LGOSSET-21/squash-ball-launcher-catia/docs/GM_39.pdf

Lanceur de Balles de Squash | GM BA2 2025

# Projet De Construction Mecanique II

## Section Génie Mécanique

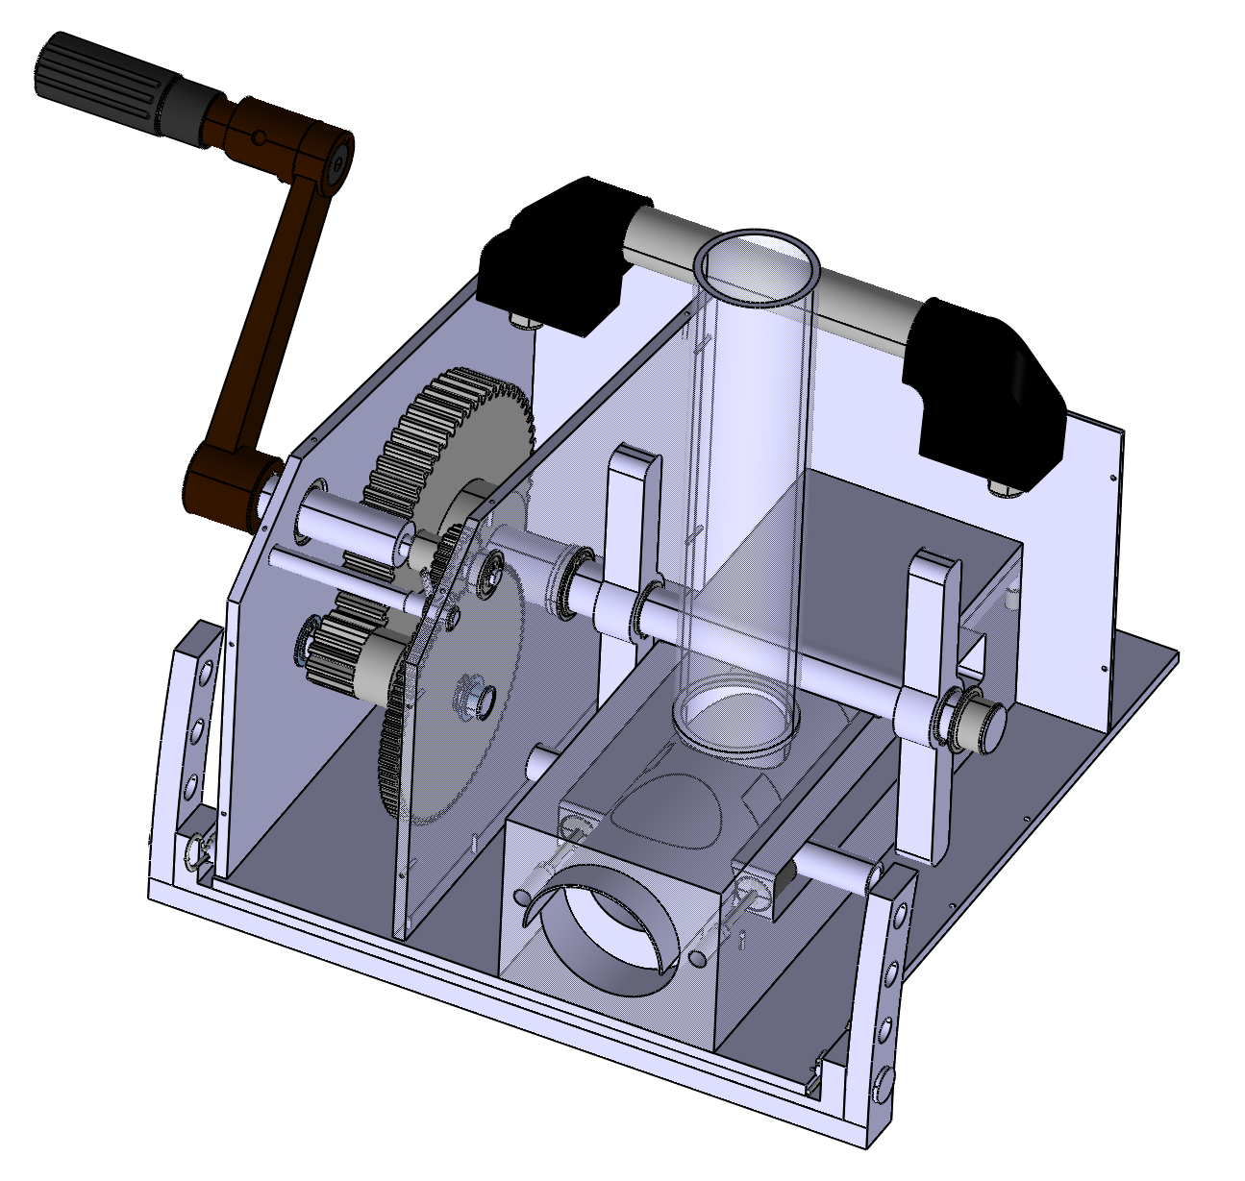
[picture p2: figure]

## Lanceur de Balles de Squash

Date de rendu : 01 Juin 2025

Groupe GM-89

Guillaume Saint-Pierre : 400422 ; | Joseph Belamich : 392444
Louis Gosset : 393503 ; | Ethan Poullain : 392134

### Table des matières

1 Introduction | 4
2 Physique du mécanisme et dimensionnement du mécanisme | 4
3 Puissances et Rendement | 28
4 Dimensionnement et résistance des éléments de liaisons | 30
5 Analyse des risques | 43
6 Usinage des pièces | 44

7 Procédures d’assemblage | 49
8 Mode d’emploi | 55
9 Conclusions | 59
10 Annexes | 61

### 1 Introduction

Lors du cours de construction mécanique du deuxième semestre de génie mécanique à l’EPFL, nous nous intéressons à la conception et à la réalisation d’un rapport d’ingénierie. Il s’agit ici de mettre en application les connaissances théoriques acquises lors de la première partie de ce cours ainsi que les compléments théoriques apportés tout au long du deuxième semestre.

Le projet consiste en la conception d’un lanceur de balles de squash. On y retrouve donc les aspects majeurs d’un rapport d’ingénierie tels que les idées de conceptions, les caractéristiques techniques et physiques, ainsi que les plans (2D et 3D).

### 2 Physique du mécanisme et dimensionnement du mécanisme

Dans cette section, nous détaillons les calculs relatifs à la puissance, au rendement énergétique, aux équations horaires du mouvement.

### 2.1 Système de lancement des balles

### 2.1.1 Calcul de l’énergie cinétique nécessaire pour lancer la balle de squash

Le but est de calculer l’énergie cinétique nécessaire pour propulser une balle de squash de 25 g (0,025 kg). En fonction des spécifications du cahier des charges, la balle doit être lancée à une vitesse comprise entre 80 et 130 km/h. Afin de prendre en compte les éventuelles pertes énergétiques dues aux frottements et au rendement des engrenages, nous choisissons un objectif de vitesse de lancement de 90 km/h, en conservant une marge de sécurité de 10 km/h.
Formule de l’énergie cinétique :

Ecin =

1
2

mv²

La masse totale est la somme de la masse de la balle (0,025 kg) et du support (0,104 kg). La vitesse de lancement de la balle est de 90 km/h, soit :

vlancement =

90 × 1000
3600

= 25 m · s

−1

Ecin =

1
2

× (mballe + msupport) × v

2
lancement =

1
2

× (0,025 + 0,104) × 25² = 40,3 J

### 2.1.2 Calcul du moment de force et du couple transmis par l’homme

Le dimensionnement du système de manivelle repose sur l’estimation réaliste de la force qu’un utilisateur peut exercer de manière répétée, sans fatigue excessive ni risque de blessure. Pour cela, nous nous appuyons sur des références normatives reconnues en ergonomie.
Ainsi, nous supposons que l’homme exerce une force de 20 N. Ce dernier tourne la manivelle de rayon r = 0,125 m. Le système de transmission doit permettre de lancer une balle toutes les 5 secondes. Cela correspond à une fréquence de rotation de 0,2 tour/s par balle pour garantir le lancement d’une balle à cette fréquence. Cependant, notre barre est usinée de manière à ce que le processus de lancement s’effectue 2 fois par tour. Ainsi, la fréquence de rotation est de 0,1 tour/s.
Le rapport de réduction Ri est défini par le rapport entre la vitesse de rotation de la manivelle et la vitesse de rotation de la came. Si la manivelle tourne à 2 tour/s et que la came doit tourner à 0,1 tour/s, le rapport de réduction est donc :

Ri =

Vcame

Vmanivelle

=

0,1 tours/sec
2 tours/sec =

1
20

Ce rapport de 1 :20 permet de garantir que la manivelle tourne suffisamment vite pour faire fonctionner la came à la vitesse souhaitée, tout en respectant les contraintes physiques du système.

Le moment de force initial Mi est donné par :

Mi = Fi × ri = 20 × 0,125 = 2,5 Nm

Ainsi, le rapport de réduction est :

Ri =

Mf
Mi

=

Vi
Vf

⇔ Mf =

Mi × Vi
Vf

=

2,5 × 2
0,1

= 50 Nm

Ainsi, le couple maximal transmis par le mécanisme de réduction est de 50 Nm.

### 2.1.3 Calcul de la constante du ressort nécessaire pour le lancement

Pour déterminer le ressort approprié pour le lancement de la balle de squash, il faut vérifier que le couple maximal (Mmax) que le ressort doit générer est compatible avec le couple maximal du système, soit :

Mmax ≤ Mf = 50 Nm

Pour déterminer le ressort approprié pour le lancement de la balle de squash, il faut vérifier que le couple maximal (Mmax) que le ressort doit générer est compatible avec le couple maximal du système, soit :

Mmax ≤ Mf = 50 Nm

L’énergie stockée dans un ressort est donnée par la formule :

Eressort =

1
2

k(∆x)

2

La longueur de compression du ressort est un paramètre clé dans la conception du mécanisme de lancement de la balle de squash. Après avoir pris en compte les exigences de performance et les contraintes de conception, nous avons estimé que la longueur de compression optimale pour notre ressort idéal serait ∆x = 11,5 cm. Cette valeur a été choisie en fonction de plusieurs critères techniques, notamment l’énergie nécessaire pour propulser la balle à la vitesse souhaitée (90 km/h), ainsi que les contraintes de compacité et de performance du mécanisme.

Critères de performance :

La compression du ressort doit donc être suffisante pour emmagasiner l’énergie nécessaire pour atteindre cette vitesse, tout en prenant en compte les pertes possibles dues aux frottements et à l’efficacité du système de transmission.
Une compression trop faible du ressort risquerait de produire une énergie insuffisante pour propulser la balle à la vitesse ciblé, tandis qu’une compression trop importante pourrait entraîner une surcharge du système, affectant la compacité du mécanisme.

Constante de raideur du ressort :

La longueur de compression est directement liée à la constante de raideur du ressort k. Une compression de 12 cm permet d’obtenir une force de réaction du ressort suffisante pour générer une énergie nécessaire au lancement de la balle tout en maintenant une constante de raideur qui n’est pas trop élevée. En effet, une constante de raideur trop élevée entraînerait une difficulté à comprimer le ressort, augmentant la force nécessaire à l’activation du système. Il est important de se rappeler que le rayon de notre barre permettant l’envoi des balles est de 0,07 m.

F = ∆x × k

M = F × rbarre = ∆x × k × rbarre | ⇔ | kmax =

Mmax

rbarre × ∆x

=

50
0,07 × 0,115

= 6211 Nm

On en déduit également la force max :

Fmax = kmax × ∆x = 714 N

### 2.1.4 Vérification de l’adéquation du ressort sélectionné

diamètre du fil | diamètre ressort externe | diamètre ressort interne | longueur libre | longueur sous charge max | ∆xmax | Force max du ressort | constante d’élasticité k
5,00 | 55,00 | 45,00 | 195,00 | 61,60 | 133,40 | 784,53 | 5980

Table 1 – Caractéristiques du ressort choisi

Constante d’élasticité k :

Le ressort sélectionné présente une constante d’élasticité de :

k = 5980 N · m⁻¹

Cette valeur est inférieure à la limite maximale admissible précédemment déterminée, soit :

k = 5980 N · m⁻¹ < kmax = 6211 Nm

Cette constante respecte donc les contraintes de couple maximal admissible.

Allongement du ressort ∆x :

La compression maximale considérée pour le ressort est :

∆x = 133,40 mm

Cette valeur est supérieure à la compression souhaitée de 115 mm :

∆xmax = 133,40 mm > ∆x = 115 mm

### 2.1.5 Force maximale exercée par le ressort :

La force maximale développée par le ressort est donnée par la loi de Hooke :

F = k × ∆x = 5980 × 0,115 = 687,7 N

Cette force reste inférieure à la force maximale admissible dans le système :

Fressort = 687,7 N < Fmax = 714 N

De plus, on vérifie que très logiquement cette force est inférieure à la force max du ressort :

Fressort = 687,7 N < Fressort max = 784,53 N

### 2.1.6 Énergie potentielle stockée dans le ressort :

L’énergie emmagasinée dans le ressort lorsqu’il est comprimé :

Eressort =

1
2

k∆x

2 =

1
2

× 5980 × 0,115² = 40,9 J

Or on rappelle que l’énergie cinétique nécessaire pour propulser une balle et son support est :

Ecin = 40,3 J

On a donc :

Ecin ≈ Eressort

Ainsi, l’énergie potentielle fournie par le ressort est suffisante pour assurer le lancement de la balle à 90 km/h.

### 2.1.7 Couple final transmis par le ressort :

Le couple nécessaire pour comprimer le ressort peut être estimé par :

Mf = F × r = 687,7 × 0,070 = 48,13 N · m⁻¹ < 50 Nm

L’ensemble des calculs et hypothèses respecte les contraintes de compacité, d’ergonomie et de cadence de tir (une balle toutes les 5 secondes), assurant ainsi un fonctionnement fiable, sécuritaire et performant du dispositif. De plus les 1,87 N.m-1 de marge ne sont pas perdus car cela permet de laisser le ressort suffisamment en compression afin qu’il tienne avec une gorge ( ce système sera expliqué par la suite). Le ressort choisi peut donc être retenu pour l’implémentation finale dans le système de lancement.

### 2.2 Système de stockage des balles et acheminement des balles

### 2.2.1 Explication du système

Les balles sont stockées dans un tube conçu pour accueillir exactement 5 balles. Ce tube donne sur le haut de la plaque du ressort. Sur cette plaque se trouve un trou qui se positionne en dessous du tube lorsque le ressort ce compresse, laissant donc passé une balle.
Nous allons donc prouver que la balle à bien le temps de tomber et que seulement une balle va tomber. Aussi, on verra que lors de la décompression du ressort, les balles contenue dans le tube ne gêne pas l’avancer du ressort.

### 2.2.2 Chute de la balle dans le conduit :

Nous allons prouver à l’aide d’une étude balistique que la balle a bien le temps de tomber. Pour montrer que cela marche bien dans tous les cas, on prendra le cas le plus désavantageux c’est à dire là où il n’y a qu’une seule balle dans le tuyau (car les autres ne la pousse pas vers le bas).
Pour cela nous allons comparer la vitesse de compression du ressort avec celle de la chute des balles dans le trou. Trouvons donc la vitesse de la compression du ressort au niveau de trou qui laisse passer les balles. La vitesse étant la dérivé de la position, trouvons d’abord la position. Plus tard nous détaillerons les calcul mais la fonction qui décrit la compression ∆x du ressort en fonction du temps est donné par :

∆x(t) = ∆xtotal
2

− h × tan

π
2

−

2π
10

t

Donc :

t(∆x) =

π
2

− arctan

∆xtotal
2

−∆x

h

π
5
Or :
v∆x(t) = d∆x(t)
dt :

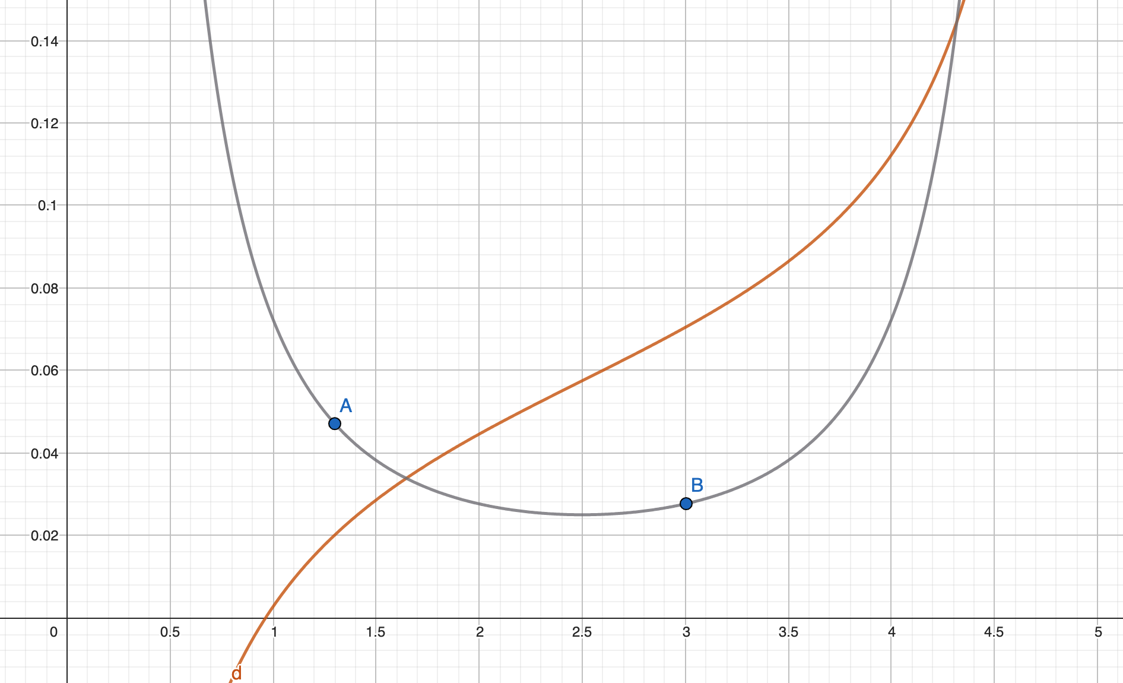
[picture p3: figure]

Figure 1 – Courbe de ∆x(t) en orange et la vitesse v∆x(t) en gris, les point A et B sont les point entre lesquels le trou passe en dessous du tube.

Comme la vitesse de compression du ressort varie peu entre 1 et 4 seconde (temps de compression) nous allons prendre la vitesse moyenne, ainsi :

vmoy ∆x =

1
t2 − t1

×

Z t2

t1

v∆x(t) dt =

1
t2 − t1

×

Z t2

t1

d∆x(t)
dt dt =

1
t2 − t1

× [∆x(t2) − ∆x(t1)]

l’instant t1 est le temps auquel le trou de la plaque rencontre le trou du tube et l’instant t2 est le temps où ils se quittent.
D’après la longueur des pièces ∆x(t1) = 3, 0cm et ∆x(t2) = 7, 0cm (intervalle de longueur de la compression du ressort sur lequel le trou passe en dessous du tube) donc grâce a la fonction inverse t(∆x) on trouve :

t1 = 1, 54s

t2 = 3, 0s

Ainsi, la vitesse moyenne est de :

vmoy ∆x =

1
t2 − t1

× [∆x(t2) − ∆x(t1)] = 1 3, 0 − 1, 54
×

h
7, 0 × 10⁻² − 3, 0 × 10⁻²

i
= 2, 7 × 10⁻²m/s

Donc à 1, 54s le trou commence à passé en dessous du tube. Comme le tube à un diamètre de 41, 5mm on considère que la balle ne bouge pas tant que le trou n’arrive pas à la moitié de son diamètre c’est à dire 20, 75mm de plus. À partir de ce moment la, la balle commence à descendre doucement sans tomber.

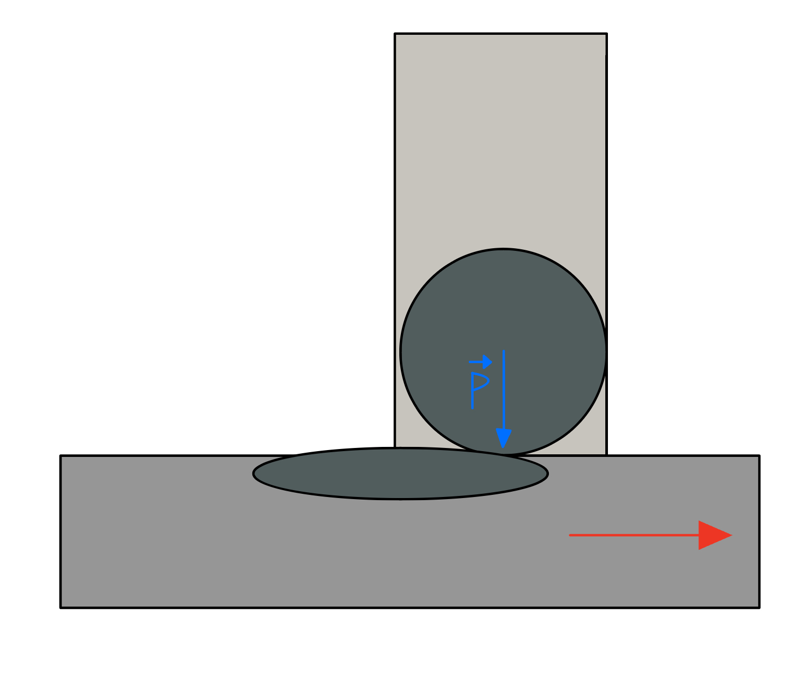
[picture p4: figure]
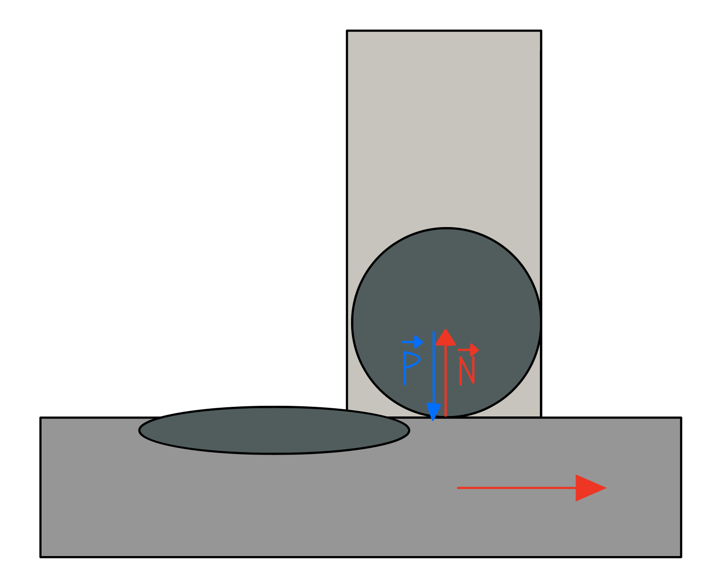
[picture p5: figure]

La balle ne bouge pas | La balle commence à descendre

Lorsque la balle commence à s’aligner avec le trou, elle descend progressivement au fur et à mesure que le trou avance sous elle. Toutefois, tant que moins de 40mm du trou ne sont positionnés sous le tube, la balle ne peut pas tomber complètement, car son diamètre est encore trop grand pour passer.
Juste avant que le seuil des 40mm ne soit atteint, la balle se retrouve dans une position basse maximale, bloquée par la paroi du trou : elle est descendue d’environ 20mm, mais reste coincée. Elle est donc à la limite de basculer, sans pouvoir chuter à cause de l’insuffisance d’ouverture. Ce n’est que lorsque au moins 40mm du trou sont alignés avec le tube qu’elle peut enfin passer librement et tomber. On va donc considéré par mesure de sécurité qu’avant de chuter, la balle est seulement descendu de 15mm. La balle doit donc chuter de 40 − 15 = 25mm.
Vérifions ainsi que la balle à bien le temps de chuter avant que le trou ne se referme. Faisons une étude balistique de la chute de la balle et de l’avancé du trou. 0n place un repère Oxy centré au bas du tube, y pointe vers le haut et x vers la droite. À l’origine des temps, la balle est descendu de 15mm et n’a pas de vitesse initiale, et 40mm du trou de la plaque est en dessous du tube. Commençons par la chute de la balle :
| XF = ma
| mg = ma
| Donc g = a

On intègre une première fois l’accélération pour obtenir l’équation vitesse en tenant compte des conditions initiales :

v(t) = v0 +

Z
| a(t) dt

Or :

| vy(t = 0) = v0y = 0m/s

On intègre une seconde fois l’équation de la vitesse pour obtenir l’équation horaire de position, en tenant compte des conditions initiales.
r(t) = r0 +

Z
| v(t) dt

Selon l’axe y :
y(t) = Z
vy(t) dt = −

1
2
- g · t

2 + y0

Or :
y(t = 0) = y0 = 0

Ainsi :
y(t) = −

1
2
- g · t

2

Or on cherche t tel que y(t) = −0, 025m (temps pour que la balle chute totalement), soit :

y(t) = −0, 025 | ⇔ | −

1
2
- g · t
2 = −0, 025 | ⇔ | t =

s
2 × 0, 025
g

=

s
2 × 0, 025
9, 81

= 71ms

La position du trou est (car vitesse constante) :

x(t) = vtrout + x0

x0 = −0, 002mm

Donc le temps pour que le trou parcours 2mm (distance sur laquelle plus de 40mm du trou de la plaque est en dessous de la plaque) est :

t =

−x0

vtrou

=

0, 002
2, 7 × 10⁻²

= 74ms

74 > 71

La balle à donc bien le temps de tomber entièrement dans le trou.

### 2.2.3 Passage de seulement une balle :

Puisque l’emplacement devant le ressort a une hauteur de 41 mm, cela permet à exactement une seule balle de s’y loger. Les autres balles, quant à elles, ne peuvent pas y entrer et seront donc déviées ou séparées par la plaque.

### 2.2.4 Retour du ressort :

Vérifions que les balles ne gêne pas la décompression du ressort. Le risque est qu’une balle tombe dans le trou lorsque le ressort ce décomprime. Montrons que le temps de chute d’une balle est beaucoup trop petit par rapport au temps de passage du ressort lorsqu’il se décomprime. Prenons encore une fois le pire des cas : lorsque le maximum de balle sont dans le tube est donc "pousse" la dernière à tomber. Dans cette configuration il y a au maximum 4 balles dans le tube car la dernière est dans le mécanisme. Étudions tout d’abord la vitesse du ressort :

XF = ma

Fressort = ma
−k(x − Lo) = ma

a = −

k
m

(x − Lo)

On pose e = x − Lo, donc d

2e
dt² = a, Ainsi :

d

2
e
dt²

= −

k
m
- e | ⇔ | e = C1cos(

s
k
m
t) + C2sin(

s
k
m

t)

Trouvons C1 et C2, on sait que de dt(0) = 0 car la vitesse initiale du ressort avant de ce décomprimer est nulle, donc :

de
dt = 0 ⇔ −C1sin(

s
k
m

× 0)s
k
m

+ C2cos(

s
k
m

× 0)s
k
m

= 0 ⇔ C2 = 0

Aussi, e(0) = −11, 5 × 10⁻²m (compression max du ressort), donc :

C1cos(

s
k
m

× 0) + C2sin(

s
k
m
× 0) = −11, 5 × 10⁻² | ⇔ | C1 = −11, 5 × 10⁻²

Ainsi :

e(t) = −11, 5 × 10⁻²
cos(

s
k
m
t) ⇔

de
dt(t) = 11, 5 × 10⁻²
sin(

s
k
m

t)

s
k
m
Nous venons d’exprimer la position et la vitesse du ressort en fonction de t. Trouvons donc la vitesse du ressort lorsque le trou de la plaque passe en dessous du tube. Pour cela calculons la vitesse en fonction de la position :

e(t) = −11, 5 × 10⁻²
cos(

s
k
m
t) | ⇔ | t =

rm
k

arcos(−

e
11, 5 × 10⁻²

)

Ainsi pour e = −5cm (le ∆xd du ressort lorsque le trou rencontre le milieu du tube) :

t =

rm
k

arcos(−

e
11, 5 × 10⁻²

) = s
129 × 10⁻³
5980

arcos(−

−5 × 10⁻²
11, 5 × 10⁻²

) = 5, 2ms

Enfin :

de
dt(t = 5, 7 × 10⁻³

) = 11, 5 × 10⁻²
sin(

s
5980
129 × 10⁻³

5, 2 × 10⁻³
)

s
5980
129 × 10⁻³

= 22m/s

En approximant la postion du ressort par :

x(t) = v × t

Le temps passé par le tube sous le tube est :

t =

x
v

=

42 × 10⁻³
23

= 1, 8ms

La balle a donc 1, 8ms pour tomber et gêner le mécanisme, or la position de la balle en fonction du temps est donné par :

y(t) = −

1
2
- g · t

2

Donc en 1, 8ms la balle descend de :

y(t) = −

1
2
- g · t

2 = −

1
2
- 9, 81 · 0, 0018² = −2 × 10⁻⁵m = −16µm

La balle descend seulement de 16µm lorsque le ressort reviens, cette distance est donc bien trop faible pour gêner le retour du ressort et le lancement de la balle.

Conclusion

In fine, le système a balle est totalement viable car la balle a bien le temps de tomber devant le ressort lors de sa compression. Aussi, les balles n’ont pas le temps de tomber et de gêner le mécanisme lors du retour du ressort.

### 2.3 Système d’engrenages

### 2.3.1 Dimensionnement des roues dentées

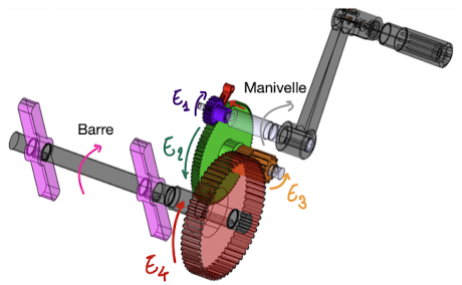
[picture p6: figure]

Figure 2 – Schéma du système d’engrenages

La détermination des dimensions des roues dentées repose sur une analyse rigoureuse des puissances transmises au sein du système, permettant ensuite le calcul des forces correspondantes.
On rappelle qu’on cherche ici à arriver à un rapport de réduction de itotal = 1 : 20. Or ce rapport est trop grand pour être obtenu par un unique couple d’engrenage (1 :8 max). Pour ne pas dépasser ce rapport, tout en minimisant le nombre d’engrenages, nous décidons d’utiliser 4 engrenages dont deux ont ensemble un rapport de transmission i1 = 1 : 4, et les deux autres i2 = 1 : 5, de tel sorte que :

i1 · i2 = itotal

Dans un premier temps, nous allons justifier avec grand précisions les calculs pour le 4ème engrenage, afin d’expliquer précisément notre démarche.
Sachant que les barres et la quatrième roue dentée sont directement liés par un arbre de transmission, nous savons que les vitesses de rotation sont égales. On en déduit donc :
PBarre = PE4 | ⇒ | MBarre × WB = ME4 × WT | ⇒ | MBarre = ME4 | ⇒ | MBarre = FT3/4 × RE4

Ainsi on en déduit notre force tangentielle :

FT =

MBarre

| | | RE4
Le choix de la taille de notre dernier engrenage est arbitraire. Cependant, en sachant que nous avons besoin d’augmenter notre moment de force à l’arrivée, nous devons choisir une roue relativement grande. Prenons ainsi RE4 = 60 mm.

FT3/4 =

MBarre

RE4

=

50
60 · 10⁻³

≈ 850 N

On connaît désormais notre force tangentielle, et on veut déterminer notre module nécessaire. Pour cela, nous devons en amont choisir en justifiant un matériau pour les engrenages. En effet, nous devons allier deux paramètres capitaux, le poids et la résistance. Pour cela nous cherchons un matériau dont le rapport entre la masse volumique et la résistance en traction est le plus faible possible. Analysons donc les différentes options dont nous disposons :

Ainsi l’aluminium et l’acier semblent tous deux être de bon choix Afin de faciliter les recherches d’engrenages nous avons choisis de prendre l’acier car plus commun.

Matériaux | Résistance pratique en traction σpe (N/mm² ) | Masse volumique ρ (kg/m³ ) | Rapport : ρ σpe
PA6-6 (Polyamide 6-6) Aluminium Acier (20NCD2) Bronze | 30 90 250 125 | 1150 2700 7750 8500 | 38,3 30 31 68

Table 2 – Comparatif des matériaux pour engrenages

Passons au calcul du module en notant que k est une valeur fixée par le fournisseur. Dans notre cas, pour ce genre d’engrenage k = 10 Nm.

mmin = 2,34 ·

s
FT
k · Rpe

⇒ mmin = 2,34 ·

r
850
10 · 250

= 1,6 mm

Ainsi, afin de prendre un engrenage normalisé, on choisit :

m2 = 2 mm

Il est ainsi possible d’évaluer la contrainte maximale exercée par cette force de traction :

σMax = 5,47 ·

FT
m² × k
= 5,47 · | 850
2
| 2 × 4 ≈ 130 MPa ≪ Rpe = 250 MPa

Finalement, on en conclut que les mesures de sécurité prises sont suffisantes.
Pour les autres engrenages, il suffit de répéter ce que nous avons fait pour l’engrenage 4. Nous serons donc plus concis :

— Roue dentée 1 : ME1 = Fhumaine × RManivelle = 20 × 0,125 = 2,5 N · m
— Roue dentée 2 : FT1/2 =

ME1
RE1

=

2,5
12,5·10⁻³ = 200 N

⇒ ME2 = FT1/2 × R2 = 200 × 50 · 10⁻³ = 10 N · m

Calculons le module :

m1min ≥ 2,34s
FT1/2

k1 · Rpe

≥ 2,34s
200
6,4 · 250 | ⇒ m1min = 0,98 mm ⇒ m1 = 1,25 mm (par sécurité)

— Roue dentée 3 : ME3 = FT3/4 × R3 = 850 × 12 · 10⁻³ = 10 N · m On retrouve bien :

i1 =

ME1

ME2

=

2,5
10

= 1 : 4 et également i2 =

ME3

ME4

=

10
50

= 1 : 5

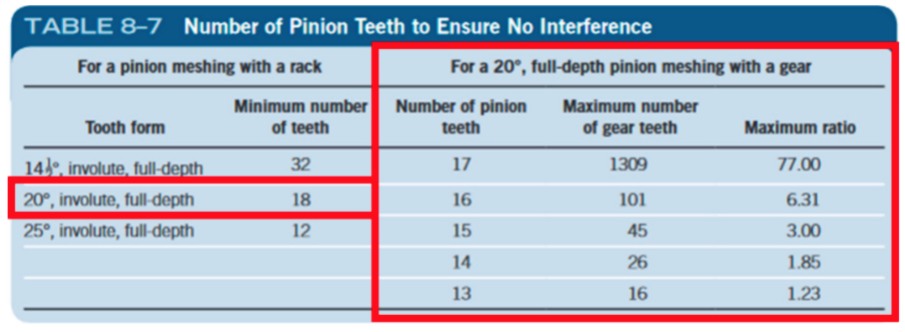
[picture p7: figure]

Figure 3 – Tableau représentant le nombre de dents à utiliser pour éviter toute interférence.

### 2.3.2 Caractéristiques générales des roues dentées

Les engrenages viennent tous d’Engrenages HPC, fournisseur de composants mécaniques et de matériels de transmission depuis 1981.

Roues dentées | Diamètre primitif | Module | Largeur (et k, fixé par le fournisseur) | Nombre de dents | Moments | Masse
1 | dE1 = 25 mm | m1 = 1,25 mm | k1 = 6,4 | ZE1 = 20 | ME1 = 2,5 N · m | 39 g
2 | dE2 = 100 mm | m1 = 1,25 mm | b1 = k1 · m1 = 8 mm | ZE2 = 80 | ME2 = 10 N · m | 534 g
3 | dE3 = 24 mm | m2 = 2 mm | k2 = 10 | ZE3 = 12 | ME3 = 10 N · m | 110 g
4 | dE4 = 120 mm | m2 = 2 mm | b2 = k2 · m2 = 20 mm | ZE4 = 60 | ME4 = 50 N · m | 1872 g

Table 3 – Caractéristiques géométriques et mécaniques des roues dentées du système

On observe que ces engrenages respectent les rapports de transmissions nécessaires Il est important de noter que ces engrenages sont en acier (20NCD2), cela afin d’assurer une bonne résistance. Notons également ces caractéristiques :
— Classe de précision 9
— Angle de pression 20°
— Vitesse linéaire 300 m/min

### 2.3.3 Dimensionnement du mécanisme

Deux dimensions sont capitales pour le dimensionnement et la modélisation de notre mécanisme : l’entraxe qui permet de savoir où placer les arbres, et la longueur totale (ou encombrement horizontal) qui nous donne une idée précise de la taille prise par notre système d’engrenages.
Commençons par calculer l’entraxe entre les roues dentées 1 et 2 (E1−2), et entre les roues 3 et 4 (E3−4).
On connaît la formule générale :

Ei−j =

di + dj
2
On en déduit :

Entraxe 1 : E1−2 =

dE1 + dE2
2

=

25 + 100
2

= 62,5 mm

Entraxe 2 : E3−4 =

dE3 + dE4
2

=

24 + 120
2

= 74 mm

On peut également calculer la longueur totale. Pour cela on aura besoin du diamètre extérieur. Pour une roue droite, on a :
dext = m(Z + 2)

On en déduit ce que l’on trouve sur la fiche du fournisseur :
— Diamètre extérieur 1 : dext1 = m(Z1 + 2) = 27,5 mm
— Diamètre extérieur 2 : dext2 = m(Z2 + 2) = 102,5 mm
— Diamètre extérieur 3 : dext2 = m(Z3 + 2) = 28 mm
— Diamètre extérieur 4 : dext2 = m(Z4 + 2) = 124 mm

### 2.4 Système d’amortissement du ressort

Le but est de limiter les oscillations du ressort une fois que la balle a été lancée. En effet, il faut immobiliser le ressort à sa longueur initiale rapidement pour que le système puisse bien enchaîner les différentes actions.
On modélise le système comme un oscillateur harmonique amorti :

mx¨ + cx˙ + kx = 0

Avec c, qui correspond au coefficient d’amortissement effectif (via les butées en caoutchouc).

Le comportement du système dépend du rapport d’amortissement ζ :

ζ =

c
2

√
km

Pour que le ressort n’oscille plus, il faut que x(t) ≈ 0.

Avec amortissement :

Le caoutchouc est reconnu pour sa capacité à dissiper l’énergie mécanique, ce qui en fait un excellent matériau pour l’amortissement des vibrations. Cette capacité est souvent quantifiée par le facteur de perte η, qui représente la proportion d’énergie dissipée par rapport à l’énergie stockée dans le matériau lors d’un cycle de déformation. La norme ISO 4651 :1988 décrit une méthode pour déterminer la capacité d’amortissement dynamique des caoutchoucs et plastiques alvéolaires, mais elle ne fournit pas de tableau reliant directement ζ à la surface de contact.
Pour un système amorti, la solution générale est :

x(t) = e

−ζω0t
- [A cos(ω1t) + B sin(ω1t)]

On considère que les oscillations deviennent négligeables lorsque x(t) est inférieur à un certain seuil, par exemple 1% de l’amplitude initiale x0. On résout alors :

x(t) = e

−ζω0t
- [A cos(ω1t) + B sin(ω1t)] = 0.01x0

avec :

ω0 =

s
k
m

et ω1 = ω0

q
1 − ζ

2

Conditions initiales :
— x(0) = x0 : compression initiale du ressort — v0 = ˙x(0) = 0 : vitesse initiale nulle

Calcul de A : À t = 0, on a :

x(0) = e

0
[A · cos(0) + B · sin(0)] = A ⇒ A = x0

Calcul de B :
x˙(t) = d
dt
e

−ζω0t

[A cos(ω1t) + B sin(ω1t)]

x˙(t) = e

−ζω0t
[−ζω0(A cos(ω1t) + B sin(ω1t)) + (−Aω1 sin(ω1t) + Bω1 cos(ω1t))]

Donc :
x˙(0) = −ζω0A + ω1B

Or x˙(0) = 0, donc :

0 = −ζω0x0 + ω1B ⇒ B =

ζω0x0
ω1
Ainsi : A = x0 | et | B =

ζω0x0
ω1

Calculons ζ :
c = 2η

√
km, | où η = 0.1 pour le caoutchouc naturel
| | c = 2 × 0.1 ×

√
5980 × 0.75 ≈ 4.89 kg · s

−1

| | ω0 =

s
k
m

= ω0 =

s
5980
0, 16

≈ 193rad/s

Période d’oscillation :
T0 =

2π
ω0

≈ 0.0257 s

Le système atteint 1% de l’amplitude initiale (≈ 1.334 mm) après environ 20.3 ms.

Sans amortissement (air seulement) :

mx¨ + cairx˙ + kx = 0

Lorsque l’on prend en compte les frottements de l’air dans le système, on modélise l’amortissement comme un amortissement visqueux simple, avec une force proportionnelle à la vitesse. Le modèle devient alors un oscillateur harmonique amorti léger.
Pour une petite plaque et une balle de squash, un ordre de grandeur réaliste du coefficient d’amortissement de l’air est :
cair ≈ 0.1 kg · s

−1

A(t) = x0e

−ζω0t ⇒

A(t)
x0

= 0.01 ⇒ e

−ζω0t = 0.01 ⇒ t =

ln(0.01)
−ζω0

=

4.6052
0.499

≈ 9.23 secondes

Conclusion : Avec les frottements de l’air, le système met environ 9,23 secondes pour que l’amplitude soit réduite à 1% de sa valeur initiale. Ce résultat montre l’impact relativement faible du seul amortissement visqueux de l’air. Il est donc essentiel d’ajouter un amortissement plus efficace, comme un caoutchouc, pour réduire ce temps d’extinction et stopper rapidement les oscillations.

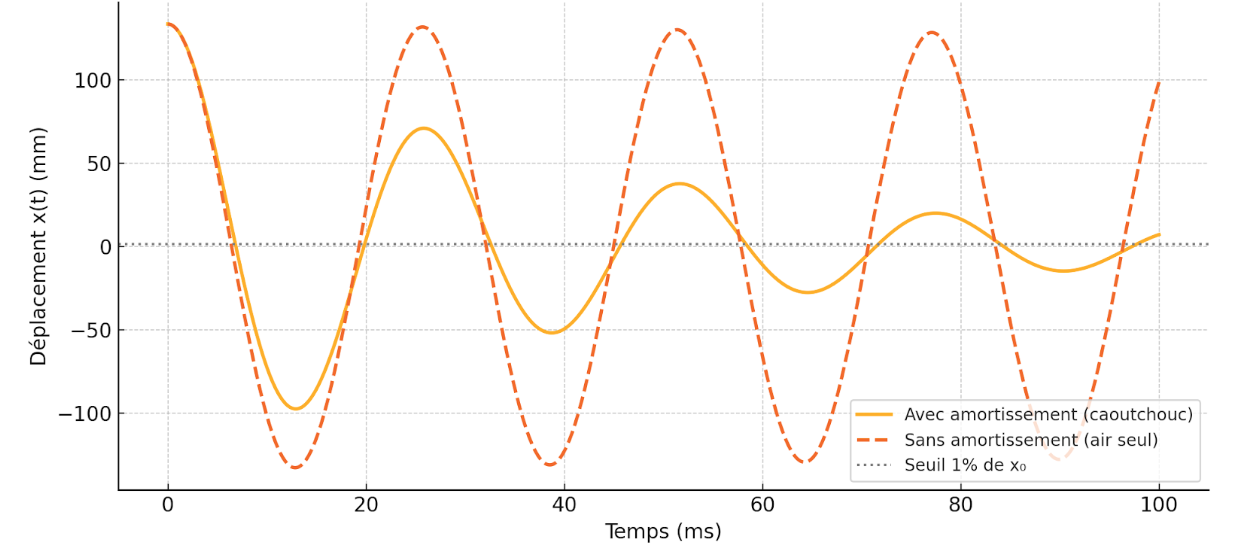
[picture p8: figure]

Figure 4 – Courbe de comparaison du comportement du ressort avec et sans amortissement

### 2.5 Système de compression du ressort

Le but de cette partie est de calculer le moment nécessaire pour faire avancer la barre qui compresse le ressort. On modélise le système de la barre comme ceci :
— FN : la force normale entre la barre et la sphère
— Fr : la force du ressort
— Ax et Ay : les forces de support
— Mo : le moment en O
— θ : l’angle entre la position initiale de la barre (horizontale) et la position à l’instant t — α : l’angle entre FN et le plan horizontal
— l : la longueur entre le point O et la force FN
— h : la longueur entre O et la glissière

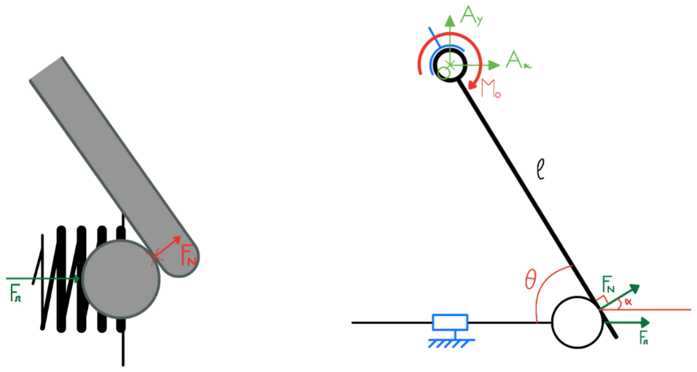
[picture p9: figure]
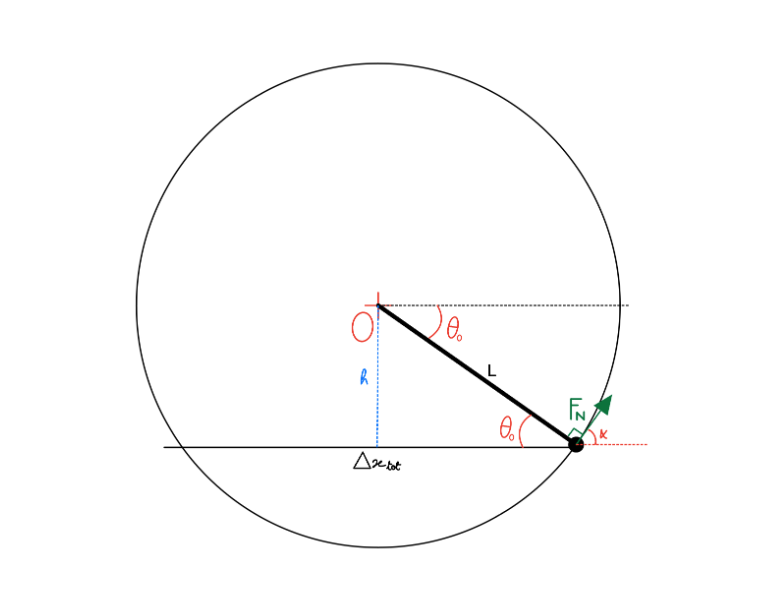
[picture p10: figure]

Figure 5 – Dessin explicatif du système

L = 7 cm et ∆xtotal = 11,5 cm donc l’angle initial est de θ0 = arccos

∆xtotal
2 × L

= arccos

11,5
2 × 7
≈

π
5

et
h = sin(θ0) × L = sin

π
5
× 7 = 4 cm

Étudions la barre comme un système rigide soumis à deux forces de support au point O, Ax et Ay orientées respectivement selon l’axe Ox et l’axe Oy.
Aussi, le ressort a une force Fr = k∆x dirigée selon Ox, ce qui se traduit sur la barre par une force normale FN , toujours perpendiculaire à la barre, liée au contact de la barre avec les sphères. Durant l’étude des forces, on négligera la force de frottement lié à la glissière car les deux matériaux en contact étant en du pomh et du PE-UHMW le coefficient de frottement est de :
µ ≈ 0,15

ce qui est très faible.

Effectuons un bilan des forces seulement sur la glissière pour calculer Fr :

ΣFx = ma = Fr + FN

On considère la vitesse de notre système comme constante, donc a = 0, d’où :

Fr + FN = 0

⇔ | FN cos(α) = −Fr | ⇔ | FN =

−Fr
cos(α)

La réaction normale de la boule sur la barre étant l’inverse de celle de la barre sur la boule, on a :

| FN = | Fr
cos(α)

Nous pouvons maintenant calculer le moment au point O nécessaire pour faire bouger la barre. D’après le théorème du centre de masse :

| XMOz = I dω
dt = −MO + l(θ) × FN

Or, la vitesse de la barre étant constante : dω
| dt = 0

−MO + l(θ) × FN = 0

⇔ MO = l(θ) × FN =

l(θ) × Fr
cos(α)

=

l(θ) × k∆x
cos(α)

Calculons ∆x en fonction de θ. Sur la figure on a :

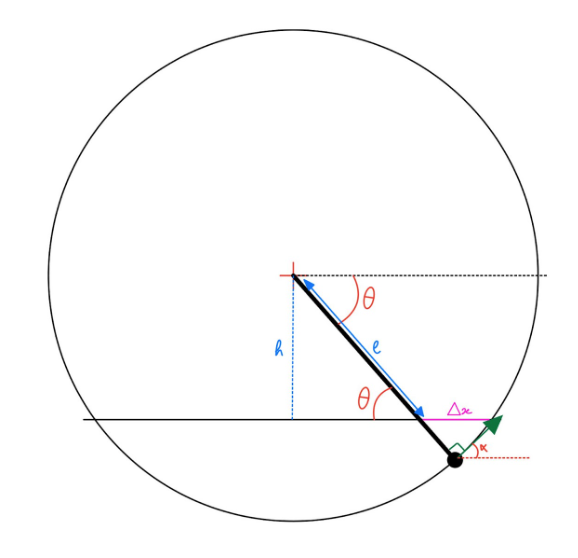
[picture p11: figure]

Figure 6 – Dessin de l’avancement du système

∆x1 =

∆xtotal
2

− h × tan

π
2

− θ

pour

π
5

≤ θ ≤

π
2

rad

∆x2 =

∆xtotal
2

+ h × tan
θ −

π
2
pour

π
2

< θ ≤

3π
5

rad

Nous devons maintenant déterminer α et θ qui sont fonction du temps. Pour θ, comme la barre effectue un tour complet en 10 secondes, alors avec une règle de trois :

θ =

2π
10

t [rad/s]

Et

α1 =

π
2

− θ =

π
2

−

2π
10

t pour

π
5

≤ θ ≤

π
2

[rad] ⇒ donc pour 1 ≤ t ≤ 2,5 [sec]

α2 = θ −

π
=

2π
t −

π
pour

π
< θ ≤

3π
[rad] ⇒ donc pour 2,5 < t ≤ 4 [sec]

Ainsi, en remplaçant α et θ par leur fonction du temps, on obtient :

M0,1 = k × h ×

∆xtotal

2 − h tan
π
2 −

2π
10 t

sin
2π
10 t

cos
π
2 −

2π
10 t

= k × h ×

∆xtotal

2 − h tan
π
2 −

2π
10 t

sin²

2π
10 t
| pour 1 ≤ t ≤ 2,5 [sec]

M0,2 = k × h ×

∆xtotal

2 + h tan
2π
10 t −

π
2

sin
2π
10 t

cos
2π
10 t −

π
2

= k × h ×

∆xtotal

2 − h tan
π
2 −

2π
10 t

sin²

2π
10 t
| pour 2,5 < t ≤ 4 [sec]

Au final on a juste :

M0 = k × h ×

∆xtotal

2 − h tan
π
2 −

2π
10 t

sin²

2π
10 t
| pour 1 ≤ t ≤ 4 [sec]

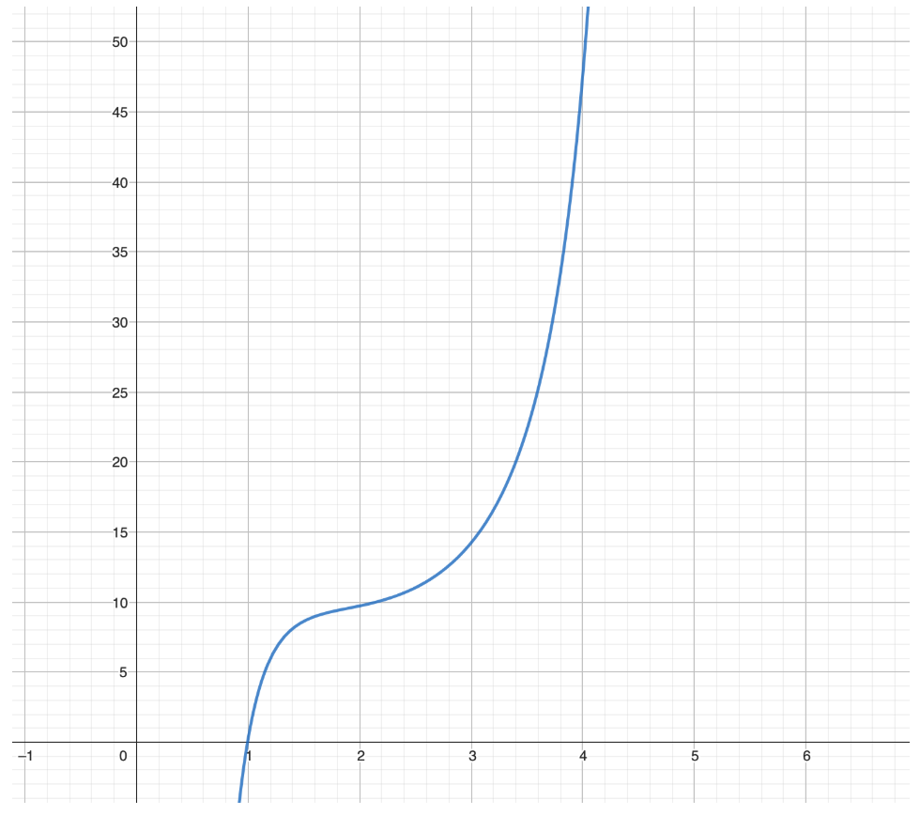
[picture p12: figure]

Figure 7 – Courbe du moment au point O en fonction du temps.

On a donc que par analyse graphique, M0(4) ≈ 48 Nm, cette valeur est en dessous du moment que l’on peut avoir grâce aux engrenages (50 Nm). On peut donc faire reculer le ressort sans problème.

Calculons maintenant les forces internes dans la barre afin de justifier son matériau. Pour cela nous allons utiliser les cours de Structure Mécanique. Rappelons que la barre est attachée au point O à un pin et est soumise à une force perpendiculaire à la barre comme ceci :

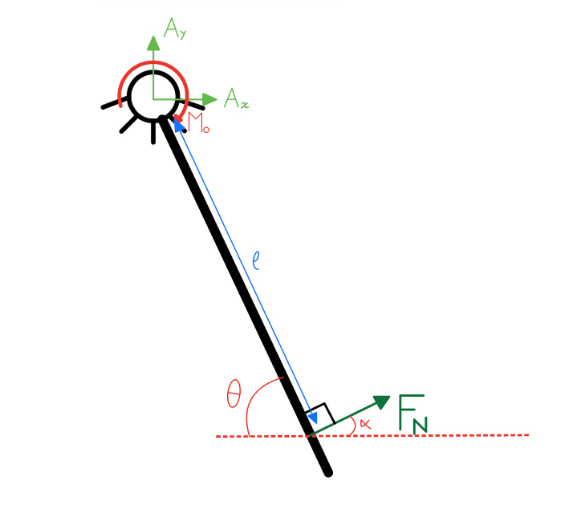
[picture p13: figure]

Figure 8 – Dessin du système

Commençons par calculer les forces de support au niveau du pin Ax et Ay par un bilan des forces :

XFx = FN cos(α) + Ax = 0 | ⇔ | Ax = −FN cos(α) = −

Fr
cos(α)

cos(α) = −Fr

XFy = FN sin(α) + Ay = 0 | ⇔ | Ay = −FN sin(α) = −

Fr
cos(α)

sin(α) = −Fr tan(α) = −Fr
tan(θ)

(α =

π
2

− θ)

Nous pouvons maintenant couper la barre avant FN donc pour 0 ≤ x ≤ l(θ) et 0 ≤ θ ≤

π
2

rad pour avoir
α =

π
2 − θ :

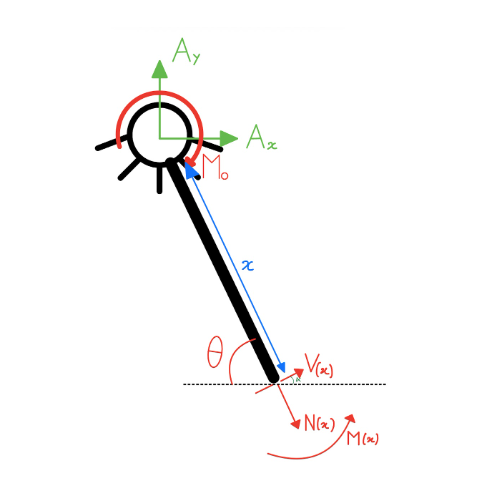
[picture p14: figure]

Figure 9 – Dessin du système

Toujours avec un bilan des forces :

XF⃗

V = V (x)+Ax sin(θ)+Ay cos(θ) = 0 | ⇔ | V (x) = Fr sin(θ)+ Fr
tan(θ)

cos(θ) = Fr

sin(θ) + cos²
(θ)
sin(θ)

!
=

Fr
sin(θ)
XF⃗N = N(x) + Ax cos(θ) − Ay sin(θ) = 0 | ⇔ | N(x) = Fr cos(θ) −

Fr
tan(θ)

sin(θ) = Fr (cos(θ) − cos(θ)) = 0

On a donc V (x) = Fr
sin(θ)

et N(x) = 0, ce qui est parfaitement cohérent.

Pour l(θ) ≤ x ≤ L et toujours pour π 5 ≤ θ ≤

π
2

rad, on a :

XF⃗
V = V (x) + Ax sin(θ) + Ay cos(θ) + FN = 0 | ⇔ | V (x) = −

Fr
sin(θ)

−

Fr
cos(α)

= 0

XF⃗N = N(x) + Ax cos(θ) − Ay sin(θ) = 0 | ⇔ | N(x) = 0

Donc il n’y a plus aucune contrainte dans la barre après la force normale FN : N(x) = V (x) = 0 De manière analogue, on montre que les résultats sont exactement les mêmes pour π
2 ≤ θ ≤

3π
5

rad. Ainsi,
pour un point situé avant la force normale FN , la force interne V (x) peut-être réécrite comme :

V (x) = k × ∆x
sin
2π
10 t

= k ·

∆xtotal

2 − h × tan
π
2 −

2π
10 t

sin
2π
10 t
| pour 1 ≤ t ≤ 4 [sec]

En remplaçant les valeurs par leurs valeur numérique :

h = 4 × 10⁻² m,

∆xtotal
2

= 5,75 × 10⁻² m, et k = 5980 N/m

on obtient :

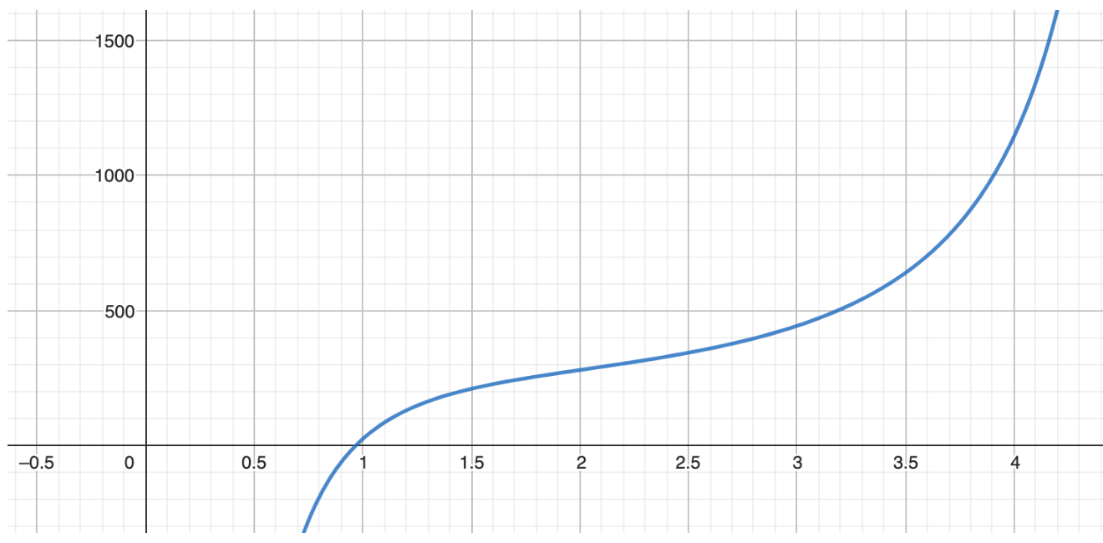
[picture p15: figure]

Figure 10 – Courbe de la force interne V(x) en fonction du temps.

La force maximum dans la barre est donc d’environ 1150 N. La pression dans la barre est :

Pmax =

Fmax dans la barre
Surface de contact =

V (x)max
h × largeur de la barre

On a :
V (x)max = 1150 N, h = 4 × 10⁻² m et la largeur de la barre vaut 1,4 cm

Donc
σmax = | V (x)max
h × largeur de la barre =
| 1150 4 × 10⁻² × 1,4 × 10⁻² = 2 MP a

En se basant sur la courbe de fatigue de l’acier à contrainte moyenne nulle (matériaux de la barre) :

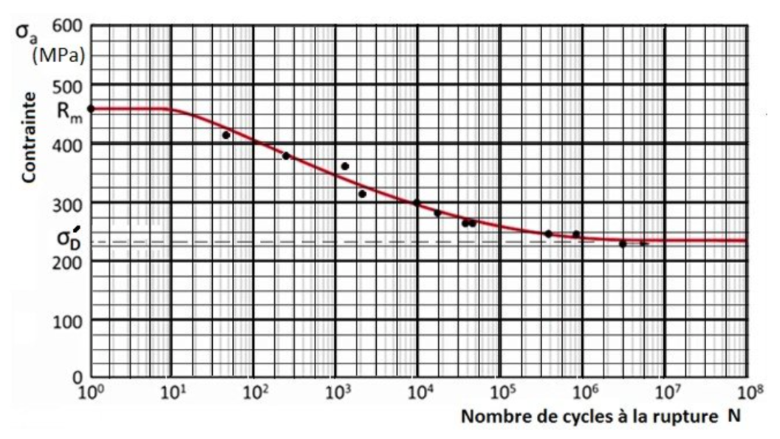
[picture p16: figure]

Figure 11 – Courbe de fatigue de l’acier

On observe que pour une contrainte de 2 MP a, le nombre de cycles en fatigue dépasse largement 1,0 × 10⁷ ,
soit l’endurance du matériau. Ainsi la barre pourra être utilisée pendant un nombre de cycles quasiment infini.

### 2.6 Calcul de la déflexion de la barre :

En utilisant les mêmes coupes dans la barre effectuées précédemment pour calculer les forces internes, on peut calculer le moment interne. On fait un bilan des moments en 0 :

XM0 = M(x) − w(x) × N(x) + x × V (x) = 0 | ⇔ | M(x) = −x × V (x) = −x ×

Fr
sin(θ)
Or d’après la relation du moment de déflexion, on a : M(x) = EI d | 2w(x)
| dx²

où E est le module d’Young du matériau et I l’inertie. On a donc :
d

2w(x)
dx²

= −

1
EI

× x ×

| | Fr sin(θ)

En intégrant deux fois la déflexion en fonction de x, on trouve :

w(x) = −

1
6EI

× x

3 ×

Fr
sin(θ)

+ Cx + D, avec C, D ∈ R

On trouve les deux constantes d’intégration avec les deux conditions suivantes : w(0) = 0 et dW
dx
x=0

= 0

w(0) = 0 ⇒ D = 0

dW
dx (x) = −

1
2EI

× x

2 ×

Fr
sin(θ)
+ C, | dW
| | dx x=0 = 0 ⇒ C = 0

Ainsi la déflexion vaut :

w(x) = −

Fr
6EI × sin(θ)

× x

3 = −

k

∆xtotal

2 − h × tan
π
2 −

2π
10 t

6EI × sin
2π
10 t
| × x
3 | pour 1 ≤ t ≤ 4 [sec]

et pour 0 ≤ x ≤ 7.

En remplaçant les valeurs par leurs valeurs numériques :

h = 4 × 10⁻² m,

∆xtotal
2
= 5,75 × 10⁻² m, | k = 5980 N/m, | E = 210 MPa

et I =

1
12

× m × L

2 =

0,4 × 0,07²
12

= 1,6 × 10⁻⁴
kg · m²

On obtient la courbe suivante :

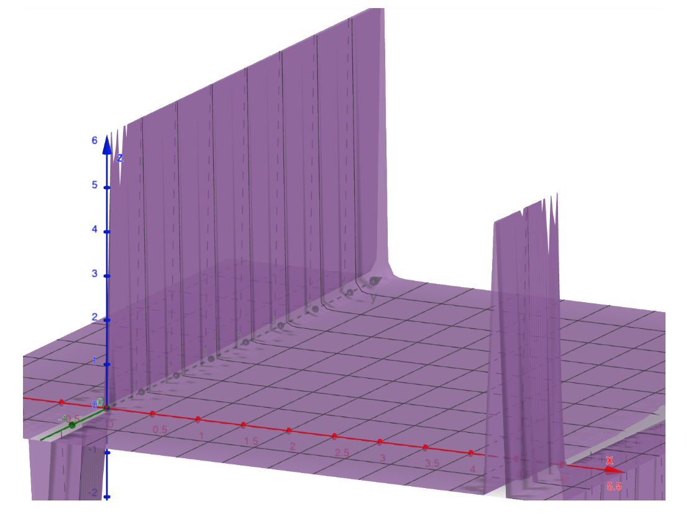
[picture p17: figure]

Figure 12 – Courbe de la déflexion de la barre en fonction de x (la distance depuis l’origine de la barre) et du temps t.

On constate qu’elle est quasiment nulle pour toute valeur de w(t, x) comprise entre [1 ; 4] × [0 ; 7]. L’acier est donc un matériau assez résistant pour ne pas subir de déflexion et durer en fatigue.

### 2.7 Système d’inclinaison de la machine

### 2.7.1 Analyse de la trajectoire de la balle selon l’angle d’inclinaison de la machine

L’objectif de cette section est de déterminer l’angle de lancement optimal de la balle de squash. Dans le cadre d’un entraînement efficace et réaliste, la machine doit être capable de projeter des balles à différentes hauteurs, afin de reproduire une variété de trajectoires représentatives des situations de jeu. Cette variabilité permet au joueur de s’exercer sur un large éventail de types de tirs, améliorant ainsi sa réactivité, sa technique et son an-ticipation. La machine lance-balles de squash est installée sur un support, de manière à placer le mécanisme de tir à une hauteur de 0,8 mètre par rapport au sol. Cette valeur est retenue comme hypothèse dans nos calculs. Elle est justifiée par des considérations ergonomiques : elle correspond à une hauteur optimale pour permettre à l’utilisateur d’actionner la manivelle confortablement et efficacement

Le tableau suivant présente les principaux types de tirs rencontrés au cours d’une partie de squash, ainsi que les hauteurs approximatives que la balle est susceptible d’atteindre à leur sommet. Ces données servent de référence pour dimensionner les paramètres de lancement de la machine.

Type de coup | Hauteur maximale approximative at-teinte (au sommet de la trajectoire)
Drive (coup tendu) | 1,2 à 1,5 m
Drop (amorti) | 0,5 à 1 m
Lob (balle haute, défensive ou offen-sive) | 3 à 3,5 m
Service lobé | Peut atteindre jusqu’à 4 m ou un peu plus

Table 4 – Hauteurs maximales approximatives atteintes selon le type de coup

Détermination des équations horaires de la balle de squash

Accélération constante : | a = (0; −g)
Gravité : | g = 9,81 m · s

−2
Vitesse initiale : v0 = 25 m · s

−1
Angle de tir : | θ = 15◦
Position initiale : | x0 = 0 m et y0 = 0,8 m

Le mouvement de la balle est étudié dans un plan, en supposant l’absence de frottement de l’air. L’analyse est effectuée dans un référentiel galiléen, ce qui garantit la validité des lois de la mécanique classique.

Conformément à la deuxième loi de Newton, la somme des forces appliquées sur le système est égale au produit de sa masse par son accélération :

F = ma
mg = ma
Donc g = a

On intègre une première fois l’accélération pour obtenir l’équation vitesse en tenant compte des conditions initiales :

v(t) = v0 +

Z
a(t) dt

Selon l’axe x :

vx(t) = v0 cos(θ) = 25 cos(15◦ ) = 24,15

Selon l’axe y :

vy(t) = −g · t + v0 sin(θ) = 25 sin(15◦ ) = −9,81t + 6,47

On intègre une seconde fois l’équation de la vitesse pour obtenir l’équation horaire de position, en tenant compte des conditions initiales.
r(t) = r0 +

Z
v(t) dt

Selon l’axe x :
x(t) = Z
vx(t) dt = 24,15 · t

Selon l’axe y :
y(t) = Z
vy(t) dt = −

1
2
- 9,81 · t

2 + 6,47t + 0,8

Équation horaire de position finale :

x(t) = 24,15 · t

y(t) = −
2
- 9,81 · t

2 + 6,47t + 0,8

Ainsi on a :

x(t) = 24,15 · t | ⇔ | t =

s
x(t)
24,15

En substituant dans l’autre équation on a :

y(x) = −

1
2
- 9,81 ·

x(t)
24,15

+ 6,47 ·

s
x(t)
24,15

+ 0,8

y(x) = −0,203x + 1,317√
x + 0,8

Calculons certaines caractéristiques de notre lancement :

Temps pour atteindre la hauteur maximale :

tmax =

vy
g

=

6,47
9,81

= 0,66 s

Hauteur maximale atteinte :
ymax = y(tmax) = 2,93 m

Temps avant que la balle touche le sol (y(t) = 0) :

tsol = 1,43 s

Distance horizontale (portée maximale) :

x(tsol) = 49,38 m

On en conclut qu’un angle de lancement maximal de 15° est suffisant pour couvrir l’ensemble des trajectoires souhaitées dans le cadre d’un entraînement au squash. Cette valeur permet d’atteindre une hauteur et une portée compatibles avec les dimensions du court tout en assurant une bonne reproductibilité des tirs par la machine.

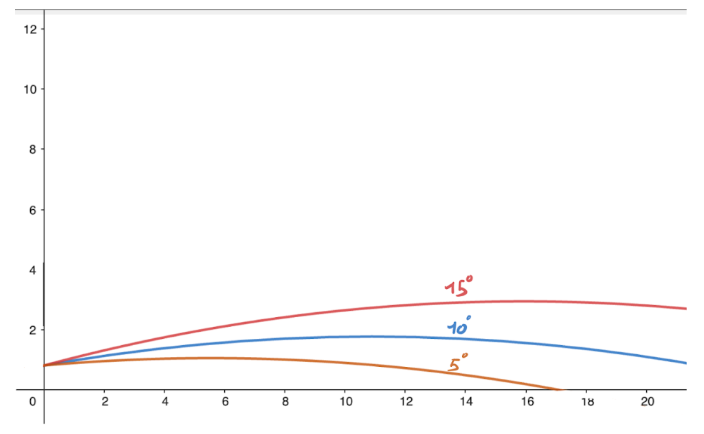
[picture p18: figure]

Figure 13 – Trajectoire de la balle en fonction des différents angles de lancement.

### 2.7.2 Mécanisme d’inclinaison

Nous savons les différents angles que nous cherchons à obtenir lors du lancement de la balle. Désormais, nous cherchons à dimensionner les pièces qui permettent d’incliner notre machine.

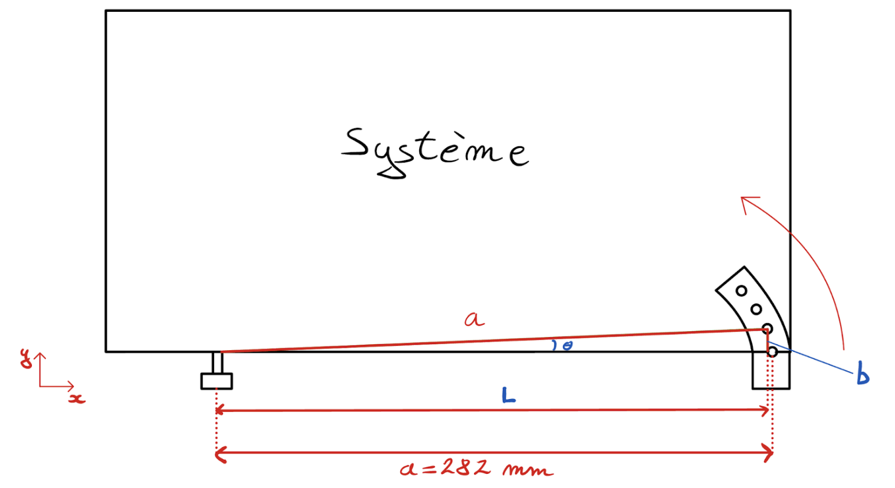
[picture p19: figure]

Figure 14 – Système avec différents angles de tirs

Nous avons choisi, comme on peut observer en bas à gauche du schéma, des pieds de réglage type rotatif court afin d’assurer la rotation de 0° à 15°. Pour le côté droit de la machine, d’où les balles partent, on opte pour une pièce qui dispose de plusieurs trous permettant de choisir l’angle de lancement : 0°, 5°, 10° ou 15°.
Afin de déterminer les coordonnées des trous à effectuer nous devons calculer la longueur L et hauteur b de chaque triangle comme légendé ci-dessus.
Les formules générales sont

Li = a × cos(θi) et bi = a × sin(θi)

Trou numéro 1 :

L1 = a × cos(θ1)L1 = 282 × cos(5◦

)L1 = 280,9 mm b1 = a × sin(θ1)b1 = 282 × sin(5◦ )b1 = 2,46 mm

Trou numéro 2 :

L2 = a × cos(θ2)L2 = 282 × cos(10◦

)L2 = 277,7 mm b2 = a × sin(θ2)b2 = 282 × sin(10◦
)b2 = 4,90 mm

Trou numéro 3 :

L3 = a × cos(θ3)L3 = 282 × cos(15◦

)L3 = 272,5 mm b3 = a × sin(θ3)b3 = 282 × sin(15◦ )b3 = 7,30 mm

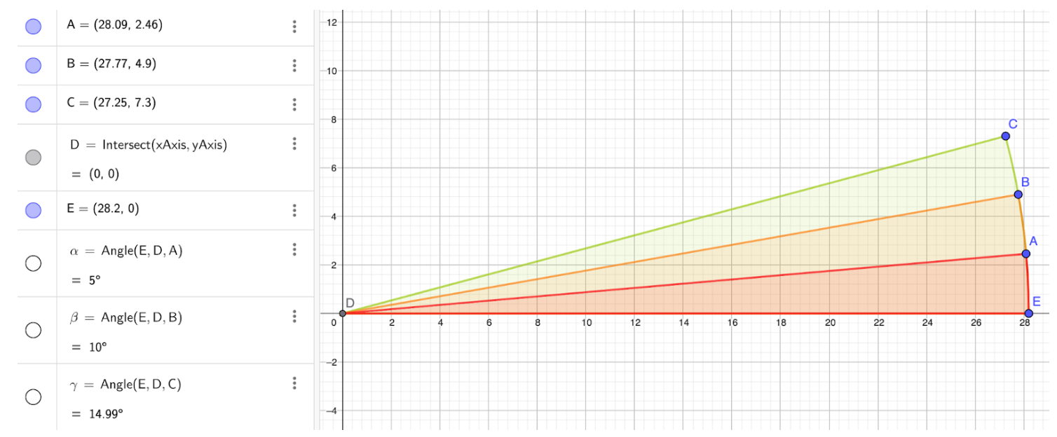
[picture p20: figure]

Figure 15 – Coordonné des trous du mécanisme d’inclinaison

On peut noter que l’angle EDC d = 14,99◦ dû aux arrondis. Cela reste très largement négligeable.

### 2.8 Système de blocage

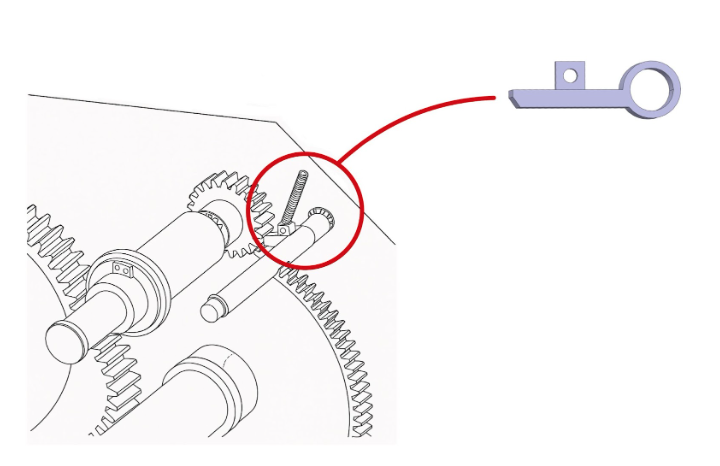
[picture p21: figure]

Figure 16 – Propriétés mécaniques du X20Cr13 (acier martensitique inoxydable)

Propriétés mécaniques du X20Cr13

Limite d’élasticité | 500 MPa
Résistance à la traction | 800 MPa
Module d’Young | 200 GPa

### 2.8.1 Calcul de la force tangentielle sur le cliquet

Calculons la force tangentielle que subit le cliquet :

FT1/2 =

ME1

RE1

=

2,5
12,5 × 10⁻³

= 200 N

Le cliquet agit comme un petit bras de levier encastré à sa base, donc le cas critique est en flexion et en cisaillement.

Moment appliqué par la roue sur le cliquet :

M = FT1/2

- l = 200 · 0,015 = 3 N

Contrainte maximale :

σ =

M · c
I

M = 3 N

c = distance entre la fibre neutre et la surface ( 1/2 hauteur) I = moment d’inertie

Moment d’inertie de la section rectangulaire :

I =

bh³
12

=

2 · 8
12

= 8,53 · 10⁻¹¹ m⁴

c =

h
2

=

8
2

= 4 · 10⁻³ m

σ =

M · c
I

=

3 · 4 · 10⁻³
8,53 · 10⁻¹¹ = 140,7 MPa

Ainsi on a :

Contrainte max : σ = 140,7 MPa

Limite élastique X20Cr13 : σlim = 500 MPa

On a bien : 140,7 MPa < 500 MPa

Calculons le coefficient de sécurité : s =

σlim σ = | 500
| 140,7 ≈ 3,55

C’est un très bon coefficient de sécurité (≥ 3 recommandé pour dispositifs à choc ou répétition).

Le cliquet subit donc une force tangentielle de 200 N due à la rotation de la roue dentée, ce qui correspond à un moment de 3 N·m sur son bras de levier. En considérant cette charge, la contrainte maximale dans le cliquet est de 140.7 MPa, bien inférieure à la limite élastique de l’acier X20Cr13 (500 MPa), avec un coefficient de sécurité de 3.55, ce qui est suffisant pour un usage avec effort répété ou à choc.

### 3 Puissances et Rendement

La chaîne de puissance de notre système débute par l’effort manuel exercé sur la manivelle et se termine par l’éjection de la balle. À chaque étape, une partie de l’énergie est dissipée sous forme de chaleur, de frottement ou de vibrations. Le rendement global ηtotal du système est donc le produit des rendements partiels de chaque sous-système. On s’intéresse aux différentes pertes le long de la chaîne de puissance de notre machine afin de déterminer le rendement total de celle-ci.

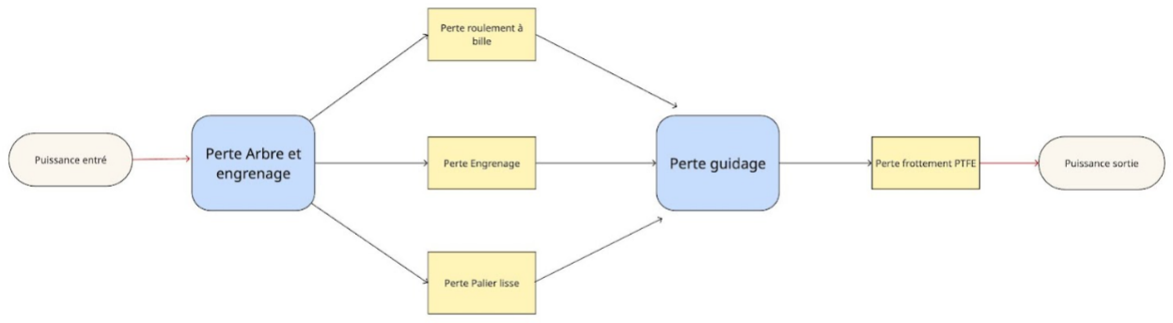
[picture p22: figure]

Figure 17 – Chaîne de Puissance du mécanisme

Calcul des puissances

Rappelons que notre moment d’entrée est de 2,5 N.m. Cela nous permet de calculer la puissance d’entrée du mécanisme :

PEntrée = Mentré × ωentrée = 2,5 × 4π = 31,41 W

Il nous suffit désormais de déterminer tous les endroits où notre mécanisme perd de la puissance. Voici une liste des vecteurs de pertes par frottements :

— Les liaisons impliquant des frottements sont des liaisons arbre-moyeu (roulements à billes, paliers lisses, engrenages)
— Liaisons du guidage du ressort
Nous nous intéresserons donc ici aux puissances dissipées par les différentes liaisons.

### 3.1 Pertes par roulements à billes (arbre manivelle)

Selon la norme ISO 2811, un roulement à billes présente un rendement élevé estimé à η = 0,99. Pour deux roulements sur l’arbre 1 :

ηRàB = (0,99)² = 0,98

On en déduit la perte par roulements à billes :

PRàB = Putile × (1 − ηRàB) = 31,41(1 − 0,98) = 0,60 W

### 3.2 Pertes par paliers lisses

En suivant la norme ISO 2811, un palier lisse en conditions modérées a un rendement unitaire de 0,98. Pour deux arbres équipés chacun de deux paliers :

ηP L = (0,98)⁴ = 0,93

On en déduit la perte des paliers lisses :

PP L = Putile × (1 − ηP L) = 31,41(1 − 0,93) = 2 W

### 3.3 Pertes dans les engrenages

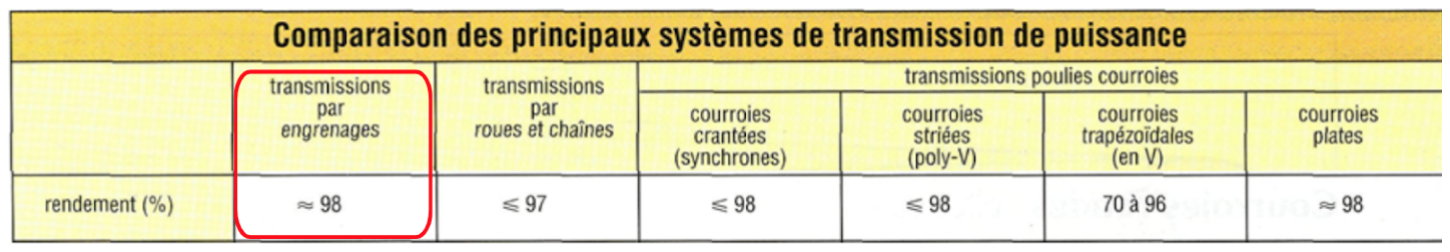
[picture p23: figure]

Figure 18 – Tableau de comparaison des différents systèmes de puissance.

Le système comporte deux liaisons par engrenages droits bien usinés, avec un rendement typique de 0,98 :

ηE = (0,98)² = 0,96

D’où la perte de puissance due aux engrenages :

PE = Putile × (1 − ηE) = 31,41(1 − 0,96) = 1,2 W

### 3.4 Pertes par glissement dans le guidage

Le guidage est assuré par un contact PE-UHMW/PTFE : une pièce mobile en PE-UHMW usinée à Ra = 0,8 (qualité N6) glisse dans un tube fixe en PTFE usiné à Ra = 1,6 (qualité N7).
Le contact PE-UHMW/PTFE présente selon ISO 2811 un coefficient de frottement typique : µ ∈ [0,02; 0,6] et une bonne glissance à sec. On supposera dans ce projet : µ = 0,03, ce qui est fiable à des qualités N6/N7. On en déduit le rendement du guidage :

ηguidage =

1
1 + µ

=

1
1,03

= 0,97

On en déduit la perte du guidage :

Pguidage = Putile × (1 − ηguidage) = 31,41(1 − 0,97) = 0,94 W

### 3.5 Perte du système de blocage

Le cliquet en lui même ne crée par de perte. On pourrait penser que le ressort attaché est lui à l’origine de pertes cependant, la force du ressort permet juste de maintenir le cliquet dans l’axe de l’engrenage en contrant la force gravifique. Ainsi, la perte due au système de blocages est largement négligeable voire nulle.

### 3.6 Rendement total

Calculons la perte totale :

Ptotal = Pguidage + PE + PP L + PRàB = 0,94 + 1,2 + 2 + 0,6 = 4,74

On en déduit donc le rendement total :

ηtotal =

Putile

Pentrée

=

Pentrée − Ptotal

Pentrée

=

31,41 − 4,74
31,41

= 84,9 %

Le rendement global de notre mécanisme de lancement est estimé à 84,9 % en conditions standards. Il intègre l’ensemble des pertes par frottement dans les roulements, paliers, engrenages et le guidage linéaire. Ce rendement reste conforme aux objectifs de compacité, performance et fiabilité du système.

### 3.7 Force réelle appliquée

Sachant que nous avons un rendement de 84,9 %, dû majoritairement aux pertes des paliers, la force théorique appliquée au système sera plus élevée en réalité :

Mréel =

1

ηtotal

× Mentré =

1
0,849

× 2,5 = 2,94 N · m

⇒ Fréel =

Mréel

rmanivelle

=

2,94
0,125

= 23,52 N

Au lieu des 20 N d’entrée théorique, l’utilisateur devra tirer 23,52 N de plus, soit environ 2,4 kg d’entrée.

### 4 Dimensionnement et résistance des éléments de liaisons

Le dimensionnement des clavettes parallèles est directement lié aux dimensions des arbres qu’elles connectent. Une attention particulière doit être portée à la résistance des arbres, notamment face aux efforts de torsion transmis par l’assemblage. Il est également essentiel d’évaluer la pression de matage entre la clavette et ses logements (arbre et moyeu), afin de garantir l’intégrité mécanique de l’ensemble sous les conditions.

### 4.1 Cisaillement et Torsion des arbres/clavettes

Nous calculons ici les efforts de cisaillement subis par les trois arbres du mécanisme, ainsi que par les clavettes assurant la transmission du couple via le système d’engrenage. L’objectif est de s’assurer que les composants résistent mécaniquement aux contraintes générées.

Clavette | 17 [mm] 18 [mm] 19 [mm] 20 [mm] 21 [mm] 22 [mm]
Dimension | L=14 b=6 L=34 b=6 L=34 b=4 L=26 b=5 L=18 b=2 L=18 b=3

Table 5 – Dimensions des clavettes selon leur diamètre

Le cisaillement est donné par la formule :

| τ = Ftangentielle A

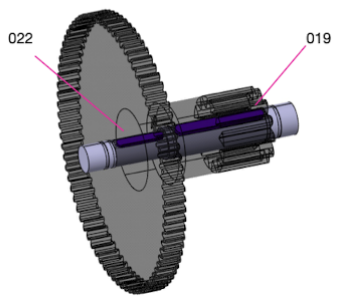
[picture p24: figure]
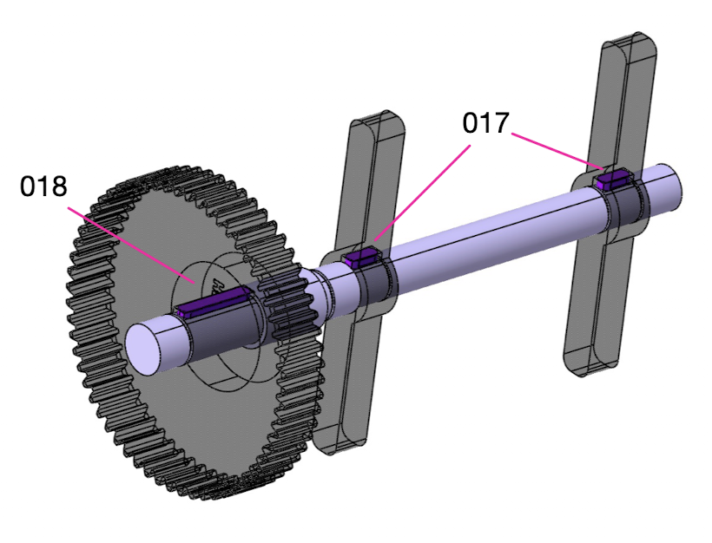
[picture p25: figure]
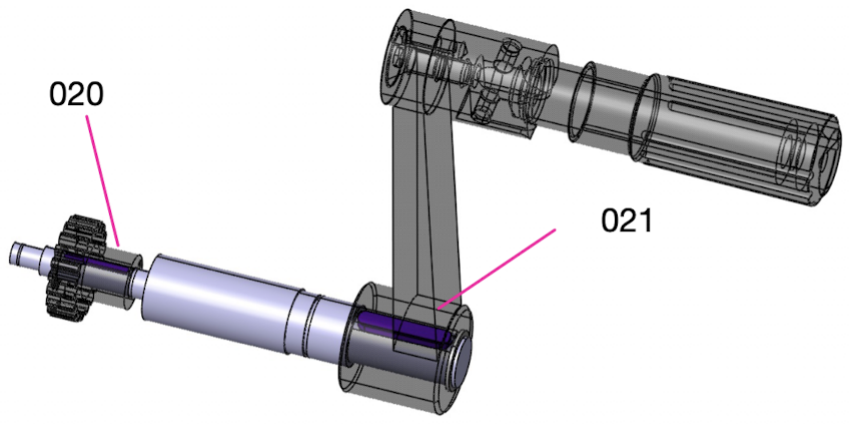
[picture p26: figure]

(a) Clavettes arbre 1 | (b) Clavettes arbre 2 | (c) Clavettes arbre 3

Figure 19 – Dimensionnement des clavettes

Cisaillement sur l’arbre 1 :

Ftangentielle =

Mmax

Rarbre

=

2,5
0,008

= 312,5 N

τclavette =

Ftangentielle
A

=

Ftangentielle
b · L

=

312,5
0,002 · 0,018

= 8,6 MPa <

Racier
2

= 100 MPa

Cisaillement sur l’arbre 1

τarbre =

Ftangentielle
A

=

Mmax
π · r

3

= 12.43 MPa <

Racier
2

= 100 MPa

Cisaillement sur l’arbre 2

Ftangentielle =

Mmax

Rarbre

=

10
0.012

= 833.3 N

τclavette =

Ftangentielle
A

=

Ftangentielle
b · L

=

833.3
0.003 · 0.018

= 15 MPa <

Racier
2

= 100 MPa

τclavette =

833.3
0.004 · 0.034

= 6.1 MPa <

Racier
2

= 100 MPa

τarbre =

Ftangentielle
A

=

Mmax
π · r

3

= 14.74 MPa <

Racier
2

= 100 MPa

Cisaillement sur l’arbre 3

Ftangentielle =

Mmax

Rarbre

=

50
0.020

= 2500 N

τclavette =

Ftangentielle
b · L

=

2500
0.006 · 0.034

= 12.2 MPa <

Racier
2

= 100 MPa

τarbre =

Ftangentielle
A

=

Mmax
π · r

3

= 15.92 MPa <

Racier
2

= 100 MPa

Engrenage | C (N·mm) | d (mm) | a = h/2 (mm) | b (mm) | L (mm) | τclavette (MPa) | τ < 100 | σ (MPa) | σ < 200 | τarbre (MPa)
E1 | 2500 | 8 | 1.0 | 2 | 18 | 8.6 | oui | 8.6 | oui | 12.43
E2 | 10000 | 10 | 1.5 | 3 | 18 | 15.0 | oui | 15.0 | oui | 14.74
E3 | 10000 | 12 | 2.0 | 4 | 34 | 6.1 | oui | 6.1 | oui | 14.74
E4 | 50000 | 20 | 3.0 | 6 | 34 | 12.2 | oui | 12.2 | oui | 15.92

Table 6 – Tableau de nos résultats de cisaillement et de torsion des arbres/clavettes

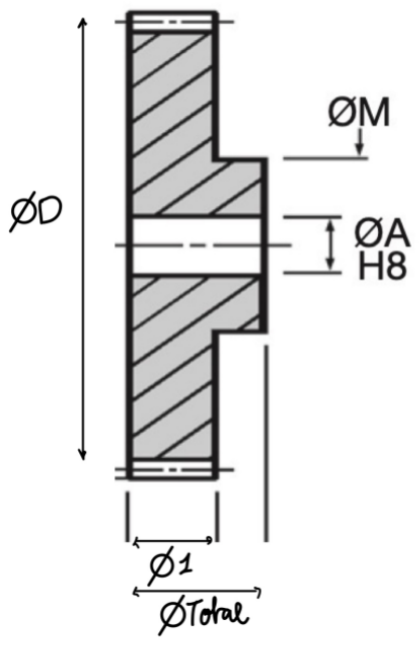
[picture p27: figure]

Figure 20 – Schéma de l’engrenage.

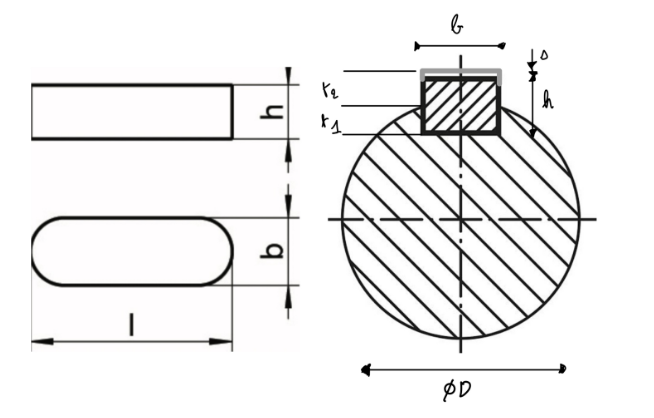
[picture p28: figure]

Figure 21 – Schéma de la clavette.

### 4.2 Résistance à la torsion des arbres de transmissions

On suppose que les arbres subissent une torsion maximale due à un blocage du système mécanique.

Dans le cadre de cette étude, les hypothèses suivantes ont été adoptées afin de simplifier l’analyse tout en conservant un bon niveau de représentativité mécanique :
— Les arbres sont supposés soumis exclusivement à un moment de torsion.
Efforts de flexion et tranchants négligés : Ces composantes sont écartées de l’analyse, dans la mesure où les charges appliquées sont essentiellement axiales, grâce à un bon alignement des roulements.

Résistance élastique : Re = 503 MP a (Résistance élastique de l’aluminium 7075 – T6 )

Résistance pratique au glissement : Rpg Coefficient de sécurité : s = 2 Diamètre : Darbre
Moment quadratique : Ig

Rpg = 0,8 ×

Re
s

Rpg = 0,8 ×

200
2

= 100 MP a

Le diamètre minimal des arbres soumis à un couple T est déterminé par la formule de torsion :

Darbre =

16 × Mroue

τMax × π

1
3

Dans le cadre d’un mécanisme soumis à des charges importantes, la sécurité de l’utilisateur constitue une priorité. Il est donc impératif que les arbres soient capables de résister aux couples maximaux susceptibles d’être appliqués en service, y compris en cas de blocage ou d’effort exceptionnel.
Le diamètre des arbres est dimensionné en fonction du couple transmis. Afin d’introduire une marge de sécurité suffisante, un coefficient de sécurité de 2 est appliqué dans le calcul. Cette approche garantit que les contraintes maximales restent inférieures à la limite admissible du matériau, même dans les conditions les plus défavorables.

Arbre 1 : Entrée manivelle
— Élément fixé : manivelle + engrenage (Ø8 mm) — Couple appliqué via manivelle : T = 2.5 Nm

Darbre,1 =

16 × Mroue

τMax × π

1
3
=

16 × 2.5
100 × 10⁶ × π

1
3
= 0,005 m = 5 mm

Arbre 2 : Transmission intermédiaire

Éléments fixés sur l’arbre :
— Engrenage 2.1 : reçoit un couple de 10 Nm en provenance de l’arbre 1, par l’intermédiaire d’un réducteur avec un rapport de réduction de 1 :4.
— Engrenage 2.2 : transmet ce même couple de 10 Nm à un engrenage de plus petit diamètre, via une réduction de 1 :5.

Remarque :

Le couple transmis au travers de l’arbre 2 reste constant à 10 Nm. Les rapports de réduction mentionnés n’affectent pas ce couple sur l’arbre lui-même, car les effets des réductions interviennent en amont ou en aval, respectivement sur l’arbre 1 et l’arbre 3.

Darbre,2 =

16 × Mroue

τMax × π

1
3
=

16 × 10
100 × 10⁶ × π

1
3
= 0,008 m = 8 mm

Arbre 3 : Organe entraîné

Éléments montés sur l’arbre :
— Engrenage récepteur : transmet un couple de 50 Nm, résultant de la réduction 1 :5 appliquée au couple de 10 Nm provenant de l’arbre 2.
— Deux cames : chacune impose un couple résistant de 23 Nm.

Total des couples résistants :

Mtotal = 50 Nm + 2 × 23 Nm = 96 Nm

Darbre,3 =

16 × Mroue

τMax × π

1
3
=

16 × 96
100 × 10⁶ × π

1
3
= 0,0017 m = 17 mm
Arbre | Élément(s) fixé(s) | Couple transmis (Nm) | Ø mini (mm) | Matériau
1 | Manivelle + engrenage (Ø8 mm) | 2.5 | 5 | Alu 7075-T6
2 | 2 engrenages (Ø10–12 mm) | 10 | 8 | Alu 7075-T6
3 | Engrenage (Ø20 mm) + 2 cames (Ø18 mm) | 96 | 12 | Alu 7075-T6

Table 7 – Tableau des couples en fonctions de chaque arbre

### 4.2 Pression de matage

Le dimensionnement des arbres de transmission permet de déterminer les dimensions normalisées des clavettes à l’aide des tableaux de normes.

Dans le cadre de ce projet, un clavetage léger a été retenu, ce qui implique une sollicitation modérée de l’assemblage arbre-moyeu et permet une mise en œuvre simplifiée, tout en assurant une transmission fiable du couple.

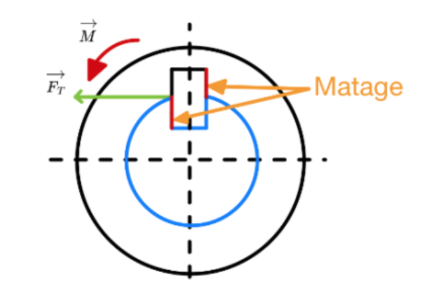
[picture p29: figure]

Figure 22 – Schéma illustrant la pression de matage sur une clavette parallèle.

Figure 23 – Schéma illustrants les dimensions d’une clavettes.

Hauteur de la clavette en mm : b Longueur de la clavette en mm : L Pression de matage : Pm
Pression admissible : Pa

Pm = 2 ×

FT
b × L

< Pa

Conditions de fonctionnement | Pression de matage admissible (MPa)
Excellentes | 10 à 20 MPa
Normales | 5 à 15 MPa
Mauvaises | 2 à 10 MPa

Table 8 – Pression de matage admissible selon les conditions de fonctionnement

Figure 24 – Tableau des pressions admissibles pour un clavetage léger selon le type de montage.

Pm,1 = 2 ×

FT
b × L

= 2 ×

200
0.002 × 0.018

= 11.1 MP a < Pa

Pm,2 = 2 ×

FT
b × L

= 2 ×

200
0.003 × 0.018

= 7.4 MP a < Pa

Pm,3 = 2 ×

FT
b × L

= 2 ×

850
0.004 × 0.034

= 12.5 MP a < Pa

Pm,4 = 2 ×

FT
b × L

= 2 ×

850
0.006 × 0.034

= 8.3 MP a < Pa

Toutes les clavettes présentent une pression de matage inférieure à la pression admissible pour un clavetage léger, conformément aux plages définies dans les normes. Cela garantit un fonctionnement sûr sans dépassement des contraintes maximales admissibles.

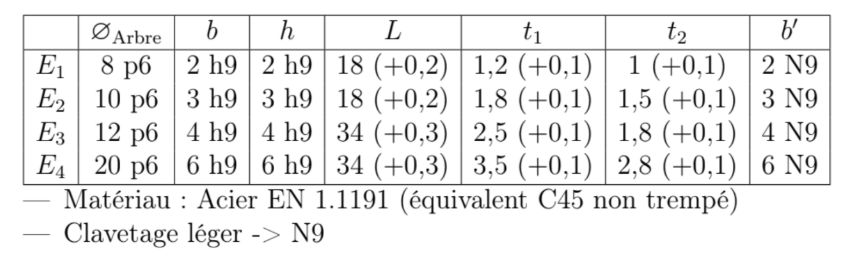
[picture p30: figure]

Figure 25 – Tableau des dimensionnement des clavettes.

### 4.3 Résistance des coussinets

Pour l’interface entre les arbres et les carénages, nous avons opté pour l’utilisation de coussinets (palier lisse). Ce type de palier permet de guider l’arbre tout en autorisant un degré de liberté en rotation autour de son axe principal.

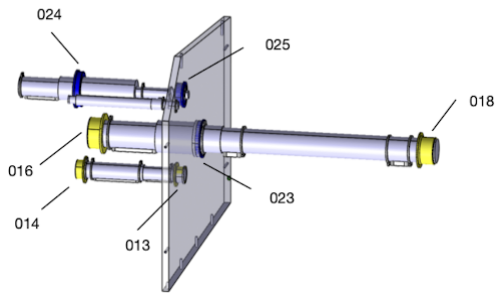
[picture p31: figure]

Figure 26 – Schéma des paliers lisses présent sur notre machine

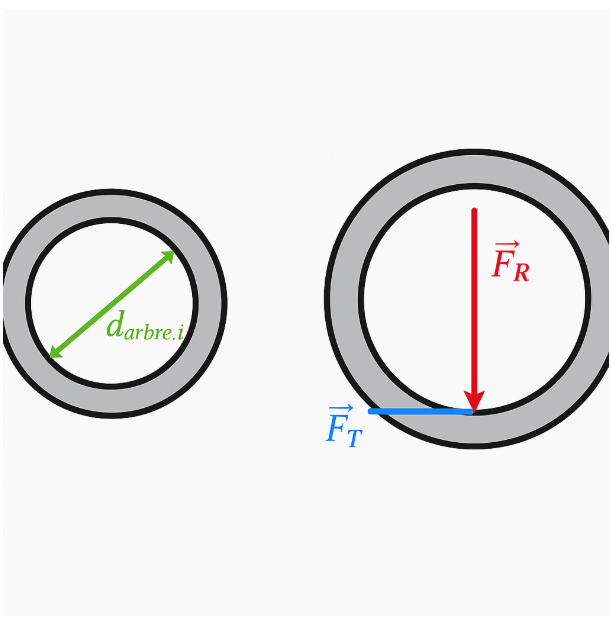
[picture p32: figure]

Figure 27 – Schéma représentant les forces appliquées sur les coussinets.

### 4.3.1 Calcul de la force radiale

L’objectif est d’évaluer la force radiale appliquée sur le coussinet supportant l’arbre. Le premier arbre porte la manivelle et une roue dentée. Le second porte deux roues dentées, chacune étant en prise avec un engrenage distinct. L’arbre 1 ne subit qu’une seule charge radiale.
Cependant, il est important de noter que l’arbre 1 peut également être soumis à un effort axial ou un moment de flexion si la manivelle génère une charge excentrée, en fonction de son utilisation. Nous considérons que ces moments sont nuls.
Par conséquent, les efforts radiaux générés par les deux engrenages s’additionnent et sont transmis aux paliers, ce qui impose une charge radiale cumulée sur les coussinets.

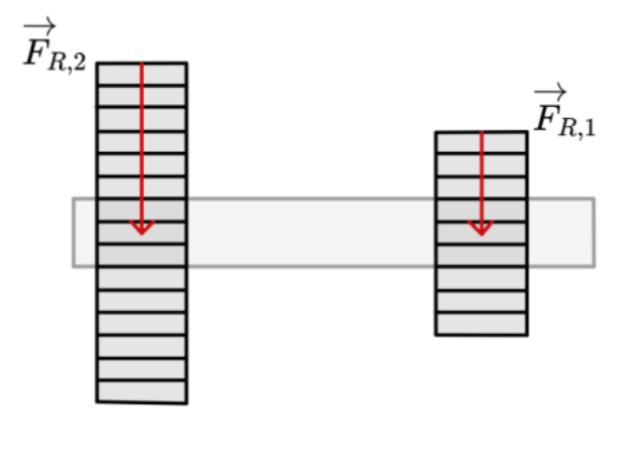
[picture p33: figure]

Figure 28 – Schéma des forces radiales agissant sur l’arbre n°2.

Force tangentielle : FT
Force radiale : FR
Force appliquée : F
Largeur du carénage : Lcarénage

On rappelle qu’on a un angle de pression de 20◦ pour nos deux roues dentées :

FR,1 = FT1/2 × tan(20◦
)
⇒ FR,1 = 200 × tan(20◦
) = 72.8 N

Puis, nous effectuons le même calcul pour la roue dentée numéro 2 :

FR,2 = FT3/4 × tan(20◦
)
⇒ FR,2 = 850 × tan(20◦
) = 309.3 N

XFTotal = FR,1 + FR,2

⇒ FR,1 + FR,2 = 72.8 + 309.3 = 382.1 N

Einitial =

1
2
- 0.025 × (25)² = 7, 8J

### 4.3.2 Calcul de la pression diamétrale

Nous procédons au calcul de la pression diamétrale exercée sur le coussinet, c’est-à-dire la pression résultant de la force radiale répartie sur la surface de contact cylindrique entre l’arbre et le palier.
L’analyse est menée sur le cas le plus défavorable, à savoir l’arbre présentant le plus petit diamètre associé à la plus grande force radiale, afin de garantir la validité du dimensionnement dans les conditions les plus contraignantes. Nous utilisons la formule suivante :
p =

FTotale

darbre,1 × Lcoussinet

p =

382.1
0.010 × 0.00689

= 5.5 MP a = 5.5 N.mm⁻²

p =

382.1
0.010 × 0.00689

= 5.5 MP a = 5.5 N.mm⁻²

p =

382.1
0.020 × 0.011365

= 5.5 MP a = 1.6 N.mm⁻²

### 4.3.3 Calcul de la vitesse tangentielle de l’arbre au niveau des coussinets (en m/s)

Elle dépend de la vitesse de rotation et du rayon de l’arbre :

d = diamètre de l’arbre (en m) n = vitesse de rotation (en tr/min)

Le diamètre de l’arbre 2 est de 12 mm, et tourne à une vitesse de 0.5 tours/s soit, 30 tours/min.

VT = W × Rarbre =

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
π × 30 × 0.012
60

= 0.018 m · s

−1

Le diamètre de l’arbre 3 est de 20 mm, et tourne à une vitesse de 0.1 tours/s soit, 6 tours/min.

VT = W × Rarbre =

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
π × 6 × 0.020
60

= 0.0063 m · s

−1

Nous calculons ensuite le produit pVT , avec VT la vitesse tangentielle du coussinet. Nous rappelons que nous prenons le pire des cas.
Le produit pVT combine deux effets : la pression de contact moyenne entre l’arbre et le coussinet (due à la charge radiale), et la vitesse de glissement (vitesse périphérique de l’arbre à la surface de contact avec le coussinet).
En multipliant les deux, on obtient un critère de fonctionnement global qui permet d’évaluer la capacité de lubrification, l’échauffement du coussinet, et le comportement à l’usure.

Pour l’arbre 2 :

pVT = 5.5 × 0.018 = 0.1

pVT = 5.5 × 0.018 = 0.1

Pour l’arbre 3 :

pVT = 1.6 × 0.0063 = 0.01

Ainsi dans nos 3 cas :

pVT ≪ 1

Les valeurs obtenues pour le critère pVT sont largement inférieures aux seuils critiques. Cela indique que les coussinets fonctionnent dans des conditions très favorables, avec un bon compromis entre pression et vitesse. Aucun risque d’échauffement excessif ni de défaillance prématurée n’est à prévoir.

### 4.4 Calcul de la durée de vie des roulements à billes

— Capacité de charge dynamique du roulement : C
— Charge radiale équivalente : P
— Exposant de fatigue : p = 3 (pour les roulements à billes)
— Nombre de millions de tours sous charge appliquée : L
— Coefficient de sécurité : S = 0.9
Nous admettons l’utilisation d’une charge radiale théorique élevée pour accentuer le fait que les roulements à billes soient résistants pour ce type d’utilisation :

Pour le premier roulement à billes :

L =

C
P

p

P = X · F r + Y · F a

F r = force radiale appliquée sur roulement

F a = force axiale appliquée sur roulement

F a = 0

De plus, dans les cas simples de roulements radiaux, le coefficient X = 1.0.

Ainsi on a :
P = F r

L =

C
P

p
=

2233
381.2

3
= 199 millions de tours

s × L = 0.9 × 199 = 179.1 millions de tours

L’arbre 1 tourne de 10 tours pour lancer une balle.

179.1 × 10⁶
10

= 17.9 millions de balles lancés

Pour le second roulement à billes :

L =

C
P

p
=

2190
382.1

3
= 188 millions de tours

s × L = 0.9 × 188 = 169.2 millions de tours

L’arbre 1 tourne de 10 tours pour lancer une balle.

169.2 × 10⁶
10

= 16.9 millions de balles lancés

Pour le troisième roulement à bille :

L =

C
P

p
=

1041
381.1

3
= 20.3 millions de tours

s × L = 0.9 × 3.3 = 18.27 millions de tours

L’arbre 3 tourne de 0.5 tours pour lancer une balle.

18.27 × 10⁶
0.5

= 36.54 millions de balles lancés

L’utilisateur pourra lancer jusqu’à 36,54 millions de balles avant qu’il ne soit nécessaire de remplacer le premier roulement à billes. On peut donc en conclure avec confiance que les roulements n’auront pas besoin d’être changés durant toute la durée de vie de la machine.

### 4.5 Dimensionnement des circlips

Pour éviter que le circlip ne s’arrache, on vérifie que la contrainte reste inférieure à la contrainte admissible :
Ainsi on vérifie pour le cisaillement la condition suivante :

τ =

FT
S

=

2C
d · a · L

< τadm

De plus, on vérifie la condition suivante pour l’écrasement :

σ =

FT
b · L

=

4C
d · b · L

< σadm

Les conditions admissibles utilisées sont :

τadm = 100 MPa donné par τadm = Rpg = 0,5 × Rpe

σadm = 200 MPa donné par σadm =

Re
k

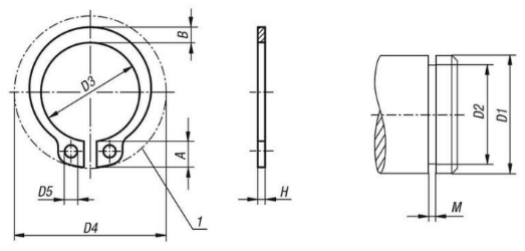
[picture p34: figure]

Figure 29 – Schéma de l’arbre et du circlip.

Première roue dentée :

C = 2500 N · mm, | d = 8 mm, | a = 1, | b = 2, | L = 18

Cisaillement :
τ = | 2 · 2500 8 · 1 · 18
= 34.72 MP a

Écrasement :
σ = | 4 · 2500 8 · 2 · 18
= 34.72 MP a

Deuxième roue dentée :

C = 10000, | d = 10, | a = 1.5, | b = 3, | L = 18

Cisaillement :
τ =

2 · 10000
10 · 1.5 · 18

= 74.07 MP a

Écrasement :

σ =

4 · 10000
10 · 3 · 18

= 74.07 MP a

Troisième roue dentée :

C = 10000, | d = 12, | a = 2, | b = 4, | L = 34
Cisaillement : Cisaillement : τ = | 2 · 10000 12 · 2 · 34

= 24.51 MP a

Écrasement :
σ = | 4 · 10000 12 · 4 · 34
= 24.51 MP a

Quatrième roue dentée :

Quatrième roue dentée :

C = 50000, | d = 20, | a = 3, | b = 6, | L = 34

Cisaillement :
τ = | 2 · 50000 2.3 · 34
= 49.02 MP a

Écrasement :
σ = | 4 · 50000 20 · 6 · 34
= 49.02 MP a

L’ensemble des engrenages analysés respecte les critères mécaniques de dimensionnement au regard des sollicitations sur les clavettes. Plus précisément, les calculs montrent que les contraintes de cisaillement τ et d’écrasement σ restent inférieures aux limites admissibles pour chaque cas étudié.
Ainsi, les résultats suivants, résumés dans le tableau ci-dessous, confirment que les conditions mécaniques sont bien respectées.

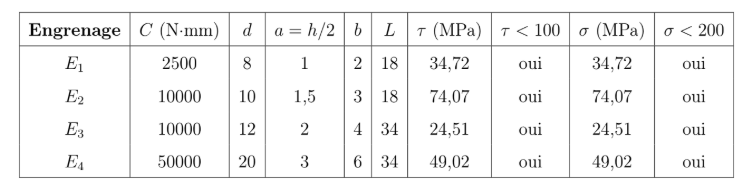
[picture p35: figure]

Figure 30 – Tableau des résultats des contraintes de cisaillement et d’écrasement sur les clavettes.

### 4.6 Dimensionnement des vis

Formule utilisée pour calculer la longueur de la vis d’assemblage et du trou taraudé.

LV is = Lk + Li

Ltaraudage = Lk + Li + 0.5 × d + DB | DB = d − P

Vis d’assemblage de la butée en caoutchouc M4 :

Li = 2 × d = 2 × 4 = 8 mm

Lk = 5d car la force extérieure est vibratoire

Lk = 5d = 5 × 4 = 20

LV is = Lk + Li = 20 + 8 = 28 mm

Vis choisie 30 mm

DB = d − P = 4 − 0.7 = 3.3 mm

Ltaraudage = Lk + Li + 0.5 × d + DB = 18 + 2 + 3.3 = 33.3 mm

Vis d’assemblage des structures en aluminium : Choix M2 :

d = 2 mm

Li = 2 × 2 = 4 mm Lk = 3d = 3 × 2 = 6

P = 0.70 mm (pas normal)

DB = d − P = 2 − 0.4 = 1.6 mm

Longueur de vis :
LV is = Lk + Li = 6 + 4 = 10 mm

Longueur de taraudage :

Ltaraudage = Lk + Li + 0.5 · d + DB = 4 + 4 + 1 + 1.6 = 12.6 mm

Choix M8 :

d = 8 mm | Li = 2 × 8 = 16 mm | Lk = d = 8
P = 1.25 mm (pas normal) | DB = 8 − P = 8 − 1.25 = 6.75 mm

Longueur de vis :
LV is = Lk + Li = 6 + 4 = 10 mm

Longueur de taraudage :

Ltaraudage = Lk + Li + 0.5 · d + DB = 4 + 4 + 1 + 1.6 = 12.6 mm

Assemblage de la barre et le support de balle en PE-UHMW :

Élément | Justification technique
Jeu | -0.05 à -0.10 mm
Rugosité barre | Ra = 0.8 – 1.6 µm (bonne accroche sans abrasion)
Facilité d’assemblage | Montage à froid possible, plastique tolérant, pressage manuel ou léger
Résistance finale | Bonne tenue axiale si la longueur d’engagement 1.5x le dia-mètre

Table 9 – Critères de montage barre-support en PE-UHMW

### 5 Analyse des risques

Dans toute conception mécanique, il est essentiel d’anticiper les défaillances potentielles afin d’assurer à la fois la sécurité des utilisateurs et la fiabilité du système. Notre lanceur de balles de squash n’échappe pas à cette exigence. Une analyse des risques a donc été menée de manière systématique.
L’objectif de cette démarche est de recenser les scénarios à risque, d’en évaluer les conséquences, d’estimer leur gravité et leur probabilité d’occurrence, puis de définir pour chacun des mesures de prévention appropriées. Le tableau suivant synthétise cette étude. Il met en relation les risques identifiés avec leur impact potentiel, tout en proposant des actions correctives ou préventives concrètes, intégrées dès la phase de conception.
Risque | Conséquence potentielle | Gravité | Probabilité Actions préventives
Coincement de la main dans la manivelle | Blessure utilisateur | + | – | — Consignes de sécurité dans le manuel d’utilisation
Rupture du ressort en charge | Projection violente | ++ | – | — Ressort dimensionné avec un coefficient de sécurité > 2 — Matériau durable — Carénage complet de la zone de compression
Désengagement de la clavette de l’arbre moteur | Panne mécanique | + | – | — Montage avec clavette normalisée — Contrôle des jeux fonctionnels selon ISO — Vérifications périodiques
Projection de balle non contrôlée | Projection violente ou désorientée | + | = | — Canal de tir fermé et guidé — Tests de trajectoire — Contrôle de la vitesse via compression du ressort
Blocage de la balle dans le lanceur | Dysfonctionnement | + | – | — Contrôle des tolérances d’usinage — Guides lissés

Blocage du mécanisme de rotation | Dysfonctionnement | ++ | = | — Lubrification régulière — Matériaux à faible coefficient de frottement — Ajustement précis des jeux
Basculement de la machine pendant l’utilisation | Instabilité de la structure | – | = | — Centre de gravité abaissé — Patins antidérapants — Répartition équilibrée des masses
Sur-vitesse de la manivelle | Usure prématurée | + | + | — Limitation manuelle — Consigne d’utilisation
Relâchement de la manivelle avant que la balle soit tirée | Retour violent de la manivelle | ++ | – | — Système de blocage, avec un cliquet
Mauvais repositionnement manuel entre deux tirs | Erreur de fonctionnement | + | – | — Ergonomie optimisée — Rétroaction visuelle et mécanique après chaque tir — Cadence limitée à 1 balle / 5 s

Légende : +++ très important, ++ important, + modérée, = moyen, - faible, – très faible

### 6 Usinage des pièces

Toutes les pièces de la machine peuvent être réalisées par un usinage avec une fraiseuse 3 axes, un tour à métaux pour les pièces de révolution et les trous sont réalisés par perçage.
Dans certains cas, on a privilégié un ensemble de plusieurs pièces simples plutôt qu’un usinage complexe d’une unique pièce. Le tableau suivant présente une synthèse des choix d’usinage, justifiés en fonction des matériaux sélectionnés pour chaque pièce.

Pièces | en
POM-H
Choix des outils | Utiliser des outils en carbure de tungstène spé-cialement conçus pour l’usinage des plastiques techniques.
Vitesse de coupe | Adopter une vitesse de coupe modérée afin d’évi-ter la fusion ou la déformation thermique du ma-tériau : — fraisage : 2000 à 4000 tr/min — tournage : 2000 à 3000 tr/min — perçage : 1500 à 3000 tr/min
Avance | Adapter l’avance pour éviter les échauffements excessifs et assurer une bonne qualité de sur-face : — fraisage : 0.05 à 0.25 mm/tour — tournage : 0.05 à 0.2 mm/tour — perçage : 0.05 à 0.1 mm/tour
Évacuation des co-peaux | Le POM produit des copeaux longs et fins sus-ceptibles de s’enrouler autour de l’outil, pertur-bant l’usinage. → Recommandation : utiliser un système d’as-piration ou un dispositif d’éjection efficace pour éviter l’accumulation.

Lubrification et re-froidissement

Le POM-H nécessite une lubrification soigneuse-ment choisie pour éviter toute dégradation chi-mique ou gonflement du matériau. Une lubrification efficace permet également de :
— Réduire la température en zone de coupe — Améliorer l’état de surface
— Prolonger la durée de vie des outils Lubrifiants recommandés :
— Huiles de coupe légères à base d’huile mi-nérale, sans additifs agressifs (ex : Mobil-met 426, Blasocut BC 20)
— Lubrifiants spécifiques pour plastiques (ex : Rocol, Accu-Lube)
À éviter :
— Huiles contenant des solvants chlorés ou des esters agressifs
— Lubrification excessive (gonflement, rési-dus collants)
Conseil pratique : tester toujours le lubrifiant sur échantillon avant production série.

Pièces | en
PTFE
Choix des outils | Utiliser des outils en carbure de tungstène, en raison de l’abrasivité modérée du PTFE et de sa faible rigidité. Les outils en acier rapide (HSS) s’usent trop rapidement.
Vitesse de coupe | Le PTFE a une faible conductivité thermique, ce qui favorise la surchauffe locale. Il est donc im-pératif de limiter la vitesse de coupe pour éviter la fusion du matériau : — fraisage : 1000 à 3000 tr/min — tournage : 500 à 2000 tr/min — perçage : 100 à 300 tr/min
Avance | Les avances doivent rester modérées afin d’éviter les déformations du matériau et d’assurer une bonne évacuation des copeaux : — fraisage : 0.05 à 0.2 mm/tour — tournage : 0.05 à 0.15 mm/tour — perçage : 0.05 à 0.15 mm/tour
Évacuation des co-peaux | Le PTFE génère des copeaux longs, fins et conti-nus, susceptibles de s’enrouler autour de l’outil, ce qui peut perturber l’usinage et provoquer une surchauffe locale. → Il est recommandé d’utiliser un système d’as-piration des copeaux ou un dispositif d’éjection pneumatique pour assurer une zone de coupe dé-gagée.
Lubrification et re-froidissement | Le PTFE étant autolubrifiant, l’utilisation de liquide de coupe n’est généralement pas néces-saire. Toutefois, en cas d’échauffement excessif : — Utiliser un air comprimé sec ou un brouillard d’huile neutre (sans solvants ni additifs corrosifs) pour éviter l’accumula-tion de chaleur. — Éviter l’eau ou les lubrifiants aqueux pou-vant entraîner un gonflement du polymère. — Ne pas utiliser de lubrifiants chlorés, in-compatibles avec le PTFE.

Pièces en PE-UHMW

Choix des outils | Utiliser des outils en carbure de tungstène.
Vitesse de coupe | Le PE-UHMW supporte des vitesses de coupe élevées, mais il fond facilement à cause de sa faible conductivité thermique. — fraisage : 1000 à 4000 tr/min — tournage : 800 à 2500 tr/min — perçage : 300 à 1000 tr/min
Avance | Les avances doivent rester modérées mais conti-nues, afin d’éviter les échauffements locaux et le gommage. — fraisage : 0.1 à 0.3 mm/tour — tournage : 0.1 à 0.25 mm/tour — perçage : 0.1 à 0.3 mm/tour
Évacuation des co-peaux | Le PE-UHMW produit des copeaux longs et souples, peu cassants. Il faut éviter qu’ils s’en-roulent autour de l’outil. → Il est recommandé d’utiliser un système d’as-piration des copeaux ou un dispositif d’éjection pneumatique pour assurer une zone de coupe dé-gagée.
Lubrification et re-froidissement | Le PE-UHMW est autolubrifiant, donc aucun liquide de coupe n’est nécessaire. En cas d’échauffement excessif : — Utiliser un air comprimé sec ou un brouillard d’huile neutre (sans solvant ni additifs corrosifs) pour éviter l’accumula-tion de chaleur. — Éviter l’eau ou les lubrifiants aqueux pou-vant entraîner un gonflement du polymère. — Ne pas utiliser de lubrifiants chlorés.

Pièces en Aluminium

Choix des outils | Utiliser des outils en carbure de tungstène ou en HSS revêtu (TiAlN, TiCN) pour une meilleure résistance à l’usure et à l’adhérence.
Vitesse de coupe | L’aluminium est un matériau ductile avec une excellente usinabilité. Il permet des vitesses de coupe élevées. — Fraisage : 3000 à 12000 tr/min — Tournage : 1000 à 5000 tr/min — Perçage : 1000 à 4000 tr/min
Avance | Ajuster l’avance en fonction de la rigidité de l’outil et du type d’usinage. — Fraisage : 0,05 à 0,3 mm/dent — Tournage : 0,05 à 0,4 mm/tour — Perçage : 0,05 à 0,3 mm/tour
Évacuation des co-peaux | L’aluminium génère des copeaux courts à moyens. Cependant, le collage peut entraîner des bourrages. → Prévoir une évacuation mécanique ou par air comprimé. Utiliser un outil à brise-copeaux si nécessaire.
Lubrification et re-froidissement | Recommandée pour éviter l’adhérence de l’alu-minium à l’outil et pour prolonger la durée de vie de celui-ci. Options : — Émulsion à base d’eau avec agents lubri-fiants — Huiles de coupe semi-synthétiques — En usinage à sec : air comprimé ou brouillard d’huile pour les opérations à grande vitesse

Pièces en Acier
(42CrMo4)
Choix des outils | Utiliser des outils en carbure de tungstène (re-vêtus si possible, type TiAlN) pour les pièces trempées ou traitées.
Vitesse de coupe | Dépend fortement de l’état (recuite, trempé ou revenu). À adapter selon la dureté du matériau : — Fraisage : 80 à 150 m/min — Tournage : 80 à 120 m/min — Perçage : 40 à 60 tr/min
Avance | Avance relativement faible à modérée pour li-miter les efforts de coupe tout en assurant une coupe franche (éviter le frottement pur). — Fraisage : 0.05 à 0.25 mm/dent — Tournage : 0.1 à 0.3 mm/tour — Perçage : 0.08 à 0.25 mm/tour
Évacuation des co-peaux | Le 42CrMo4 produit des copeaux courts et cas-sants (surtout après trempe). L’évacuation est facilitée mais il est conseillé d’utiliser une lubrification abondante pour évi-ter les échauffements et l’usure d’outil.
Lubrification et re-froidissement | L’utilisation de lubrifiant de coupe est fortement recommandée, surtout à l’état trempé. Utiliser : — Huile entière pour l’usinage lent et de pré-cision — Émulsion réfrigérante pour les opérations à grande vitesse

### 7 Procédures d’assemblage

### 7.1 Ajustements et Tolérancement

Pour les tolérances des L’ensemble des pièces non spécifiées sont soumises à la tolérance générale ISO 2768-mK, sauf le conteneur et la glissière, qui sont soumis à la tolérance ISO 2768-fH, en raison de leurs exigences de précision dimensionnelle plus strictes. Pour les tolérances des clavettes et des segments d’arrêt, nous nous sommes aidé des tableaux de tolérances de l’extrait de normes. On choisit un clavetage léger pour toutes nos clavette pour les raisons suivantes :
— montage et démontage facile
— ajustements précis

### 7.2 Tableau des ajustements

Pièce ou couple | Ajustement | Justification
Arbre 1 - roue dentée 1 Arbre 2 - roue dentée 2 Arbre 2 - roue dentée 3 Arbre 3 - roue dentée 4 | H8/k6 | — Jeu incertain (jeu ou très léger serrage) — Permet un montage à la main — Tolérance H8 imposée par le fournisseur — Liaison avec clavette — Montage démontable nécessitant un bon guidage — k6 garantit l’absence de jeu excessif
Arbre 1 - Roulement à bille 1 Arbre 1 - Roulement à bille 2 | H7/m6 | — L’arbre est en rotation : la bague intérieure tourne avec lui — Assemblable à la main — Bon centrage pour stabilité — Transmission du couple sans glissement — Vitesse normale sans sollicitation extrême
Arbre 2 - Palier lisse 1 Arbre 2 - Palier lisse 2 Arbre 3 - Palier lisse 3 Arbre 3 - Palier lisse 4 | H7/h6 | — Ajustement avec jeu léger contrôlé — Rotation fluide sans serrage — Montage facile sans contrainte — Favorise lubrification et limite l’usure — Recommandé par le fournisseur
Manivelle - Arbre 1 | H7/k6 | — Assemblable et démontable facilement — Sans jeu fonctionnel pour éviter les à-coups — Pas besoin de force importante
Tous les circlips - Tous les arbres | H9/h8 | — Ajustement avec jeu modéré — Montage facile du circlip — Positionnement radial précis

Tous les clavettes - Rainure arbre | N9/h9 | — Jeu fonctionnel maîtrisé — Montage sans forçage excessif
Glissière - Tube à balle | H7/k6 | — Serrage léger avec maintien fiable — Montage manuel possible avec marteau — Sans jeu fonctionnel, pas de vibrations
Capot arrière - Tube à balle | H7/k6 | — Serrage léger — Montage à la main — Démontable si nécessaire
Barre de lancement - Support à balle | H7/k6 | — Montage par serrage léger — Pose manuelle avec marteau — Maintien sans jeu, démontage sans outil
Cliquet - Arbre 4 | H7/f7 | — Jeu modéré — Montage à la main avec bon positionnement radial — Permet un léger déplacement du cliquet

### 7.3 Notice de Montage

Étape 1 : Insertion du ressort

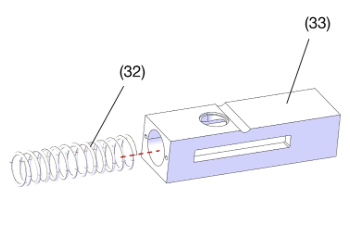
[picture p36: figure]

Insérer la pièce (32) dans le logement cylindrique de la pièce (33), en veillant à ce que le ressort soit correctement centré et non contraint.

Étape 2 : Fixation du support de balle

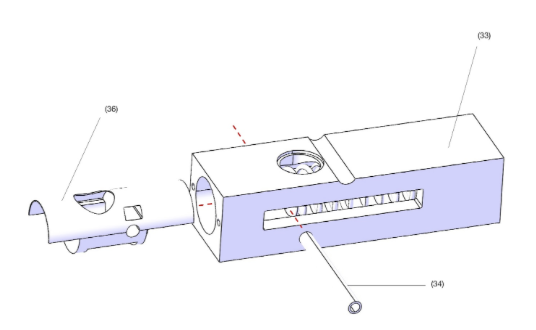
[picture p37: figure]

Insérer la pièce (36) dans la rainure latérale de la pièce (33), jusqu’à alignement complet du perçage axial. Ensuite, introduire (34) à l’aide d’un marteau, à travers les alésages traversants de
(33) et (36).

Étape 3 : Vissage des butées

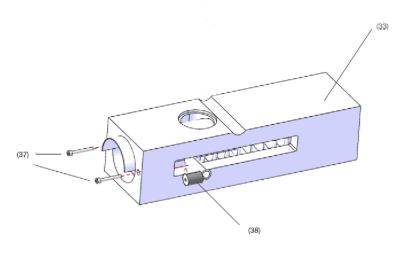
[picture p38: figure]

Positionner les butées (38)x2 de part et d’autre de la pièce (33), en alignant les perçages de fixation. Visser (37)x2 dans les taraudages prévus à cet effet sur la pièce (33).

Étape 4 : Assemblage arbre

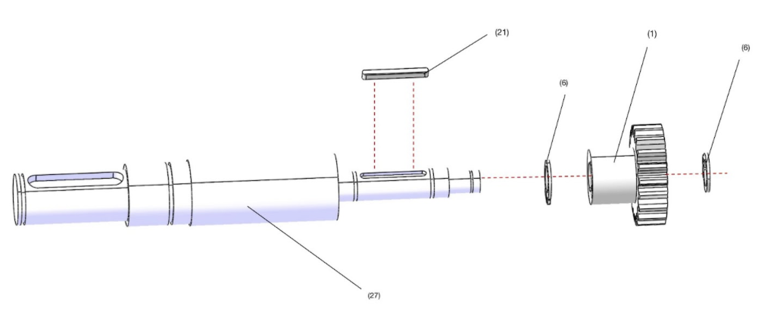
[picture p39: figure]

Assembler (6), puis (21) sur l’arbre (27), puis engager la roue dentée (1). Fixer l’ensemble à l’aide des circlips (6)x2.

Étape 5 : Assemblage arbre

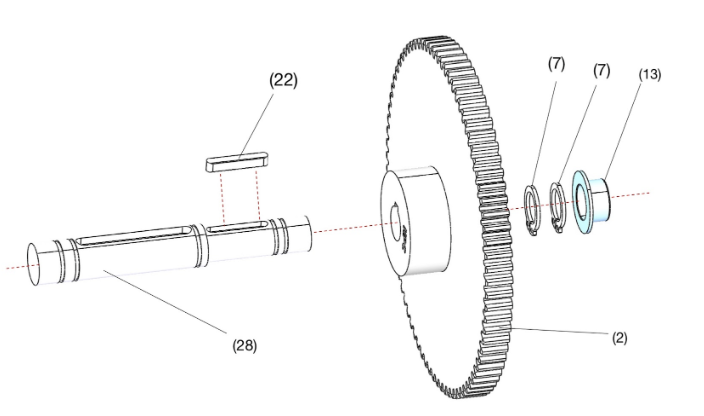
[picture p40: figure]

Monter (22) sur (28), puis insérez (2). Fixer le tout avec (7)×2 puis (13).

Étape 6 : Assemblage arbre

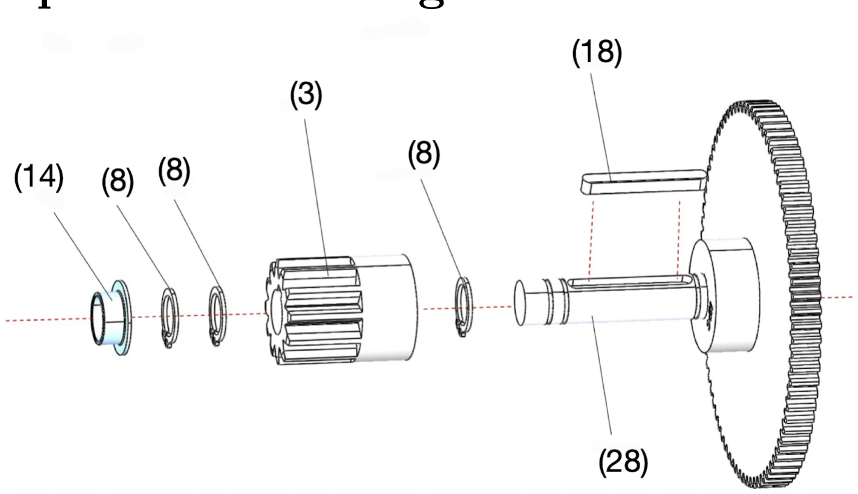
[picture p41: figure]

Monter (8) sur l’arbre (28), puis monter (18) dans la rainure. Engager la pièce (3), fixer l’ensemble avec les (8)×2, et avec (14).
Étape 7 : Fixation de la roue dentée

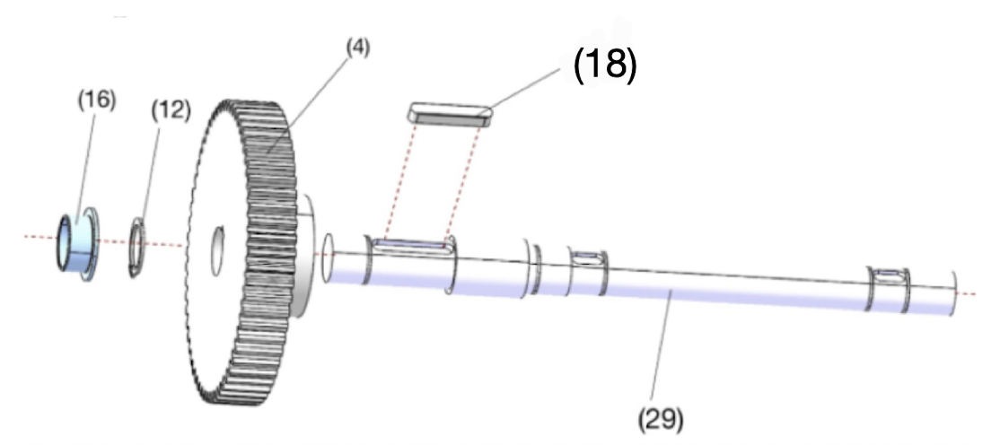
[picture p42: figure]

Insérer la clavette (18) dans la rainure de l’arbre (29), puis faire coulisser la roue dentée (4). Fixer l’ensemble avec (12), puis verrouiller avec (16).

Étape 8 : Insertion arbre dans la paroi

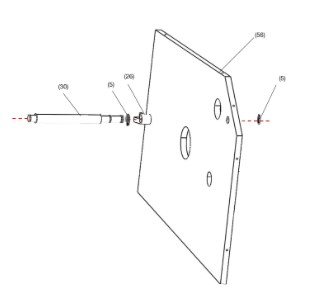
[picture p43: figure]

Insérer (5) et (26) successivement sur l’arbre (30), puis engager l’ensemble dans la plaque (58). Fixer avec (5)x2.

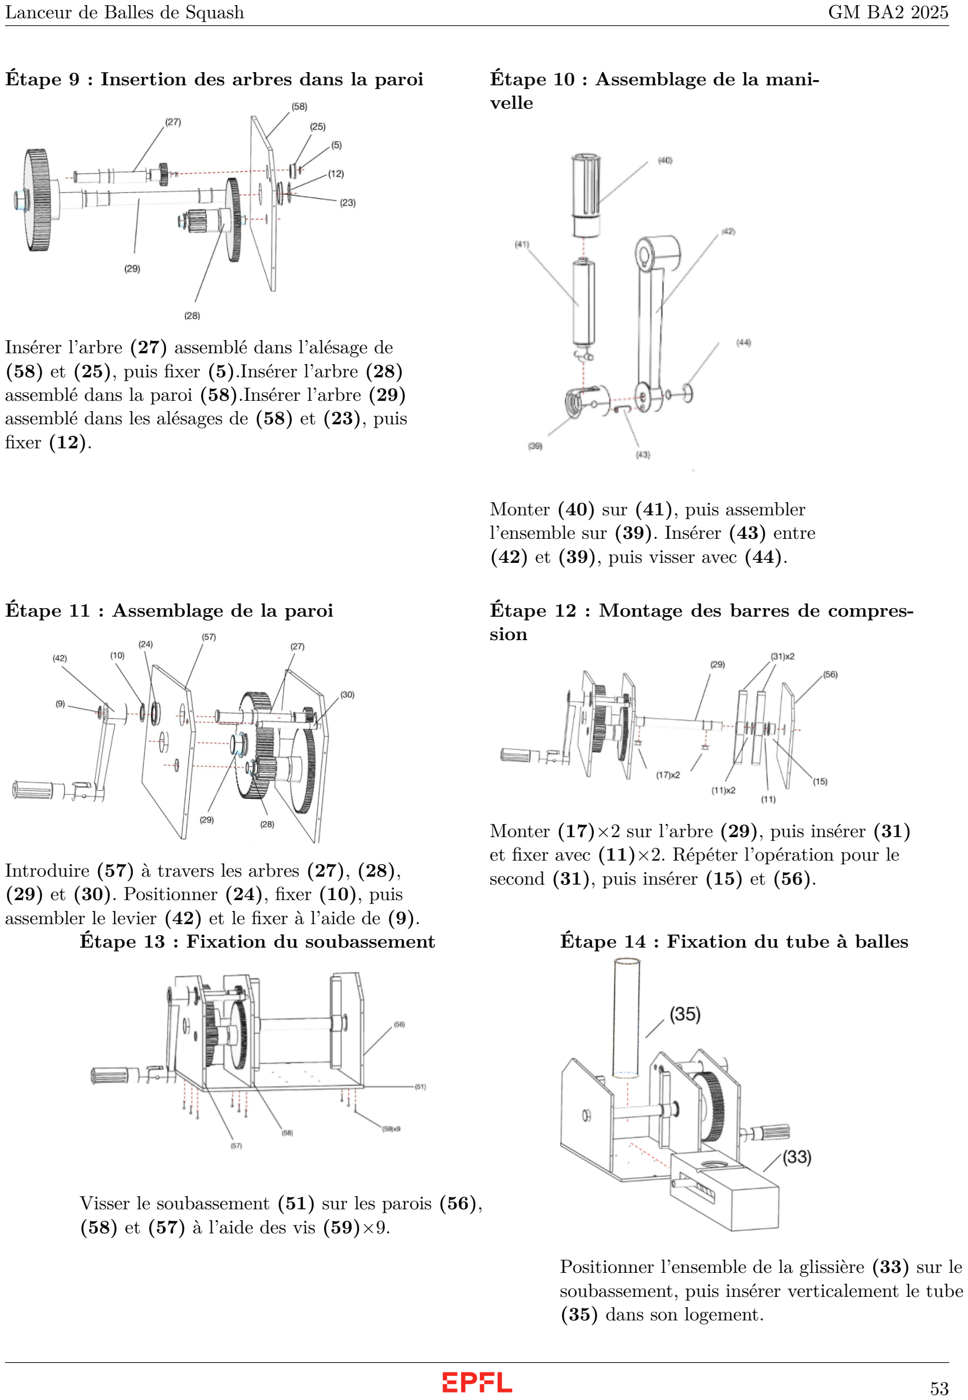
[picture p44: page 53]

Étape 9 : Insertion des arbres dans la paroi

Insérer l’arbre (27) assemblé dans l’alésage de
(58) et (25), puis fixer (5).Insérer l’arbre (28) assemblé dans la paroi (58).Insérer l’arbre (29) assemblé dans les alésages de (58) et (23), puis fixer (12).

Étape 10 : Assemblage de la manivelle

Monter (40) sur (41), puis assembler l’ensemble sur (39). Insérer (43) entre
(42) et (39), puis visser avec (44).

Étape 11 : Assemblage de la paroi

Introduire (57) à travers les arbres (27), (28),
(29) et (30). Positionner (24), fixer (10), puis assembler le levier (42) et le fixer à l’aide de (9).

Étape 12 : Montage des barres de compression

Monter (17)×2 sur l’arbre (29), puis insérer (31) et fixer avec (11)×2. Répéter l’opération pour le second (31), puis insérer (15) et (56).

Étape 13 : Fixation du soubassement

Visser le soubassement (51) sur les parois (56),
(58) et (57) à l’aide des vis (59)×9.

Étape 14 : Fixation du tube à balles

Positionner l’ensemble de la glissière (33) sur le soubassement, puis insérer verticalement le tube
(35) dans son logement.

Étape 15 : Fixation de la glissière

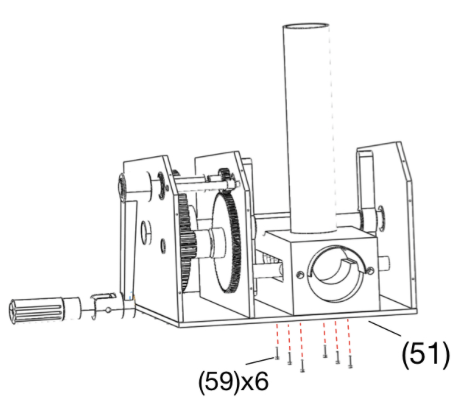
[picture p45: figure]

Visser (51) à l’aide des vis (59)x6.

Étape 16 : Fixation de la poignée

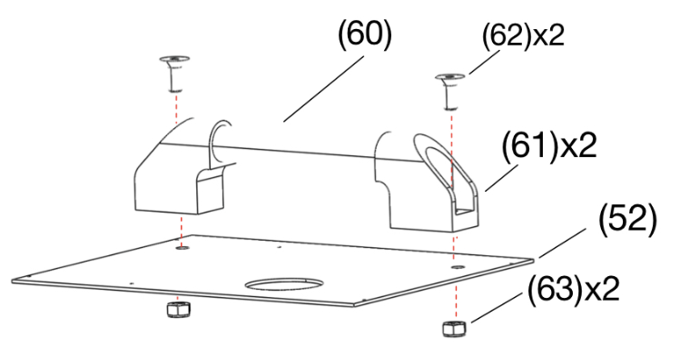
[picture p46: figure]

Insérer le tube (60) dans les épaules (62)x2. Positionner l’ensemble sur la plaque (52), visser (62)x2, puis serrer à l’aide des écrous (63).

Étape 17 : Fixation de la paroi et du capot

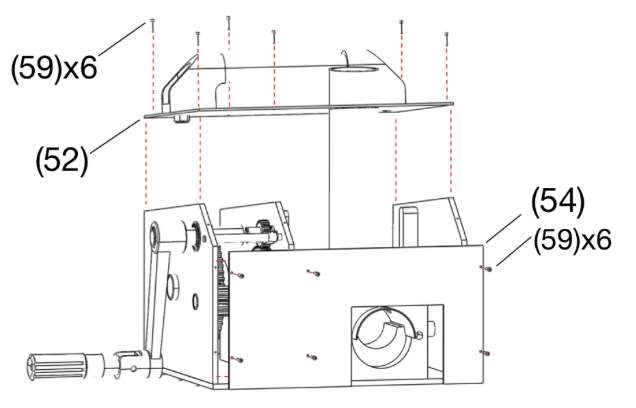
[picture p47: figure]

Positionner la paroi (54), visser les vis (59)x6. Enfin, placer le capot supérieur (52) et la fixer sur la structure (56) avec (59)x6.

Étape 18 : Fixation de la paroi et des patins

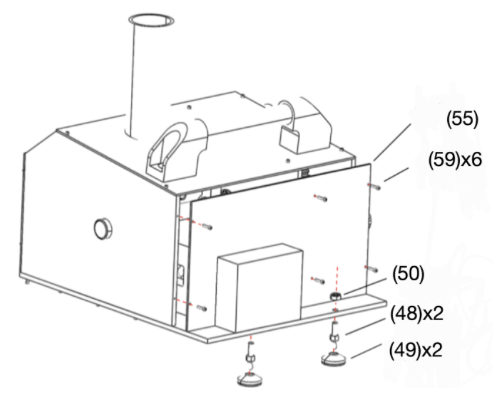
[picture p48: figure]

Fixer la paroi (55) à l’aide des vis (59)x6. Insérer les patins (48) dans les supports (49)x2, puis visser et serrer avec les écrous (50).
Étape 19 : Fixation du guide

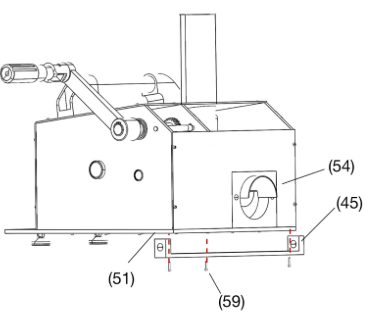
[picture p49: figure]

Positionner (45), puis la fixer sur les plaques (51) et (54) avec les vis (59)x2.

Étape 20 : Insertion du ressort

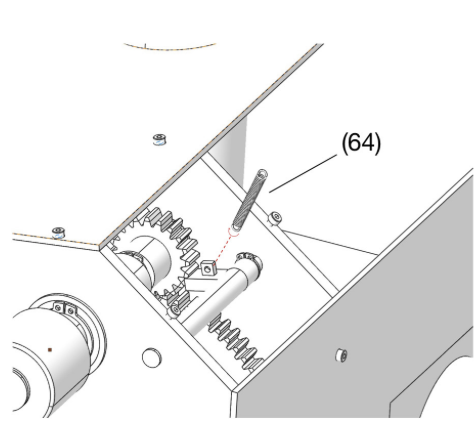
[picture p50: figure]

Insérer le ressort (64) verticalement dans son logement interne.

Étape 21 : Fixation du capot avant

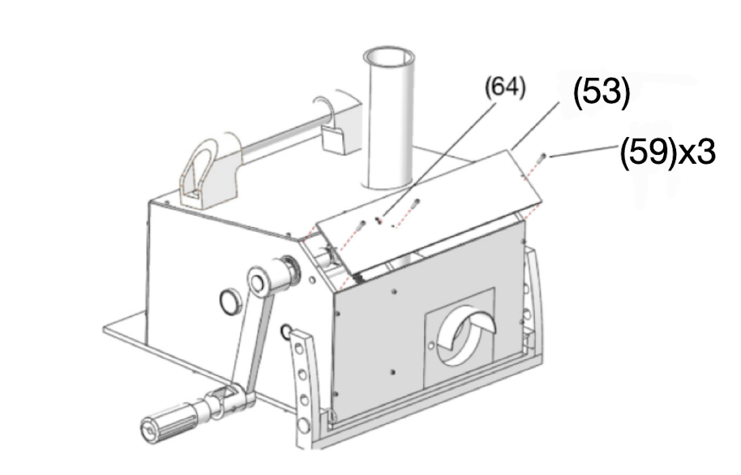
[picture p51: figure]

Attacher le ressort de traction (64) dans son logement, positionner le capot avant (53) sur la structure, puis le fixer à l’aide des vis (59)x3 dans les perçages prévus.

### 8 Mode d’emploi

### 8.1 Consignes de sécurité

Avant toute utilisation de cette machine à lancement manuel de balles de squash, il est indispensable de prendre connaissance des consignes de sécurité suivantes. Celles-ci visent à garantir la sécurité de l’utilisateur, la durabilité du système, et à éviter tout risque corporel ou matériel.
Veuillez lire attentivement et respecter les recommandations ci-dessous :
1. Lire attentivement ce manuel
Ce document constitue la référence officielle pour l’utilisation du lanceur. Il décrit le fonctionnement mécanique, les limites techniques et les précautions à prendre. Ne pas respecter ces consignes pourrait entraîner un risque de blessure ou de détérioration du système.
2. Utilisation par un adulte uniquement
Le dispositif est conçu pour être utilisé par un opérateur unique, adulte, disposant d’une force et d’une coordination suffisantes. L’utilisation est ambidextre (main gauche ou droite), mais nécessite que l’autre main serve à stabiliser ou guider la machine.
3. Zone de sécurité
Le système propulse les balles à des vitesses pouvant atteindre 90 km/h. Il est strictement interdit de se tenir dans l’axe de tir. Assurez-vous qu’aucune personne, animal ou objet fragile ne se trouve dans la zone de projection.
4. Stabilité de l’appareil
Installez la machine exclusivement sur une surface plane, sèche, rigide et horizontale. L’usage sur un sol meuble, en pente ou glissant est interdit. La stabilité est une condition essentielle pour la précision, la sécurité et la durabilité du système.
5. Ne jamais intervenir pendant le fonctionnement
N’introduisez jamais vos mains à proximité des engrenages, de la manivelle ou des barres de compression lorsqu’un cycle est en cours. Même à faible vitesse, les pièces mécaniques peuvent provoquer pincement, contusion ou sectionnement.
6. Respect strict de la capacité de chargement
Le réservoir ne doit contenir que 5 balles de squash standard (diamètre 40 mm, masse 25 g). L’usage de balles non conformes ou le dépassement de cette limite peut entraîner un blocage, une usure prématurée ou une rupture mécanique.
7. Entretien régulier et préventif
Avant chaque session, vérifiez visuellement :
— la fixation des éléments mécaniques,

— l’absence de fissures ou d’usure sur les pièces mobiles — la propreté du canal de tir.

Prévention :
— Transport manuel à deux mains
— Ne pas faire tomber ou heurter la machine
— Stockage dans un environnement sec et à l’abri du gel
— Ne pas exposer à l’humidité ou à la chaleur (> 50°C)

Toute anomalie doit être signalée et corrigée avant une nouvelle utilisation.

### 8.2 Notice d’utilisation – Machine de lancement mécanique de balles de squash

### 1. Introduction

Cette notice a pour objectif de fournir à l’utilisateur toutes les informations nécessaires pour une utilisation sûre, efficace et conforme de la machine de lancement de balle de squash.

### 2. Identification de la machine

— Nom commercial : Lanceur mécanique de balle de squash — Type : Appareil d’entraînement manuel

### 3. Installation et mise en service

— Placer la machine sur un support rigide, plat et stable (table, banc, ou support adapté) — Vérifier que la machine ne peut pas basculer.
— Contrôler visuellement les éléments suivants avant utilisation :
— L’état de la manivelle (absence de jeu, déformation ou desserrage)
— L’alignement des axes et des goupilles de fixation
— Le ressort de compression : il doit être en position détendue
— Attention au système de sécurité par cliquet
— En cas de relâchement intempestif de la manivelle avant la fin du cycle, un cliquet interne bloque la transmission en rotation inverse afin d’éviter un retour brutal.
— Si le ressort est déjà comprimé au démarrage, cela signifie que la manivelle a été relâchée en cours de cycle.
— Que faire si le ressort est déjà en position comprimée ?
— Observer la position du ressort.
— Si l’insertion des balles dans le tube est impossible, cela indique uneprécompression excessive. Dans ce cas :
a. Dévisser le capot avant avec précaution.
b. Retirer manuellement le cliquet engagé dans l’engrenage.
c. Maintenir fermement la manivelle pour éviter un retour violent, et relâcher doucement le mécanisme.
Une fois l’ensemble relâché et revenu en position initiale, reviser le capot, verrouiller et procéder à une utilisation normale.
— Dans le cas contraire, procédez à l’utilisation normale de la machine.

### 4. Fonctionnement

### 4.1 Réglage de l’inclinaison

1. Faire dépasser la machine du support de quelques centimètres afin de pouvoir régler l’inclinaison indi-viduellement, et facilement.

2. Retirer la goupille fendue et la goupille de blocage du support angulaire.

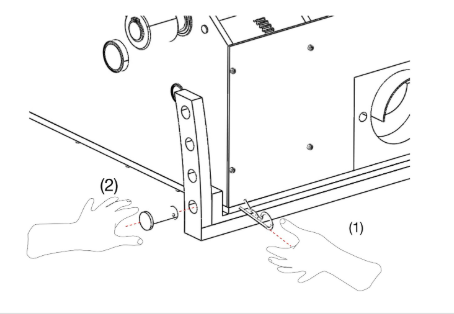
[picture p52: figure]

Figure 31 – Montage des goupilles.

3. Soulever ou abaisser la machine via la poignée supérieure.
4. Positionner la machine à l’un des 3 angles disponibles : 5°, 10° ou 15°.

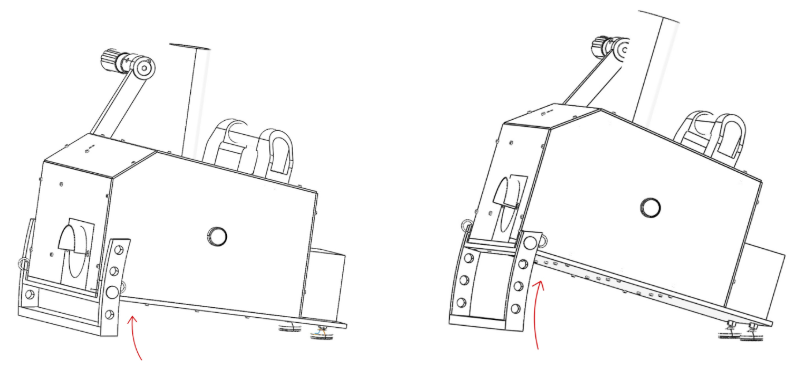
[picture p53: figure]

Figure 32 – Différents angles d’inclinaison.

5. Réinsérer les goupilles dans le trou correspondant au cran.

### 4.2 Chargement des balles

1. Insérer manuellement 5 balles de squash standard (Ø 40 mm, 25 g), une par une, dans le tube. ATTENTION : Utilisation en salle de squash uniquement
2. Veiller à ne pas forcer.
3. Vérifier qu’elles sont bien alignées.

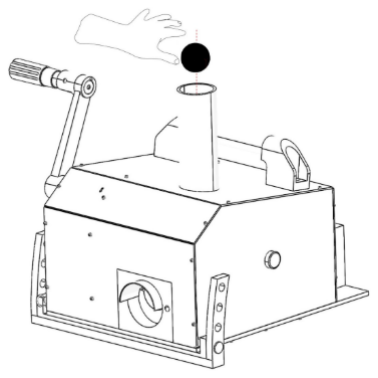
[picture p54: figure]

Figure 33 – Différents angles d’inclinaison.

### 4.3 Mise en marche (système à manivelle)

1. Se placer latéralement à la machine.
2. Saisir la manivelle fermement d’une main.

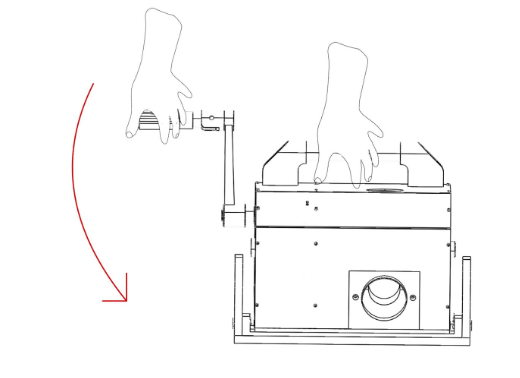
[picture p55: figure]

Figure 34 – Utilisation de la manivelle.

3. Stabiliser la machine avec l’autre main, en positionnant sa main sur la poignée du dessus.
4. Tourner la manivelle à vitesse constante ( 2 tours/seconde).

ATTENTION : afin d’assurer le bon fonctionnement des différents mécanismes, veuillez tourner de façon constante de 2 tours par seconde.

5. La balle est propulsée dès la première compression.

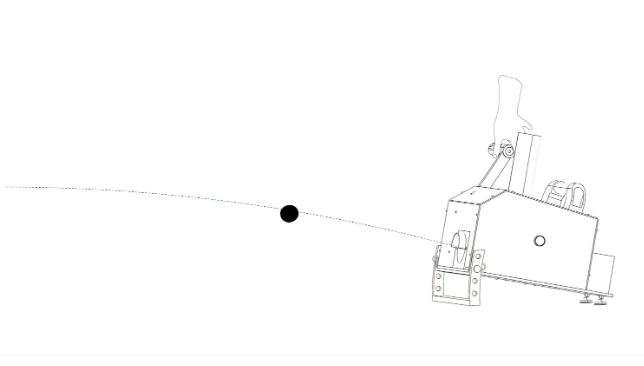
[picture p56: figure]

Figure 35 – Lancement de la balle.

6. Continuer jusqu’au lancement des 5 balles.

ATTENTION : Ne pas inverser le sens de rotation.
ATTENTION : Tourner de façon régulière et fluide pour éviter les à-coups

### 4.4 Fin de session

1. Arrêter de tourner la manivelle dès le lancement de la dernière balle
2. N’inversez jamais le sens de rotation après un cycle.
3. Recommencer en revenant à l’étape de chargement.

### 5. Entretien et maintenance

1. Nettoyer à l’aide d’un chiffon sec ou légèrement humide

Fréquence | Action
À chaque usage | Vérifier absence de fissure, corrosion, jeu
Hebdomadaire | Nettoyer le tube et la zone de contact des balles
Mensuelle | Graissage des roues dentée si nécessaire.

Table 12 – Plan de maintenance de la machine

2. Ne jamais immerger
3. Ne pas utiliser de solvants agressifs
4. Stocker à l’abri de l’humidité.

### 6. Fin de vie et mise au rebut

1. Démonter les éléments.
2. Séparer les métaux et les plastiques
3. Apporter en déchetterie spécialisée

### 9 Conclusions

### 9.1 Conformité solution et cahier des charges

Pour conclure ce rapport, commençons par faire un bilan des contraintes énoncées dans le cahier des charges et déterminons si nous avons répondu à ces contraintes ou non.

Nom des contraintes | Spécifications du cahier des charges | Résultats de notre machine
Réservoir de balles | Contient exactement 5 balles de squash
Lancement en continu | L’utilisateur doit pouvoir lancer les 5 balles d’affilée
Utilisation manuelle | Actionnée par un opérateur unique (droitier ou gaucher), avec une seule main | Manivelle ambidextre
Cadence de tir | Minimum 1 balle toutes les 5 se-condes | 1 balle toutes les 5 se-condes
Vitesse de tir | Vitesse des balles en sortie entre 80 km/h et 130 km/h | 90 km/h
Compacité | Machine aussi compacte que pos-sible
Poids maximal | Poids maximal de 15 kg sans balles | 10.485 kg
Sécurité opérateur | Aucune blessure, sécurité assurée même en conditions normales d’uti-lisation

Table 13 – Tableau de validation des contraintes techniques

### 9.2 Compétences acquises et Remerciements

Ce premier projet de construction mécanique fut une immersion intense et formatrice dans les exigences du métier d’ingénieur. Durant 14 semaines, nous avons été confrontés aux enjeux réels de la conception, de la fabrication, de la validation expérimentale, et surtout à l’importance du travail rigoureux en équipe. Ce projet nous a permis de tisser un lien fort entre les enseignements théoriques et leur application concrète, à travers chaque étape – de l’idée initiale au prototype fonctionnel.
Nous tenons à exprimer notre sincère reconnaissance à l’ensemble de l’équipe pédagogique du cours de Construction Mécanique I et II pour avoir encadré, guidé et challengé nos efforts avec exigence et bien-veillance.
Nos remerciements vont en particulier à :
— Monsieur Sébastien Soubielle et Monsieur Bertrand Lacour, responsables du cours, pour la clarté de leur enseignement et leur disponibilité tout au long du semestre,
— Toute l’équipe d’assistants présente dans les salles C05 pour leur soutien pratique,
— Et tout spécialement à Joseph Prieur pour son accompagnement technique, sa pédagogie patiente et ses conseils précieux lors des phases critiques du projet.
Nous souhaitons également adresser nos remerciements les plus chaleureux au club Squash Lausanne (Rue du Chêne 9, 1020 Renens), qui a généreusement mis à notre disposition différents types de balles de squash (neuves, usées, à différents niveaux d’usure). Cette contribution a été essentielle pour tester et valider notre système de lancement notamment pour l’arrivée des balles, en conditions réalistes.
Enfin, ce projet aura marqué une étape importante dans notre formation : celle du passage progressif de l’étudiant au futur ingénieur.

### 10 Annexes

### 10.1 Listes des Composants

### A. Système de transmission : 51 pièces

N° Nom de la
pièce

Fournisseur /
Usinée
Référence | Qté | Matériau | Matériau Catia Equivalent

Schéma

001 | Roue dentée 1 | HPC / Calvette
Usinée

HPC /
G1_25_20
| | 1 | Acier 20NCD2 | Acier allié, 17CrNIMo6
002 | Roue dentée 2 | HPC / Calvette
Usinée | HPC / G1_25_80 | 1 | Acier 20NCD2 | Acier allié, 17CrNIMo6
003 | Roue dentée 3 | HPC / Calvette
Usinée | HPC / G2_12 | 1 | Acier 20NCD2 | Acier allié, 17CrNIMo6
004 | Roue dentée 4 | HPC / Calvette
Usinée | HPC / G2_60 | 1 | Acier 20NCD2 | Acier allié, 17CrNIMo6
005 | Circlip DIN 471
D6mm
Kipp | K1938.060701 | 1 | Acier inox. 1.4122 | Acier, X20 Cr13
006 | Circlip DIN 417
D8mm
Kipp | K1938.080801 | 3 | Acier inox. 1.4122 | Acier, X20 Cr13
007 | Circlip DIN 417
D10mm
Kipp | K1938.101001 | 2 | Acier inox. 1.4122 | Acier, X20 Cr13
008 | Circlip DIN 417
D12mm
Kipp | K1938.121001 | 3 | Acier inox. 1.4122 | Acier, X20 Cr13
009 | Circlip DIN 417
D14mm
Kipp | K1938.141001 | 1 | Acier inox. 1.4122 | Acier, X20 Cr13
010 | Circlip DIN 417
D17mm
Kipp | K1938.171001 | 1 | Acier inox. 1.4122 | Acier, X20 Cr13
011 | Circlip DIN 417
D18mm
Kipp | K1938.181201 | 3 | Acier inox. 1.4122 | Acier, X20 Cr13
012 | Circlip DIN 417
D20mm
Kipp | K1938.201201 | 2 | Acier inox. 1.4122 | Acier, X20 Cr13
013 | Palier lisse D int
10mm
GGB by Timken | BB1007EP63 | 1 | EP63 | Acier, X20 Cr13
014 | Palier lisse D int
12mm
GGB by Timken | BB1207EP63 | 1 | EP63 | Acier, X20 Cr13
015 | Palier lisse D int
18mm
GGB by Timken | BB1812EP63 | 1 | EP63 | Acier, X20 Cr13
016 | Palier lisse D int
20mm
GGB by Timken | BB2012EP63 | 1 | EP63 | Acier, X20 Cr13
017 | Clavette DIN
6885 6x6x14
MSUMI | KESF6-14 | 2 | EN 1.1191 | Acier, X20 Cr13
018 | Clavette DIN
6885 6x6x34
MSUMI | KESF6-34 | 1 | EN 1.1191 | Acier, X20 Cr13
019 | Clavette DIN
6885 4x4x34
MSUMI | KESF4-34 | 1 | EN 1.1191 | Acier, X20 Cr13
020 | Clavette DIN
6885 5x5x26
MSUMI | KESF5-26 | 1 | EN 1.1191 | Acier, X20 Cr13
021 | Clavette DIN
6885 2x2x18
MSUMI | KESF2-18 | 1 | EN 1.1191 | Acier, X20 Cr13
022 | Clavette DIN
6885 3x3x18
MSUMI | KESF3-18 | 1 | EN 1.1191 | Acier, X20 Cr13

N° Nom de la
pièce

Fournisseur /
Usinée
Référence | Qté | Matériau | Matériau Catia Equivalent

Schéma

023 Roulement à bille
d20
MSUMI | FL6704ZZ | 1 | EN 1.3505 | Acier, X20 Cr13
024 | Roulement à bille
d17
MSUMI | FL6703ZZ | 1 | EN 1.3505 | Acier, X20 Cr13
025 | Roulement à bille
d6
MSUMI | FL606ZZ | 1 | EN 1.3505 | Acier, X20 Cr13
026 | Cliquet | Usinée | Usinée | 1 | Acier, X20 Cr13 | Acier, X20 Cr13
027 | Arbre 1 | Usinée | Usinée | 1 | Acier à haute résistance 42CrMo4 | Acier à haute résistance 42CrMo4
028 | Arbre 2 | Usinée | Usinée | 1 | Acier à haute résistance 42CrMo4 | Acier à haute résistance 42CrMo4
029 | Arbre 3 | Usinée | Usinée | 1 | Acier à haute résistance 42CrMo4 | Acier à haute résistance 42CrMo4
030 | Arbre 4 | Usinée | Usinée | 1 | Acier à haute résistance 42CrMo4 | Acier à haute résistance 42CrMo4
031 | Barre de compression | Usinée | Usinée | 2 | Acier Inoxydable EN 1.4301 | Acier Inoxydable EN 1.4301

### B. Système de Lancement : 9 pièces

N° Nom de la
pièce

Fournisseur /
Usinée
Référence | Qté | Matériau | Matériau Catia Equivalent

Schéma

032 Ressort de
compression

SODEMANN
RESSORT
13950 | 1 | Corde à piano | Corde à piano
033 | Glissière | Usinée | Usinée | 1 | PE-UHMW | PE-UHMW
034 | Barre de lancement | Usinée | Usinée | 1 | POM-H | POM-H
035 | Tube à balle | Usinée | Usinée | 1 | PE-UHMW | PE-UHMW
036 | Support à balles | Usinée | Usinée | 1 | PE-UHMW | PE-UHMW
037 | Vis t cy 6pc M4 L30 | MISUMI | SCB4-30 | 2 | EN 1.4301 | Acier Inoxydable, EN 1.4401
038 | Butée antivibration- DVA.5-15-20-M4-
| 55 | elesa | 413051 | 2 | caoutchouc naturel NR | ADIPRENE 97 SH A

### C. Manivelle : 6 pièces

N° Nom de la
pièce

Fournisseur /
Usinée
Référence | Qté | Matériau | Matériau Catia Equivalent

Schéma

039 | Lien manivelle | Kipp | K0997.13146 | 1 | NON-DIT | Aluminium, EN AW- AlSi1MgMN T6
040 | Poignée manivelle | Kipp | K0997.13146 | 1 | Thermoplastique | Polyamide PA6
041 | Sous poignée | Kipp | K0997.13146 | 1 | Aluminium | Aluminium, EN AW-AlSi1MgMN T6
042 | Bras manivelle | Kipp | K0997.13146 | 1 | Aluminium | Aluminium, EN AW-AlSi1MgMN T6
043 | Goupille | Kipp | K0997.13146 | 1 | NON-DIT | Acier, X20 Cr13
044 | Vis conique M8 | Kipp | K0997.13146 | 1 | NON-DIT | Acier, X20 Cr13

### D. Mécanisme d’inclinaison : 10 pièces

N° | Nom de la pièce | Fournisseur / Usinée | Référence | Qté | Matériau | Matériau Catia Equivalent
Schéma
045 | Support angulaire
| 1 | Usinée | Usinée | 1 | Acier à haute résistance 42CrMo4 | Acier à haute résistance 42CrMo4
046 | Support angulaire
| 2 | Usinée | Usinée | 1 | Acier à haute résistance 42CrMo4 | Acier à haute résistance 42CrMo4
047 | Goupille | Usinée | Usinée | 1 | Acier, X20 Cr13 | Acier, X20 Cr13
047.5 | Goupille fendue | Dongguan Forrun Hardware Co., Ltd. | FYRNPN10 | 2 | SWRH6 Carbon Wire Steel | X20 CR13
048 | Rotule à vis M6
L14
MISUMI | FJRP6 | 2 | EN 1.4301 | Acier, X20 Cr13
049 | Ventouse | MISUMI | FJRP6 | 2 | Polyamide | Acier, X20 Cr13
050 | Écrou en U M6 | MISUMI | PACK-UNUTK6 | 1 | EN 1.4319 | Acier, X20 Cr13

### E. Châssis : 58 pièces

N° Nom de la
pièce

Fournisseur /
Usinée
Référence | Qté | Matériau | Matériau Catia Equivalent

Schéma

051 | Soubassement | Usinée | Usinée | 1 | Aluminium EN–AW AlSiMgMn T6 | Aluminium EN–AW AlSiMgMn T6
052 | Capot arrière | Usinée | Usinée | 1 | POM-H | POM-H
053 | Capot avant | Usinée | Usinée | 1 | POM-H | POM-H
054 | Paroi avant | Usinée | Usinée | 1 | POM-H | POM-H
055 | Paroi arrière | Usinée | Usinée | 1 | POM-H | POM-H
056 | Paroi droite | Usinée | Usinée | 1 | Aluminium EN–AW AlSiMgMn T6 | Aluminium EN–AW AlSiMgMn T6
057 | Paroi gauche | Usinée | Usinée | 1 | Aluminium EN–AW AlSiMgMn T6 | Aluminium EN–AW AlSiMgMn T6
058 | Paroi milieu | Usinée | Usinée | 1 | Aluminium EN–AW AlSiMgMn T6 | Aluminium EN–AW AlSiMgMn T6
059 | Vis t cy 6pc M2 L10 | MISUMI | SCB4-14 | 39 | EN 1.4301 | Acier Inoxydable, EN 1.4301
060 | Barre poignée | MISUMI | UWAP N200 | 1 | EN AW-6063 | Aluminium EN–AW AlSiMgMn
061 | Epaule poignée | MISUMI | UWAP N200 | 2 | Nylon renforcé à la fibre de verre
POM-H
062 | Ecrou en U M8 | MISUMI | PACK-UNUT K8 | 2 | EN 1.4319 | Acier Inoxydable, EN 1.4301
063 | Vis conique M8 L20 | MISUMI | PACK-SFB8-20 | 2 | EN 1.4301 | Acier Inoxydable, EN 1.4301
064 | Ressort cliquet | SCHWEIZER | ZF-1147 | 1 | Spring steel | Acier Inoxydable, EN 1.4301
065 | Rondelle M8 | MISUMI | PWF8 | 2 | EN 1.0330 | Acier Inoxydable, EN 1.4301
066 | Rondelle M6 | MISUMI | PWF6 | 1 | EN 1.0330 | Acier Inoxydable, EN 1.4301

### 10.2 Feuilles de calculs

Dans le cadre du dimensionnement du système de propulsion, une feuille de calcul a été élaborée afin d’évaluer et comparer plusieurs configurations de ressorts. L’objectif principal était de s’assurer que le ressort sélectionné soit capable de stocker suffisamment d’énergie pour propulser une balle à la vitesse ciblé. Le ressort sélectionné a été surligné en rouge.

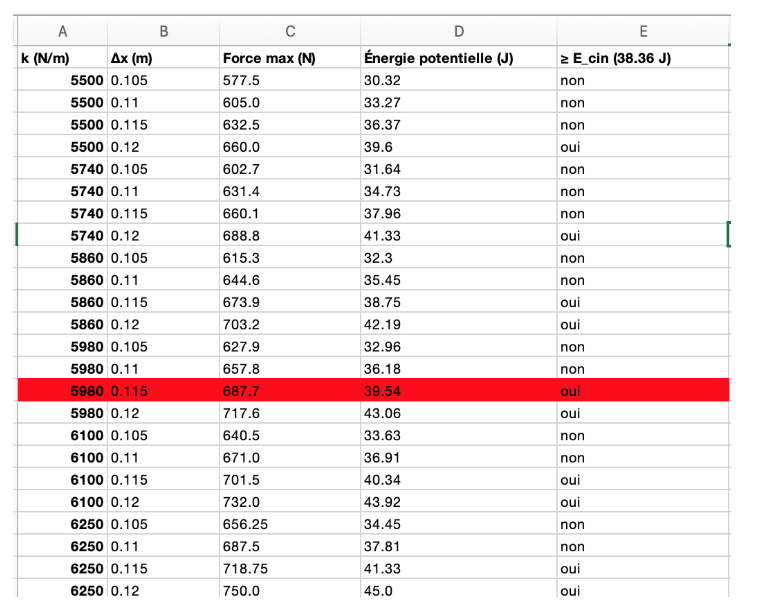
[picture p57: figure]

Figure 36 – Feuille de calcul de la force max du ressort et de son énergie potentielle.

### 10.3 Premières Expériences

Étude de faisabilité du mouvement manuel dans le cadre du projet de lanceur de balle de squash

Dans le cadre de notre projet, nous avons réalisé une étude expérimentale visant à valider la faisabilité d’un entraînement manuel par manivelle. L’objectif principal était de démontrer que faire tourner une manivelle avec une charge équivalente à un poids de 2 kg, à une fréquence de 2 tours par seconde, est un effort à la fois réaliste et non contraignant pour l’utilisateur.

Méthodologie expérimentale

L’expérimentation s’est déroulée en salle de sport, où nous avons enregistré en vidéo le mouvement de rotation d’un poids de 2 kg décrivant une trajectoire circulaire de rayon d’environ 12,5 cm, soit le rayon représentatif de la manivelle prévue dans notre système.
Ce mouvement a été analysé à l’aide du logiciel NewMeca, permettant un pointage précis de la position du poids à intervalles réguliers. Une rotation complète a été capturée sur une durée d’environ 0,5 seconde, ce qui correspond exactement à un tour complet à la fréquence cible de 2 tours par seconde.
Les positions mesurées ont ensuite été analysées afin de vérifier la cohérence de la trajectoire avec un mouvement circulaire uniforme, tel que requis pour l’utilisation de notre système.

Temps (s) | Position horizontale (m) | Position verticale (m)
0,000 | -0,149 | 0,066
0,033 | -0,121 | 0,141
0,067 | -0,053 | 0,184
0,100 | 0,037 | 0,200
0,133 | 0,121 | 0,178
0,167 | 0,180 | 0,128
0,200 | 0,211 | 0,075
0,233 | 0,230 | 0,004
0,267 | 0,230 | -0,039
0,300 | 0,214 | -0,083
0,333 | 0,180 | -0,133
0,367 | 0,121 | -0,164
0,400 | 0,031 | -0,176
0,433 | -0,078 | -0,148
0,467 | -0,115 | -0,086
0,500 | -0,149 | -0,039
0,533 | -0,155 | 0,007
0,567 | -0,155 | 0,063

Table 14 – Tableau du pointage

Les résultats montrent que la trajectoire décrite par le point repéré sur la manivelle est bien compatible avec un mouvement circulaire de rayon 12,5 cm à 2 tours par seconde. De plus, l’effort requis pour maintenir ce rythme pendant une courte durée est modéré. Aucun signe de fatigue excessive n’a été observé lors des tests utilisateurs. Il est également important de noter que dans notre configuration finale, la manivelle guidera mécaniquement le mouvement, ce qui réduira davantage l’effort demandé par rapport à l’exercice libre réalisé dans cette expérience. Par ailleurs, le temps d’utilisation continue de la manivelle reste limité : environ 30 secondes, soit la durée nécessaire pour lancer 5 balles avant de recharger le système.

Conclusion

Cette expérience confirme que l’utilisation d’un entraînement manuel par manivelle dans notre système de lancement est à la fois pratique, ergonomique et soutenable, même avec une charge équivalente à 2 kg. Elle valide ainsi une partie essentielle de la conception mécanique du projet, en assurant que l’effort demandé à l’utilisateur reste compatible avec un usage répété et non contraignant.

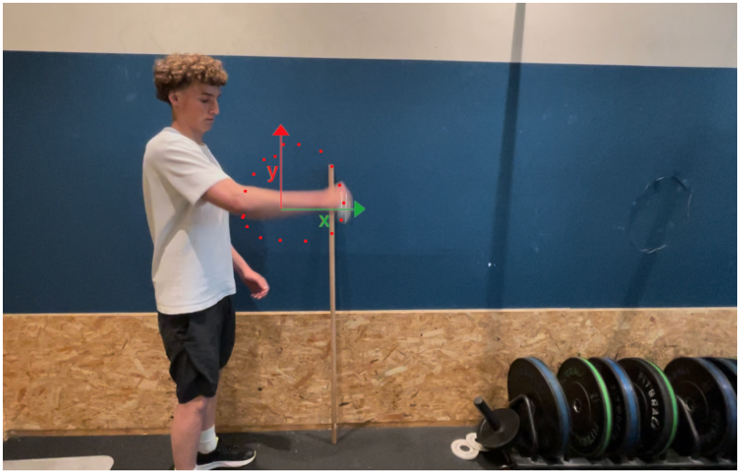
[picture p58: figure]

Figure 37 – Pointage de l’enregistrement du mouvement de rotation de la manivelle.

Étude de faisabilité de système de chargement des balles de squash

Étude d’un mécanisme à came

Dans un premier temps, nous avons envisagé l’utilisation d’une came rotative montée sur un arbre, conçue de manière à libérer une balle de squash via un orifice précisément dimensionné. Le système a été conceptualisé pour que la balle puisse passer uniquement lorsque la came atteint un certain angle.
Cependant, après plusieurs discussions techniques avec les assistants encadrants et une série de tentatives de modélisation, il s’est avéré complexe de démontrer théoriquement le bon fonctionnement du mécanisme. En effet, nous avons constaté que de très faibles variations d’angle entraînent un comportement non déter-ministe : dans certains cas, la balle pouvait passer, alors qu’une légère variation empêchait complètement son passage, malgré des dimensions strictement ajustées.

Afin de lever toute ambiguïté, nous avons décidé de prototyper la pièce par impression 3D et de mener une série d’essais expérimentaux. Les tests ont confirmé nos doutes : la sensibilité du mécanisme à de petites variations d’angle rend son fonctionnement peu fiable.
En conclusion, malgré l’intérêt mécanique du concept, nous avons choisi de ne pas retenir ce système afin d’éviter les risques d’instabilité ou de blocage lors de l’utilisation réelle.

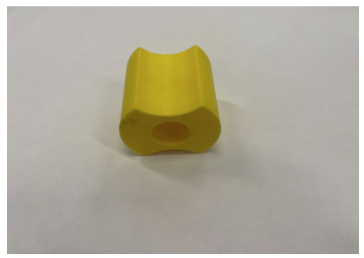
[picture p59: figure]

Figure 38 – Came imprimer en 3D.

Étude et validation d’un mécanisme de tube pour les balle

Dans un second temps, nous avons envisagé un mécanisme de chargement alternatif, reposant sur un prin-cipe gravitationnel, beaucoup plus simple que le système précédent. Cette solution présente l’avantage de supprimer la nécessité d’un arbre de transmission et d’un mécanisme rotatif complexe.
Le fonctionnement repose sur un tube vertical contenant cinq balles de squash. Lors de la compression d’un ressort, un petit orifice ménagé dans une plaque située au-dessus du ressort s’aligne temporairement avec la base du tube, permettant ainsi à une seule balle de tomber par gravité dans la chambre de lancement. Cependant, des préoccupations sont apparues quant à la nature du matériau des balles de squash, généralement composé de caoutchouc naturel ou synthétique, qui présente un coefficient de frottement statique élevé. Ce frottement important pourrait gêner le déplacement fluide de la balle lors de la compression du ressort, voire bloquer le système.
Pour atténuer ce risque, nous avons utilisé un matériau à très faible friction au niveau de la zone de contact entre la balle et la plaque mobile : le polyéthylène ultra-haute masse moléculaire (PE-UHMW), connu pour ses excellentes propriétés de glissement.
Afin de valider expérimentalement cette approche, nous avons reproduit le phénomène à petite échelle. Une balle de squash a été placée dans un tube reposant sur une feuille A4, simulant la plaque mobile. En tirant la feuille de manière horizontale, nous avons pu observer que la balle chute librement, démontrant ainsi la faisabilité du système gravitationnel dans des conditions réalistes.

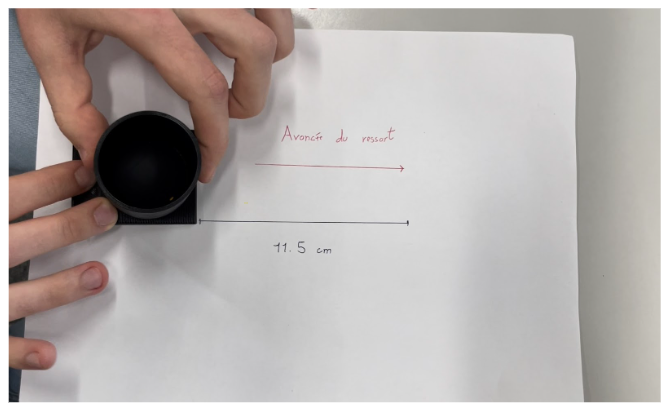
[picture p60: figure]

Figure 39 – Simulation expérimentale de la compression du ressort avec mise en contact de la balle.

### 10.4 Simulations cinématiques et physiques

Dans le cadre de notre projet de lanceur de balles de squash, nous avons utilisé le logiciel Algodoo pour valider expérimentalement le comportement de certains éléments du mécanisme, en particulier la capacité de compression du ressort par une pièce en mouvement. Algodoo s’est avéré être un outil pertinent pour explorer des phénomènes dynamiques et tester virtuellement des situations complexes que nos compétences en modélisation analytique ne permettaient pas de traiter directement.

Objectif de la simulation

L’objectif principal de cette simulation était de vérifier qu’une barre de 7 cm, mise en mouvement par la rotation d’un mécanisme (hélice), pouvait compresser efficacement un ressort à l’aide d’une bille de 4 cm de diamètre. Cette interaction est essentielle pour le bon fonctionnement du système de stockage d’énergie, qui alimente ensuite le lancement des balles.

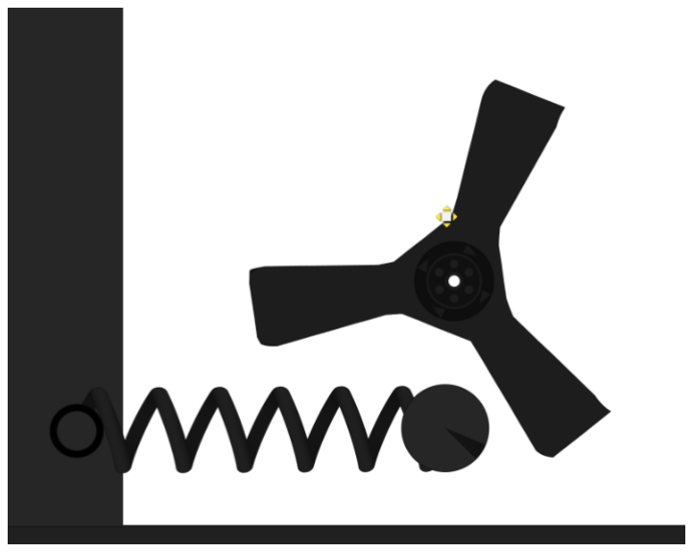
[picture p61: figure]

Figure 40 – Compression du ressort par la barre à l’aide d’une boule dans Algodoo.

Interprétation

La simulation montre que la géométrie choisie est adaptée : malgré sa faible longueur, la barre parvient à produire une compression suffisante grâce à une rotation rapide et un bon couplage mécanique avec la bille. Ce test virtuel valide donc la faisabilité mécanique du système de compression, un point critique du fonctionnement global du lanceur.

### 10.5 Tableaux ajustements

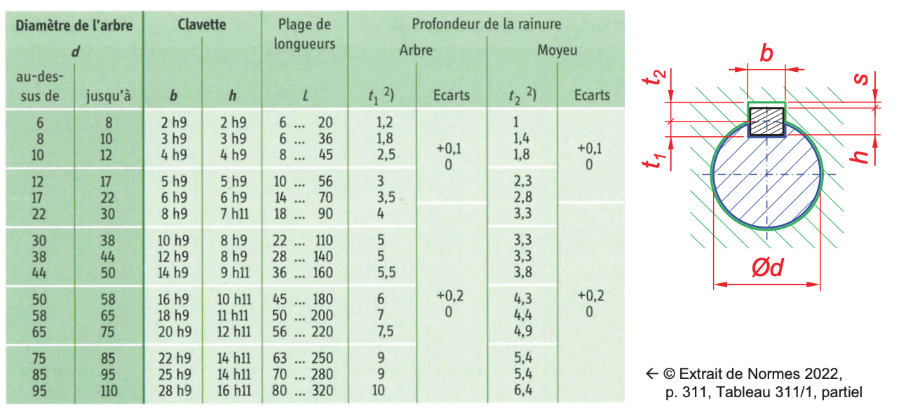
[picture p62: figure]

Figure 41 – Tableau Ajustements Clavette.

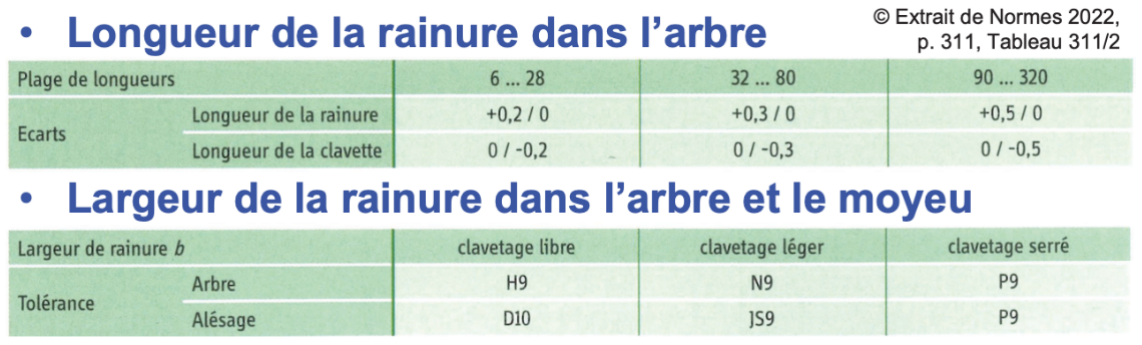
[picture p63: figure]

Figure 42 – Tableau Ajustements segments d’arrêt :

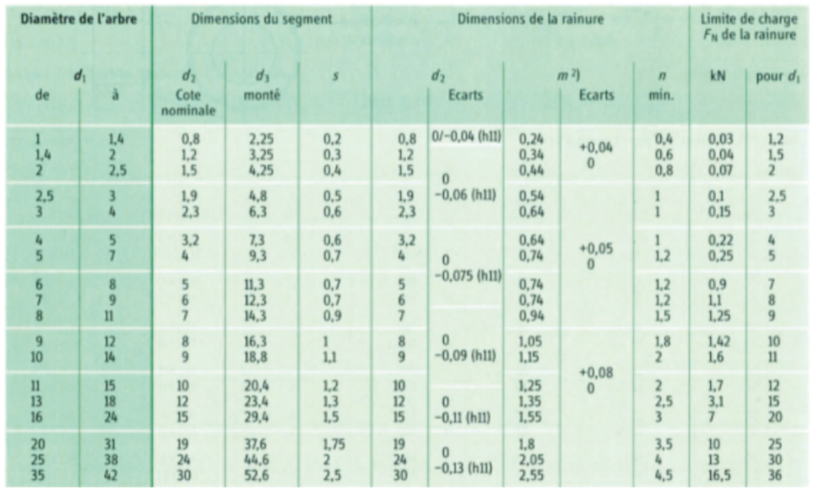
[picture p64: figure]

Figure 43 – Tableau Ajustements arbre/ moyeu.

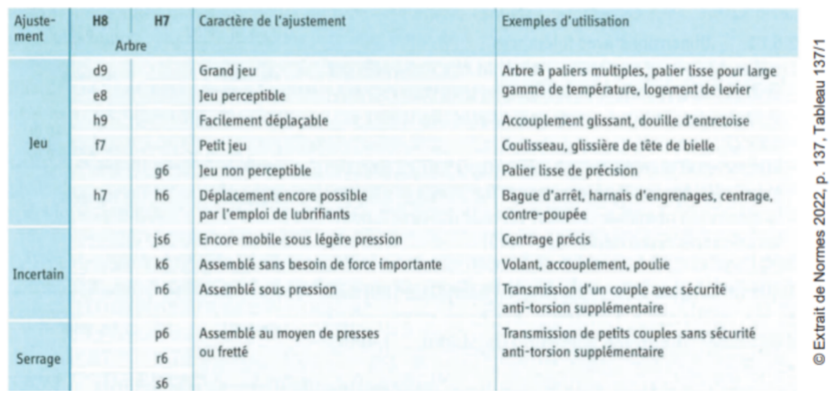
[picture p65: figure]

Figure 44 – Tableau Ajustements Clavette.

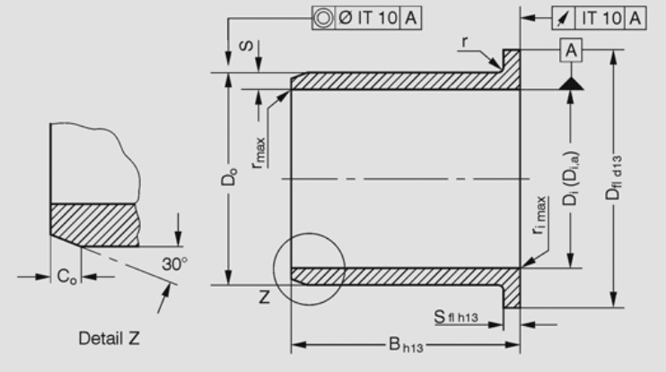
[picture p66: figure]

Palier lisse

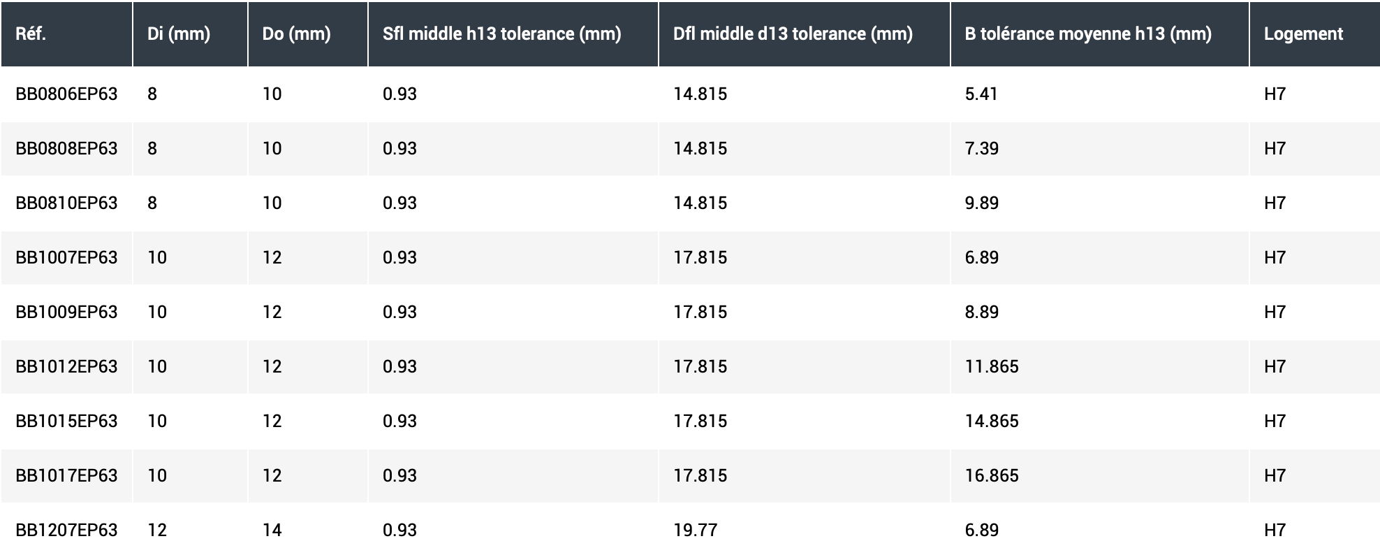
[picture p67: figure]
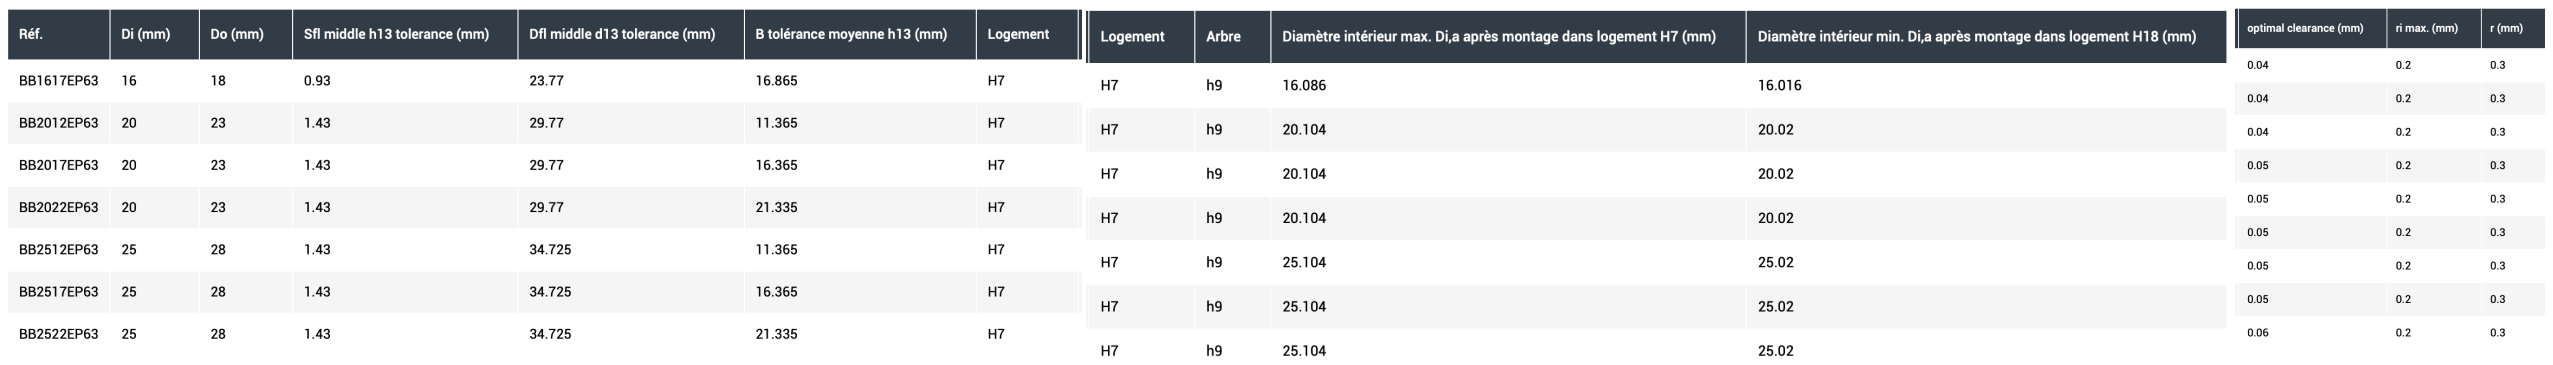
[picture p68: figure]

Ressort traction :

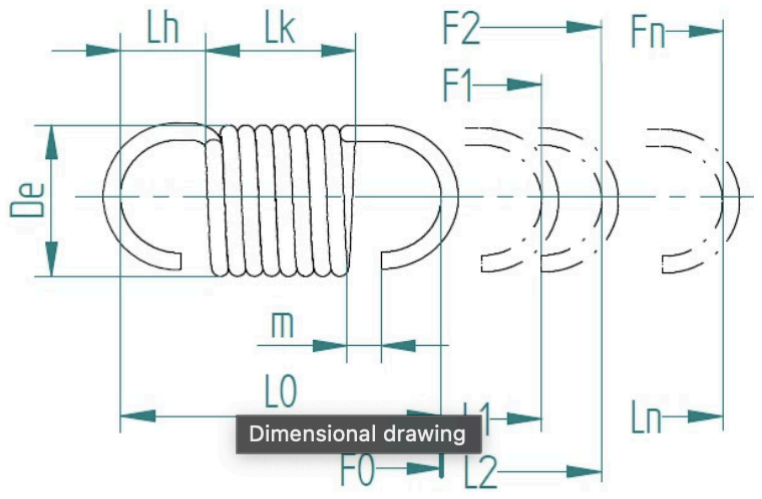
[picture p69: figure]

Epingle

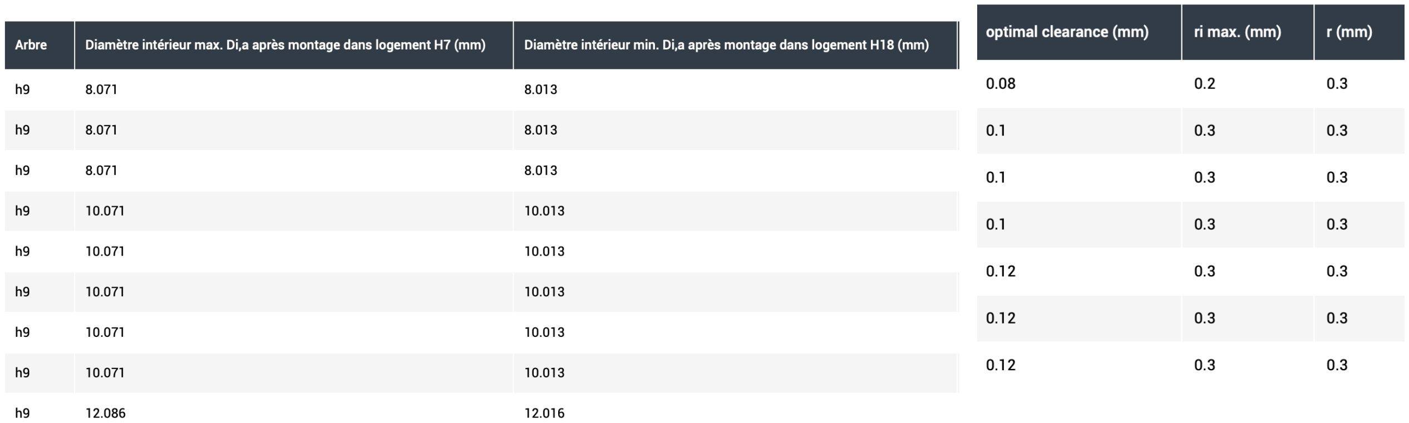
[picture p70: figure]
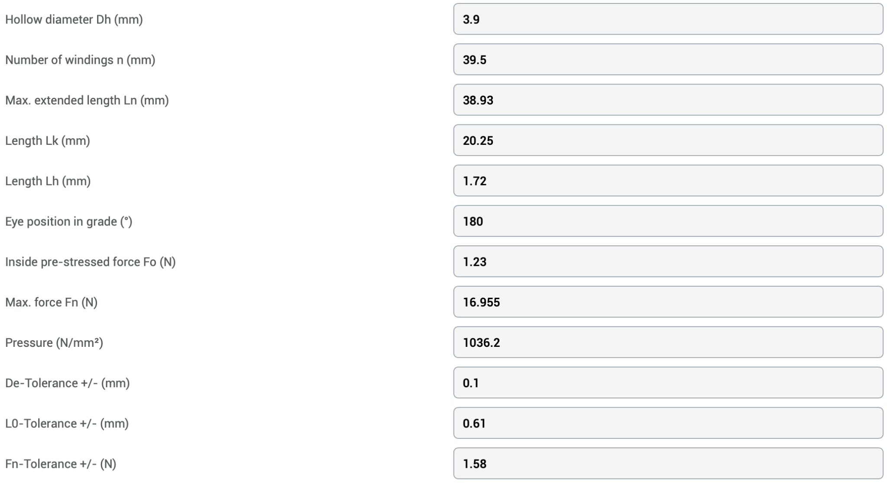
[picture p71: figure]
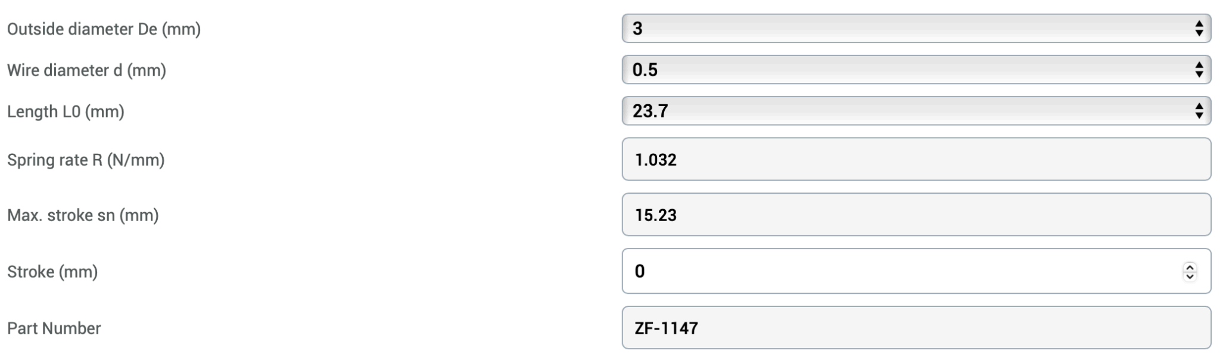
[picture p72: figure]
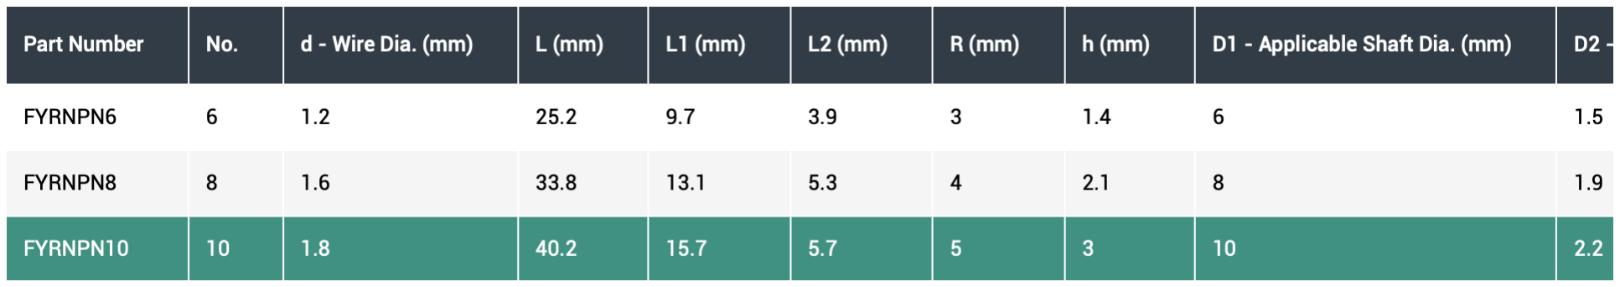
[picture p73: figure]

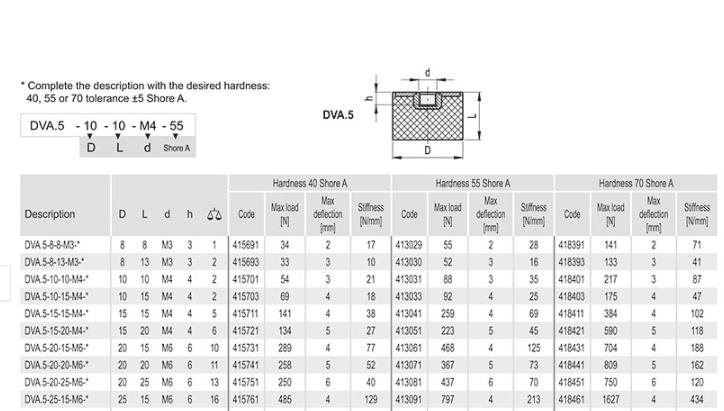
[picture p74: figure]
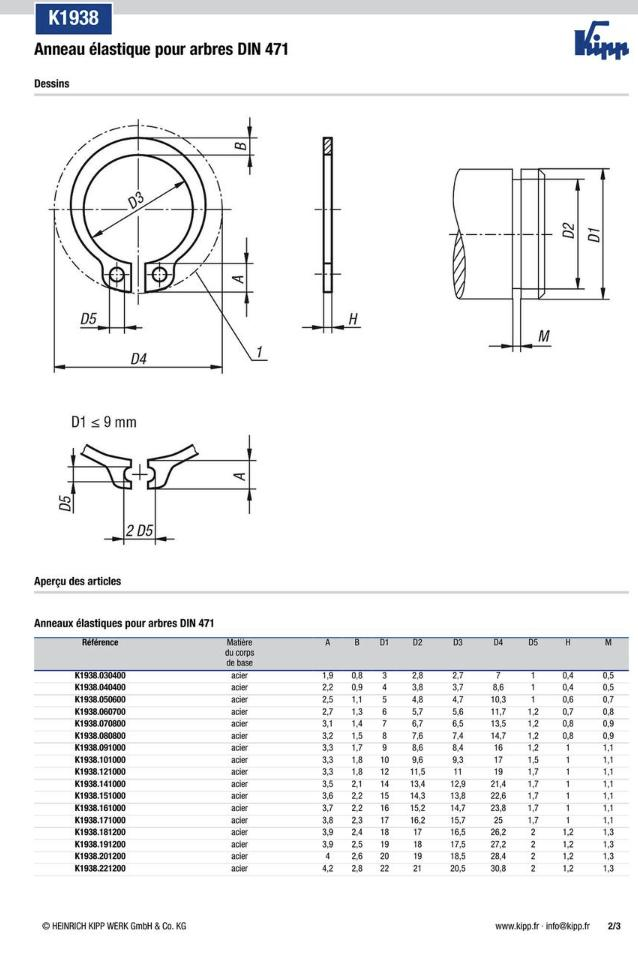
[picture p75: page 72]
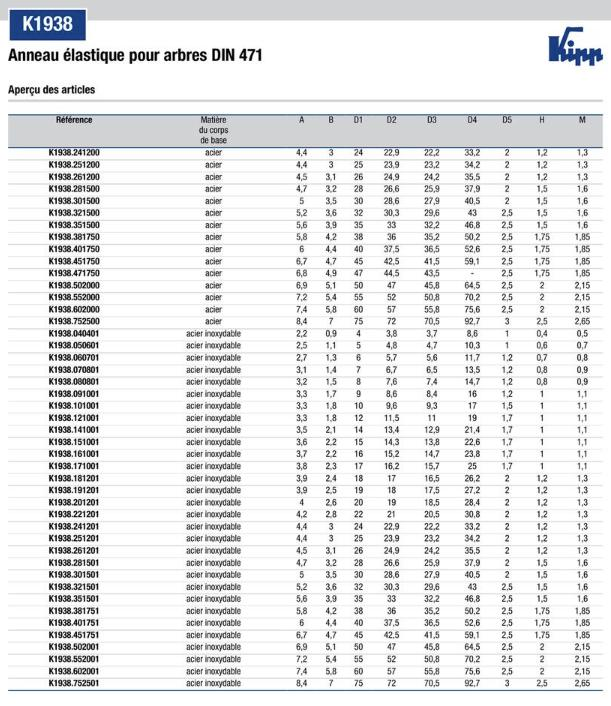
[picture p76: page 73]
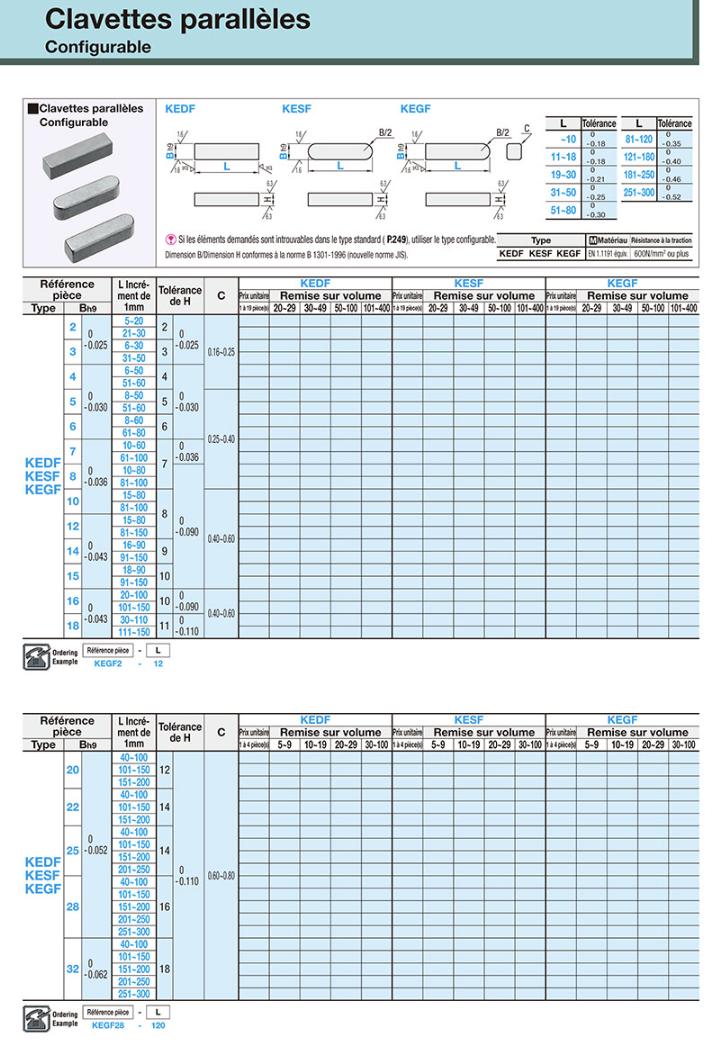
[picture p77: page 74]
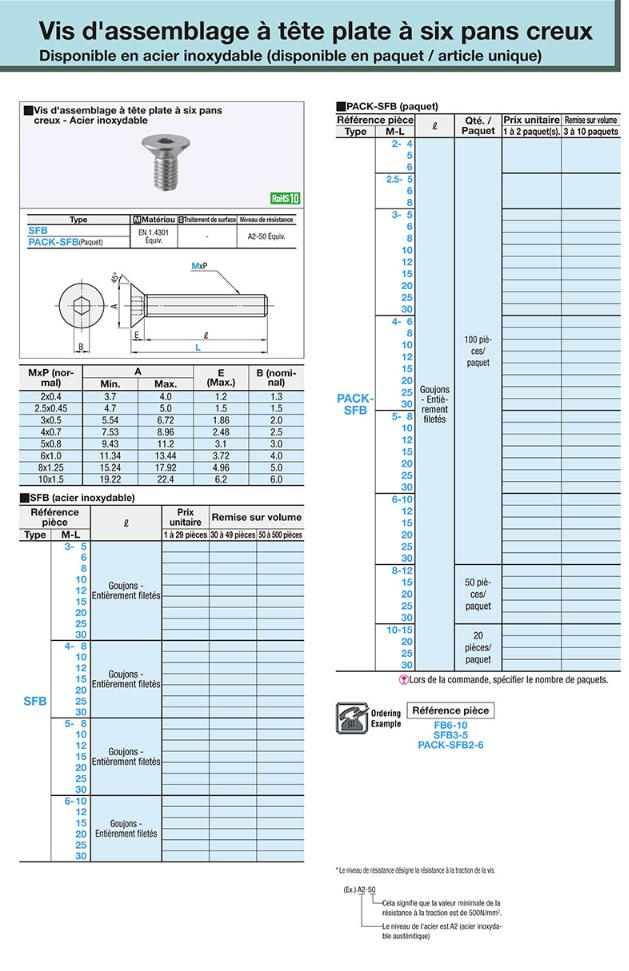
[picture p78: page 75]
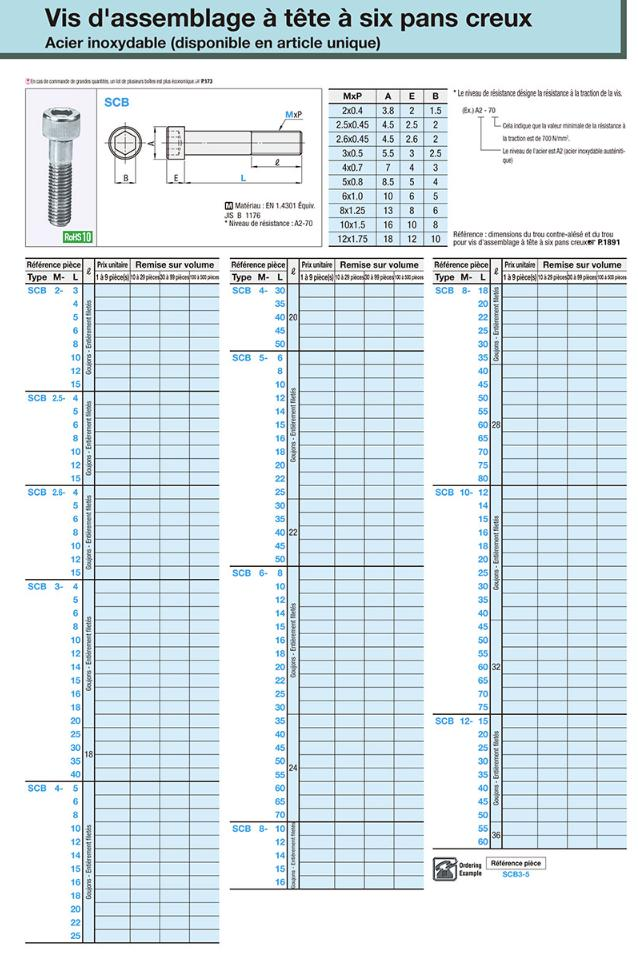
[picture p79: page 76]

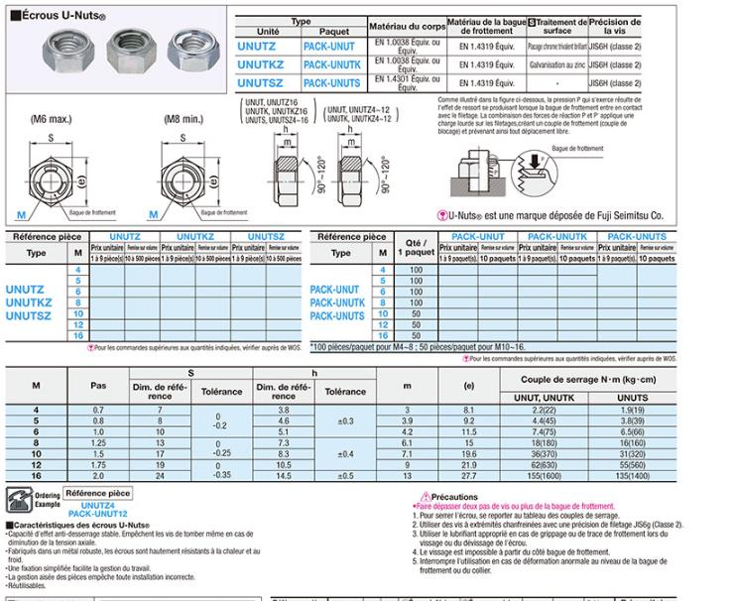
[picture p80: figure]

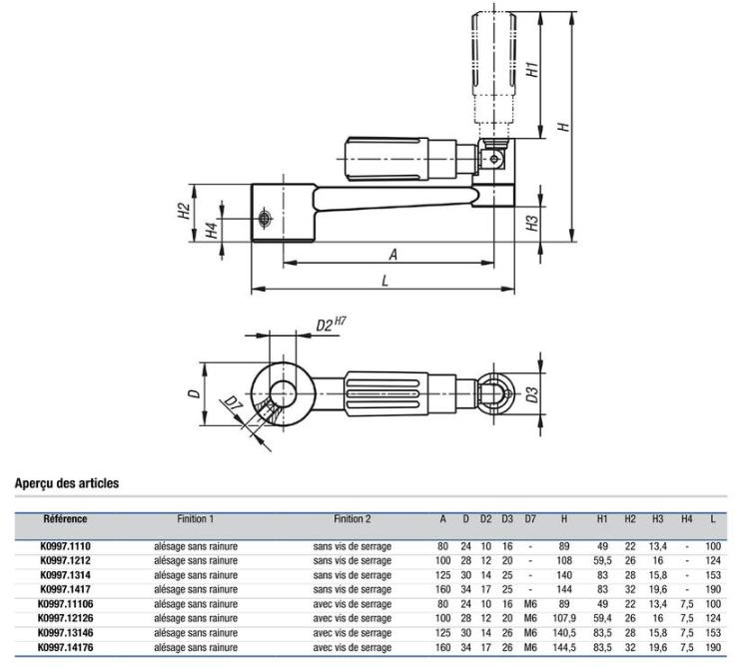
[picture p81: figure]

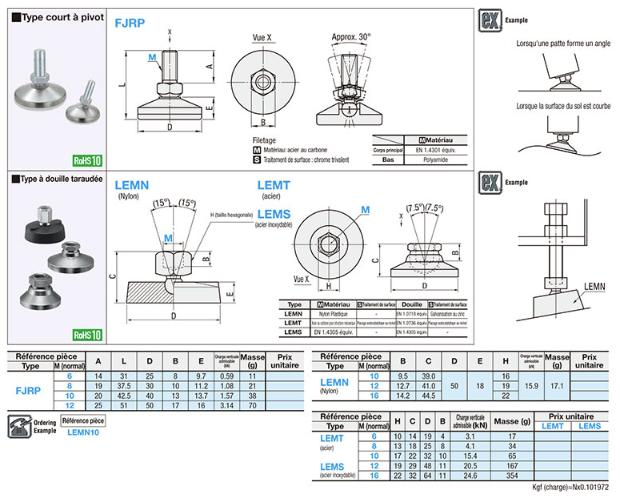
[picture p82: figure]

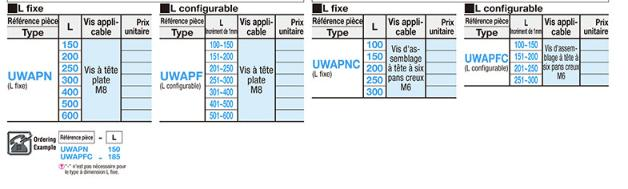
[picture p83: figure]
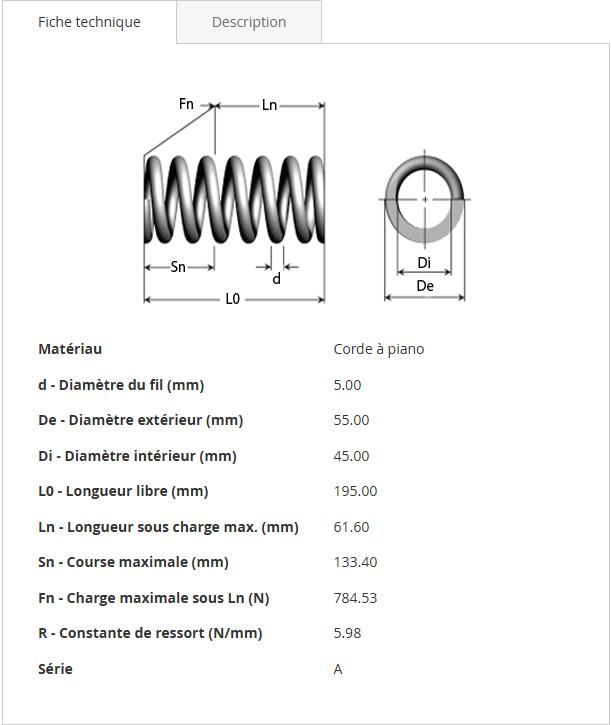
[picture p84: page 81]

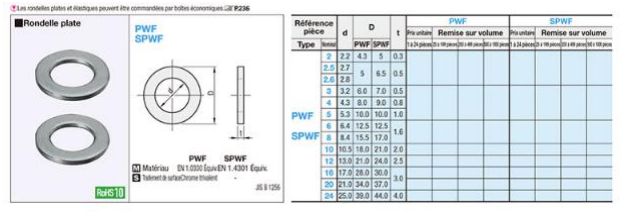
[picture p85: figure]
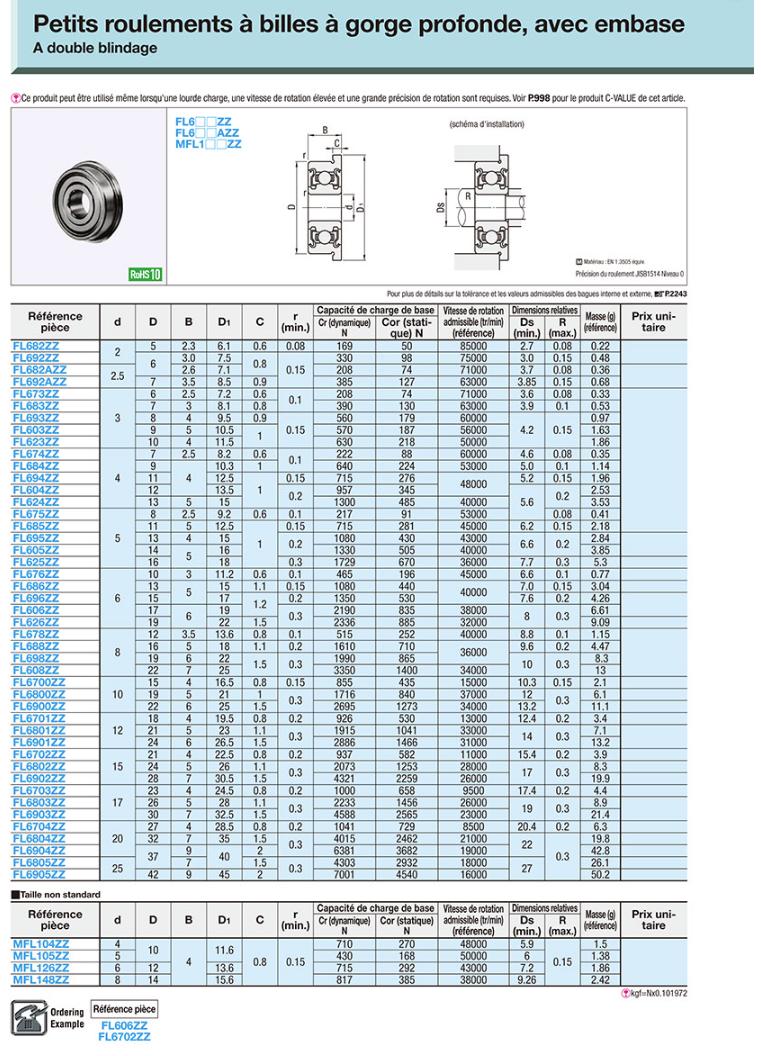
[picture p86: page 83]

1 | 2 | 3 | 4 | 5 | 6 | 7 | 8
A

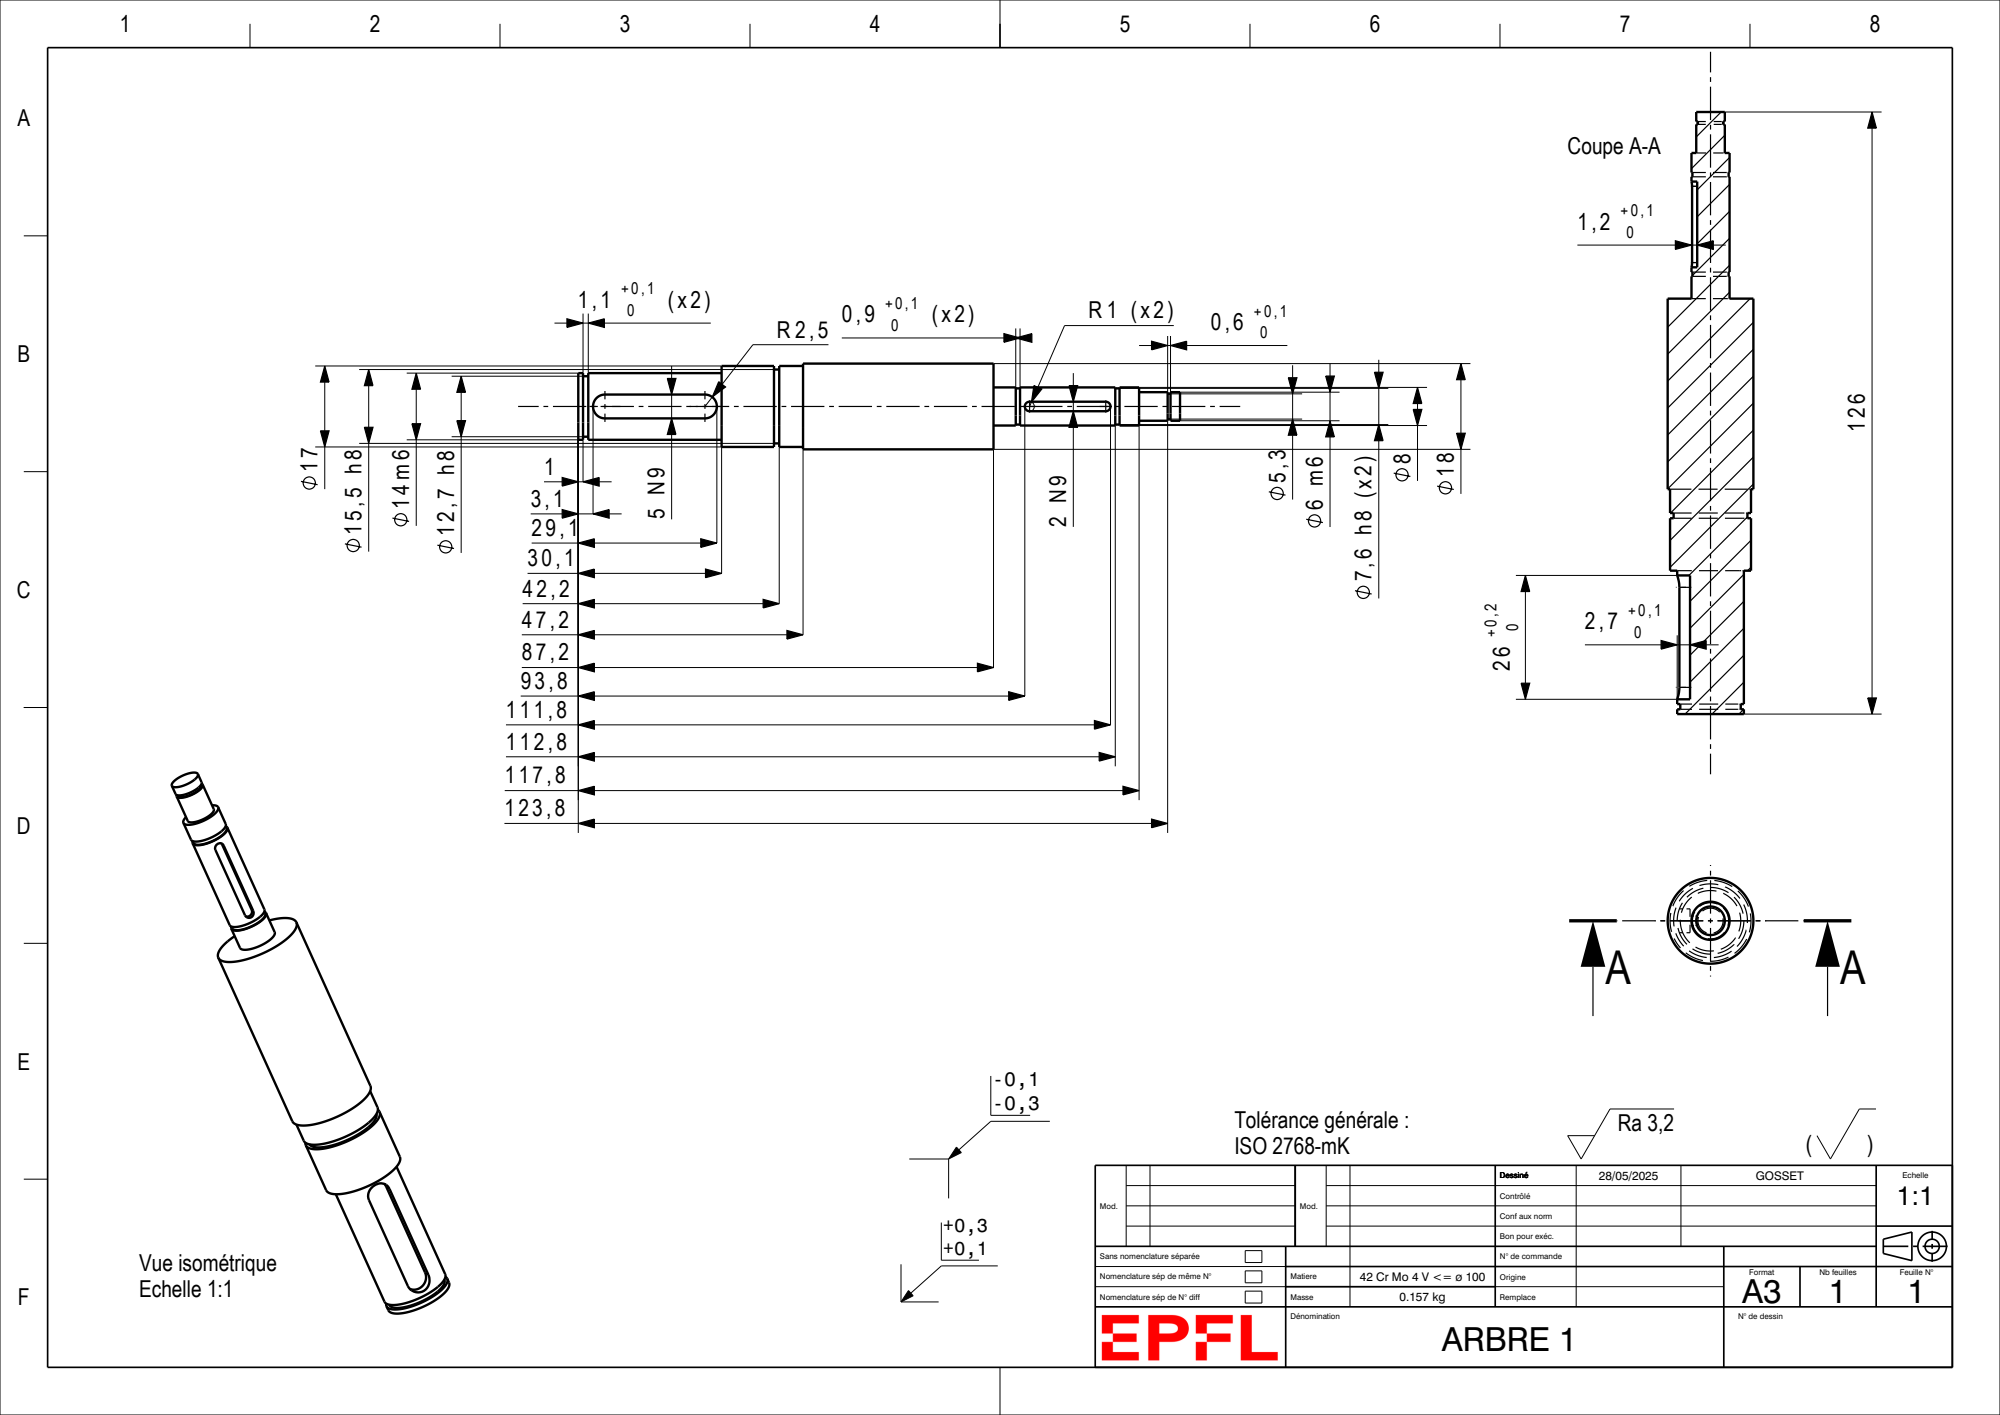
[picture p87: page 84]
Tolérance générale :; ISO 2768-mK; Coupe A-A; Vue isométrique Echelle 1:1; A¹²⁶

Mod. | | Mod. | | | Dessiné | 28/05/2025 | GOSSET | Echelle 1:1

Contrôlé

Conf aux norm

Bon pour exéc.

Sans nomenclature séparée | | | | N° de commande
Nomenclature sép de même N° | | Matiere | 42 Cr Mo 4 V <= ø 100 | Origine | | Format A3 | Nb feuilles 1 | Feuille N° 1
Nomenclature sép de N° diff | | Masse | 0.157 kg | Remplace

Dénomination ARBRE 1 | | | | N° de dessin

6,89
9,76

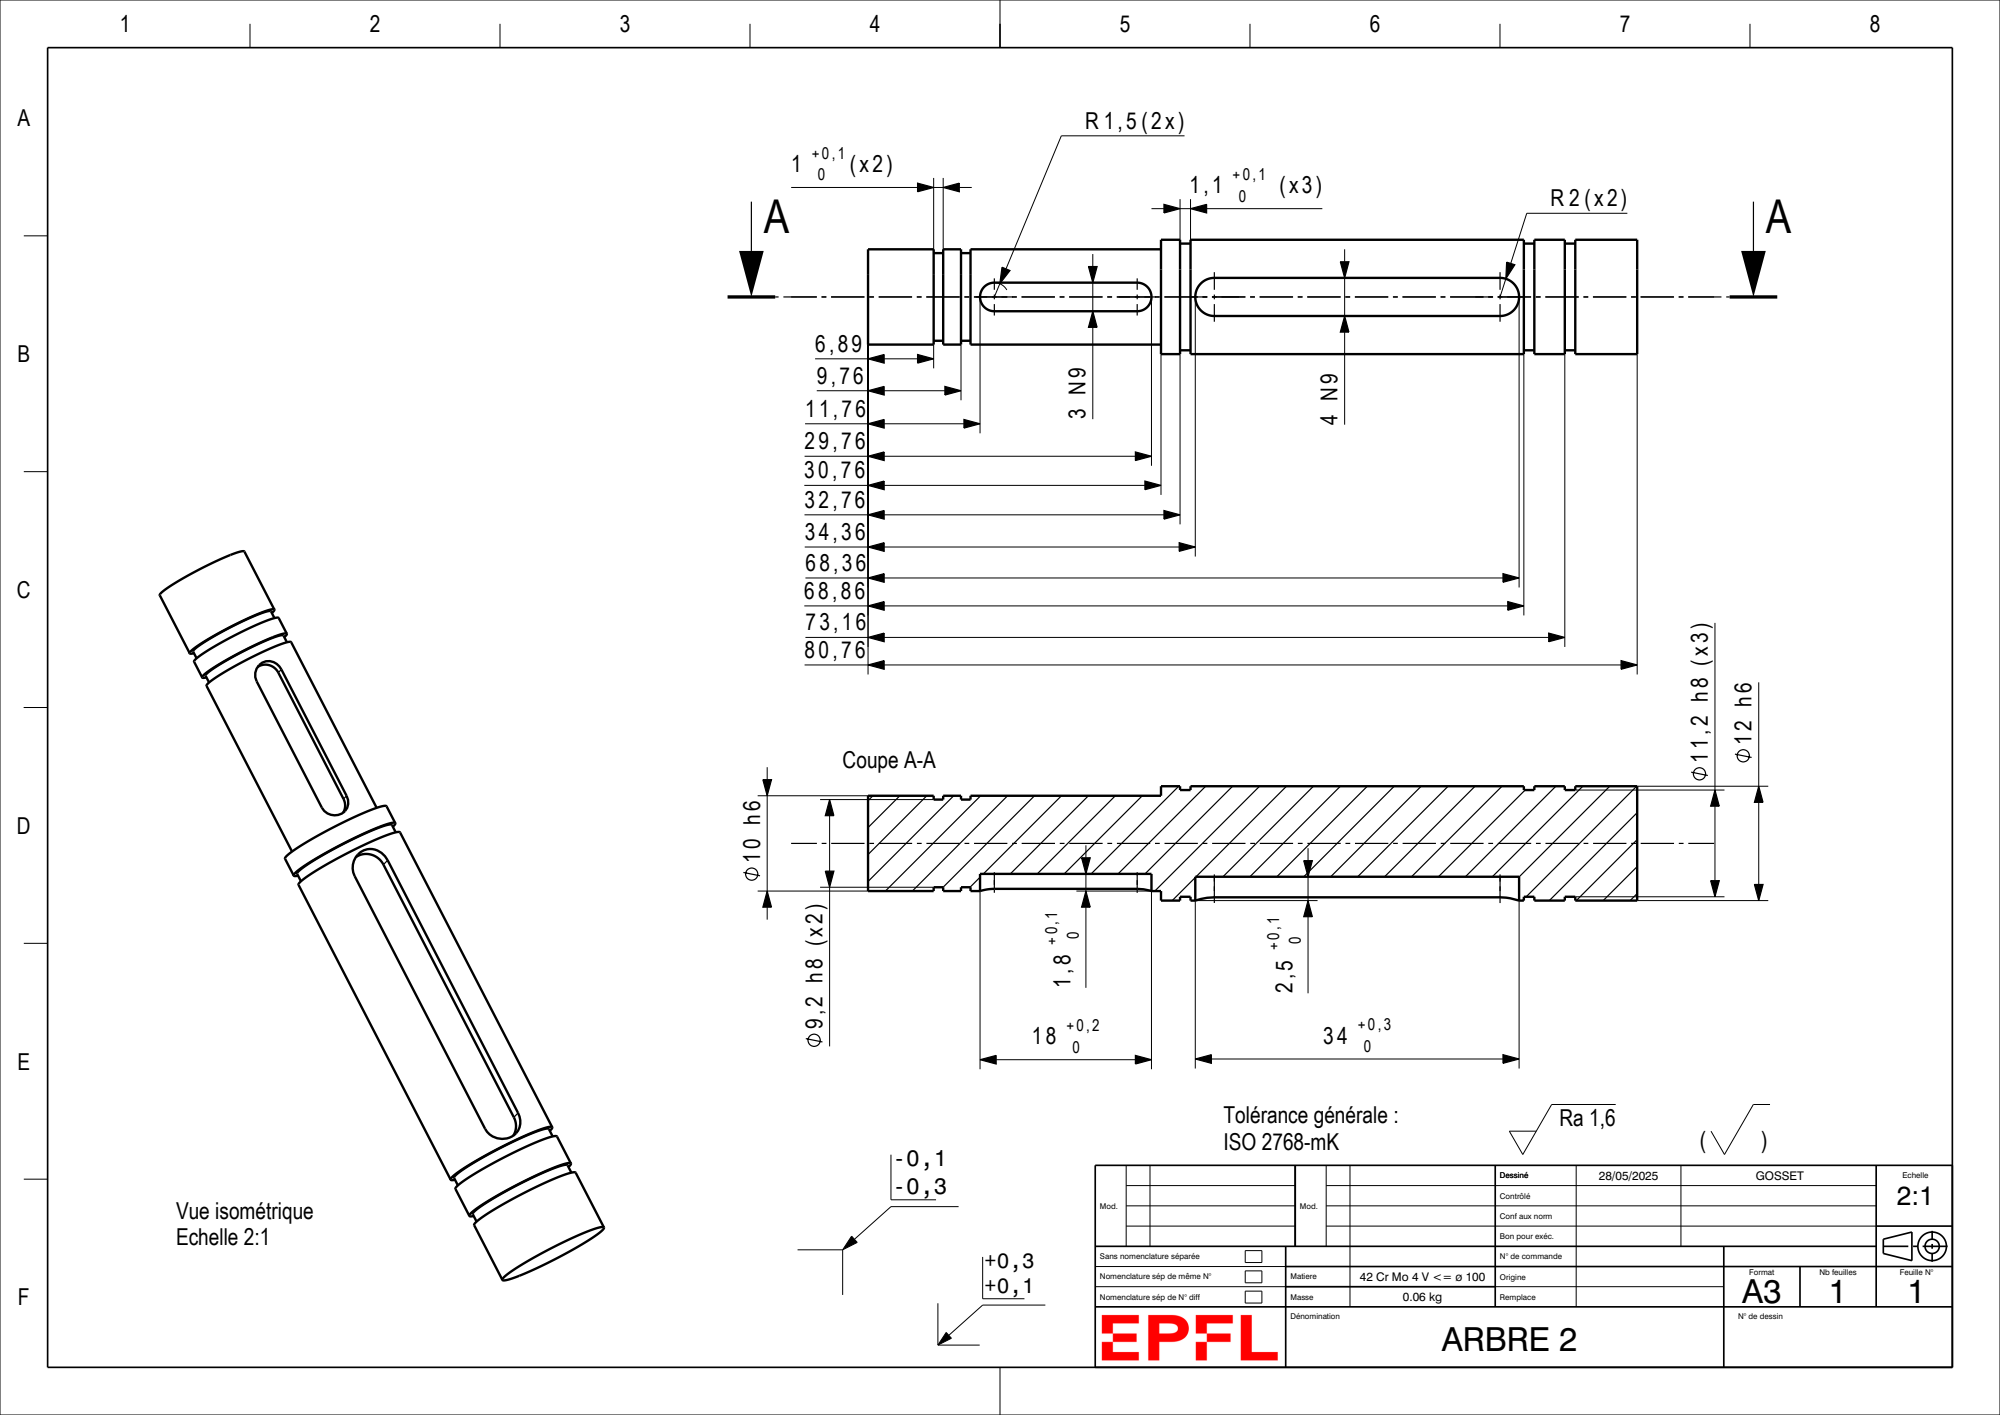
[picture p88: page 85]
ABCDEF; Tolérance générale :; ISO 2768-mK; Vue isométrique Echelle 2:1; Coupe A-A

Mod. | | Mod. | | | Dessiné | 28/05/2025 | GOSSET | Echelle 2:1

Contrôlé

Conf aux norm

Bon pour exéc.

Sans nomenclature séparée | | | | N° de commande
Nomenclature sép de même N° | | Matiere | 42 Cr Mo 4 V <= ø 100 | Origine | | Format A3 | Nb feuilles 1 | Feuille N° 1
Nomenclature sép de N° diff | | Masse | 0.06 kg | Remplace

Dénomination ARBRE 2 | | | | N° de dessin

1 2 3 4 | 5 6 7 8
| 260

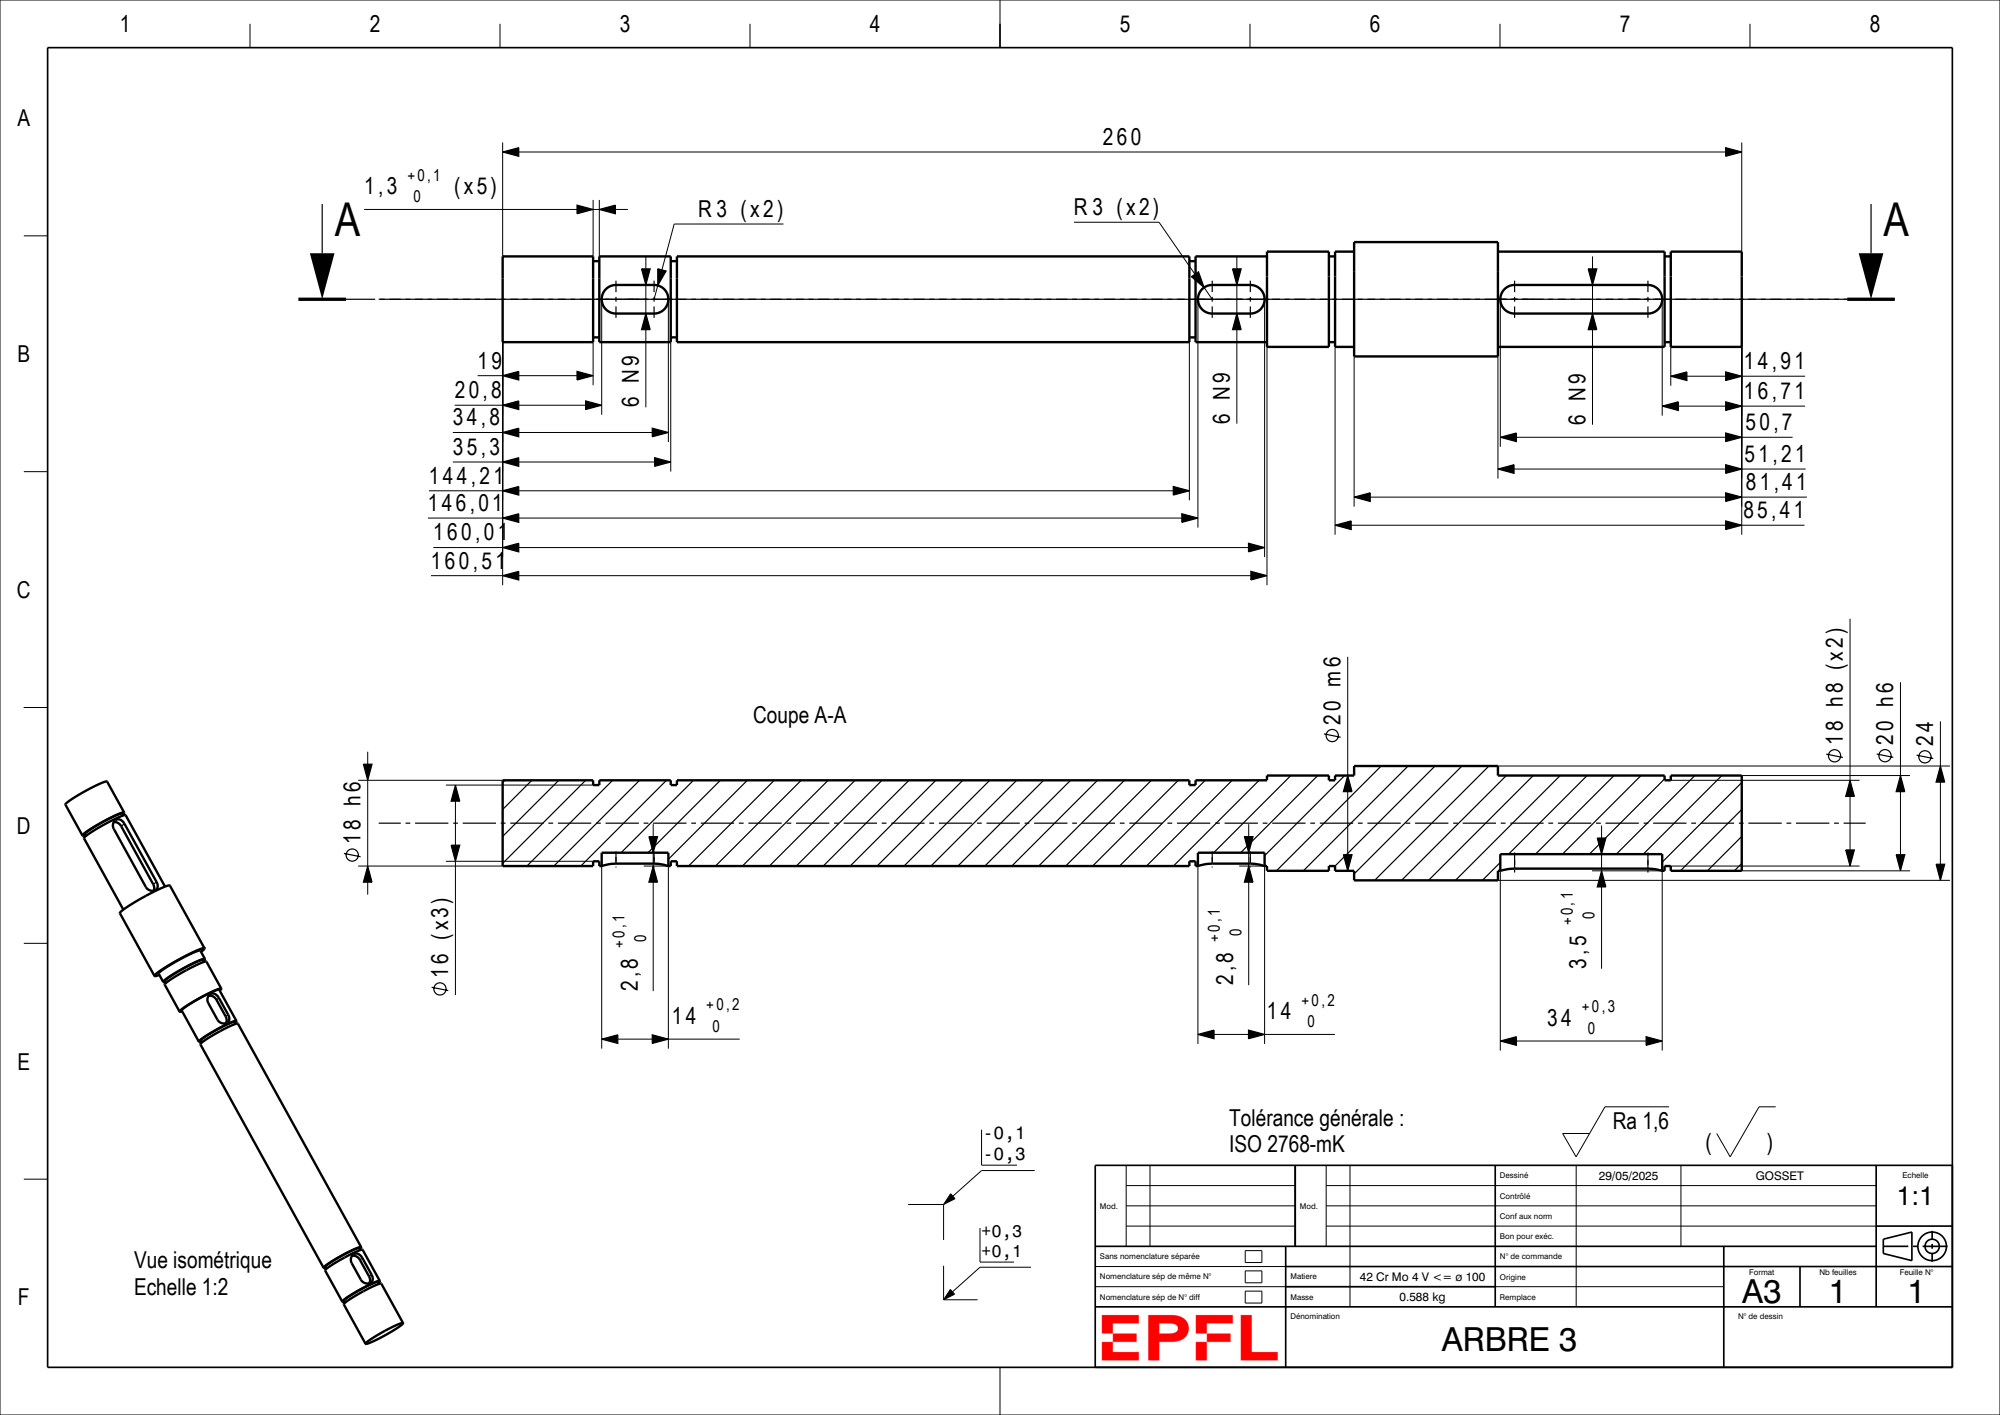
[picture p89: page 86]
Tolérance générale : ISO 2768-mK; Coupe A-A; Vue isométrique Echelle 1:2

Mod. | | Mod. | | | Dessiné | 29/05/2025 | GOSSET | Echelle 1:1

Contrôlé

Conf aux norm

Bon pour exéc.

Sans nomenclature séparée | | | | N° de commande
Nomenclature sép de même N° | | Matiere | 42 Cr Mo 4 V <= ø 100 | Origine | | Format A3 | Nb feuilles 1 | Feuille N° 1
Nomenclature sép de N° diff | | Masse | 0.588 kg | Remplace

Dénomination ARBRE 3 | | | | N° de dessin

1 | 2 | 3 | 4 | 5 | 6 | 7 | 8
A

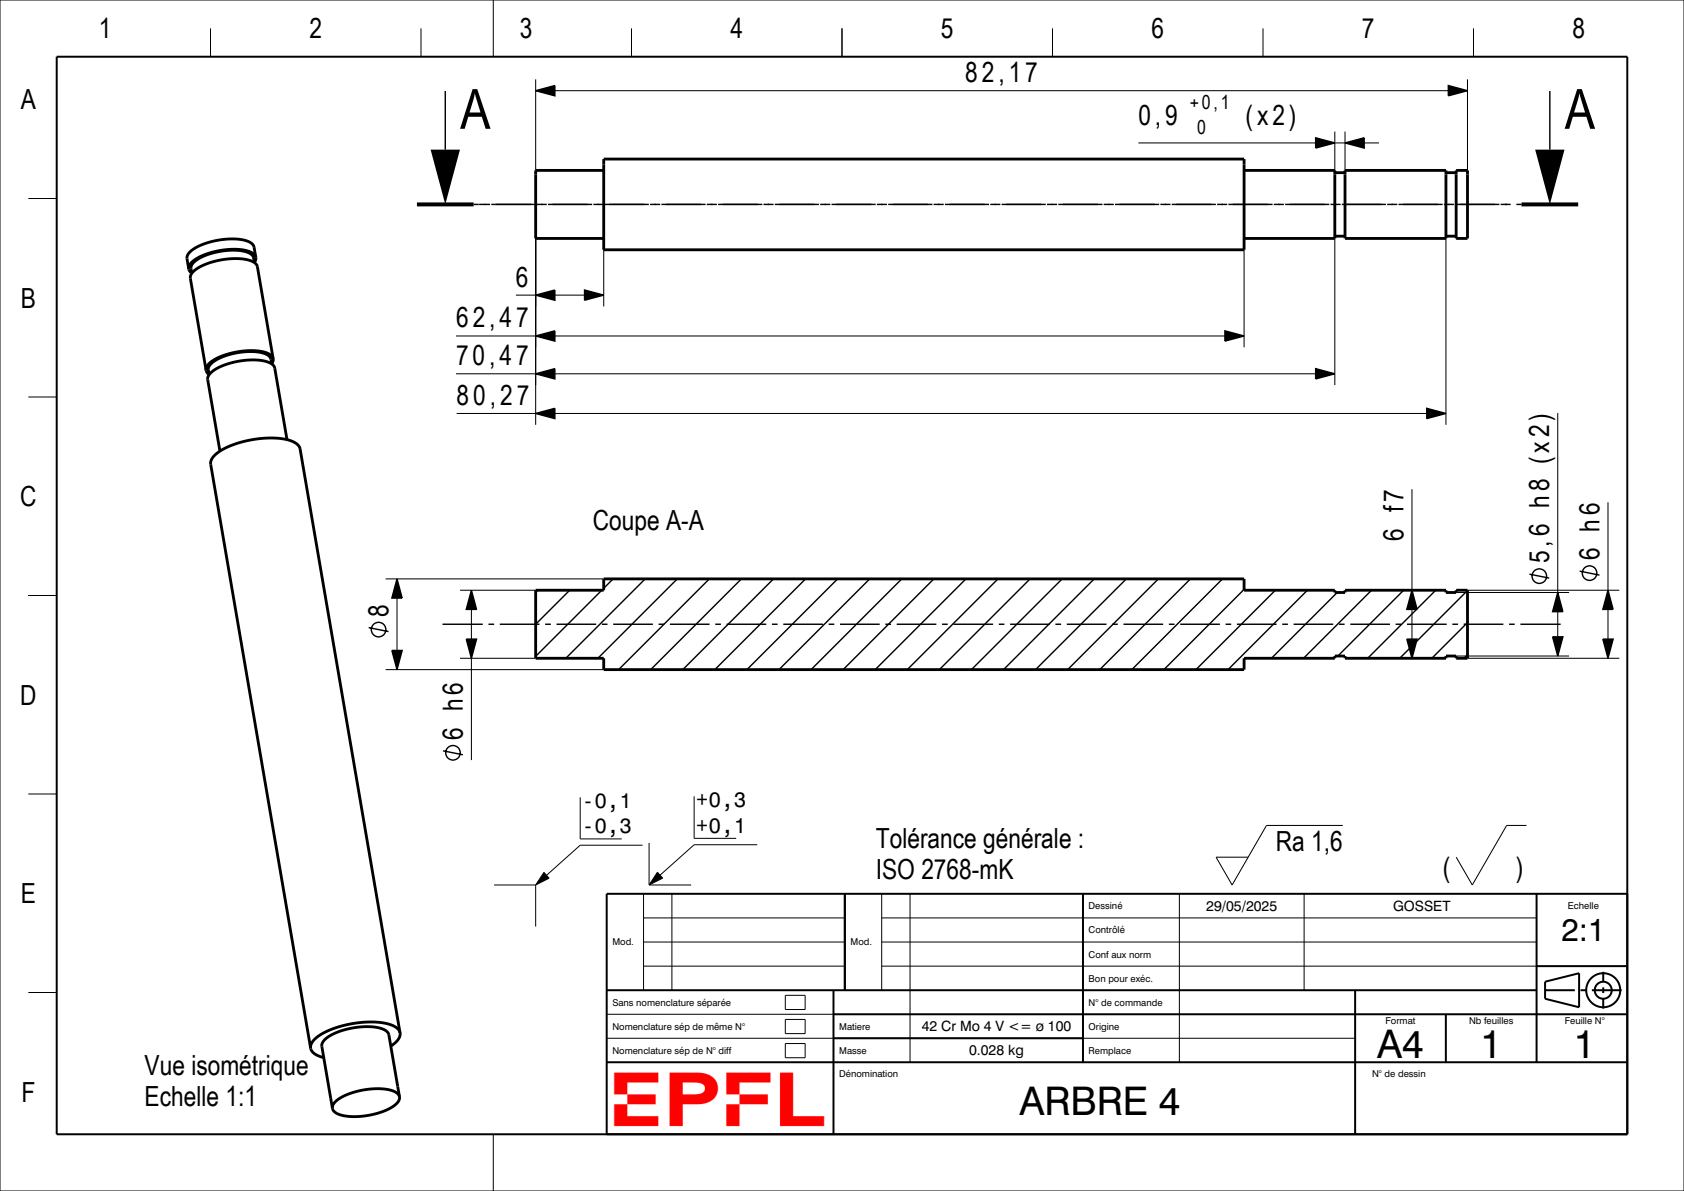
[picture p90: page 87]
ARBRE 4; Tolérance générale :; ISO 2768-mK; Vue isométrique Echelle 1:1; Coupe A-A

Mod. | | Mod. | | | Dessiné | 29/05/2025 | GOSSET | Echelle 2:1

Contrôlé

Conf aux norm

Bon pour exéc.

Sans nomenclature séparée | | | | N° de commande
Nomenclature sép de même N° | | Matiere | 42 Cr Mo 4 V <= ø 100 | Origine | | Format A4 | Nb feuilles 1 | Feuille N° 1
Nomenclature sép de N° diff | | Masse | 0.028 kg | Remplace

Dénomination | | | | N° de dessin

1 2 | 3 4 5 6 7 8
| | 1 +0,1 0

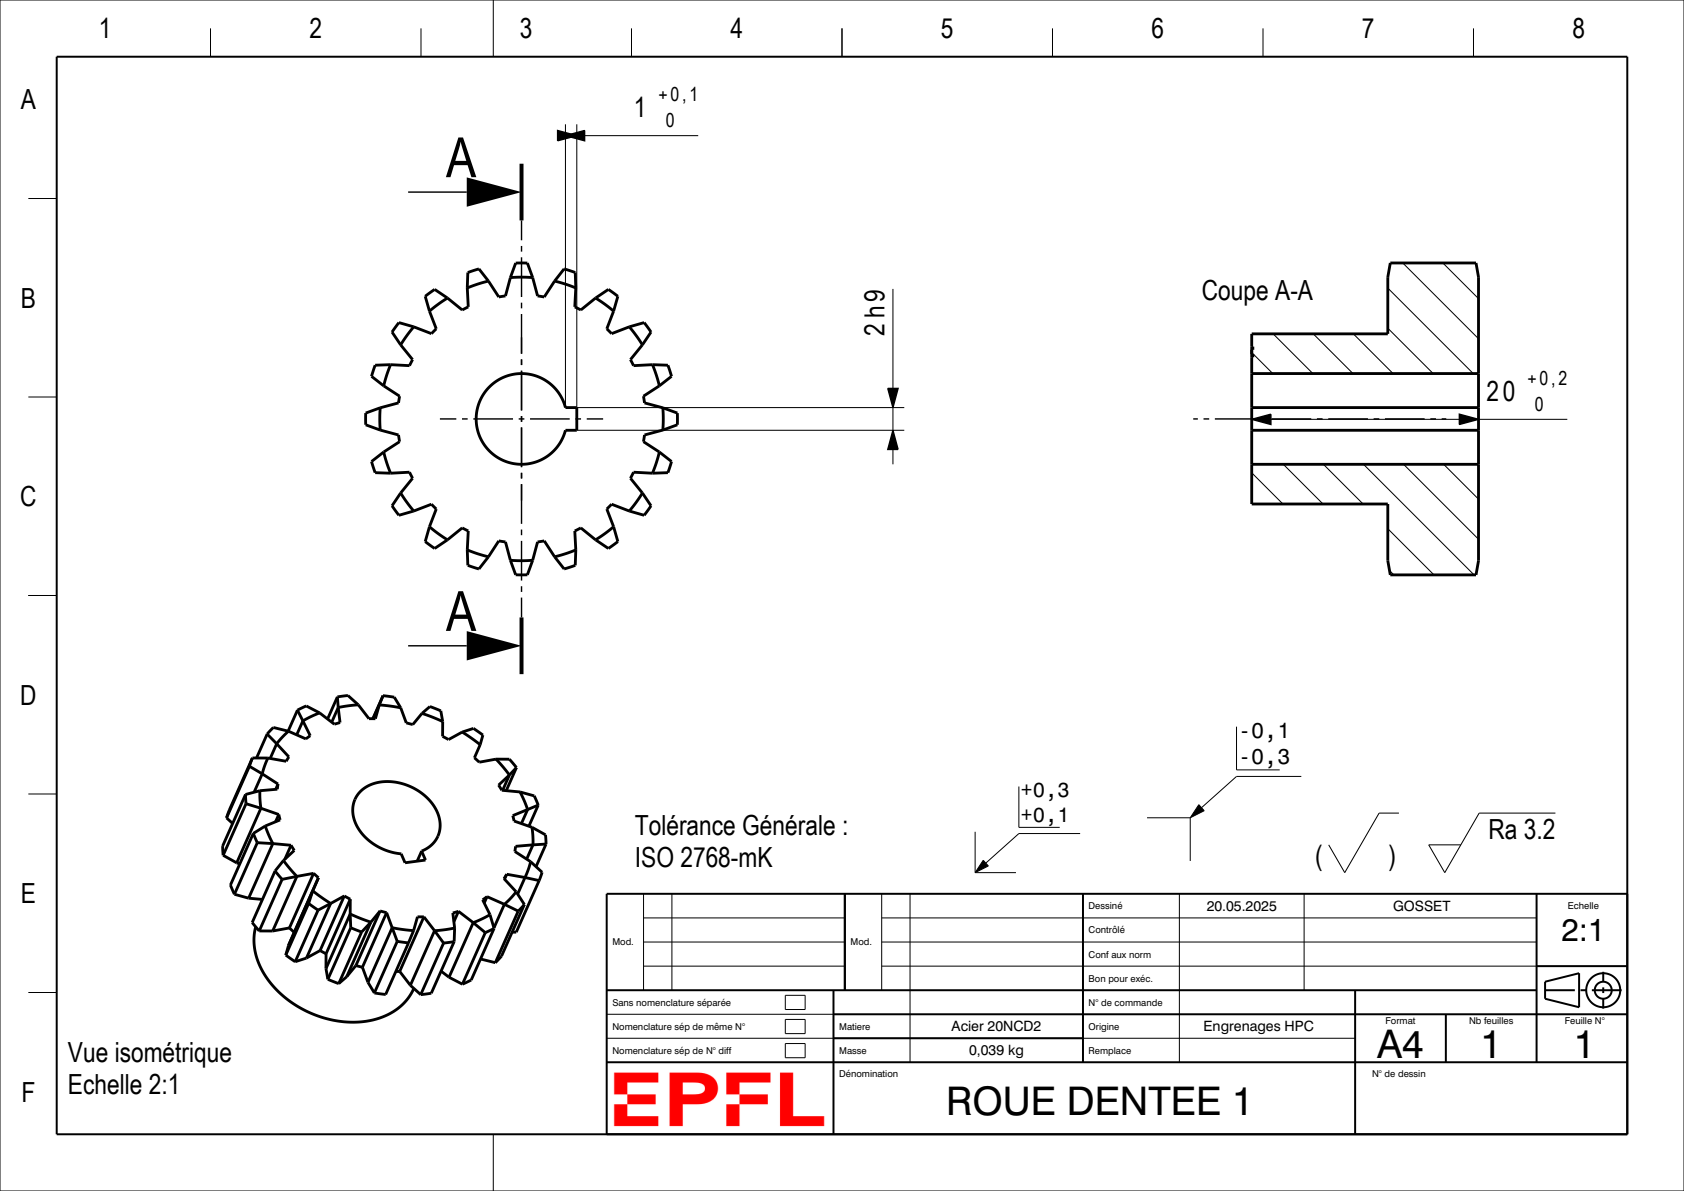
[picture p91: page 88]
ROUE DENTEE 1; Tolérance Générale :; ISO 2768-mK; Coupe A-A; Vue isométrique Echelle 2:1

Mod. | | Mod. | | | Dessiné | 20.05.2025 | GOSSET | Echelle 2:1

Contrôlé

Conf aux norm

Bon pour exéc.

Sans nomenclature séparée | | | | N° de commande
Nomenclature sép de même N° | | Matiere | Acier 20NCD2 | Origine | Engrenages HPC | Format A4 | Nb feuilles 1 | Feuille N° 1
Nomenclature sép de N° diff | | Masse | 0,039 kg | Remplace

Dénomination | | | | N° de dessin

1 2 | 3 4 5 6 7 8
| | 0

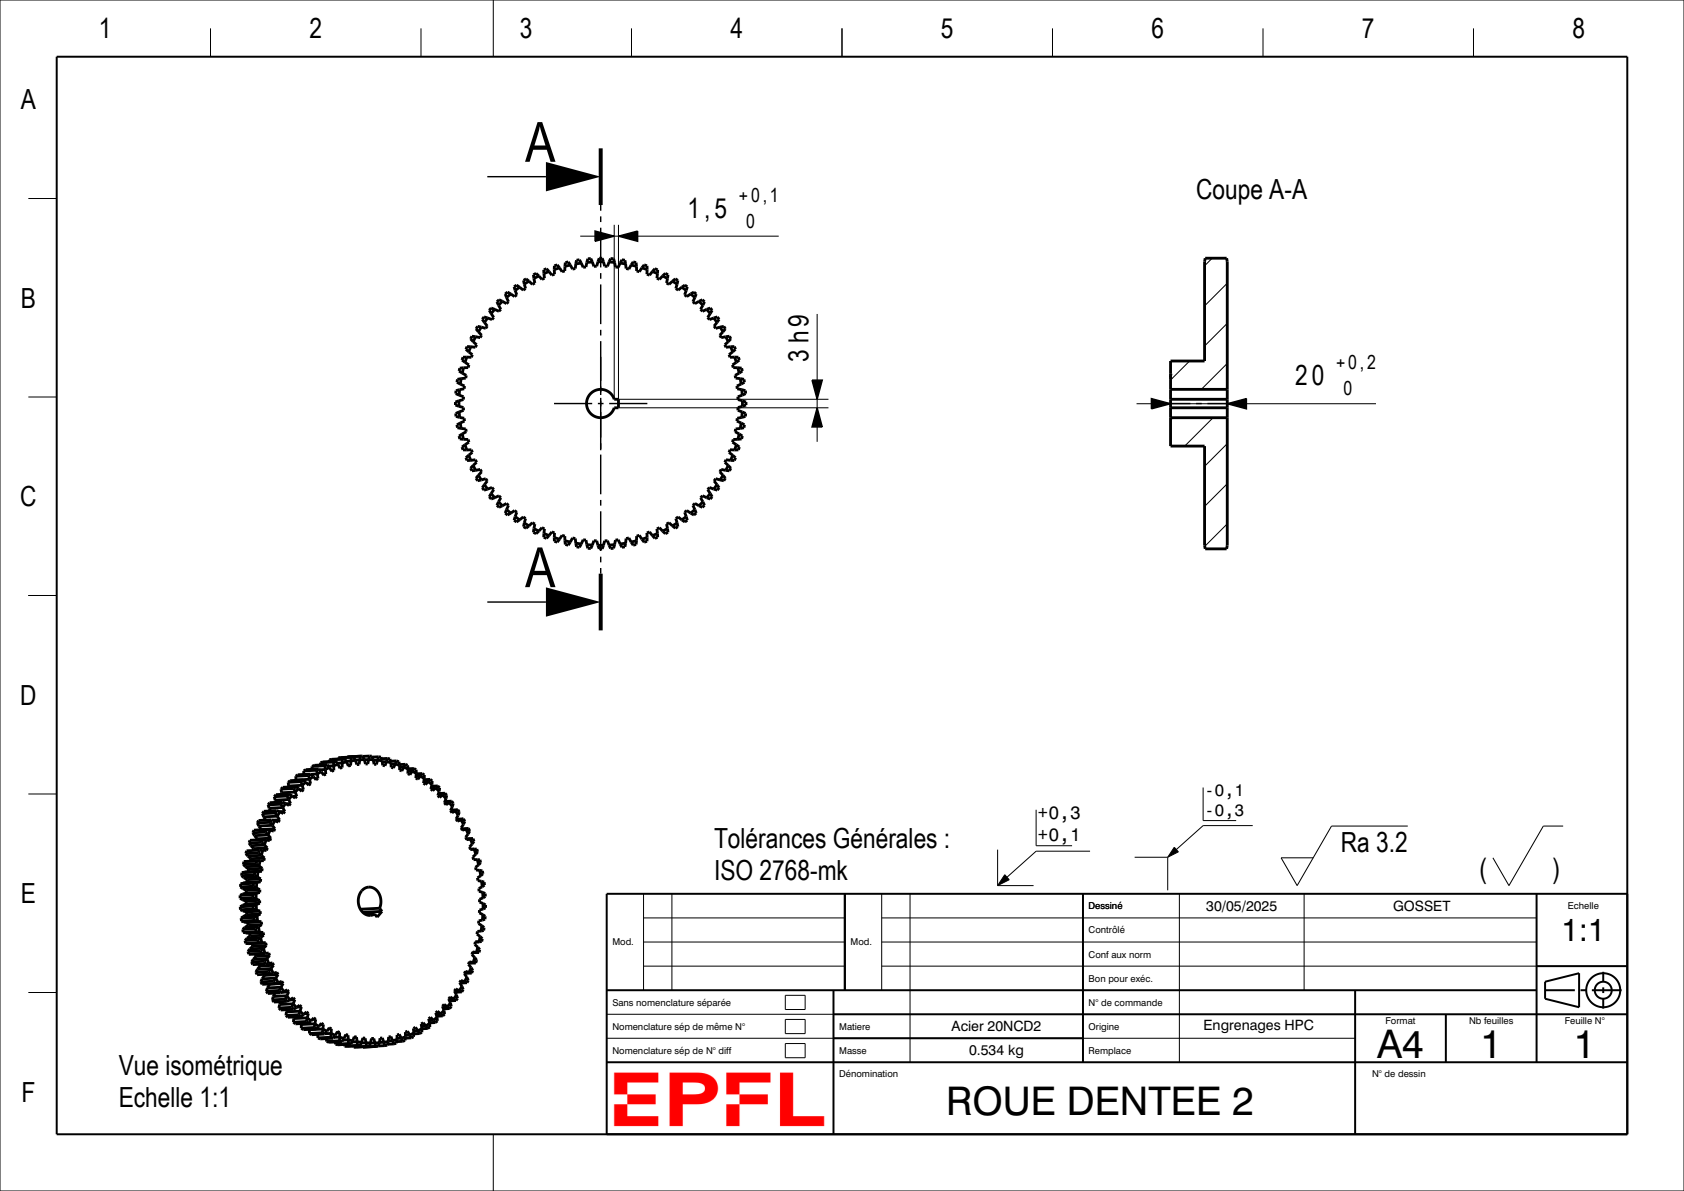
[picture p92: page 89]
ROUE DENTEE 2; Tolérances Générales : ISO 2768-mk; Coupe A-A; Vue isométrique Echelle 1:1

Mod. | | Mod. | | | Dessiné | 30/05/2025 | GOSSET | Echelle 1:1

Contrôlé

Conf aux norm

Bon pour exéc.

Sans nomenclature séparée | | | | N° de commande
Nomenclature sép de même N° | | Matiere | Acier 20NCD2 | Origine | Engrenages HPC | Format A4 | Nb feuilles 1 | Feuille N° 1
Nomenclature sép de N° diff | | Masse | 0.534 kg | Remplace

Dénomination | | | | N° de dessin

1 | 2 | 3 | 4 | 5 | 6 | 7 | 8
A

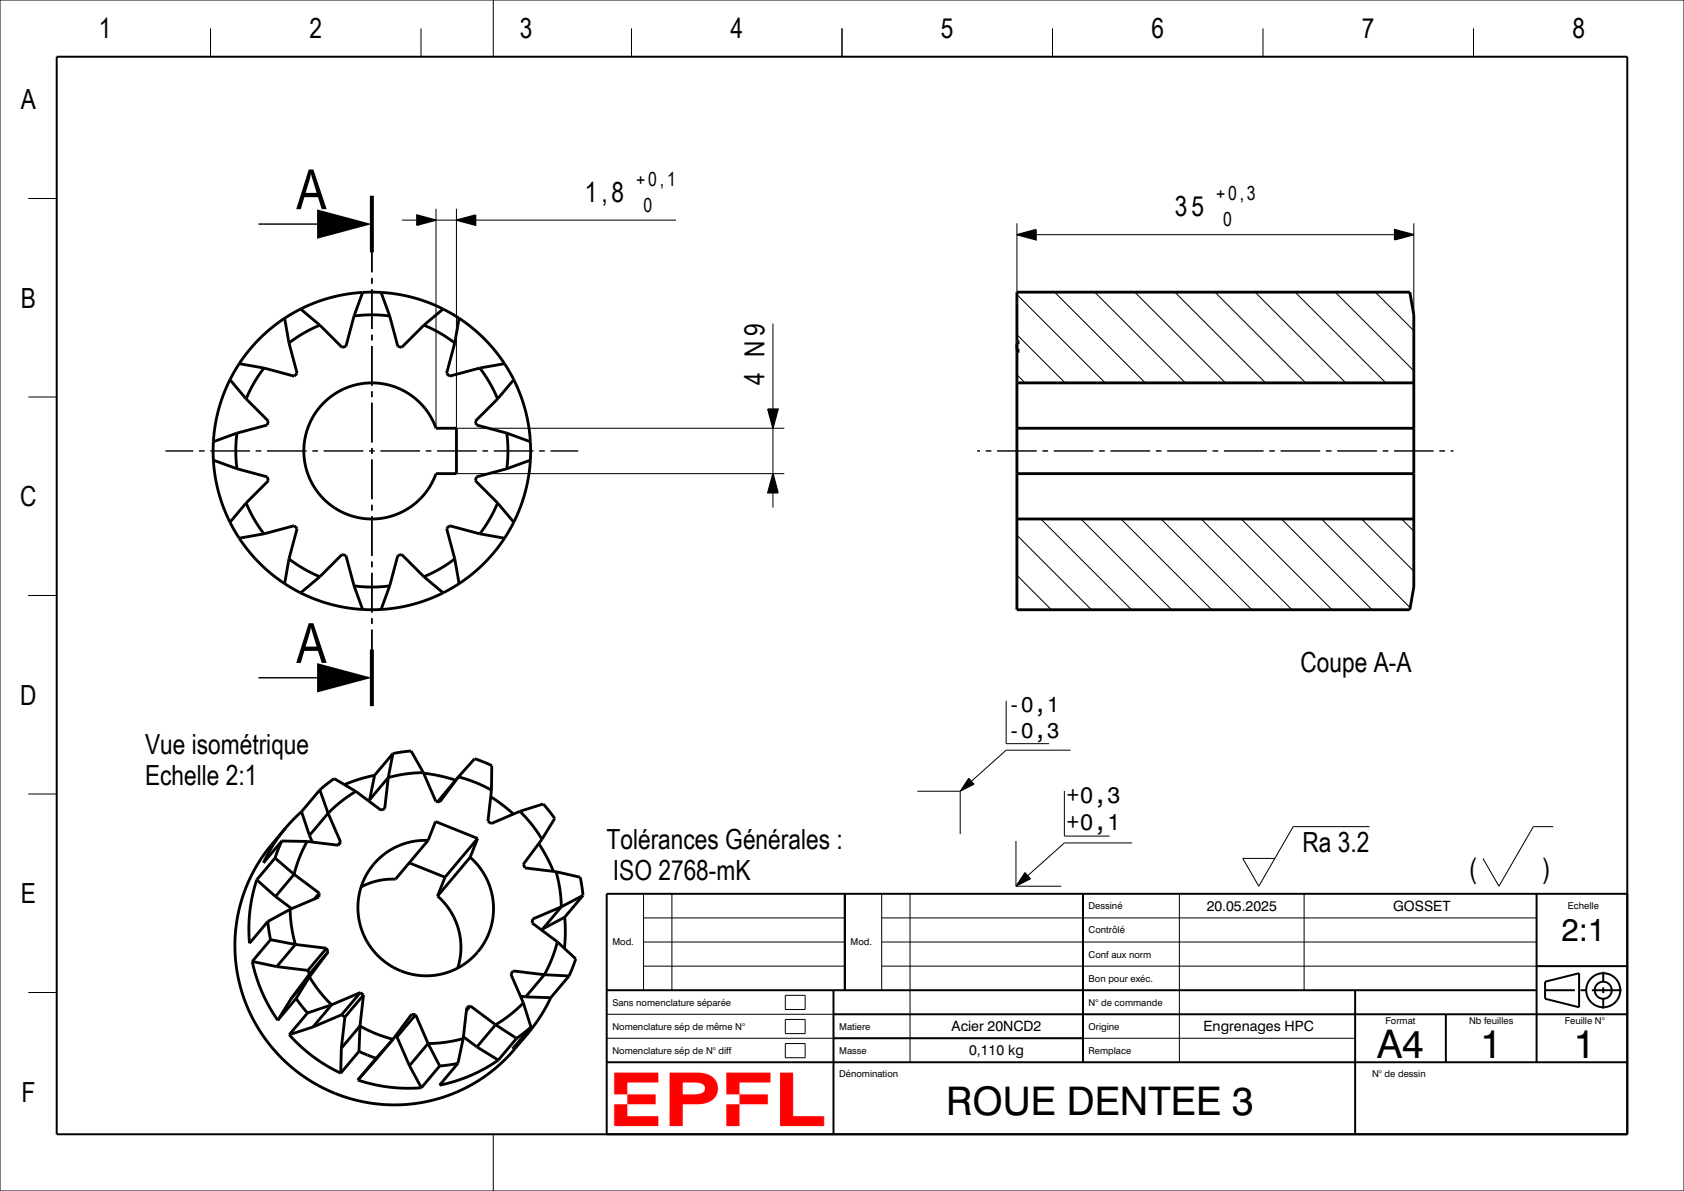
[picture p93: page 90]
ROUE DENTEE 3; Tolérances Générales : ISO 2768-mK; Vue isométrique Echelle 2:1; Coupe A-A

Mod. | | Mod. | | | Dessiné | 20.05.2025 | GOSSET | Echelle 2:1

Contrôlé

Conf aux norm

Bon pour exéc.

Sans nomenclature séparée | | | | N° de commande
Nomenclature sép de même N° | | Matiere | Acier 20NCD2 | Origine | Engrenages HPC | Format A4 | Nb feuilles 1 | Feuille N° 1
Nomenclature sép de N° diff | | Masse | 0,110 kg | Remplace

Dénomination | | | | N° de dessin

1 | 2 | 3 | 4 | 5 | 6 | 7 | 8
A

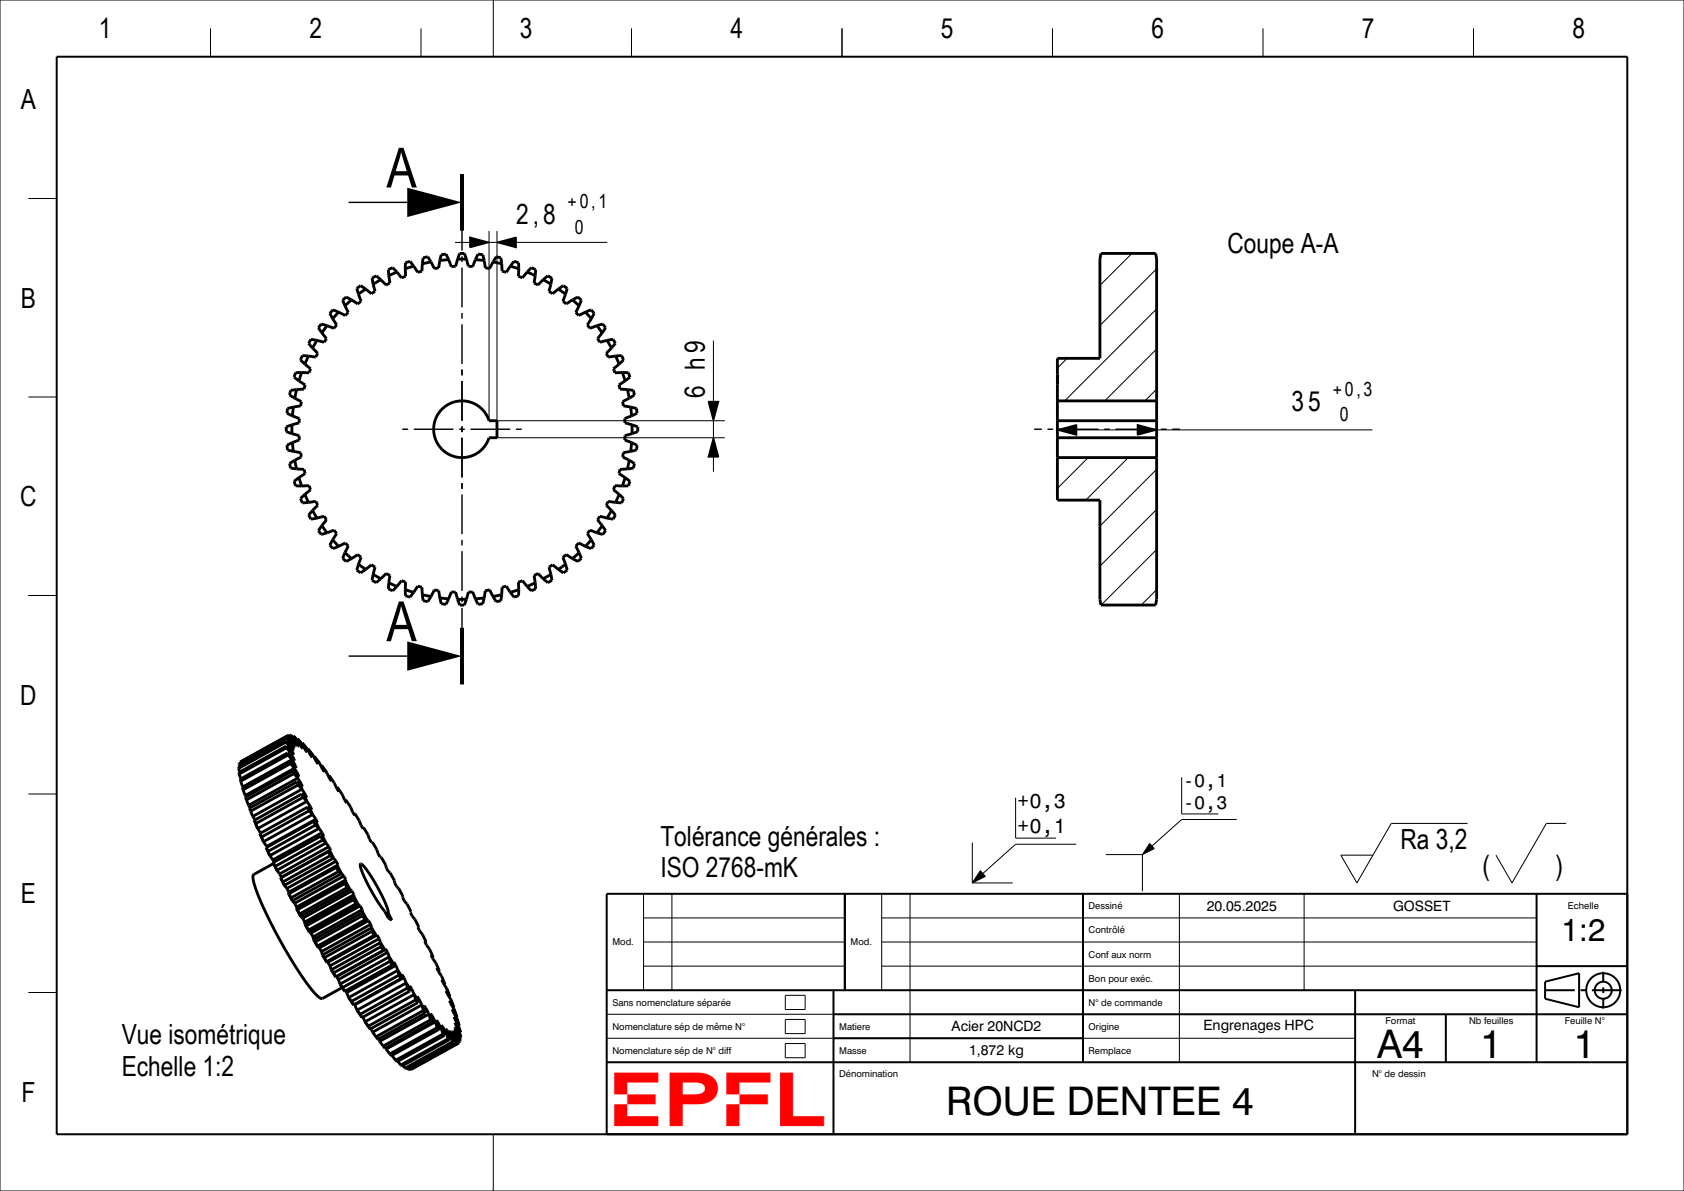
[picture p94: page 91]
ROUE DENTEE 4; Tolérance générales : ISO 2768-mK; Vue isométrique Echelle 1:2; Coupe A-A

Mod. | | Mod. | | | Dessiné | 20.05.2025 | GOSSET | Echelle 1:2

Contrôlé

Conf aux norm

Bon pour exéc.

Sans nomenclature séparée | | | | N° de commande
Nomenclature sép de même N° | | Matiere | Acier 20NCD2 | Origine | Engrenages HPC | Format A4 | Nb feuilles 1 | Feuille N° 1
Nomenclature sép de N° diff | | Masse | 1,872 kg | Remplace

Dénomination | | | | N° de dessin

1 | 2 | 3 | 4 | 5 | 6 | 7 | 8
A

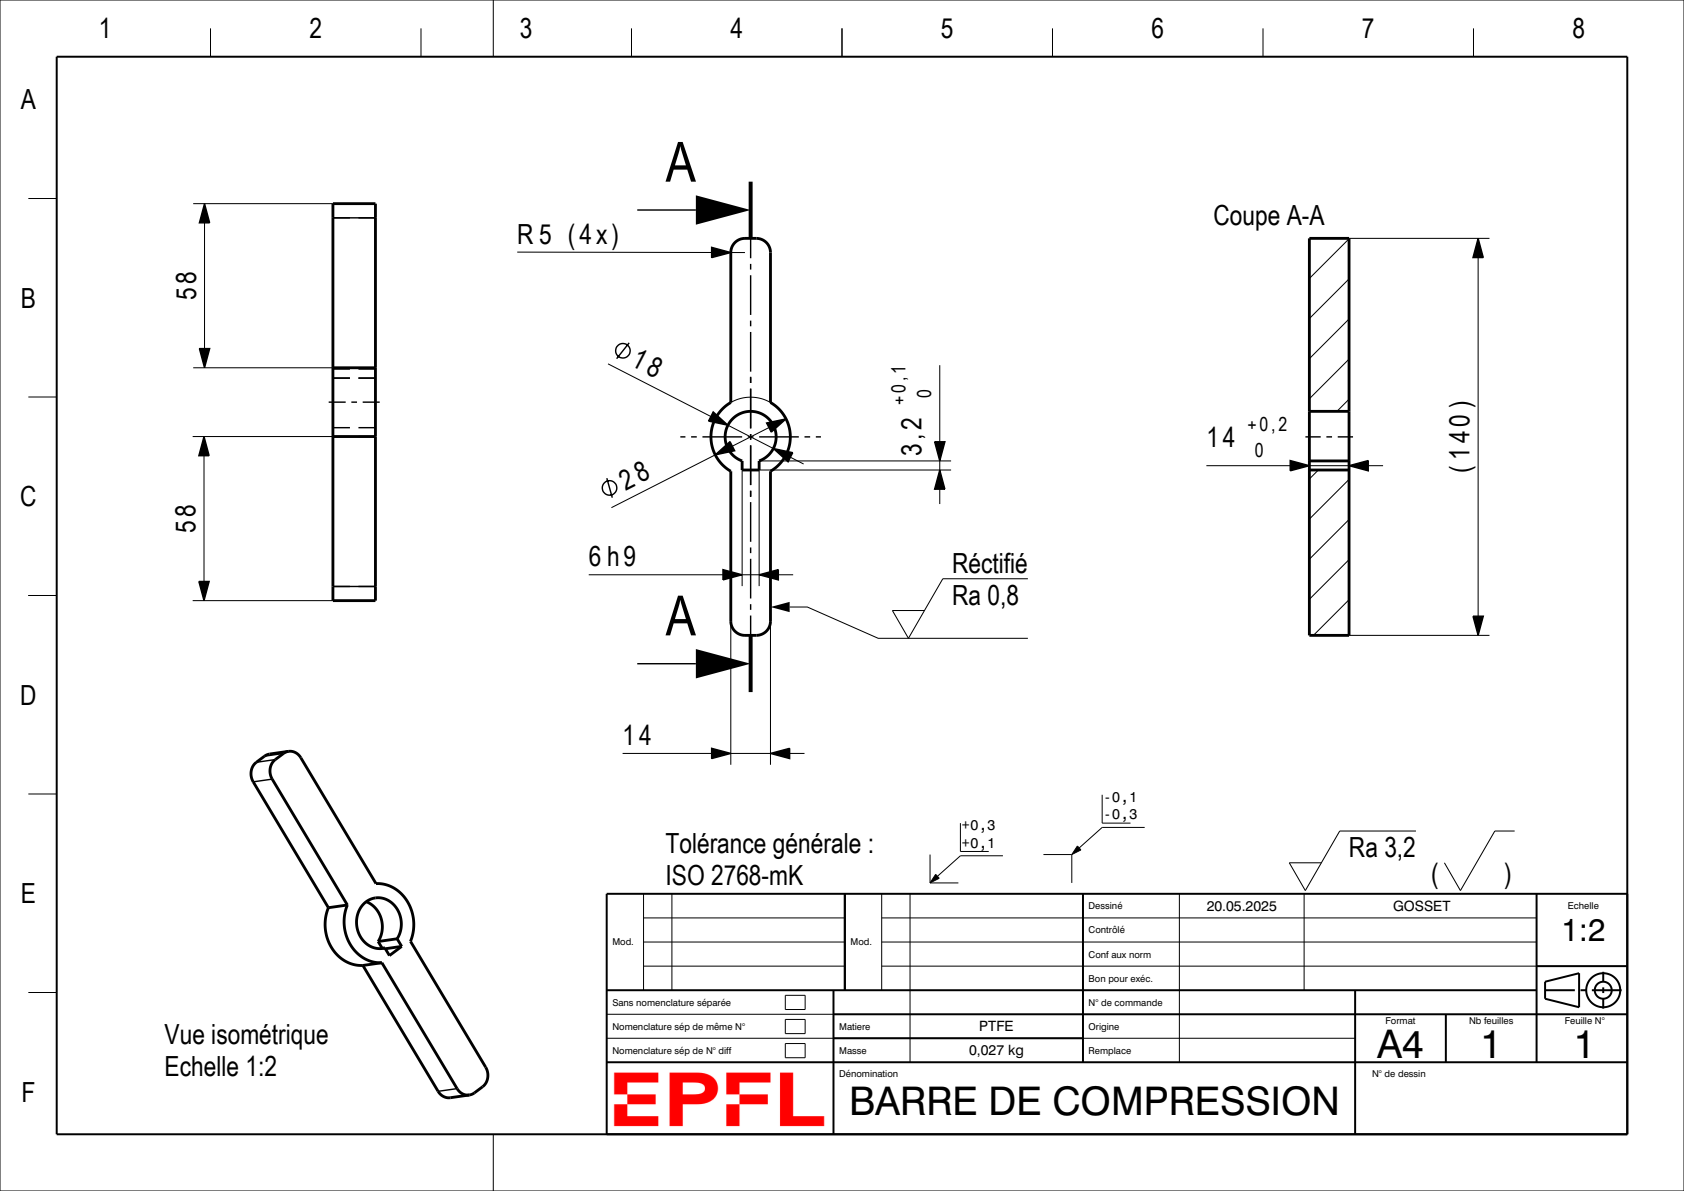
[picture p95: page 92]
BARRE DE COMPRESSION; Tolérance générale : ISO 2768-mK; Réctifié; Coupe A-A; Vue isométrique Echelle 1:2

Mod. | | Mod. | | | Dessiné | 20.05.2025 | GOSSET | Echelle 1:2

Contrôlé

Conf aux norm

Bon pour exéc.

Sans nomenclature séparée | | | | N° de commande
Nomenclature sép de même N° | | Matiere | PTFE | Origine | | Format A4 | Nb feuilles 1 | Feuille N° 1
Nomenclature sép de N° diff | | Masse | 0,027 kg | Remplace

Dénomination | | | | N° de dessin

1 | 2 | 3 | 4 | 5 | 6 | 7 | 8
A

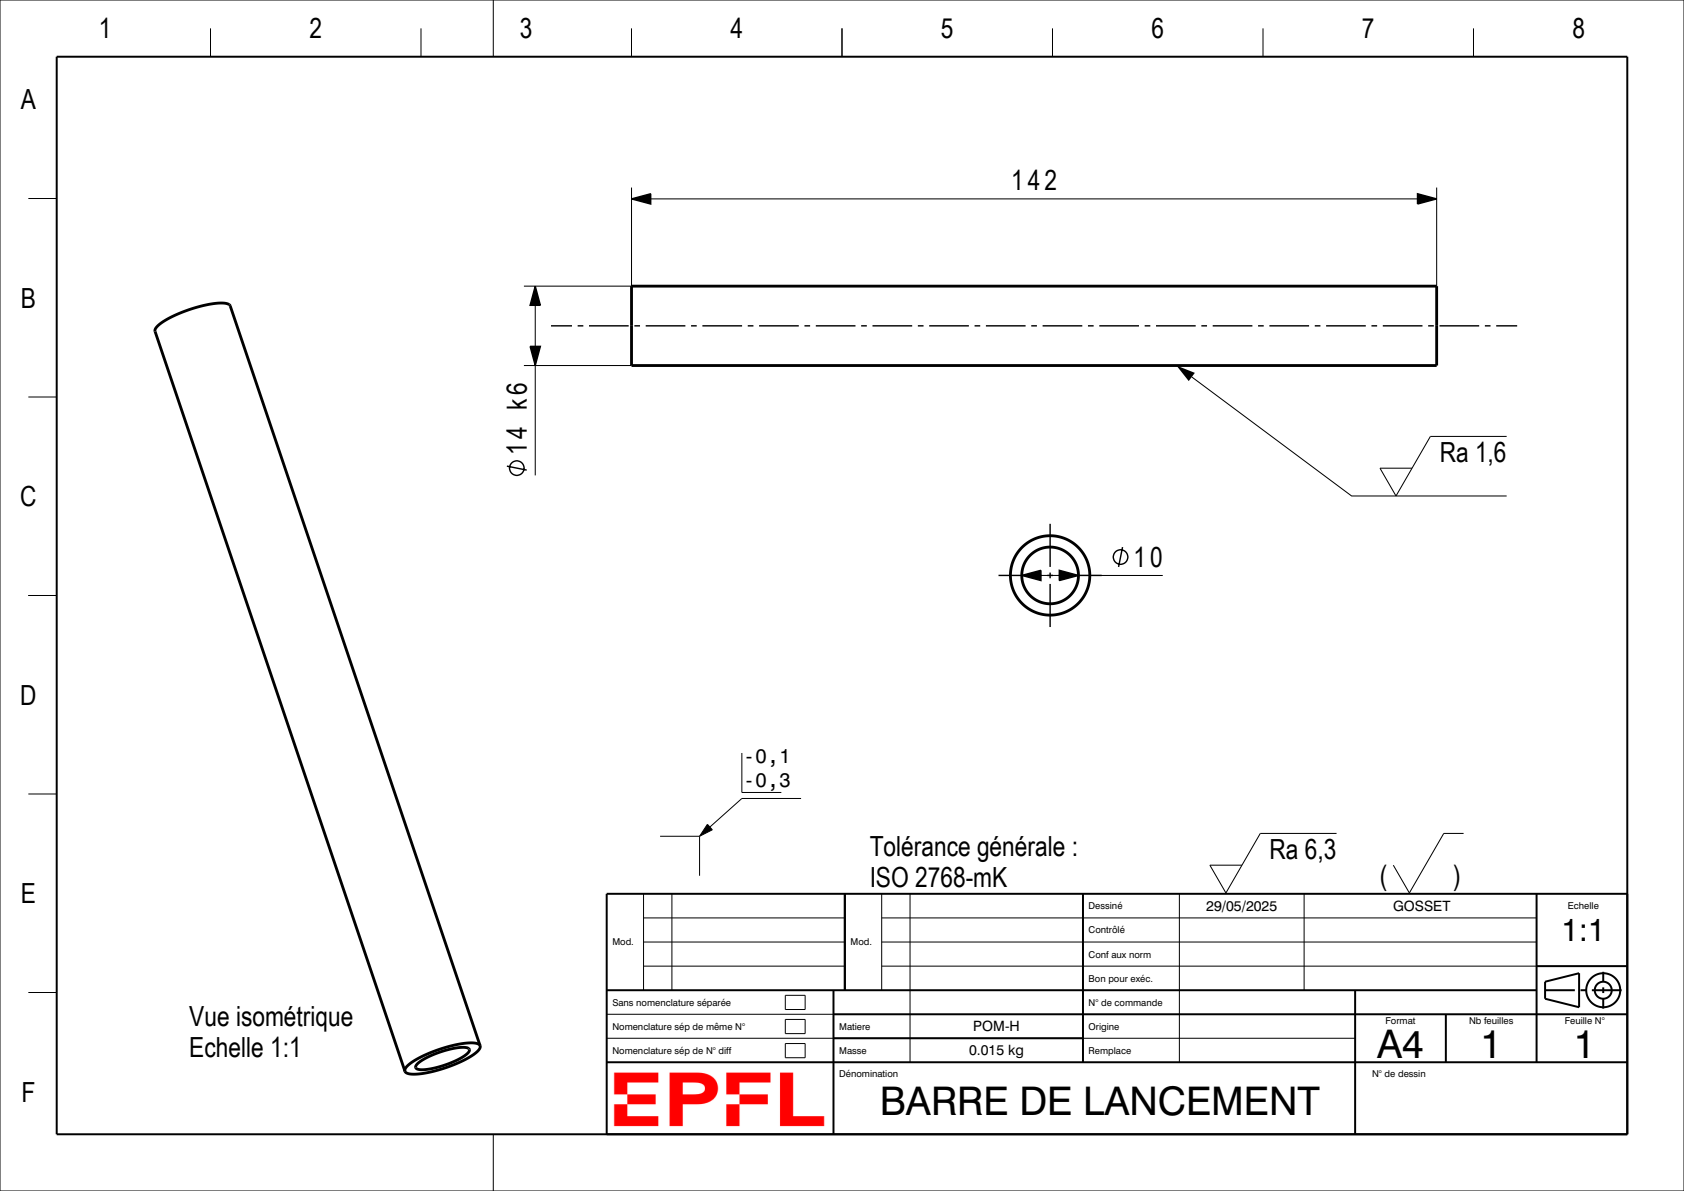
[picture p96: page 93]
BARRE DE LANCEMENT; Tolérance générale :; ISO 2768-mK; Vue isométrique Echelle 1:1

Mod. | | Mod. | | | Dessiné | 29/05/2025 | GOSSET | Echelle 1:1

Contrôlé

Conf aux norm

Bon pour exéc.

Sans nomenclature séparée | | | | N° de commande
Nomenclature sép de même N° | | Matiere | POM-H | Origine | | Format A4 | Nb feuilles 1 | Feuille N° 1
Nomenclature sép de N° diff | | Masse | 0.015 kg | Remplace

Dénomination | | | | N° de dessin

1 | 2 | 3 | 4 | 5 | 6 | 7 | 8
A

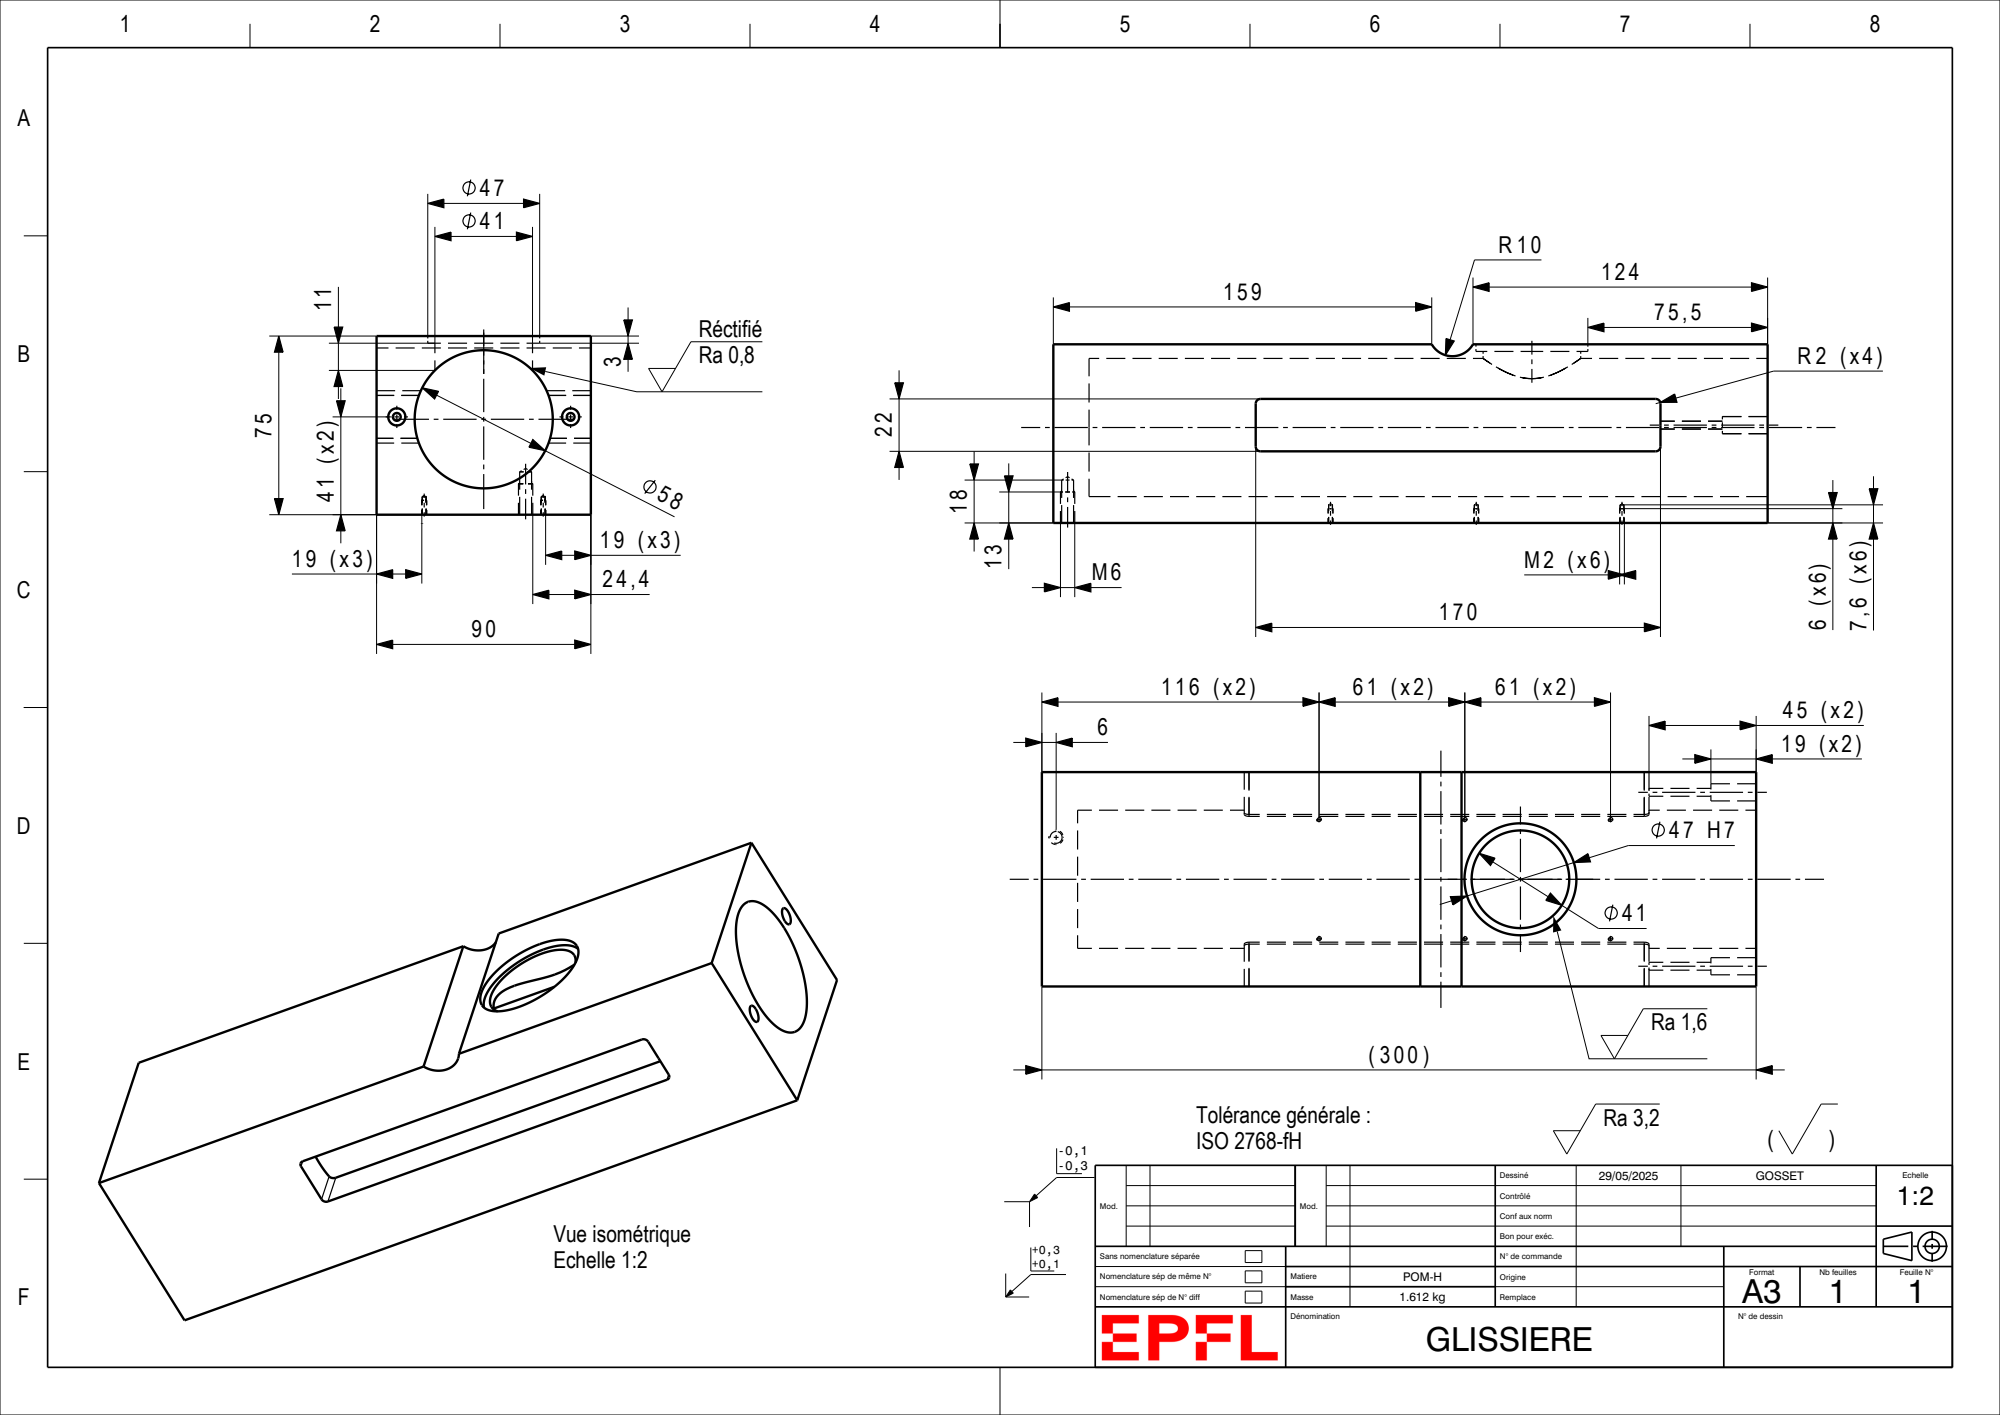
[picture p97: page 94]
Réctifié; Tolérance générale :; ISO 2768-fH; Vue isométrique Echelle 1:2

Mod. | | Mod. | | | Dessiné | 29/05/2025 | GOSSET | Echelle 1:2

Contrôlé

Conf aux norm

Bon pour exéc.

Sans nomenclature séparée | | | | N° de commande
Nomenclature sép de même N° | | Matiere | POM-H | Origine | | Format A3 | Nb feuilles 1 | Feuille N° 1
Nomenclature sép de N° diff | | Masse | 1.612 kg | Remplace

Dénomination GLISSIERE | | | | N° de dessin

1 | 2 | 3 | 4 | 5 | 6 | 7 | 8
A

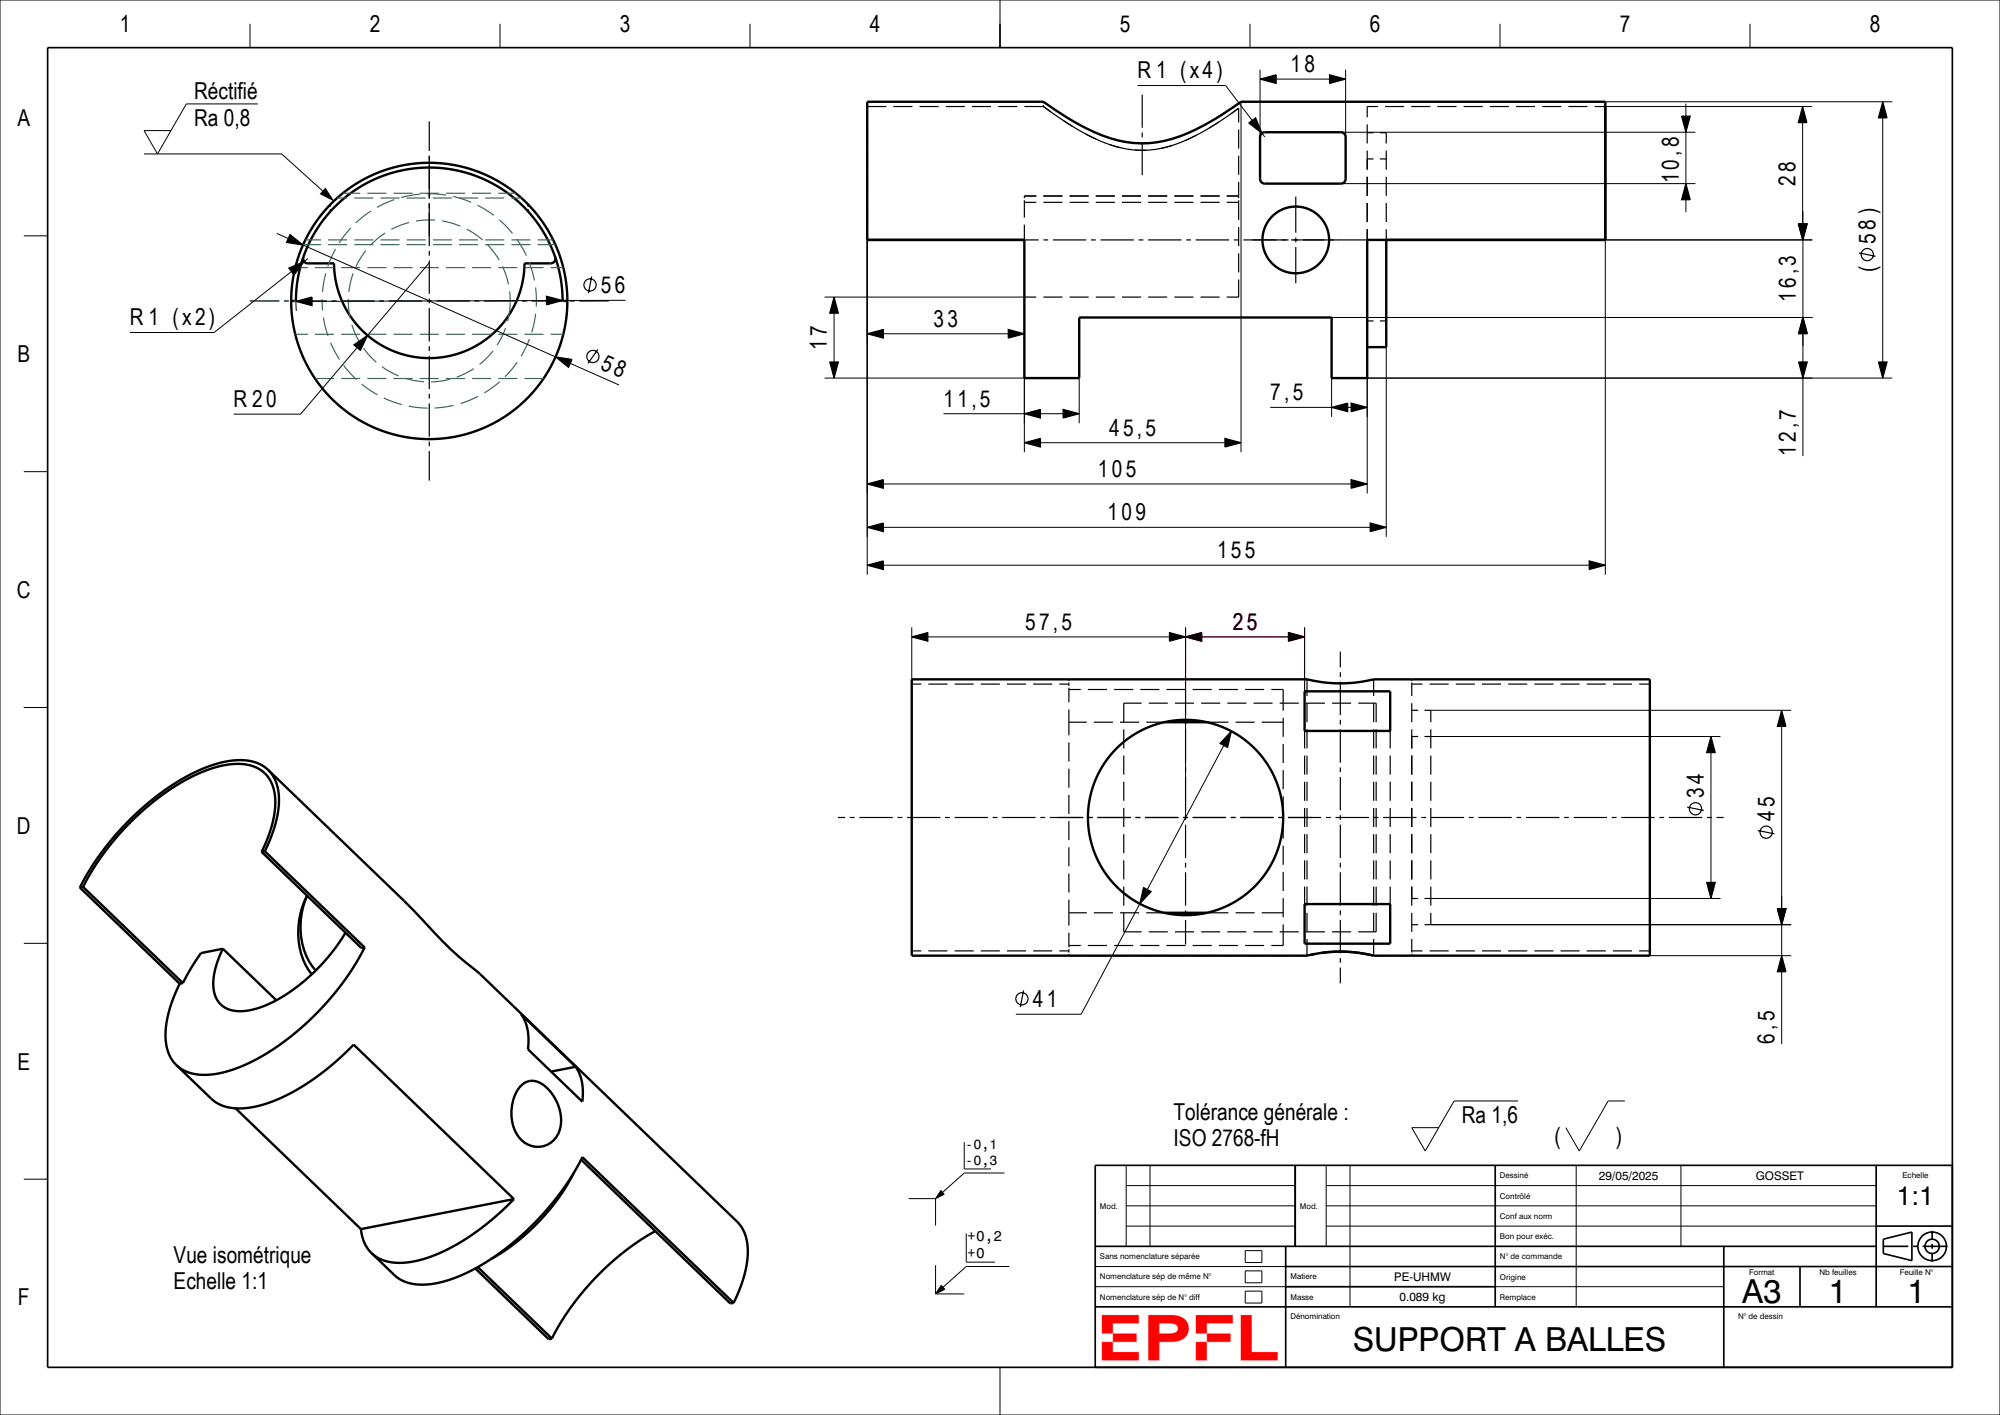
[picture p98: page 95]
Réctifié; Tolérance générale :; ISO 2768-fH; Vue isométrique Echelle 1:1

Mod. | | Mod. | | | Dessiné | 29/05/2025 | GOSSET | Echelle 1:1

Contrôlé

Conf aux norm

Bon pour exéc.

Sans nomenclature séparée | | | | N° de commande
Nomenclature sép de même N° | | Matiere | PE-UHMW | Origine | | Format A3 | Nb feuilles 1 | Feuille N° 1
Nomenclature sép de N° diff | | Masse | 0.089 kg | Remplace

Dénomination SUPPORT A BALLES | | | | N° de dessin

1 | 2 | 3 | 4 | 5 | 6 | 7 | 8
A

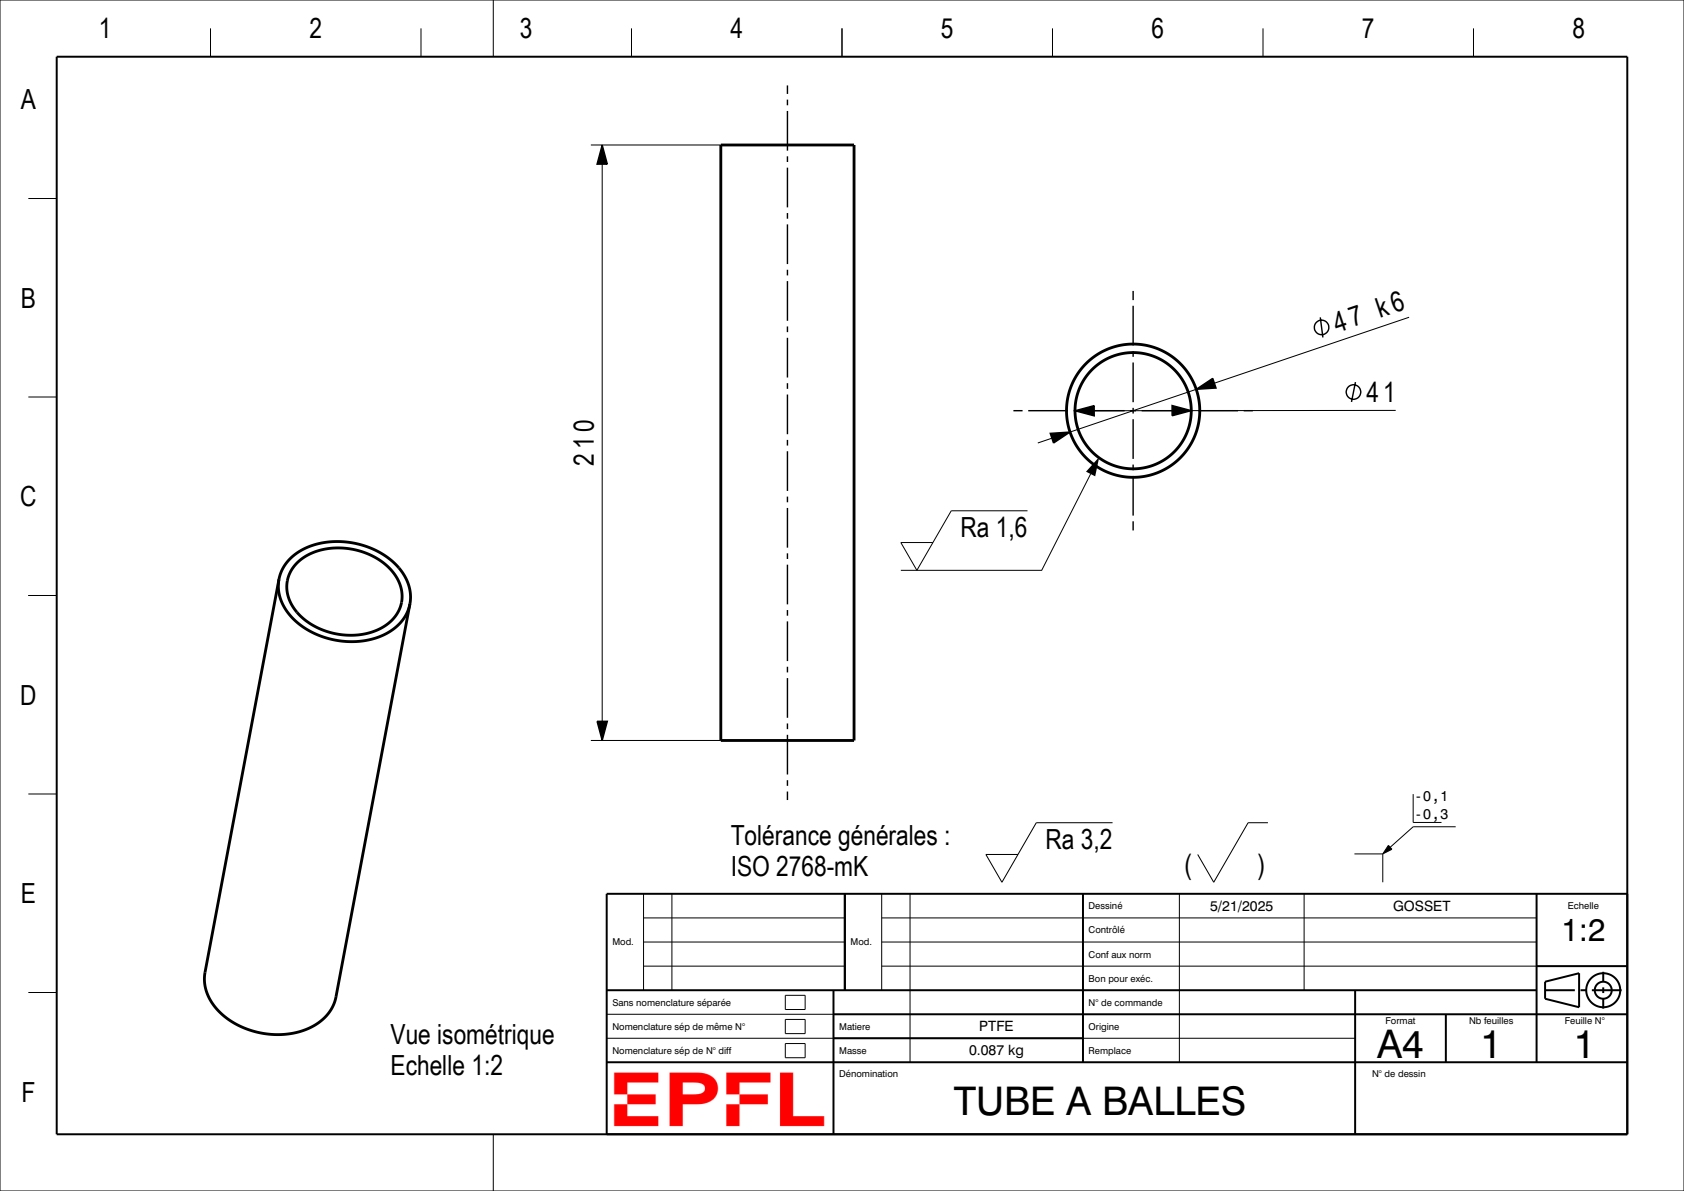
[picture p99: page 96]
TUBE A BALLES; Tolérance générales : ISO 2768-mK; Vue isométrique Echelle 1:2

Mod. | | Mod. | | | Dessiné | 5/21/2025 | GOSSET | Echelle 1:2

Contrôlé

Conf aux norm

Bon pour exéc.

Sans nomenclature séparée | | | | N° de commande
Nomenclature sép de même N° | | Matiere | PTFE | Origine | | Format A4 | Nb feuilles 1 | Feuille N° 1
Nomenclature sép de N° diff | | Masse | 0.087 kg | Remplace

Dénomination | | | | N° de dessin

1 | 2 | 3 | 4 | 5 | 6 | 7 | 8
A

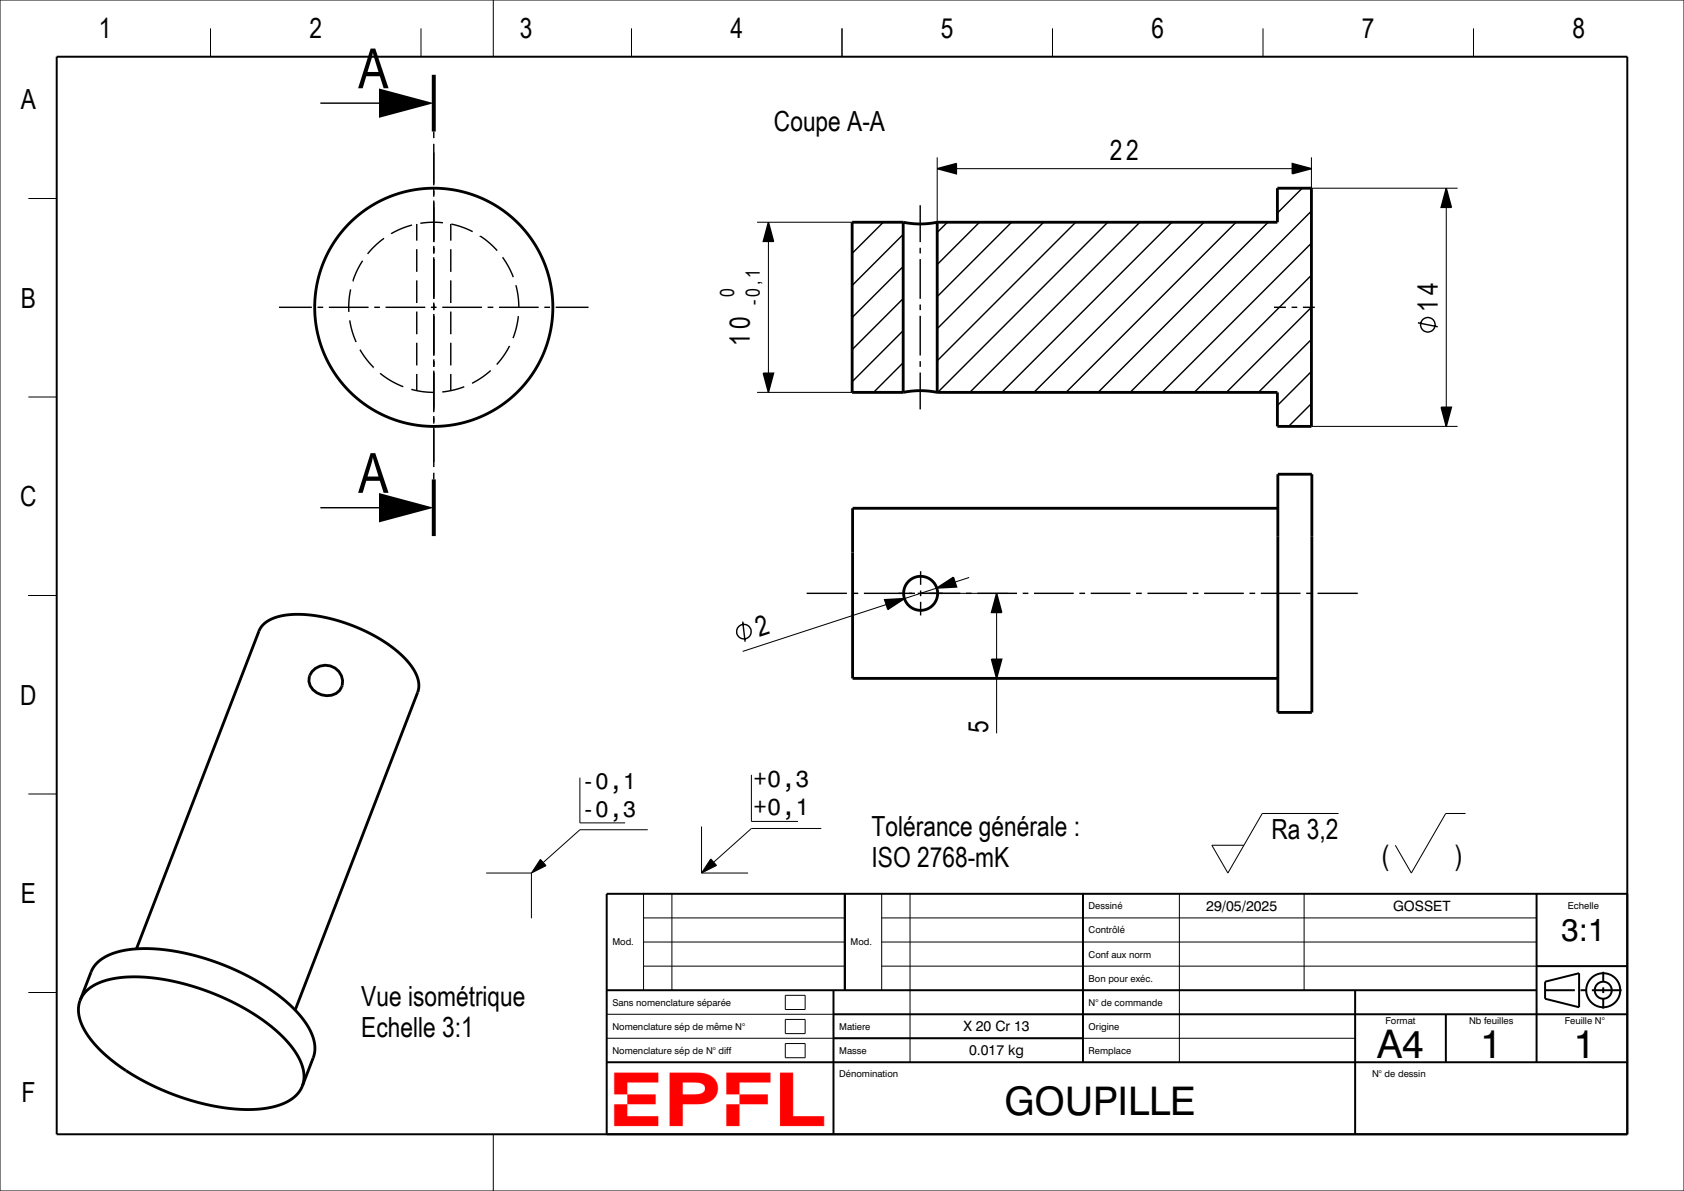
[picture p100: page 97]
GOUPILLE; Tolérance générale :; ISO 2768-mK; Vue isométrique Echelle 3:1; Coupe A-A

Mod. | | Mod. | | | Dessiné | 29/05/2025 | GOSSET | Echelle 3:1

Contrôlé

Conf aux norm

Bon pour exéc.

Sans nomenclature séparée | | | | N° de commande
Nomenclature sép de même N° | | Matiere | X 20 Cr 13 | Origine | | Format A4 | Nb feuilles 1 | Feuille N° 1
Nomenclature sép de N° diff | | Masse | 0.017 kg | Remplace

Dénomination | | | | N° de dessin

1 | 2 | 3 | 4 | 5 | 6 | 7 | 8
A

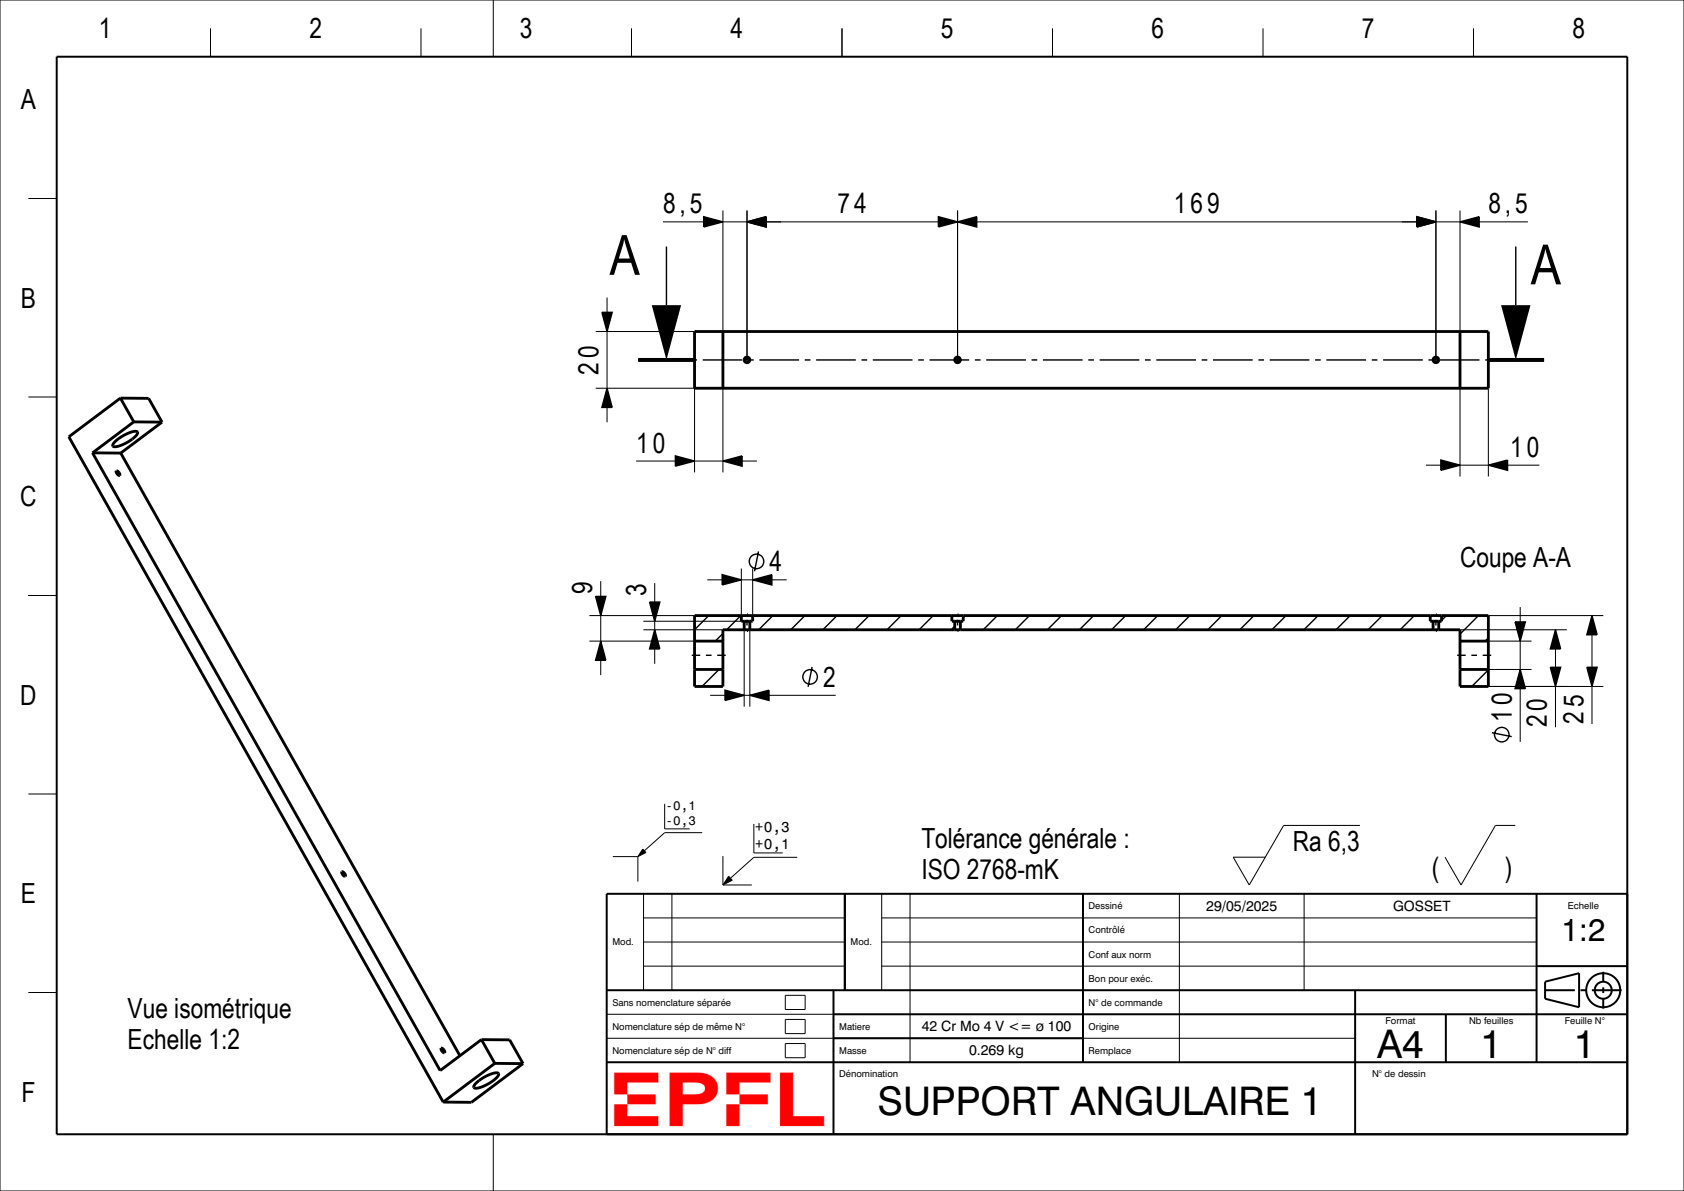
[picture p101: page 98]
SUPPORT ANGULAIRE 1; Tolérance générale : ISO 2768-mK; Coupe A-A; Vue isométrique Echelle 1:2

Mod. | | Mod. | | | Dessiné | 29/05/2025 | GOSSET | Echelle 1:2

Contrôlé

Conf aux norm

Bon pour exéc.

Sans nomenclature séparée | | | | N° de commande
Nomenclature sép de même N° | | Matiere | 42 Cr Mo 4 V <= ø 100 | Origine | | Format A4 | Nb feuilles 1 | Feuille N° 1
Nomenclature sép de N° diff | | Masse | 0.269 kg | Remplace

Dénomination | | | | N° de dessin

1 | 2 | 3 | 4 | 5 | 6 | 7 | 8
A

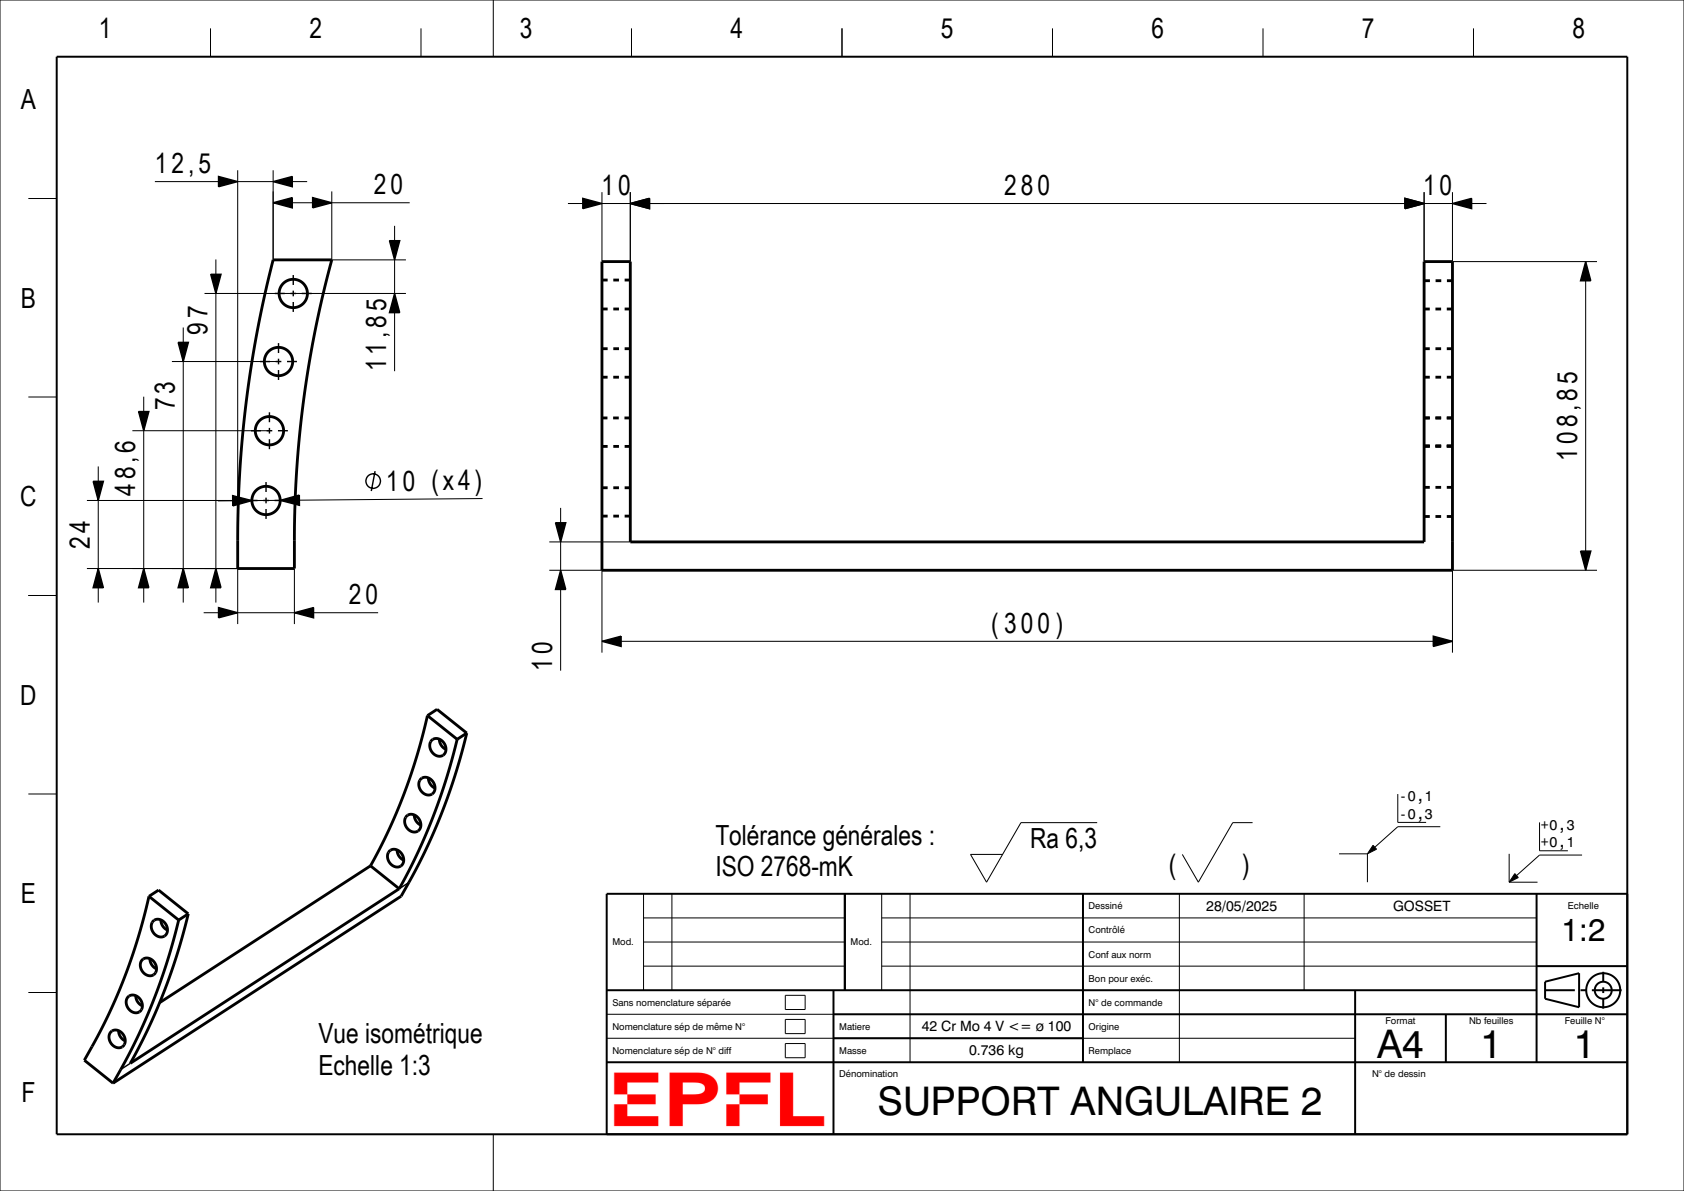
[picture p102: page 99]
SUPPORT ANGULAIRE 2; Tolérance générales : ISO 2768-mK; Vue isométrique Echelle 1:3

Mod. | | Mod. | | | Dessiné | 28/05/2025 | GOSSET | Echelle 1:2

Contrôlé

Conf aux norm

Bon pour exéc.

Sans nomenclature séparée | | | | N° de commande
Nomenclature sép de même N° | | Matiere | 42 Cr Mo 4 V <= ø 100 | Origine | | Format A4 | Nb feuilles 1 | Feuille N° 1
Nomenclature sép de N° diff | | Masse | 0.736 kg | Remplace

Dénomination | | | | N° de dessin

1 | 2 | 3 | 4 | 5 | 6 | 7 | 8
A

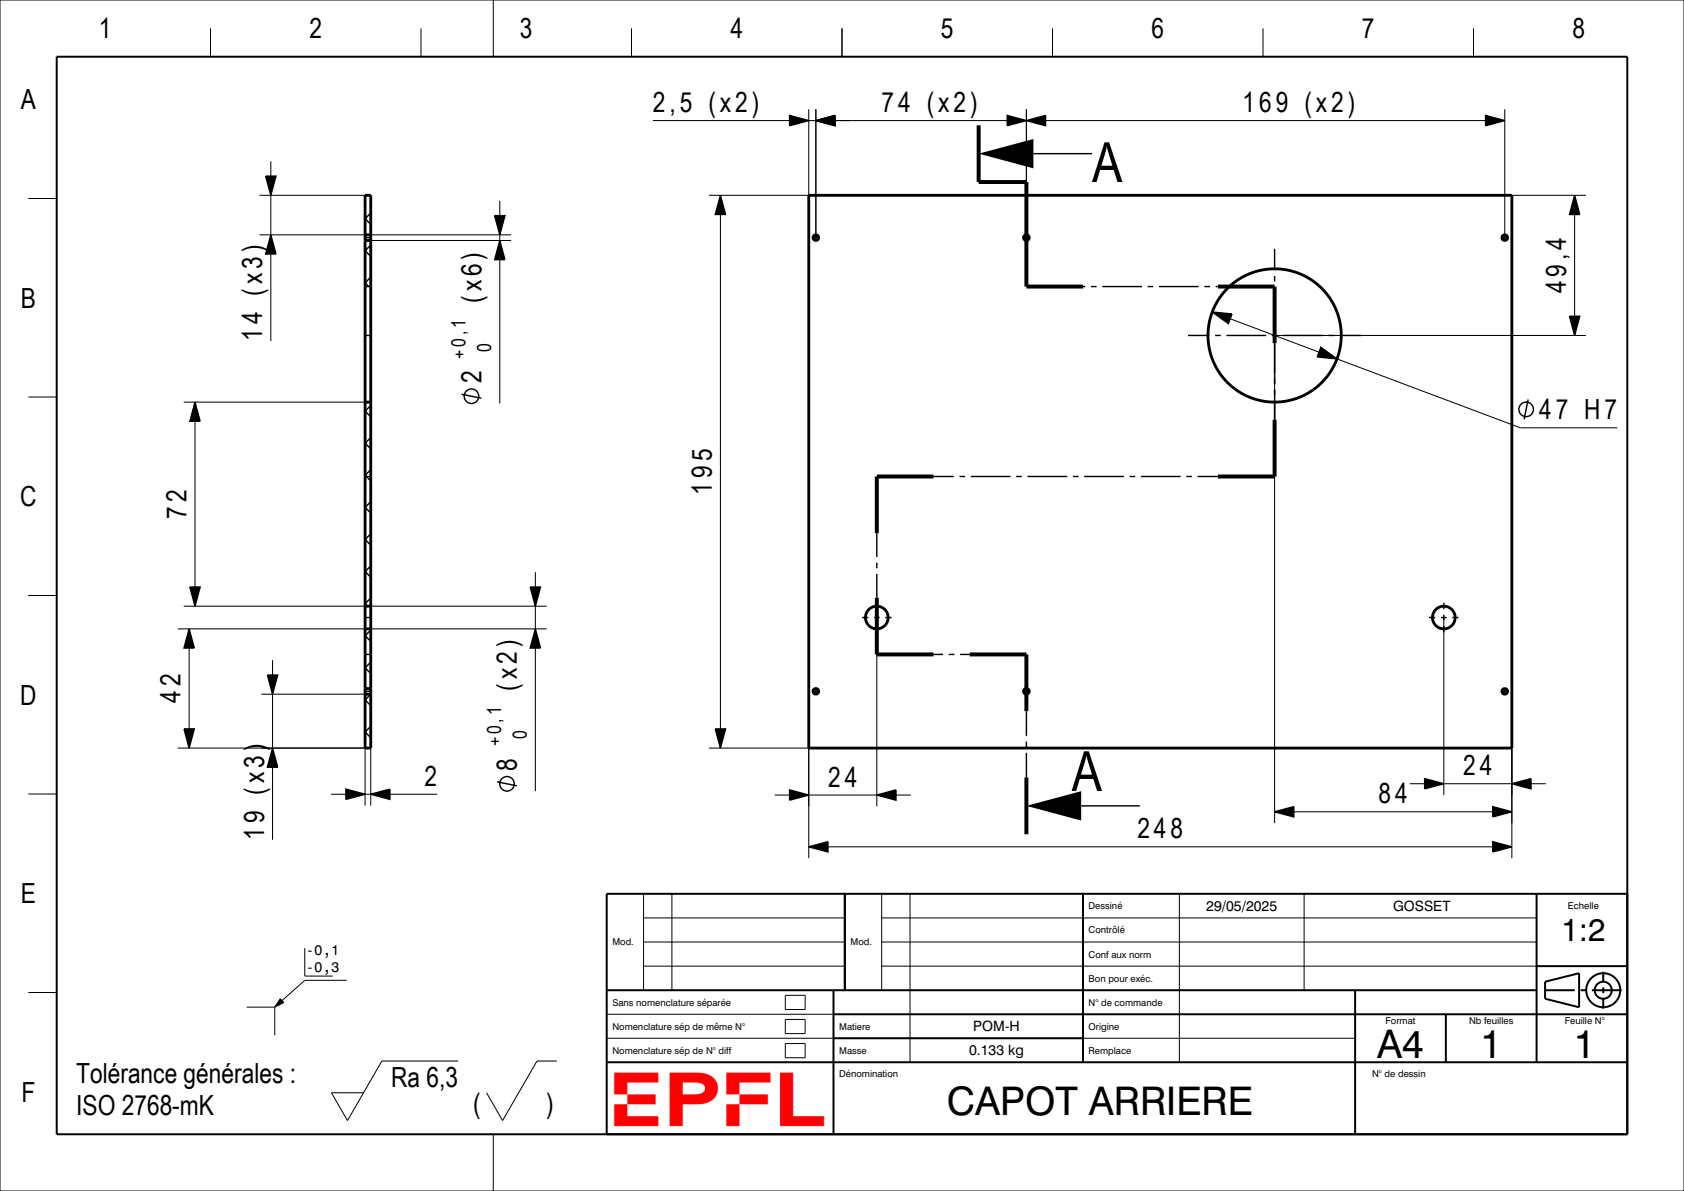
[picture p103: page 100]
CAPOT ARRIERE; Tolérance générales : ISO 2768-mK

Mod. | | Mod. | | | Dessiné | 29/05/2025 | GOSSET | Echelle 1:2

Contrôlé

Conf aux norm

Bon pour exéc.

Sans nomenclature séparée | | | | N° de commande
Nomenclature sép de même N° | | Matiere | POM-H | Origine | | Format A4 | Nb feuilles 1 | Feuille N° 1
Nomenclature sép de N° diff | | Masse | 0.133 kg | Remplace

Dénomination | | | | N° de dessin

1 | 2 | 3 | 4 | 5 | 6 | 7 | 8
A

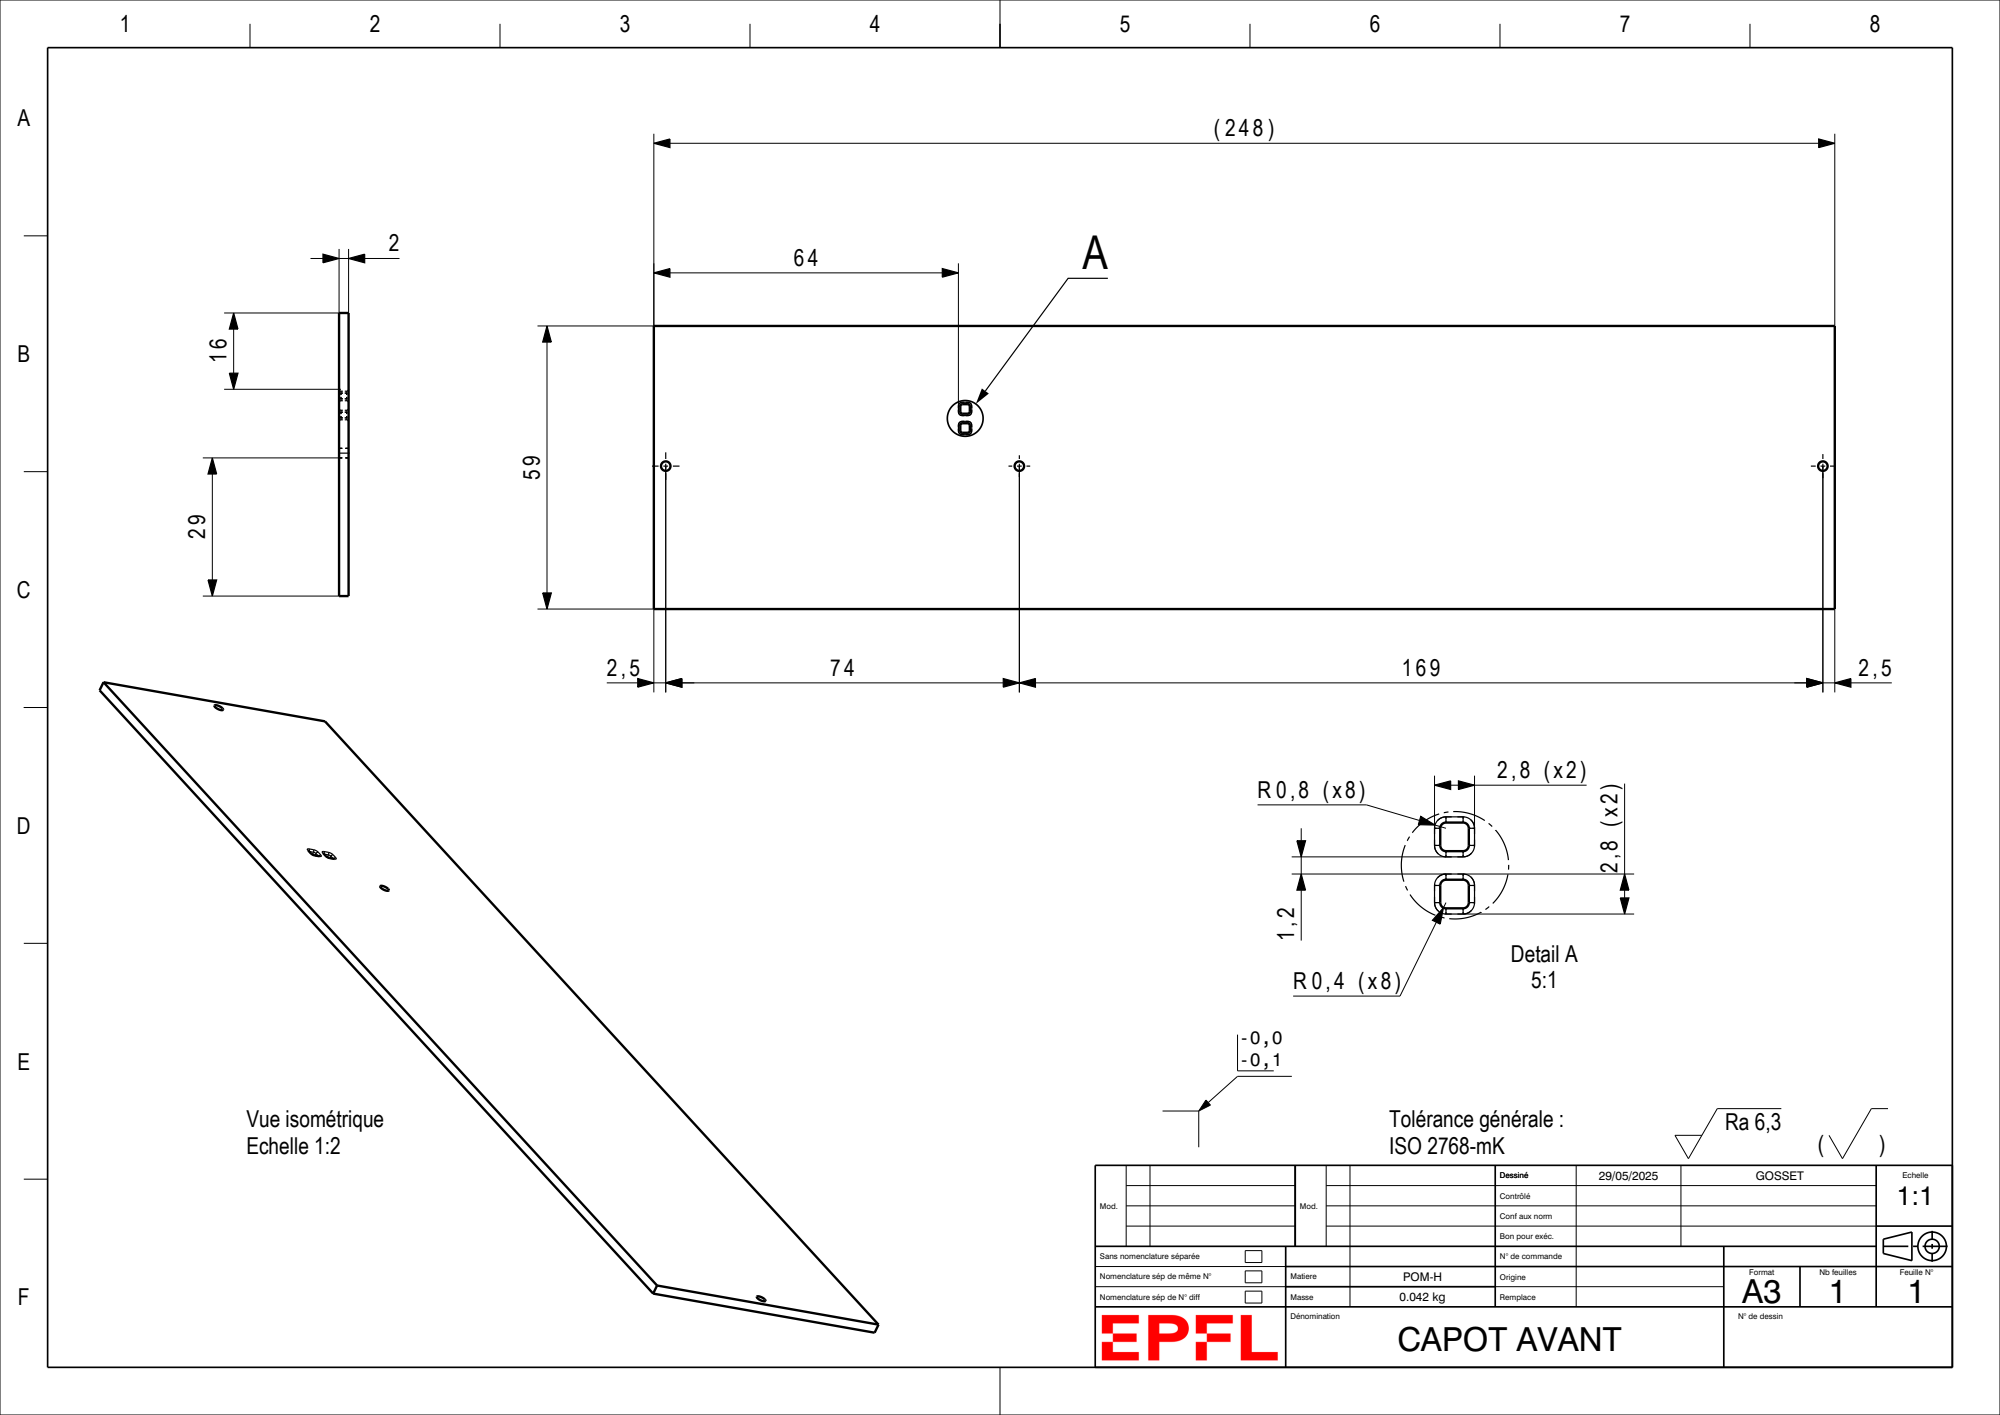
[picture p104: page 101]
Detail A 5:1; Tolérance générale :; ISO 2768-mK; Vue isométrique Echelle 1:2

Mod. | | Mod. | | | Dessiné | 29/05/2025 | GOSSET | Echelle 1:1

Contrôlé

Conf aux norm

Bon pour exéc.

Sans nomenclature séparée | | | | N° de commande
Nomenclature sép de même N° | | Matiere | POM-H | Origine | | Format A3 | Nb feuilles 1 | Feuille N° 1
Nomenclature sép de N° diff | | Masse | 0.042 kg | Remplace

Dénomination CAPOT AVANT | | | | N° de dessin

1 | 2 | 3 | 4 | 5 | 6 | 7 | 8
A

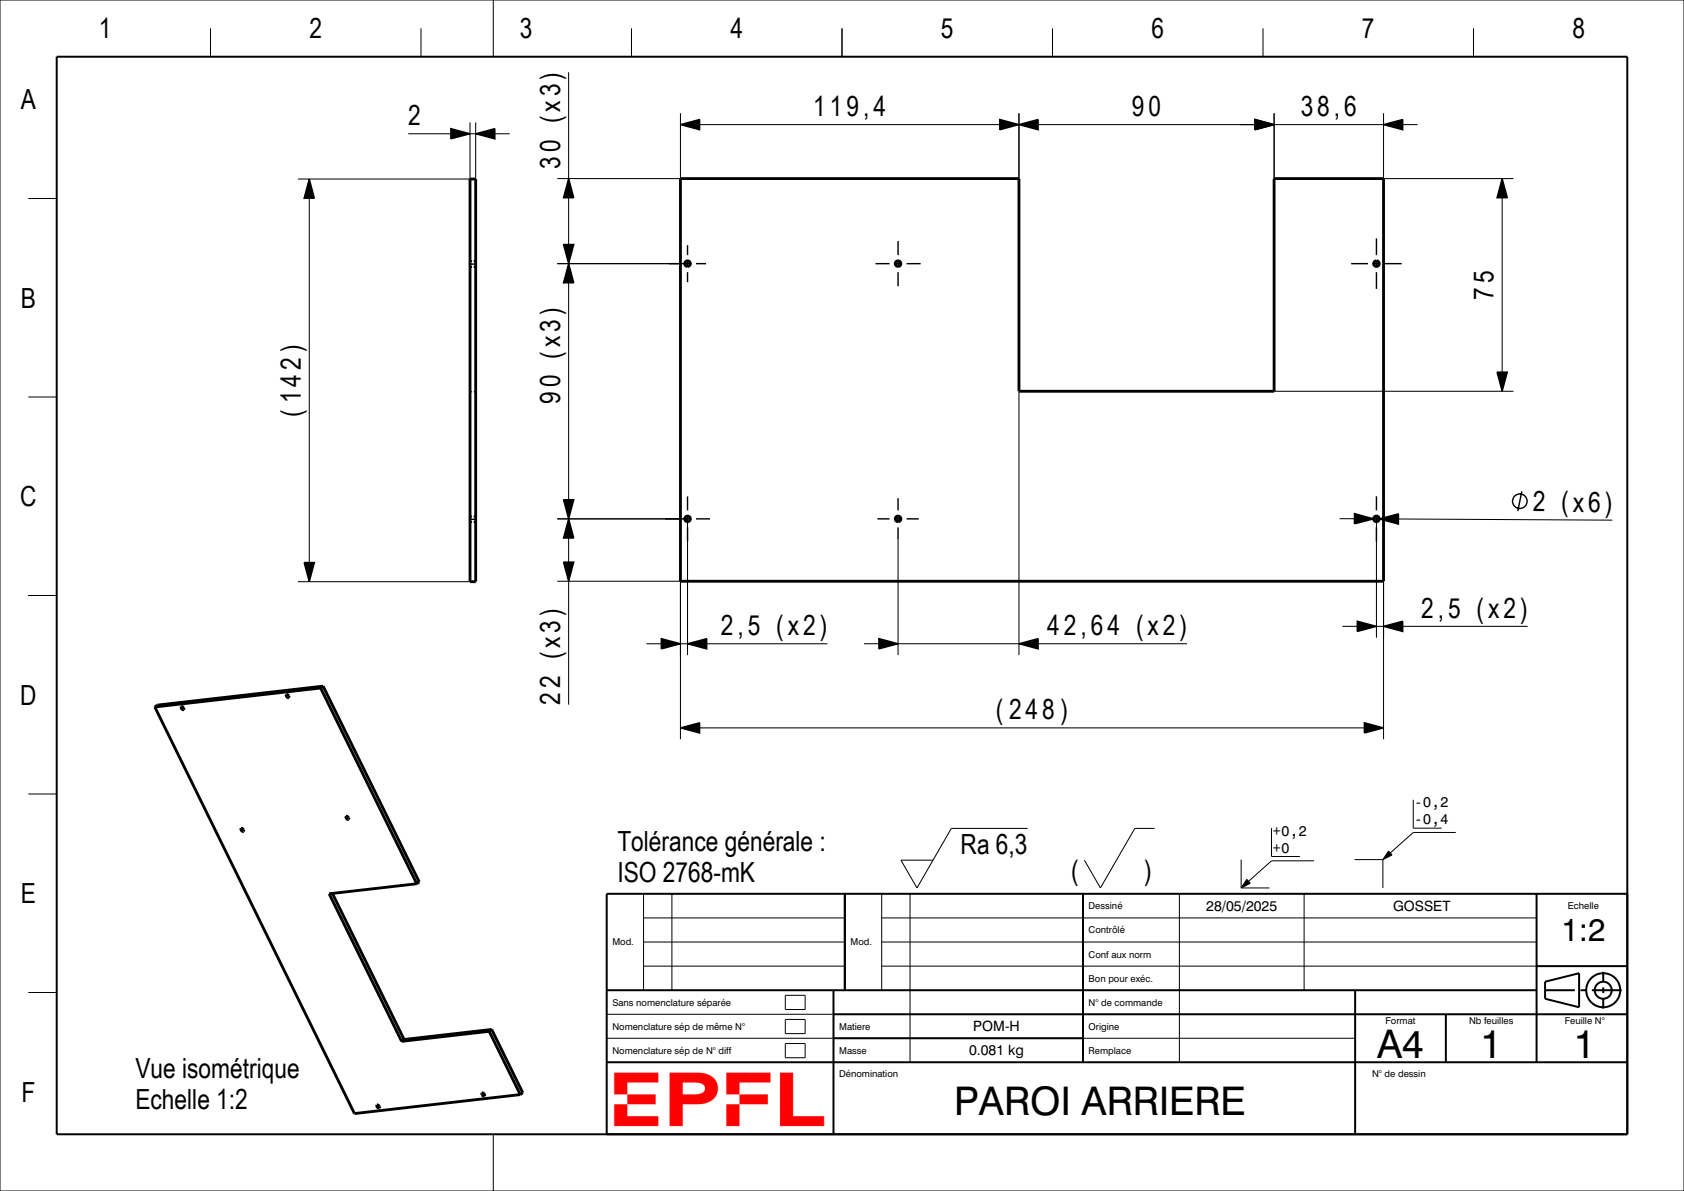
[picture p105: page 102]
PAROI ARRIERE; Tolérance générale : ISO 2768-mK; Vue isométrique Echelle 1:2

Mod. | | Mod. | | | Dessiné | 28/05/2025 | GOSSET | Echelle 1:2

Contrôlé

Conf aux norm

Bon pour exéc.

Sans nomenclature séparée | | | | N° de commande
Nomenclature sép de même N° | | Matiere | POM-H | Origine | | Format A4 | Nb feuilles 1 | Feuille N° 1
Nomenclature sép de N° diff | | Masse | 0.081 kg | Remplace

Dénomination | | | | N° de dessin

1 | 2 | 3 | 4 | 5 | 6 | 7 | 8
A

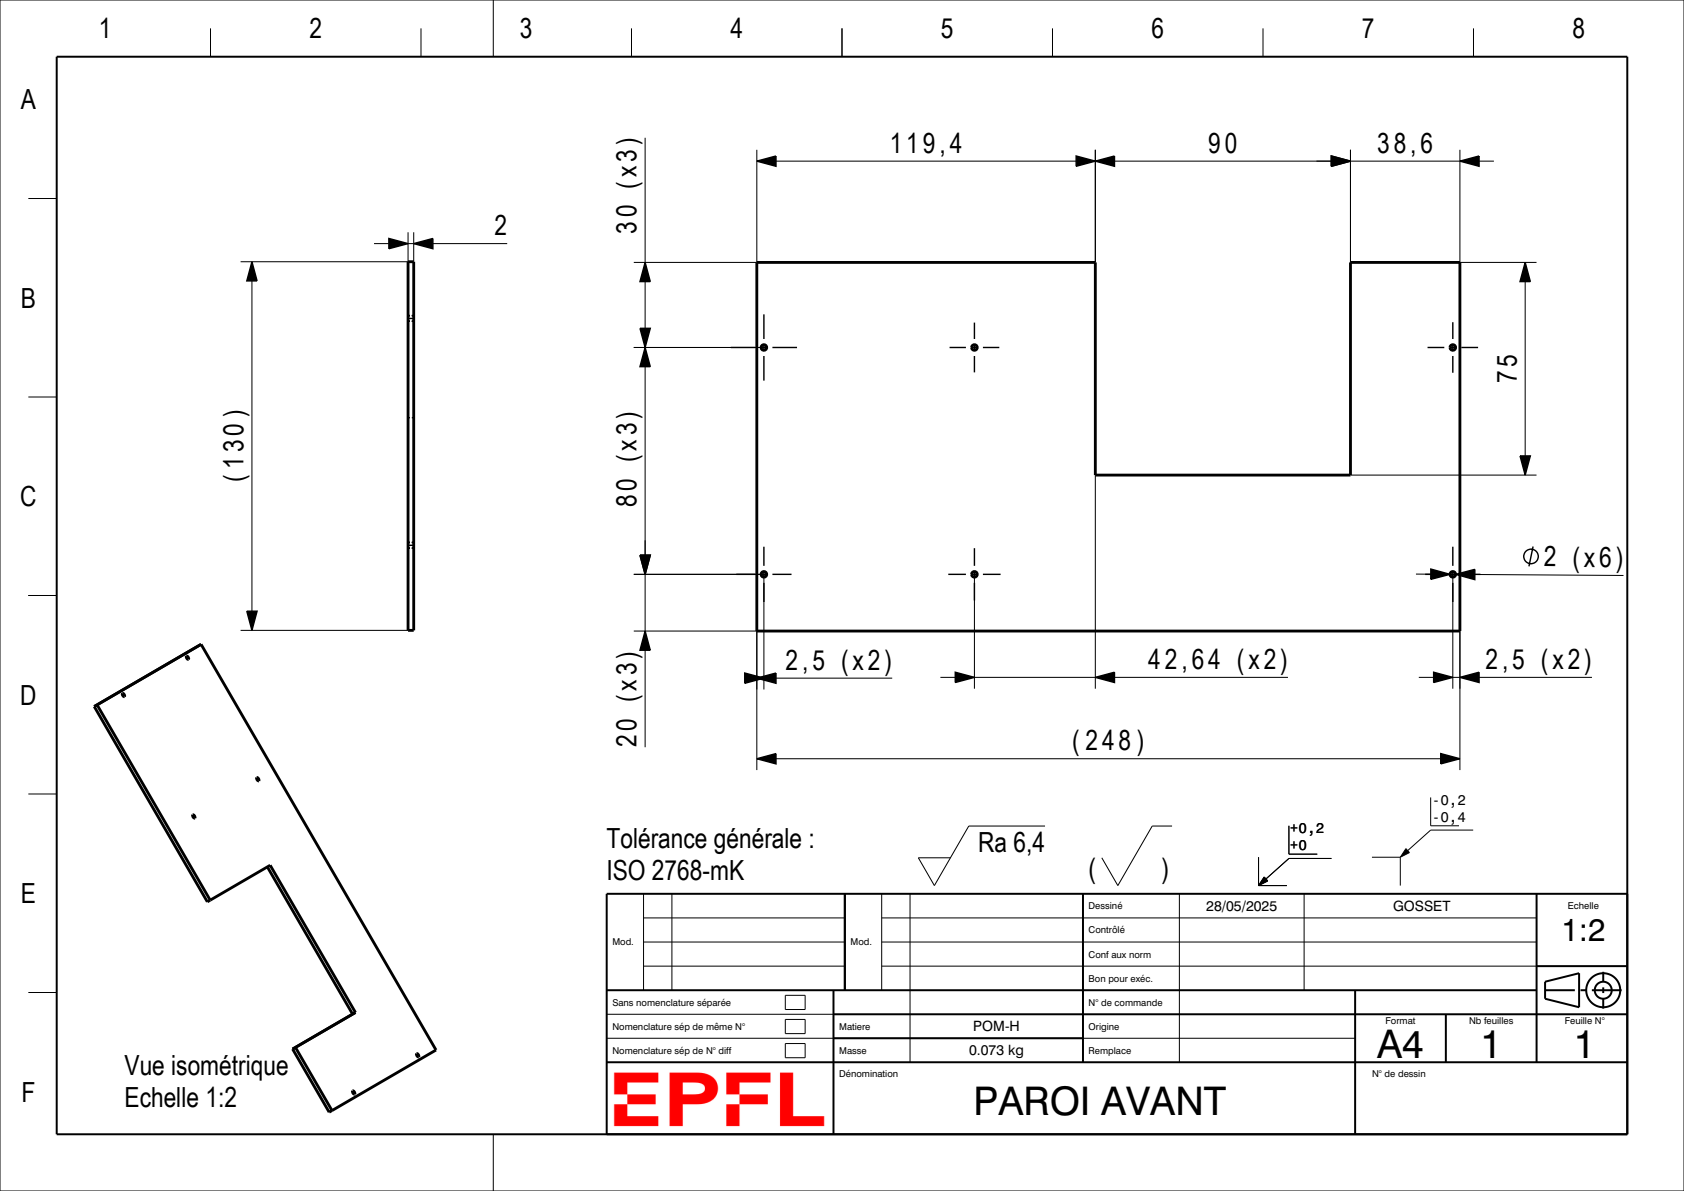
[picture p106: page 103]
PAROI AVANT; Tolérance générale :; ISO 2768-mK; Vue isométrique Echelle 1:2

Mod. | | Mod. | | | Dessiné | 28/05/2025 | GOSSET | Echelle 1:2

Contrôlé

Conf aux norm

Bon pour exéc.

Sans nomenclature séparée | | | | N° de commande
Nomenclature sép de même N° | | Matiere | POM-H | Origine | | Format A4 | Nb feuilles 1 | Feuille N° 1
Nomenclature sép de N° diff | | Masse | 0.073 kg | Remplace

Dénomination | | | | N° de dessin

1 | 2 | 3 | 4 | 5 | 6 | 7 | 8
A

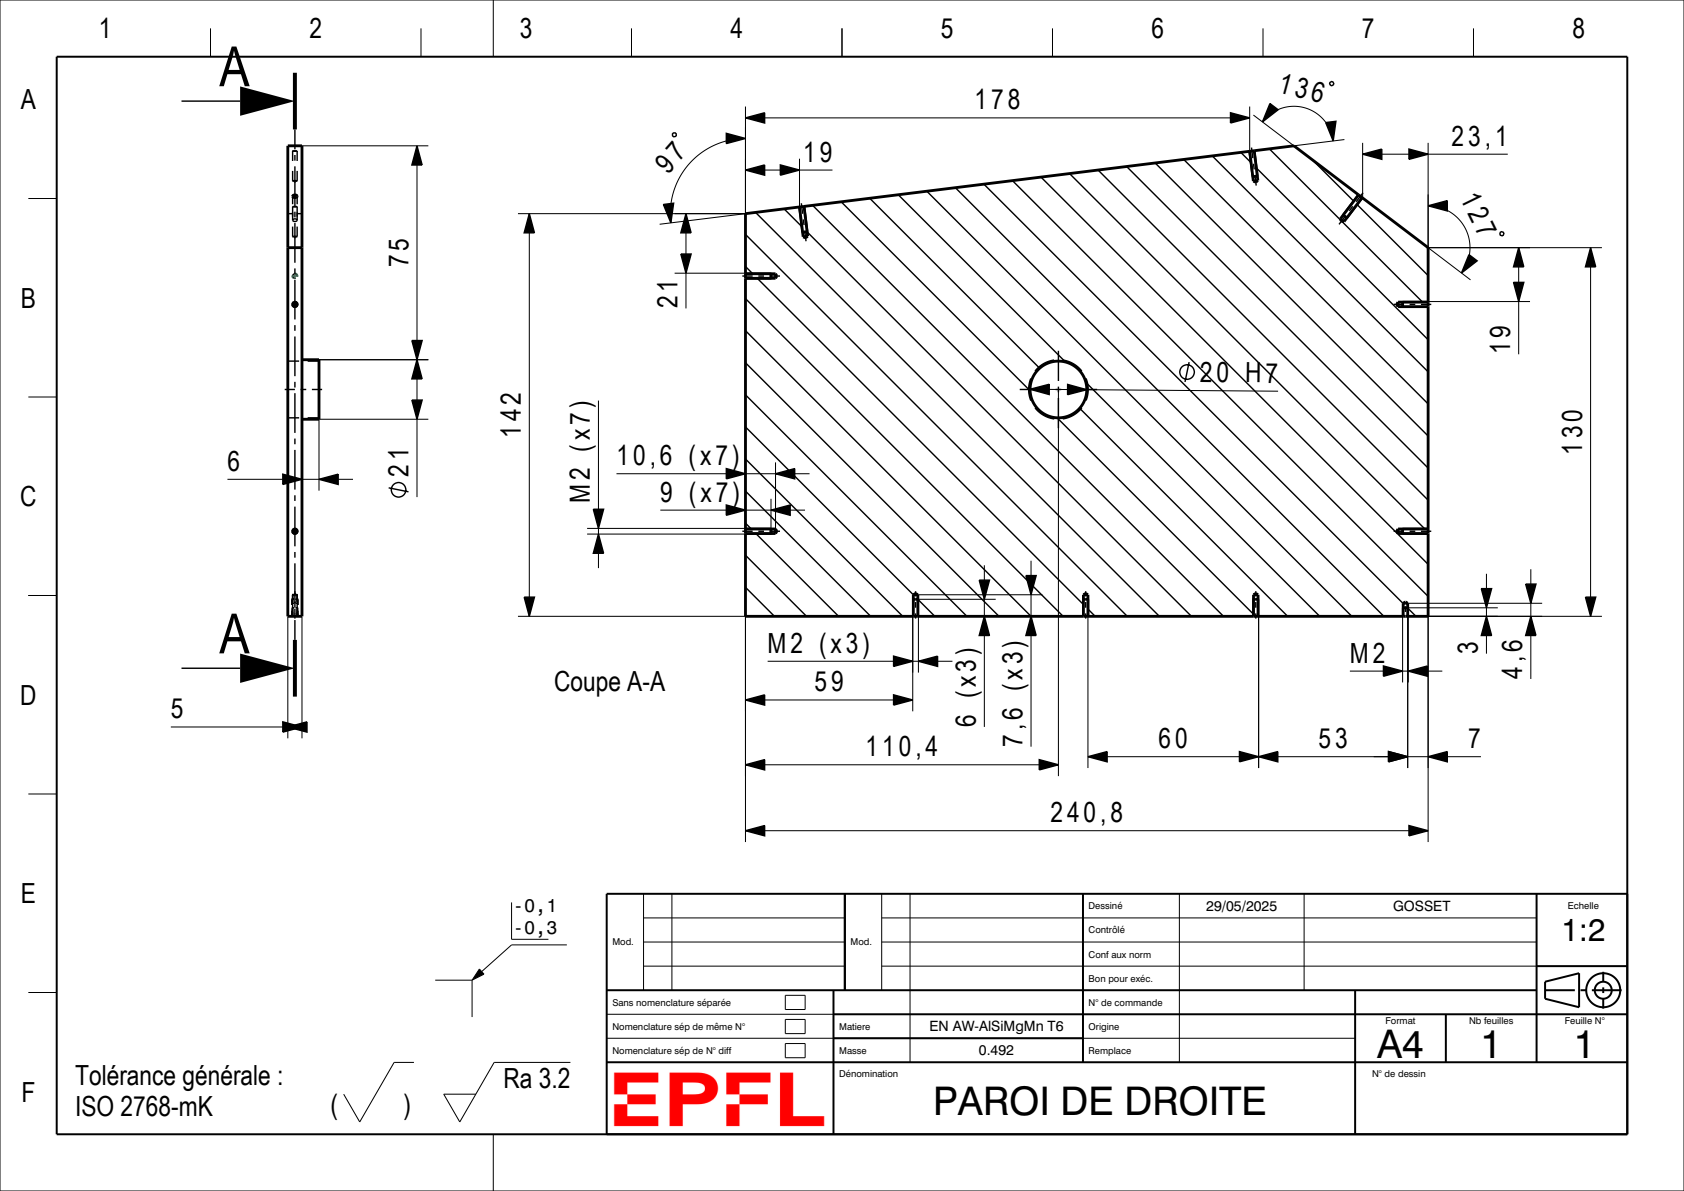
[picture p107: page 104]
PAROI DE DROITE; Tolérance générale : ISO 2768-mK; Coupe A-A

Mod. | | Mod. | | | Dessiné | 29/05/2025 | GOSSET | Echelle 1:2

Contrôlé

Conf aux norm

Bon pour exéc.

Sans nomenclature séparée | | | | N° de commande
Nomenclature sép de même N° | | Matiere | EN AW-AlSiMgMn T6 | Origine | | Format A4 | Nb feuilles 1 | Feuille N° 1
Nomenclature sép de N° diff | | Masse | 0.492 | Remplace

Dénomination | | | | N° de dessin

1 2 | 3 4 5 6 7 8
| 27,3

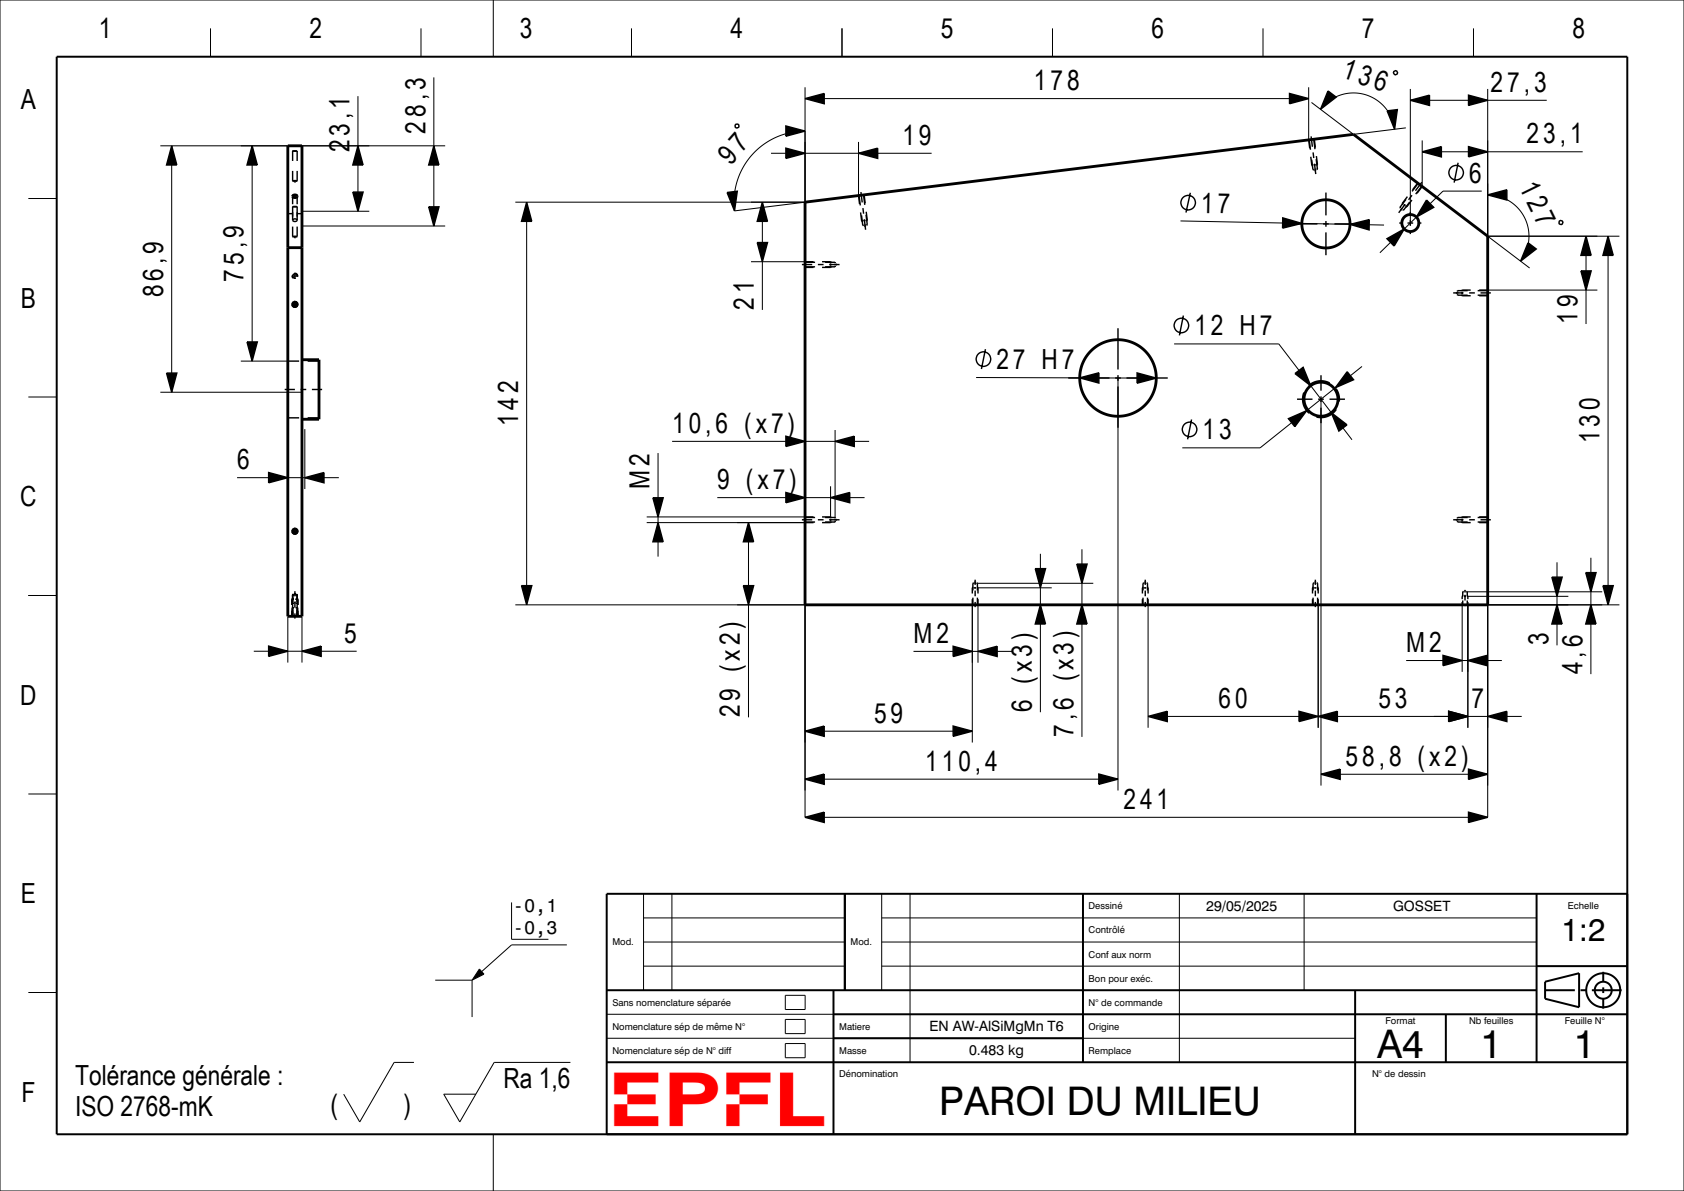
[picture p108: page 105]
PAROI DU MILIEU; Tolérance générale : ISO 2768-mK

Mod. | | Mod. | | | Dessiné | 29/05/2025 | GOSSET | Echelle 1:2

Contrôlé

Conf aux norm

Bon pour exéc.

Sans nomenclature séparée | | | | N° de commande
Nomenclature sép de même N° | | Matiere | EN AW-AlSiMgMn T6 | Origine | | Format A4 | Nb feuilles 1 | Feuille N° 1
Nomenclature sép de N° diff | | Masse | 0.483 kg | Remplace

Dénomination | | | | N° de dessin

1 2 | 3 4 5 6 7 8
| 27,3

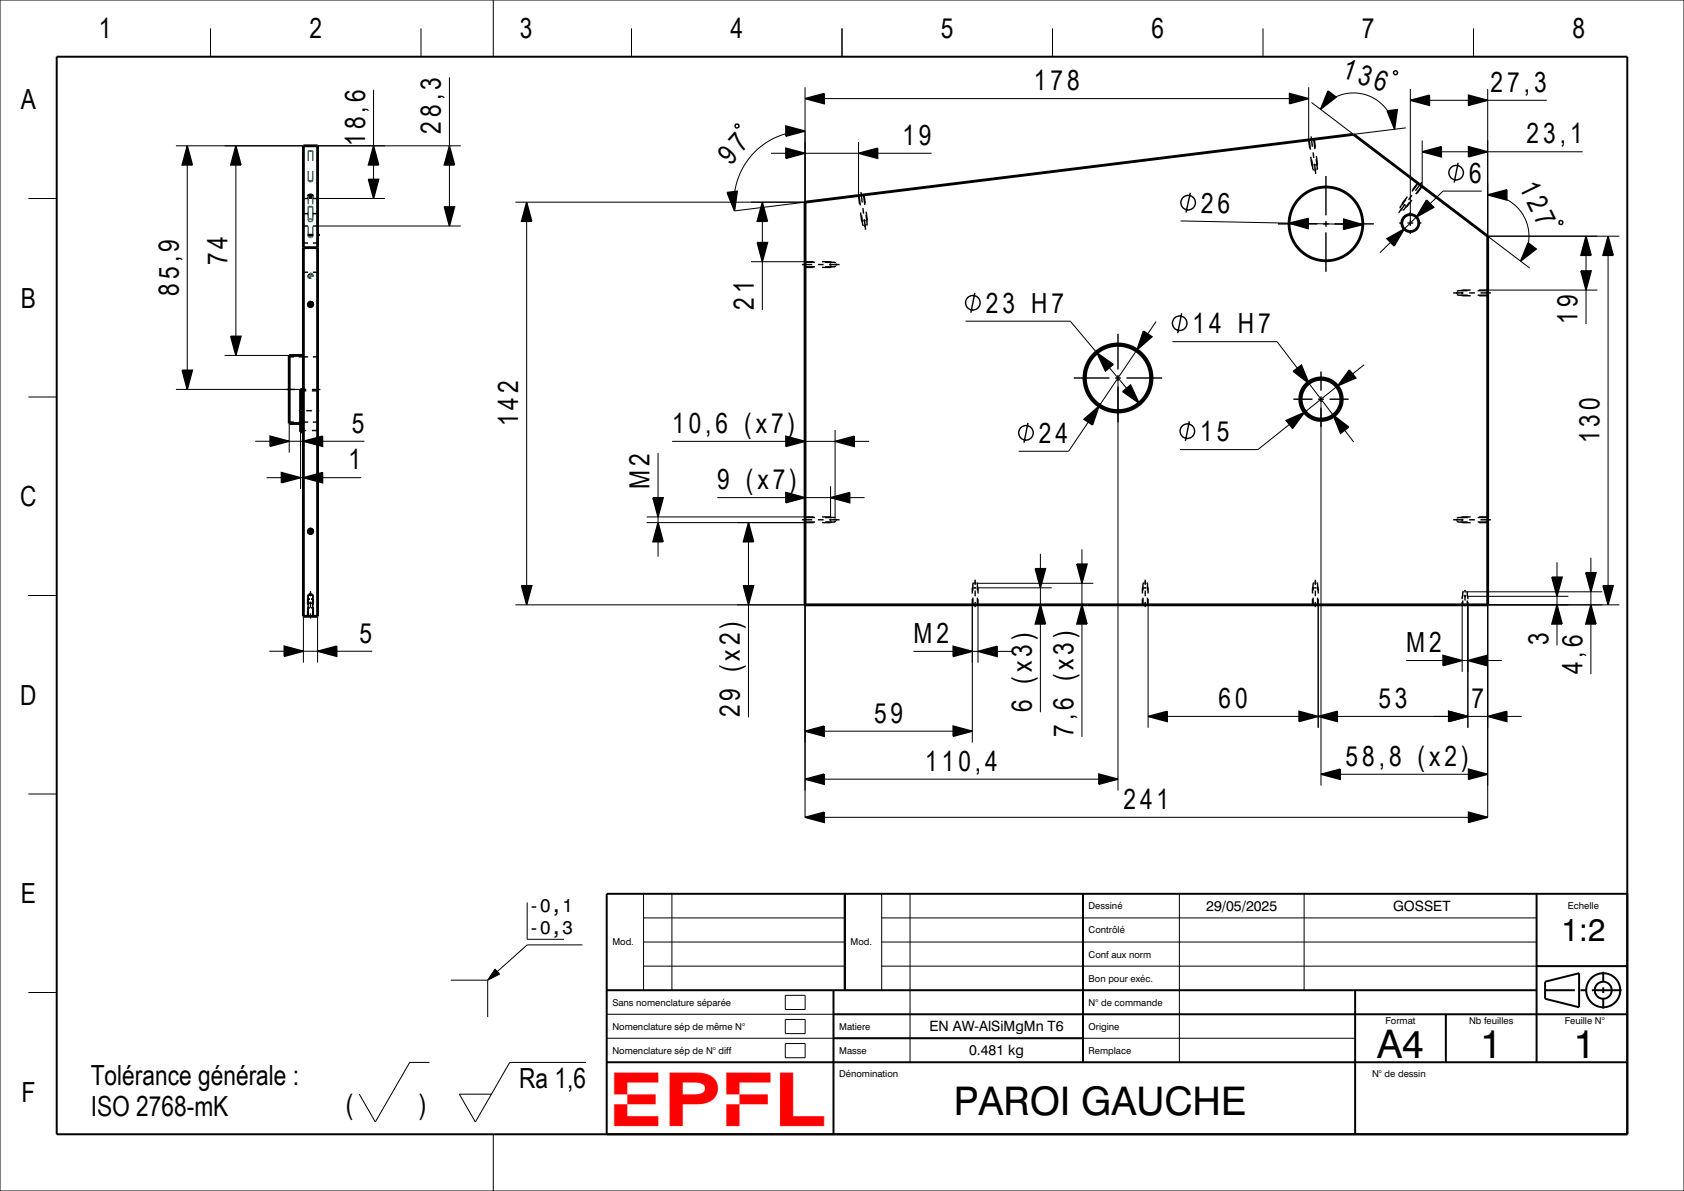
[picture p109: page 106]
PAROI GAUCHE; Tolérance générale : ISO 2768-mK

Mod. | | Mod. | | | Dessiné | 29/05/2025 | GOSSET | Echelle 1:2

Contrôlé

Conf aux norm

Bon pour exéc.

Sans nomenclature séparée | | | | N° de commande
Nomenclature sép de même N° | | Matiere | EN AW-AlSiMgMn T6 | Origine | | Format A4 | Nb feuilles 1 | Feuille N° 1
Nomenclature sép de N° diff | | Masse | 0.481 kg | Remplace

Dénomination | | | | N° de dessin

1 | 2 | 3 | 4 | 5 | 6 | 7 | 8
A

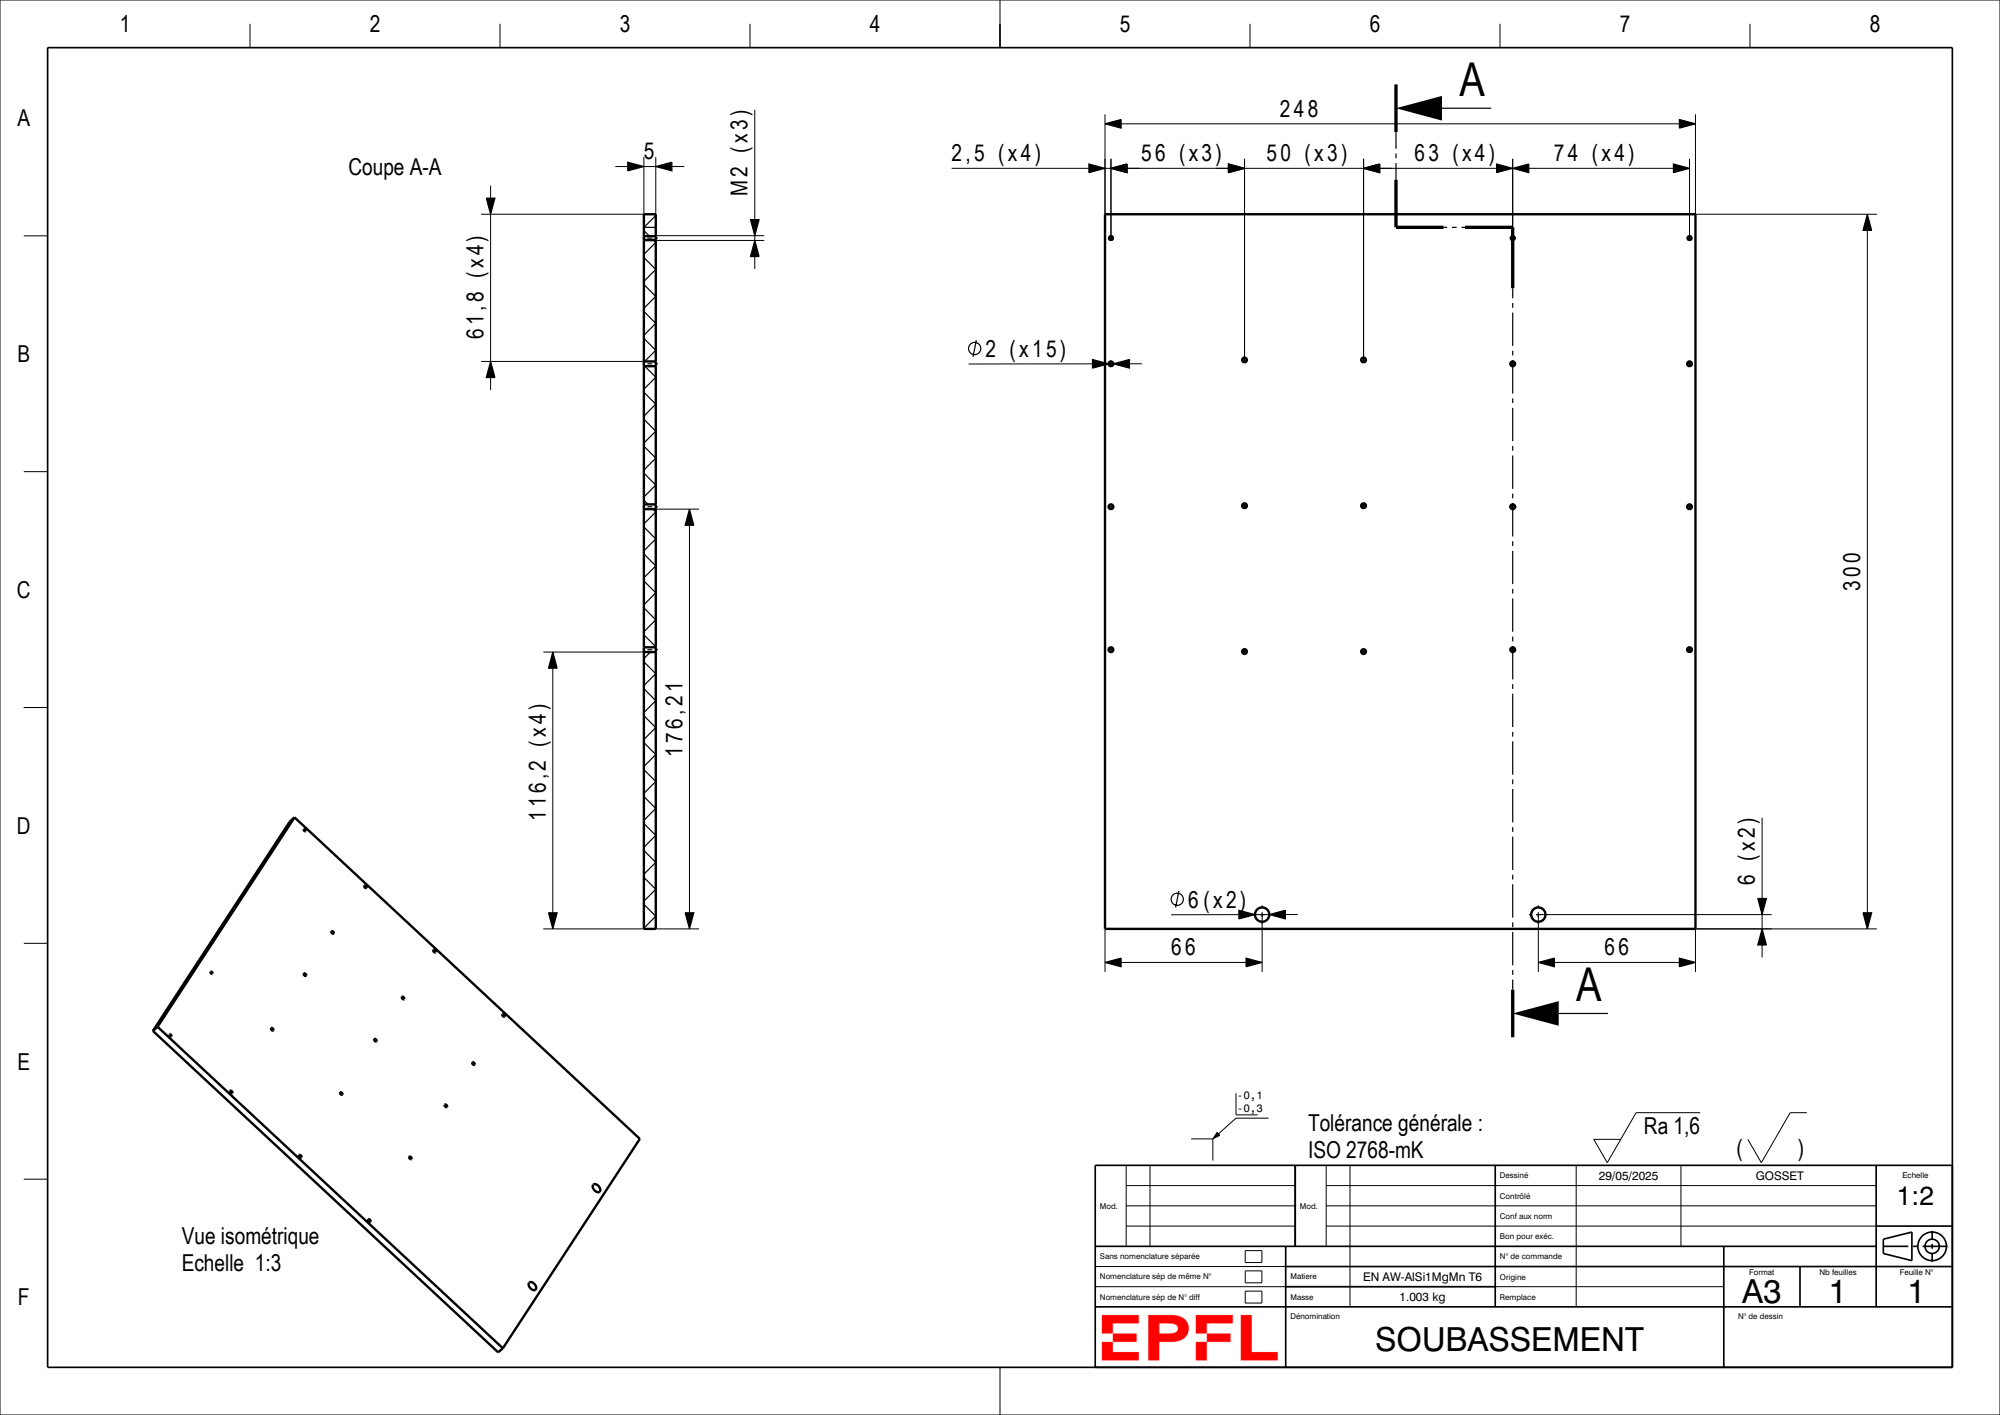
[picture p110: page 107]
Coupe A-A; Vue isométrique Echelle 1:3; Tolérance générale : ISO 2768-mK

Mod. | | Mod. | | | Dessiné | 29/05/2025 | GOSSET | Echelle 1:2

Contrôlé

Conf aux norm

Bon pour exéc.

Sans nomenclature séparée | | | | N° de commande
Nomenclature sép de même N° | | Matiere | EN AW-AlSi1MgMn T6 | Origine | | Format A3 | Nb feuilles 1 | Feuille N° 1
Nomenclature sép de N° diff | | Masse | 1.003 kg | Remplace

Dénomination SOUBASSEMENT | | | | N° de dessin

1 | 2 | 3 | 4 | 5 | 6 | 7 | 8
A

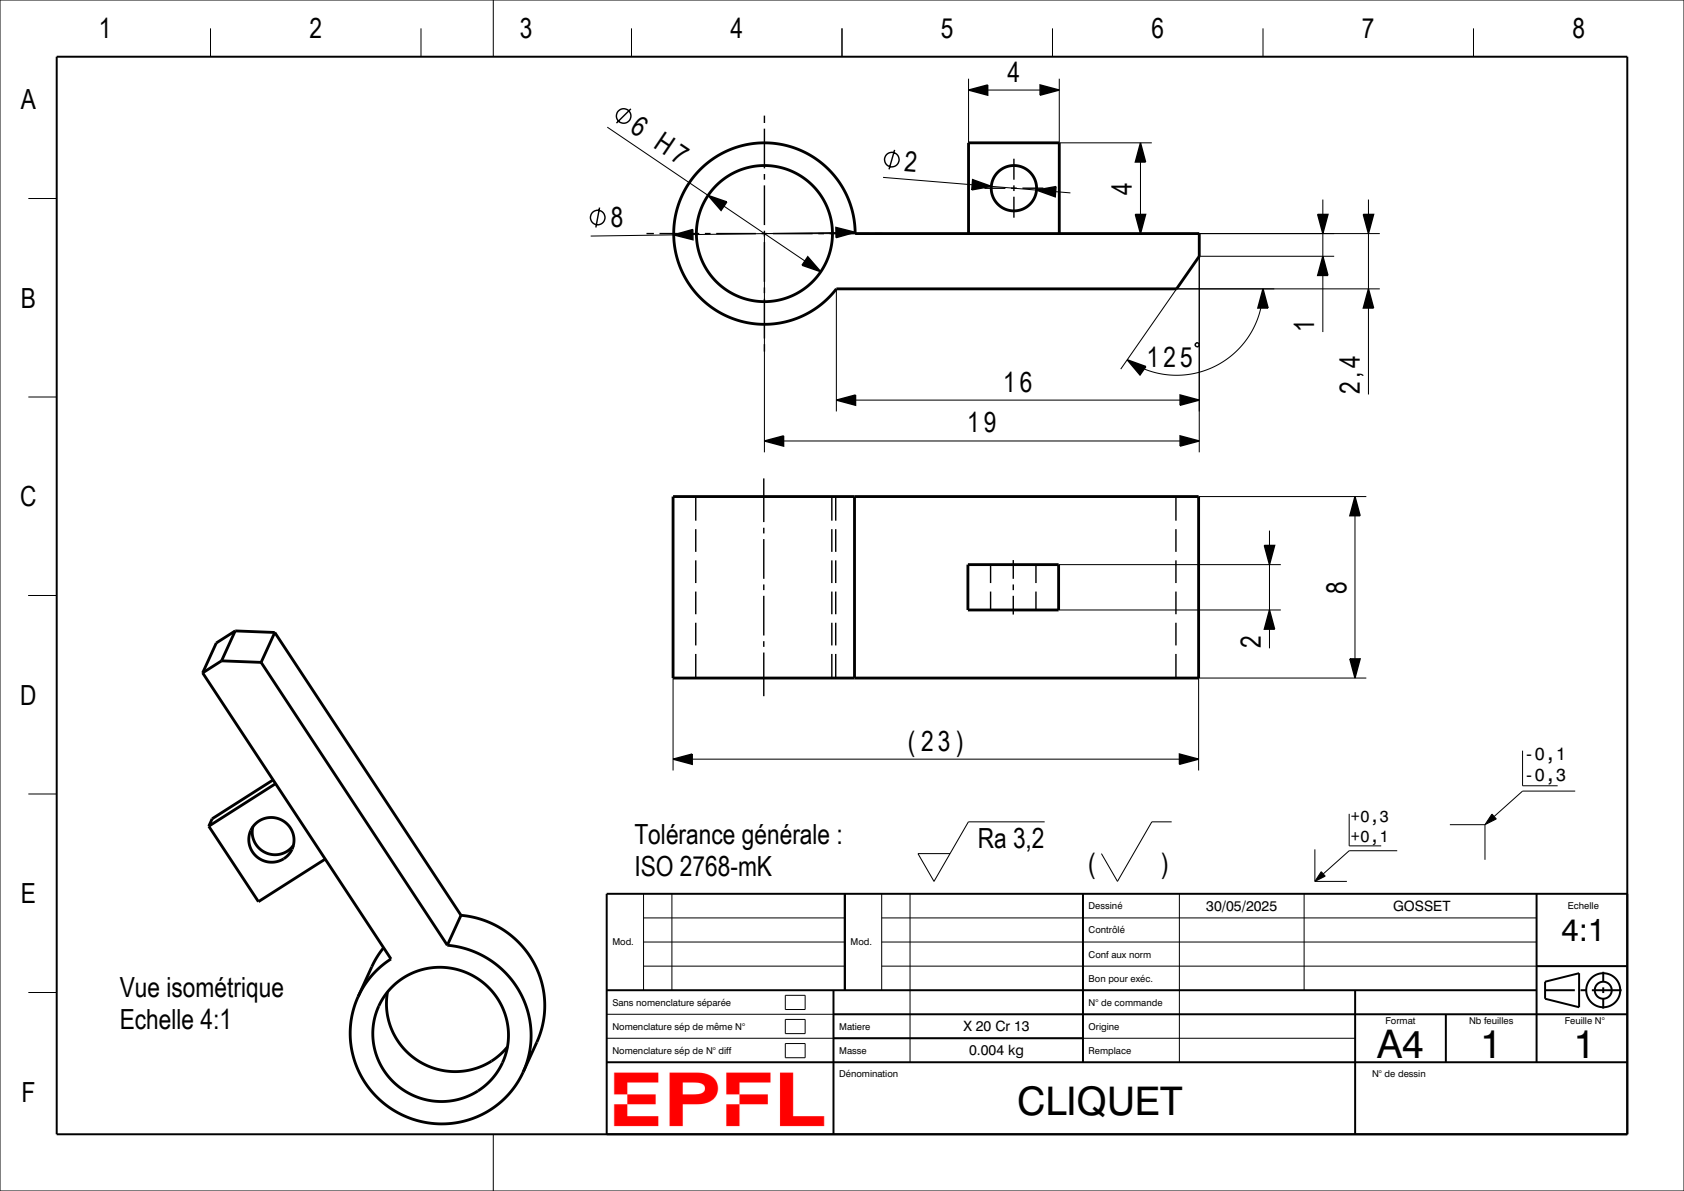
[picture p111: page 108]
CLIQUET; Vue isométrique Echelle 4:1; Tolérance générale : ISO 2768-mK

Mod. | | Mod. | | | Dessiné | 30/05/2025 | GOSSET | Echelle 4:1

Contrôlé

Conf aux norm

Bon pour exéc.

Sans nomenclature séparée | | | | N° de commande
Nomenclature sép de même N° | | Matiere | X 20 Cr 13 | Origine | | Format A4 | Nb feuilles 1 | Feuille N° 1
Nomenclature sép de N° diff | | Masse | 0.004 kg | Remplace

Dénomination | | | | N° de dessin

1 | 2 | 3 | 4 | 5 | 6 | 7 | 8

A

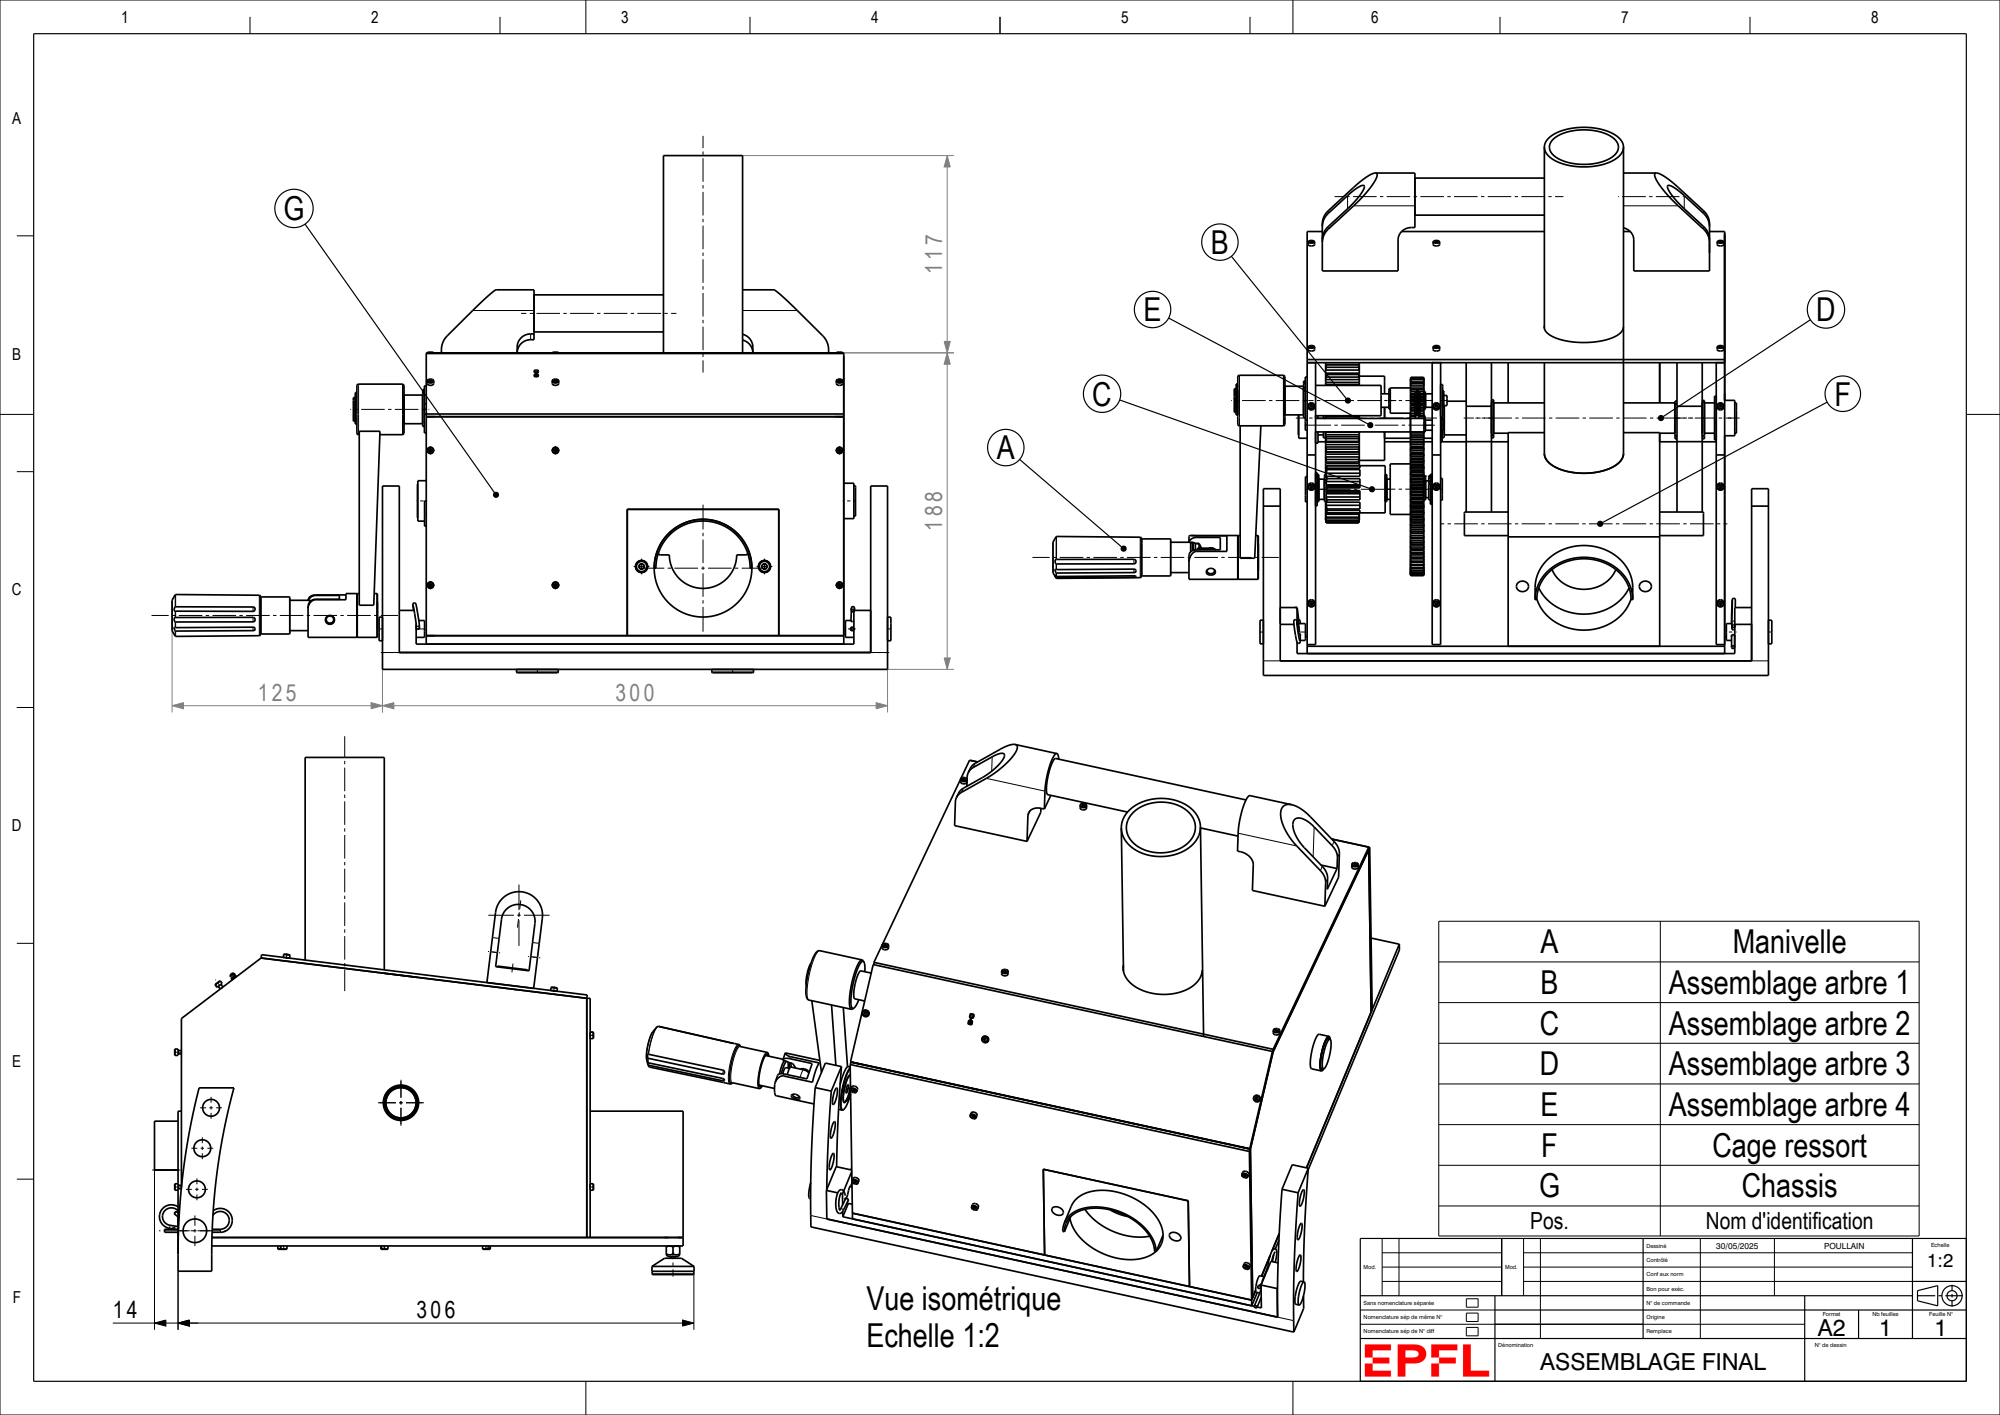
[picture p112: page 109]
Manivelle; Vue isométrique Echelle 1:2

B | Assemblage arbre 1
C | Assemblage arbre 2
D | Assemblage arbre 3
E | Assemblage arbre 4
F | Cage ressort
G | Chassis
Pos. | Nom d'identification

Mod. | | | Mod. | | Dessiné | 30/05/2025 | POULLAIN | Echelle 1:2

Contrôlé

Conf aux norm

Bon pour exéc.

Sans nomenclature séparée | | | | N° de commande
Nomenclature sép de même N° | | | | Origine | | A2 Format | Nb feuilles 1 | Feuille N° 1

Nomenclature sép de N° diff | | | | Remplace

Dénomination ASSEMBLAGE FINAL | | | N° de dessin

1 | 2 | 3 | 4 | 5 | 6 | 7 | 8
A

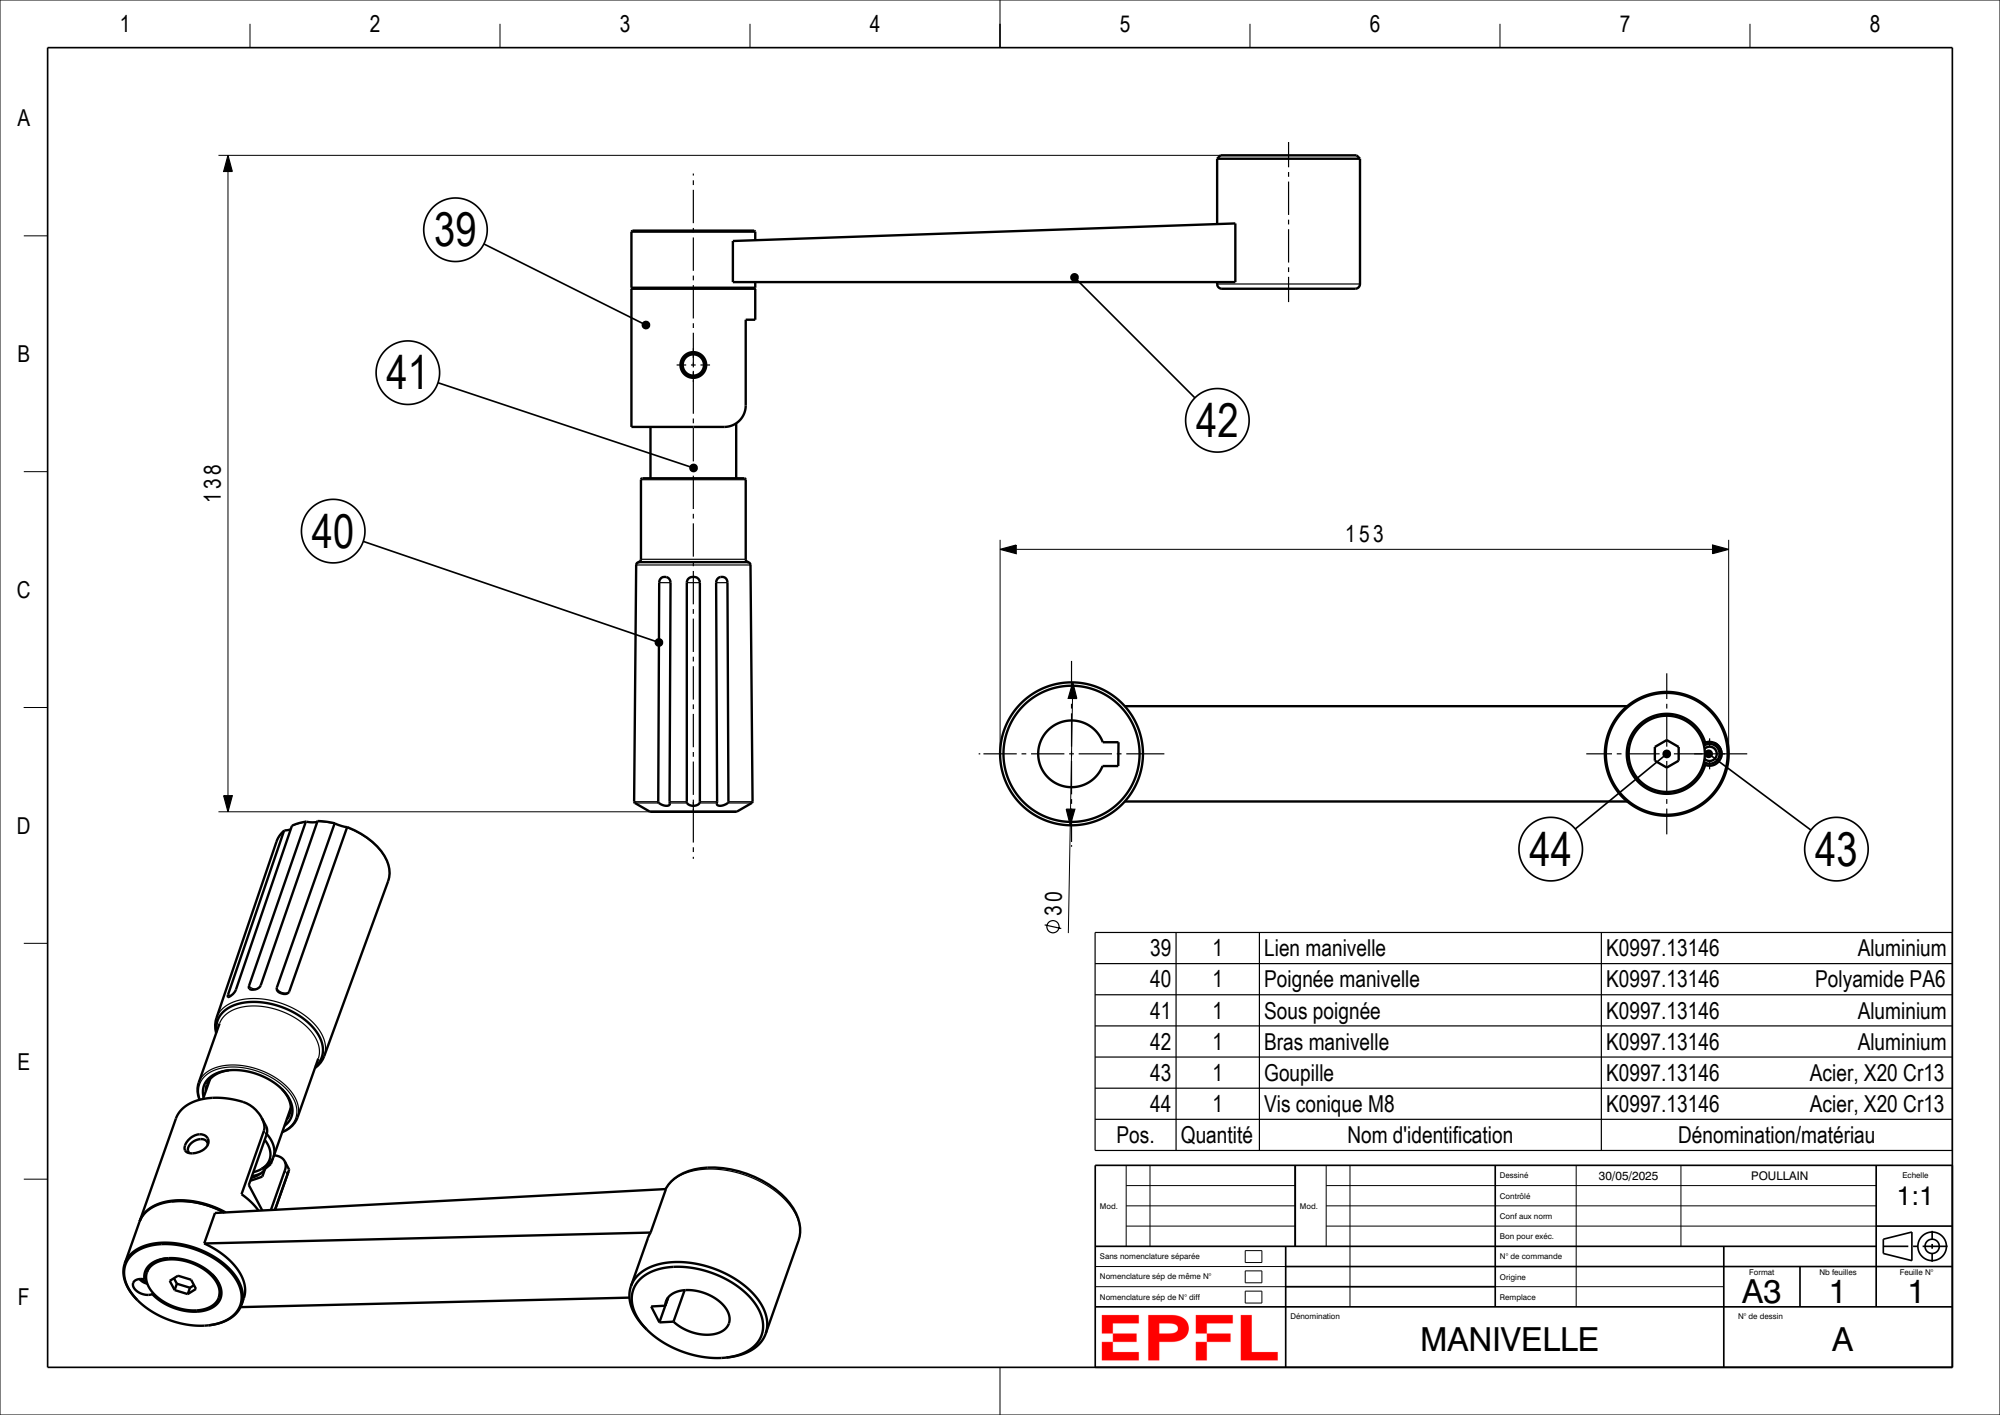
[picture p113: page 110]
Lien manivelle; Aluminium

40 | 1 | Poignée manivelle | K0997.13146 Polyamide PA6
41 | 1 | Sous poignée | K0997.13146 Aluminium
42 | 1 | Bras manivelle | K0997.13146 Aluminium
43 | 1 | Goupille | K0997.13146 Acier, X20 Cr13
44 | 1 | Vis conique M8 | K0997.13146 Acier, X20 Cr13
Pos. | Quantité | Nom d'identification | Dénomination/matériau

Mod. | | Mod. | | Dessiné | 30/05/2025 | POULLAIN | Echelle 1:1

Contrôlé

Conf aux norm

Bon pour exéc.

Sans nomenclature séparée | | | N° de commande
Nomenclature sép de même N° | | | Origine | | Format A3 | Nb feuilles 1 | Feuille N° 1

Nomenclature sép de N° diff | | | Remplace

Dénomination MANIVELLE | | | N° de dessin A

1 | 2 | 3 | 4 | 5 | 6 | 7 | 8
A

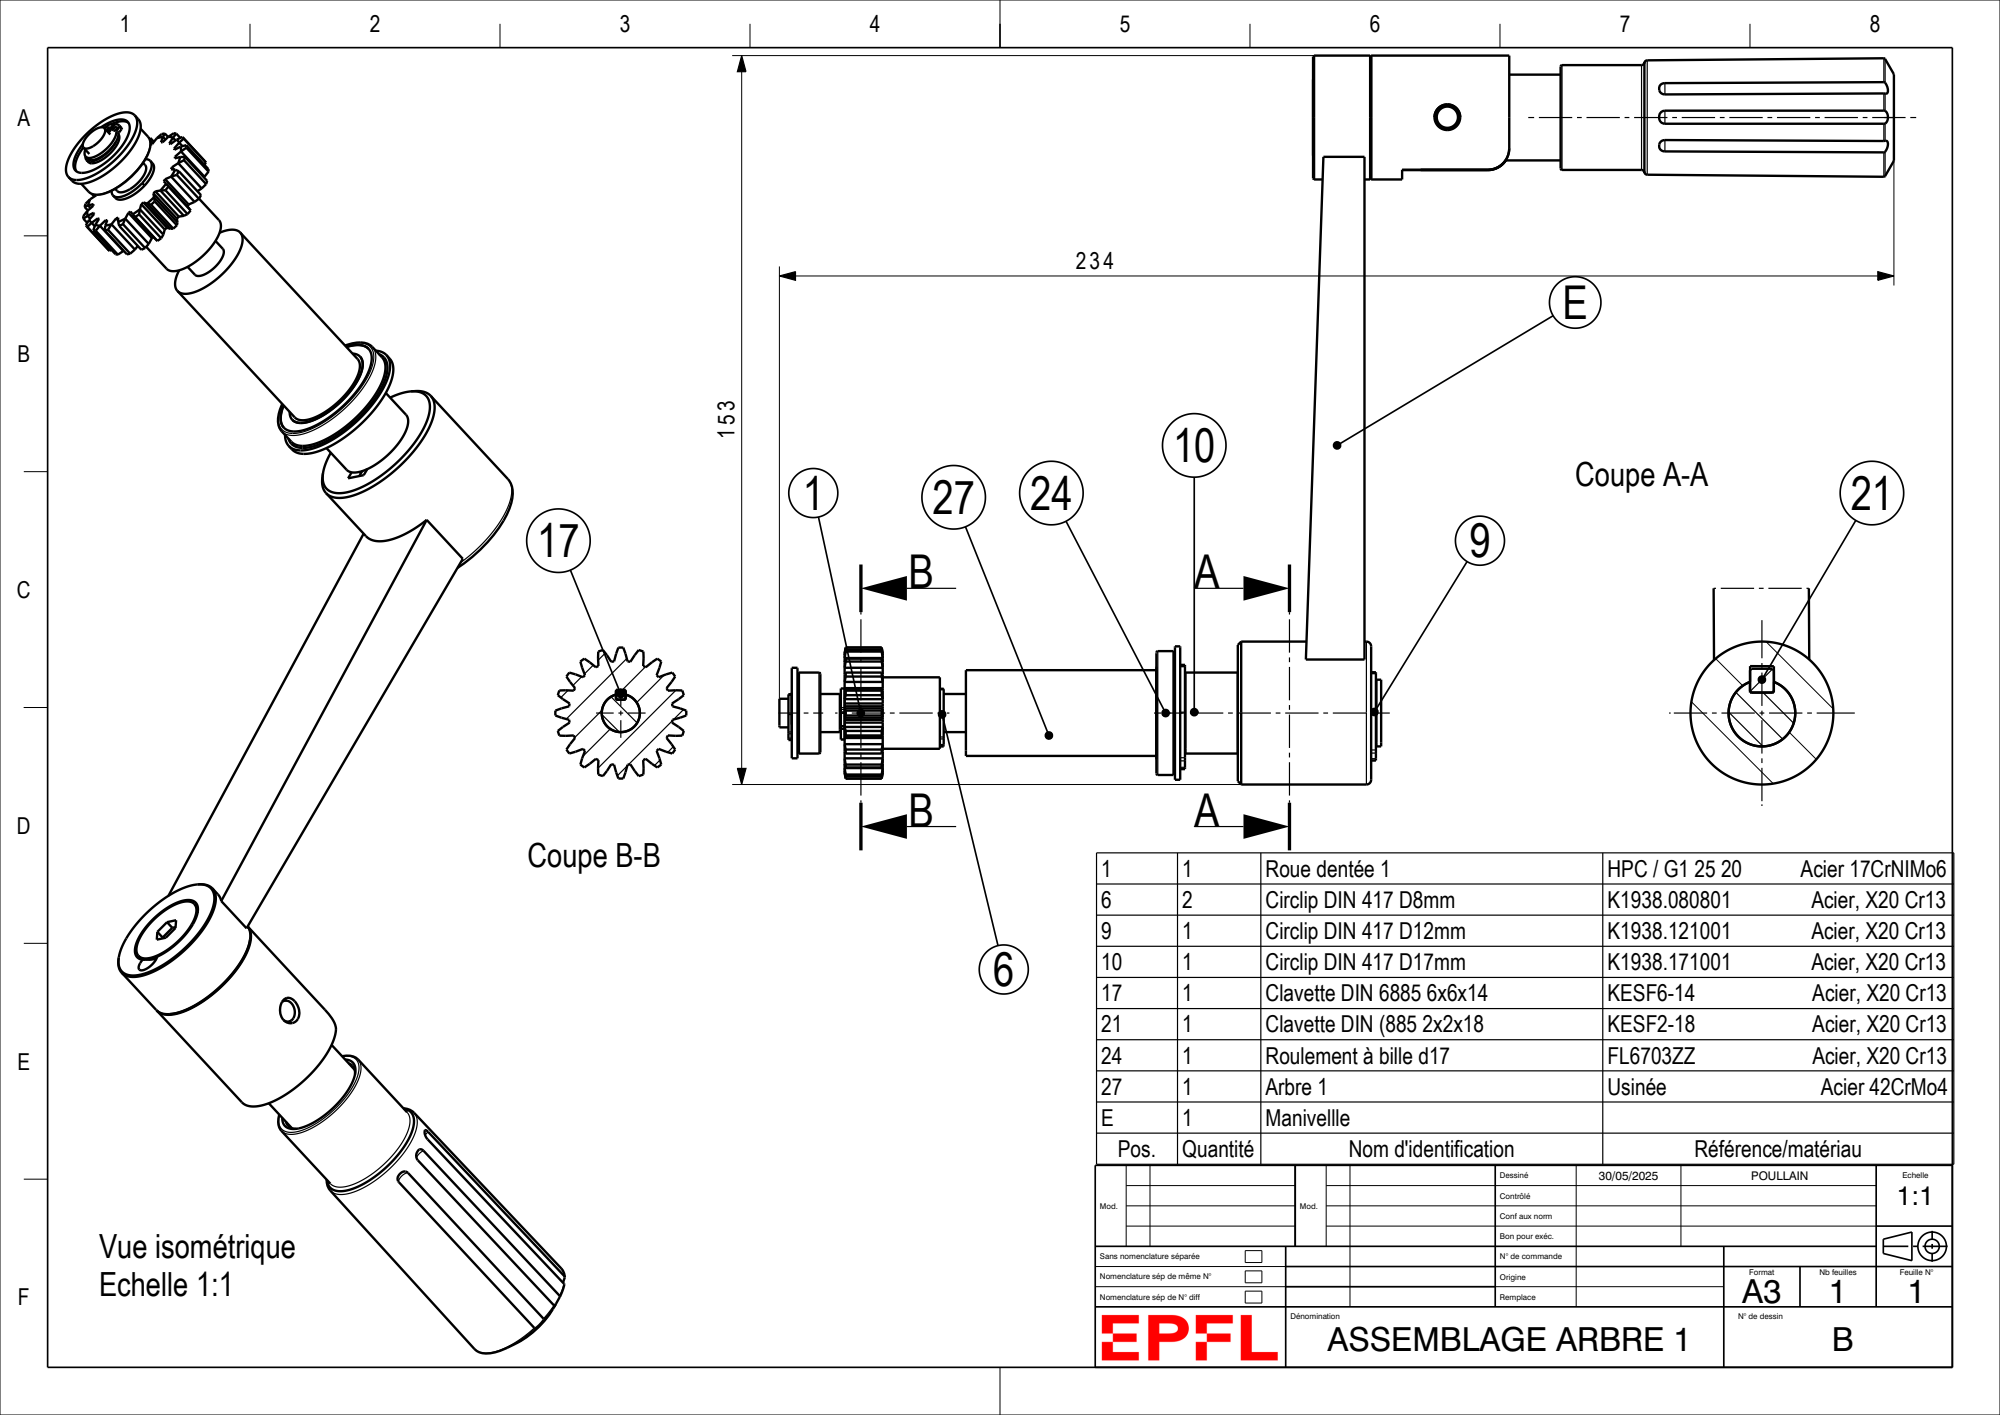
[picture p114: page 111]
Vue isométrique Echelle 1:1; Coupe B-B; Coupe A-A; Roue dentée 1; HPC / G1 25 20 Acier 17CrNIMo6

6 | 2 | Circlip DIN 417 D8mm | K1938.080801 Acier, X20 Cr13
9 | 1 | Circlip DIN 417 D12mm | K1938.121001 Acier, X20 Cr13
10 | 1 | Circlip DIN 417 D17mm | K1938.171001 Acier, X20 Cr13
17 | 1 | Clavette DIN 6885 6x6x14 | KESF6-14 Acier, X20 Cr13
21 | 1 | Clavette DIN (885 2x2x18 | KESF2-18 Acier, X20 Cr13
24 | 1 | Roulement à bille d17 | FL6703ZZ Acier, X20 Cr13
27 | 1 | Arbre 1 | Usinée Acier 42CrMo4
E | 1 | Manivellle
Pos. | Quantité | Nom d'identification | Référence/matériau

Mod. | | | Mod. | | Dessiné | 30/05/2025 | POULLAIN | Echelle 1:1

Contrôlé

Conf aux norm

Bon pour exéc.

Sans nomenclature séparée | | | | N° de commande
Nomenclature sép de même N° | | | | Origine | | Format A3 | Nb feuilles 1 | Feuille N° 1

Nomenclature sép de N° diff | | | | Remplace

Dénomination ASSEMBLAGE ARBRE 1 | | | N° de dessin B

1 2 3 4 | 5 6 7 8
| 3

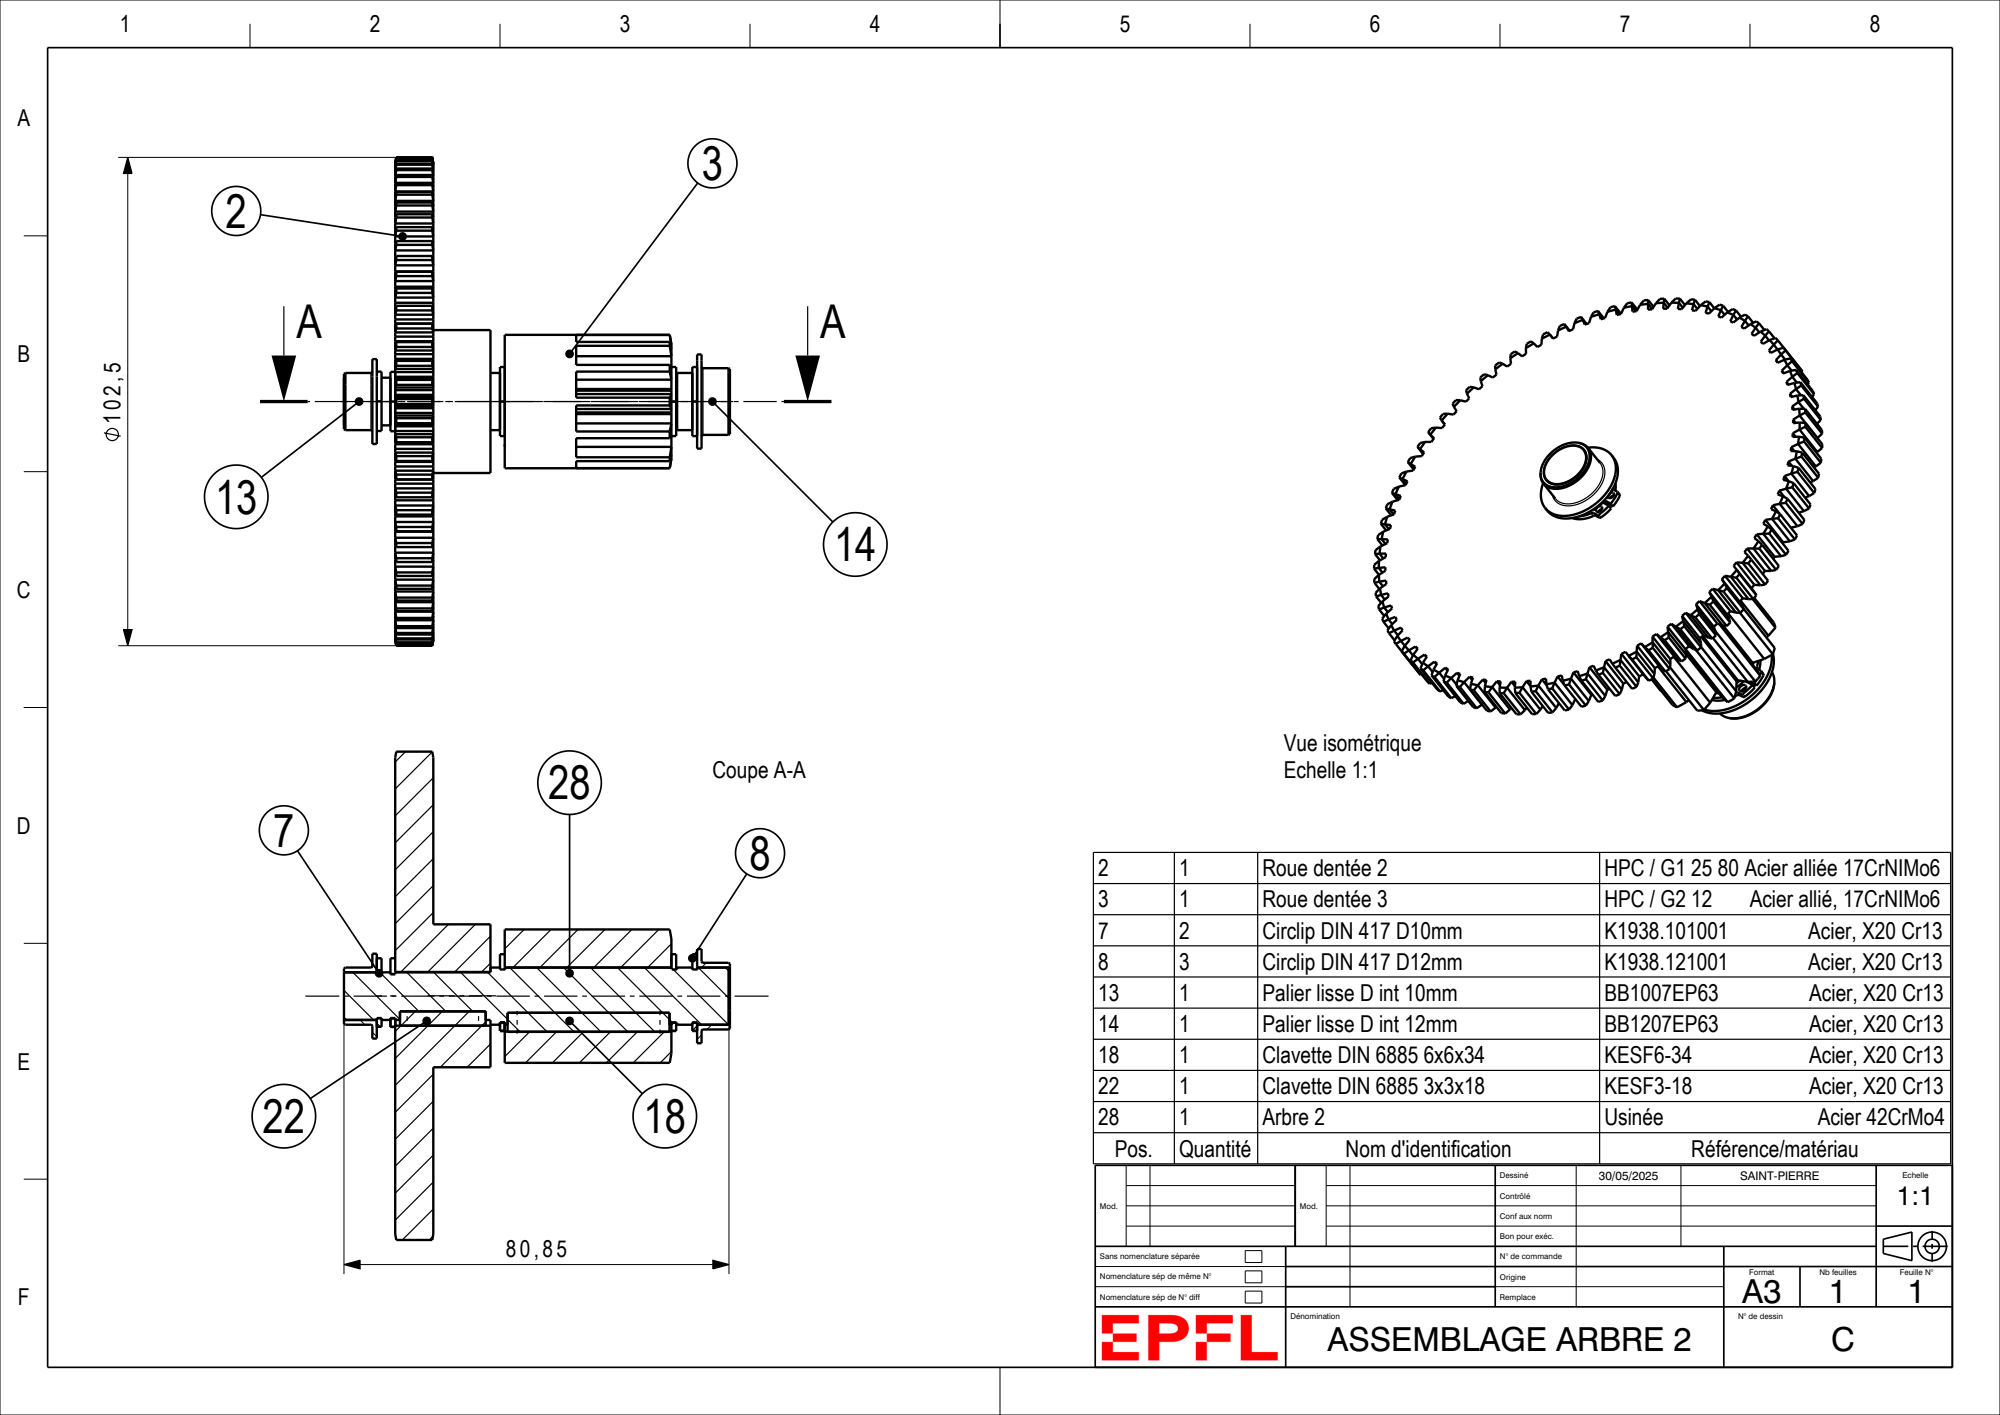
[picture p115: page 112]
Coupe A-A; Vue isométrique Echelle 1:1; Roue dentée 2; HPC / G1 25 80 Acier alliée 17CrNIMo6

3 | 1 | Roue dentée 3 | HPC / G2 12 Acier allié, 17CrNIMo6
7 | 2 | Circlip DIN 417 D10mm | K1938.101001 Acier, X20 Cr13
8 | 3 | Circlip DIN 417 D12mm | K1938.121001 Acier, X20 Cr13
13 | 1 | Palier lisse D int 10mm | BB1007EP63 Acier, X20 Cr13
14 | 1 | Palier lisse D int 12mm | BB1207EP63 Acier, X20 Cr13
18 | 1 | Clavette DIN 6885 6x6x34 | KESF6-34 Acier, X20 Cr13
22 | 1 | Clavette DIN 6885 3x3x18 | KESF3-18 Acier, X20 Cr13
28 | 1 | Arbre 2 | Usinée Acier 42CrMo4
Pos. | Quantité | Nom d'identification | Référence/matériau

Mod. | | | Mod. | | Dessiné | 30/05/2025 | SAINT-PIERRE | Echelle 1:1

Contrôlé

Conf aux norm

Bon pour exéc.

Sans nomenclature séparée | | | | N° de commande
Nomenclature sép de même N° | | | | Origine | | Format A3 | Nb feuilles 1 | Feuille N° 1

Nomenclature sép de N° diff | | | | Remplace

Dénomination ASSEMBLAGE ARBRE 2 | | | N° de dessin C

1 | 2 | 3 | 4 | 5 | 6 | 7 | 8

A

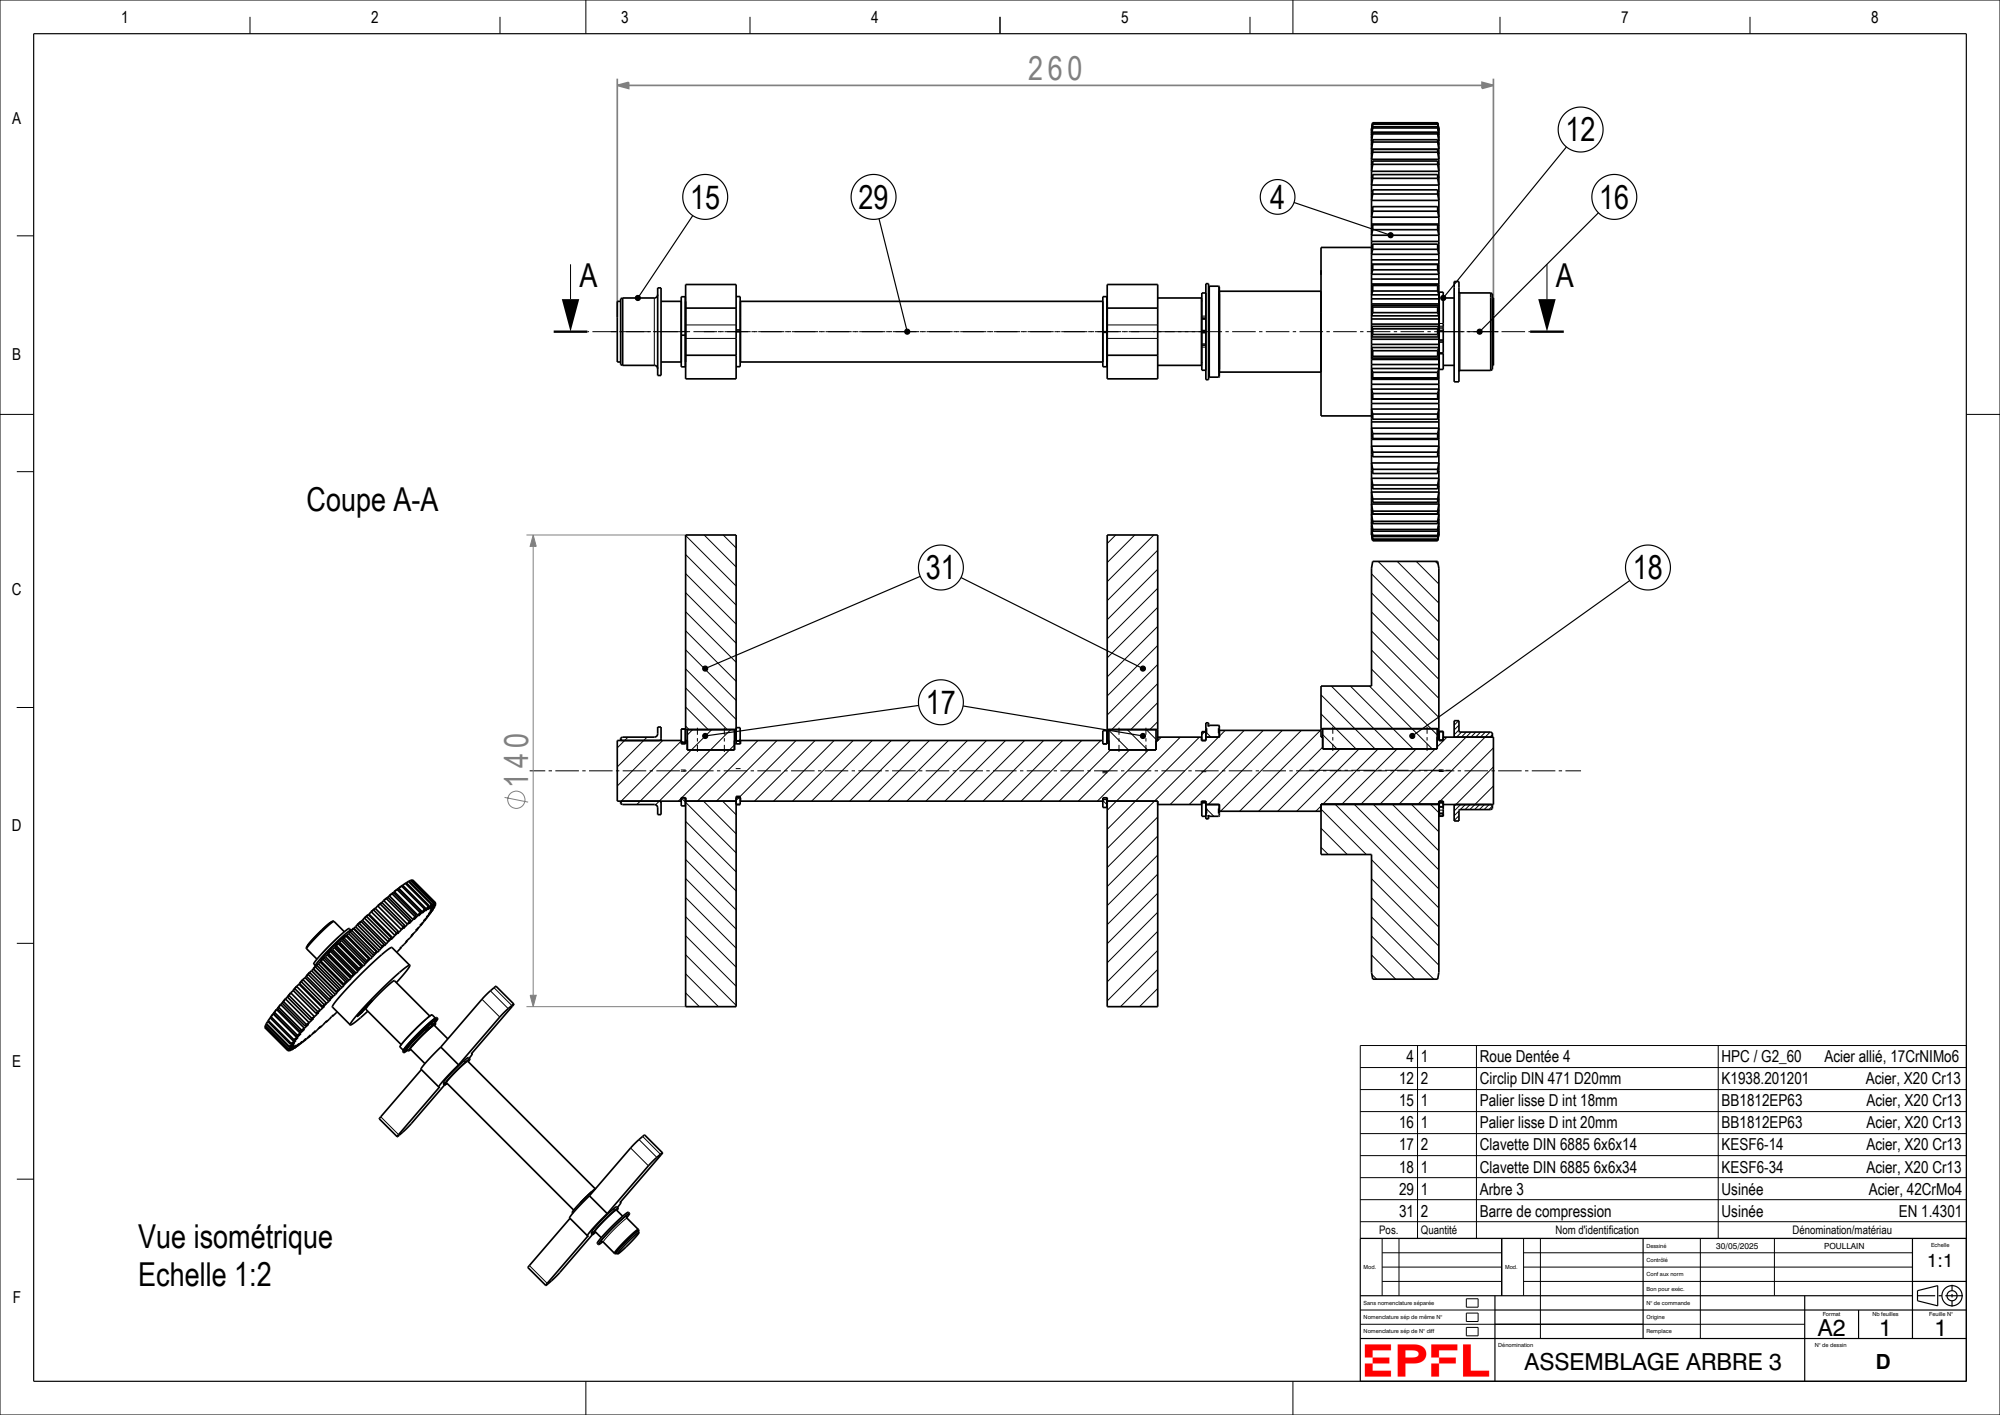
[picture p116: page 113]
Coupe A-A; Vue isométrique Echelle 1:2; Roue Dentée 4; HPC / G2_60 Acier allié, 17CrNIMo6

12 2 | Circlip DIN 471 D20mm | K1938.201201 Acier, X20 Cr13
15 1 | | Palier lisse D int 18mm | BB1812EP63 Acier, X20 Cr13
16 1 | Palier lisse D int 20mm | BB1812EP63 Acier, X20 Cr13
17 2 | | Clavette DIN 6885 6x6x14 | KESF6-14 Acier, X20 Cr13
18 1 | Clavette DIN 6885 6x6x34 | KESF6-34 Acier, X20 Cr13
29 1 | | Arbre 3 | Usinée Acier, 42CrMo4
31 2 | Barre de compression | Usinée EN 1.4301
Pos. | Quantité | Nom d'identification | Dénomination/matériau

Mod. | | | Mod. | | Dessiné | 30/05/2025 | POULLAIN | Echelle 1:1

Contrôlé

Conf aux norm

Bon pour exéc.

Sans nomenclature séparée | | | | N° de commande
Nomenclature sép de même N° | | | | Origine | | A2 Format | Nb feuilles 1 | Feuille N° 1

Nomenclature sép de N° diff | | | | Remplace

Dénomination ASSEMBLAGE ARBRE 3 | | | N° de dessin

1 | 2 | 3 | 4 | 5 | 6 | 7 | 8
A

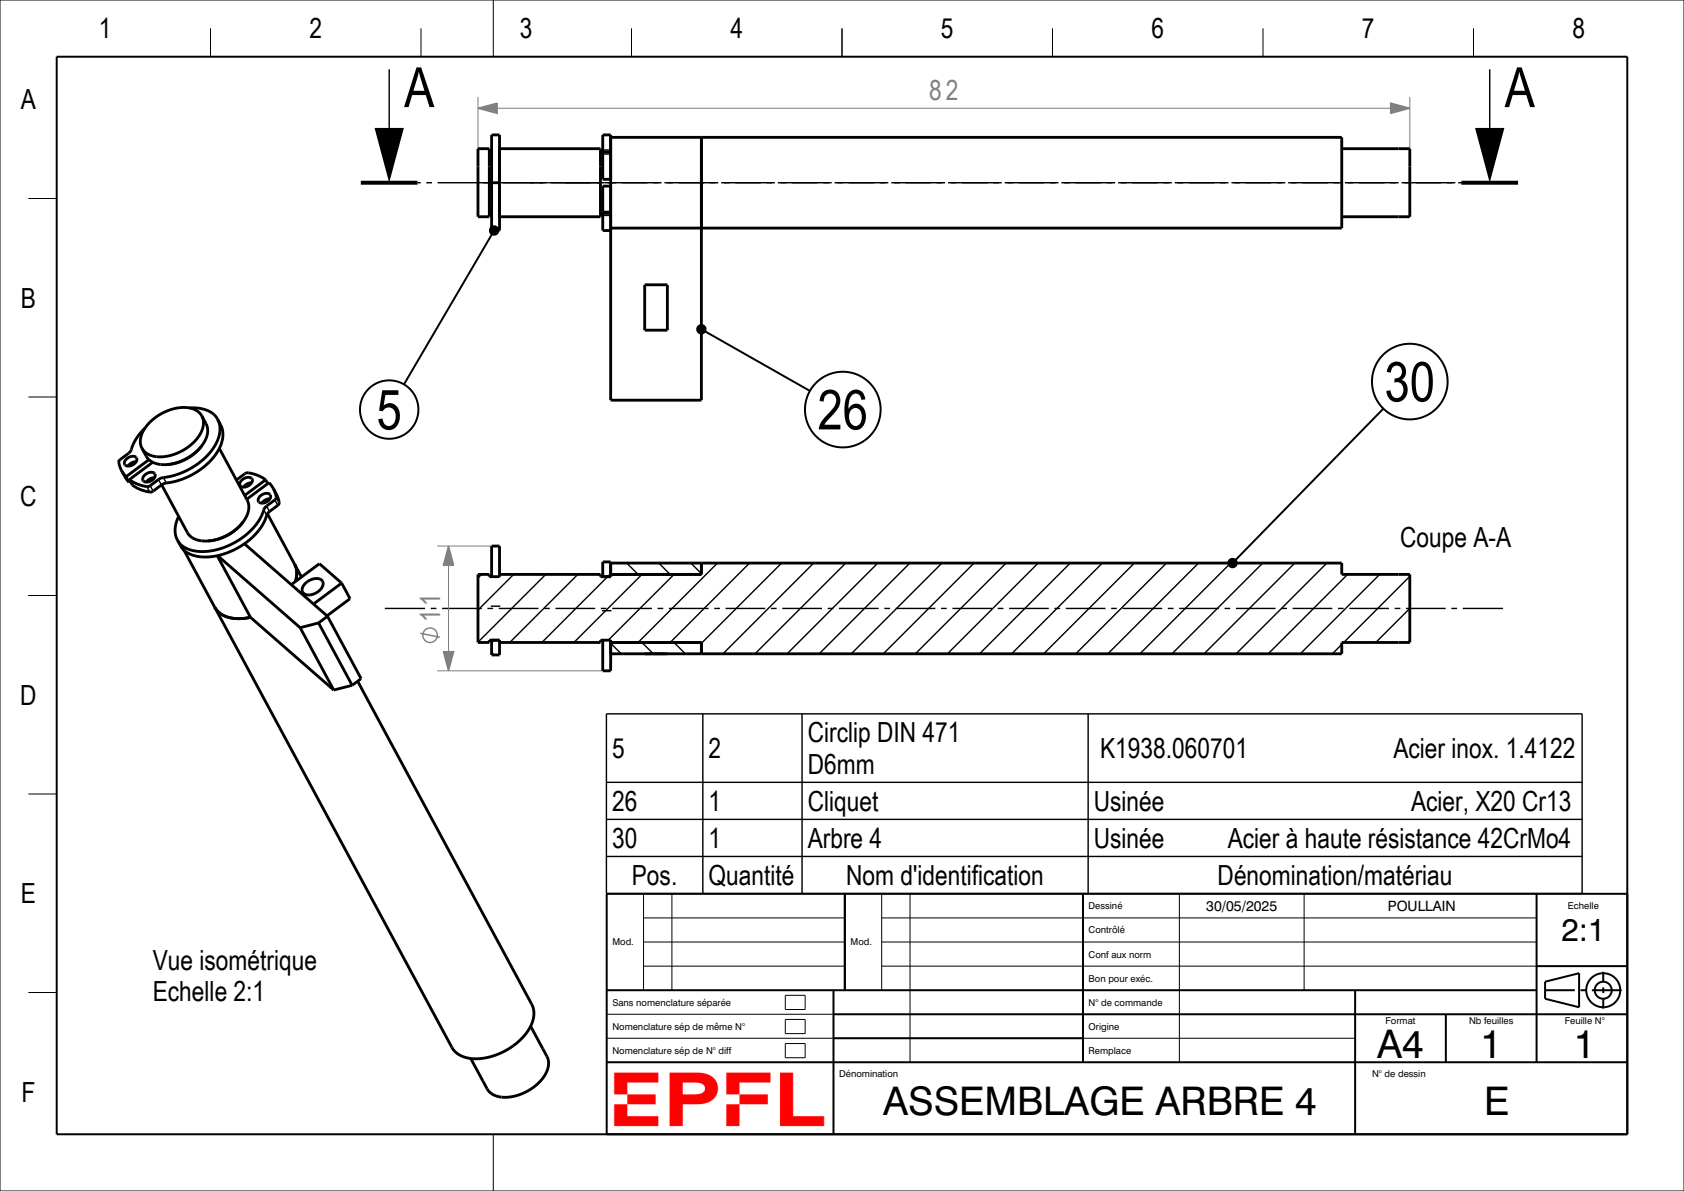
[picture p117: page 114]
ASSEMBLAGE ARBRE 4; Circlip DIN 471; Vue isométrique Echelle 2:1; Coupe A-A

5 26 | 2 1 | D6mm Cliquet | K1938.060701 Acier inox. 1.4122 Usinée Acier, X20 Cr13
30 | 1 | Arbre 4 | Usinée Acier à haute résistance 42CrMo4
Pos. | Quantité | Nom d'identification | Dénomination/matériau

Mod. | | | Mod. | | Dessiné | 30/05/2025 | POULLAIN | Echelle 2:1

Contrôlé

Conf aux norm

Bon pour exéc.

Sans nomenclature séparée | | | | N° de commande
Nomenclature sép de même N° | | | | Origine | | Format A4 | Nb feuilles 1 | Feuille N° 1

Nomenclature sép de N° diff | | | | Remplace

Dénomination | | | N° de dessin

1 | 2 | 3 | 4 | 5 | 6 | 7 | 8
A

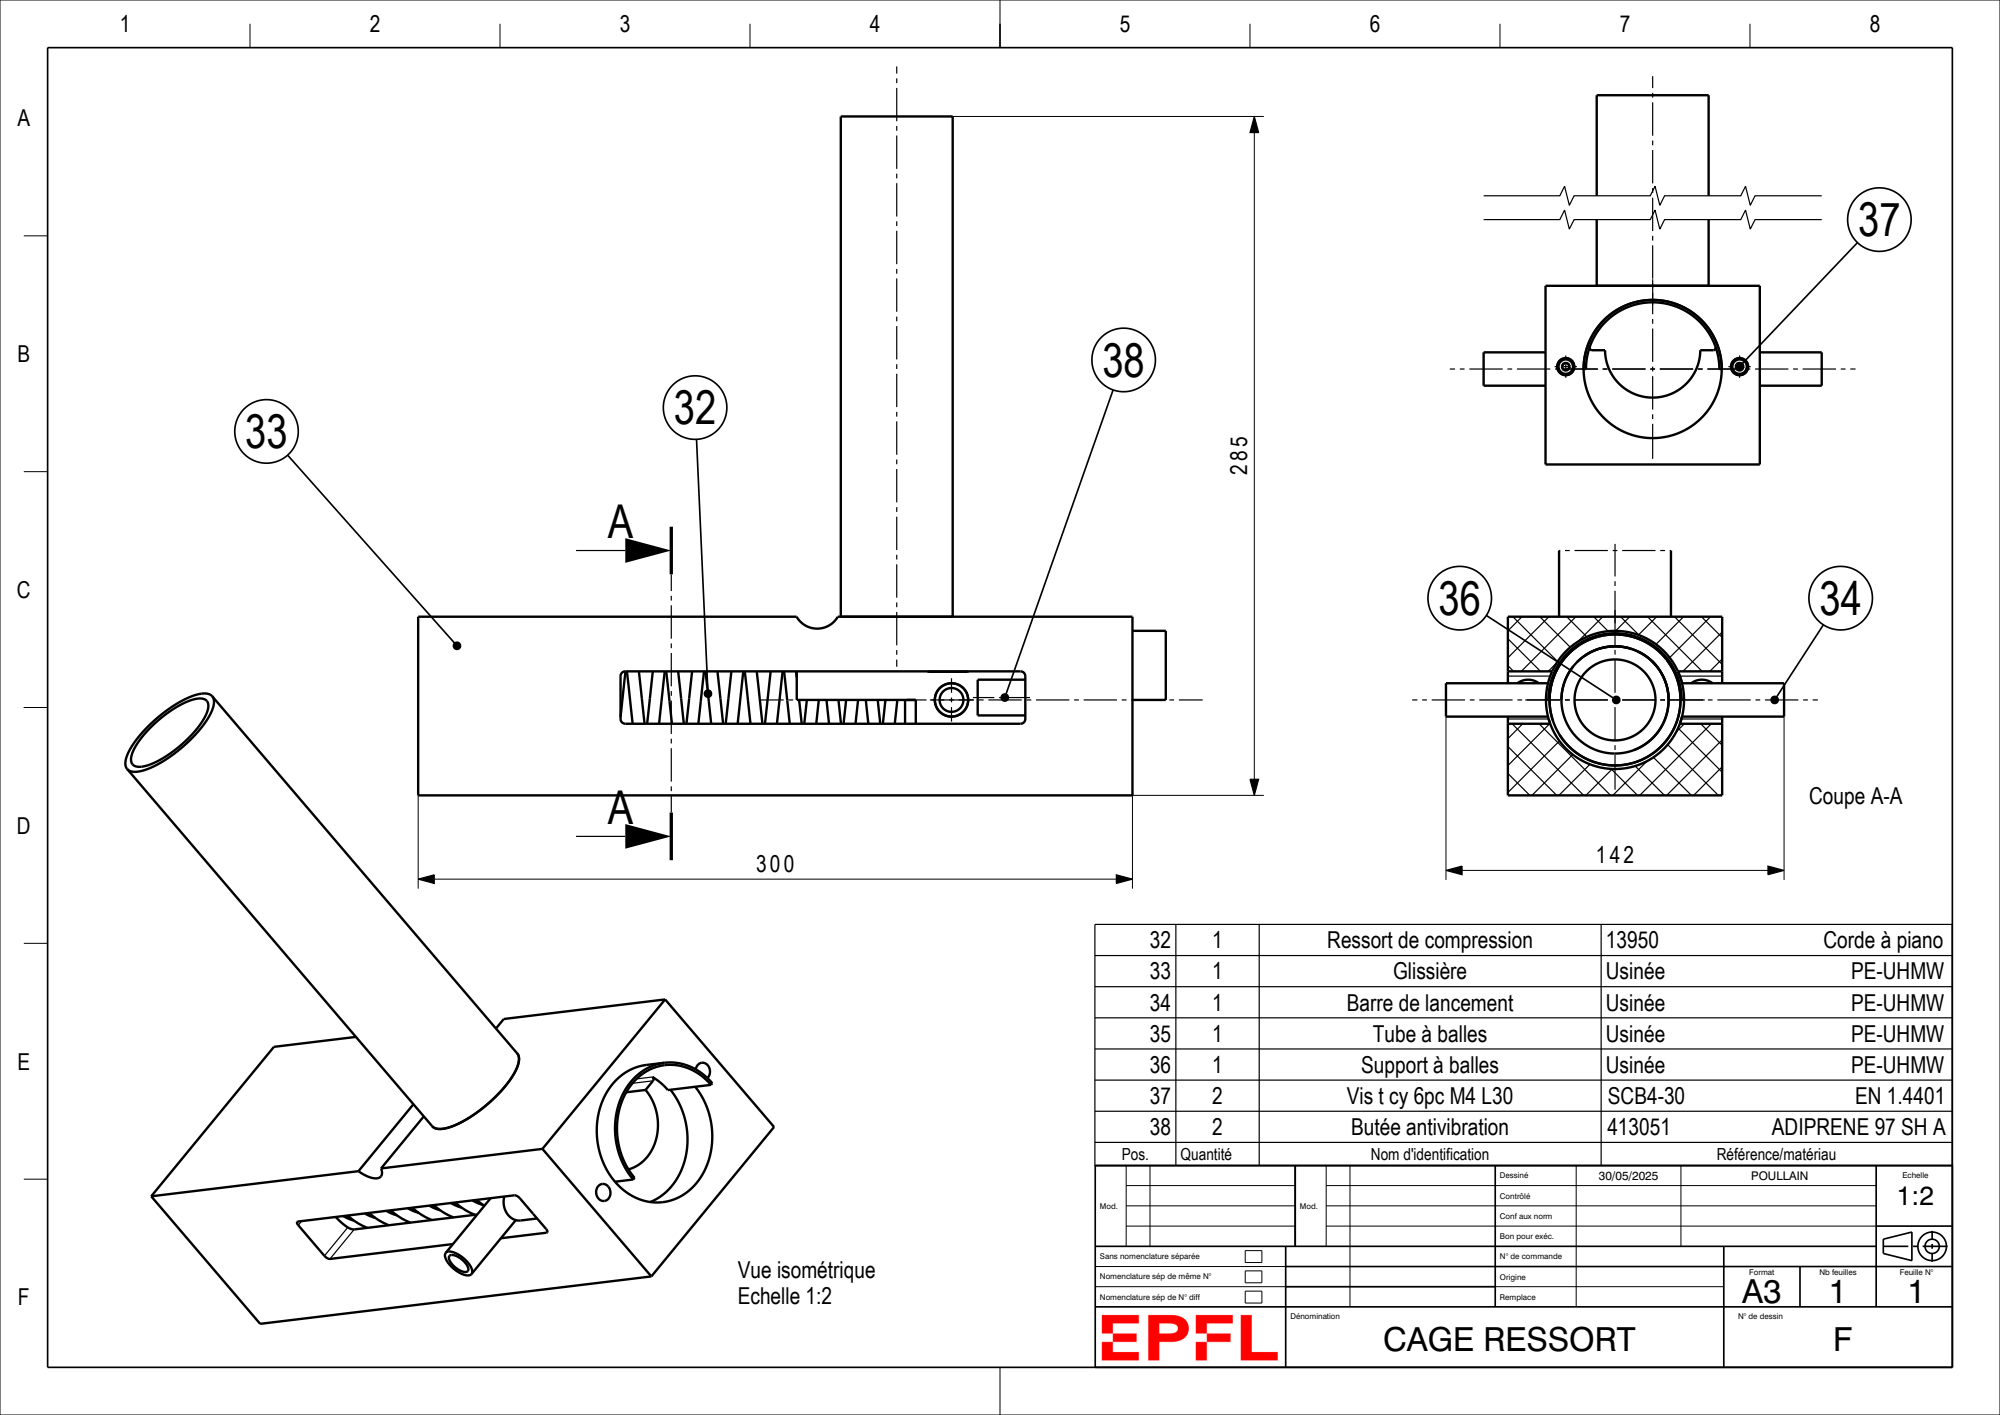
[picture p118: page 115]
Ressort de compression; Corde à piano; Vue isométrique Echelle 1:2; Coupe A-A

33 | 1 | Glissière | Usinée PE-UHMW
34 | 1 | Barre de lancement | Usinée PE-UHMW
35 | 1 | Tube à balles | Usinée PE-UHMW
36 | 1 | Support à balles | Usinée PE-UHMW
37 | 2 | Vis t cy 6pc M4 L30 | SCB4-30 EN 1.4401
38 | 2 | Butée antivibration | 413051 ADIPRENE 97 SH A
Pos. | Quantité | Nom d'identification | Référence/matériau

Mod. | | | Mod. | | Dessiné | 30/05/2025 | POULLAIN | Echelle 1:2

Contrôlé

Conf aux norm

Bon pour exéc.

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

Nomenclature sép de N° diff | | | | Remplace

Dénomination CAGE RESSORT | | | N° de dessin F

1 | 2 | 3 | 4 | 5 | 6 | 7 | 8
A

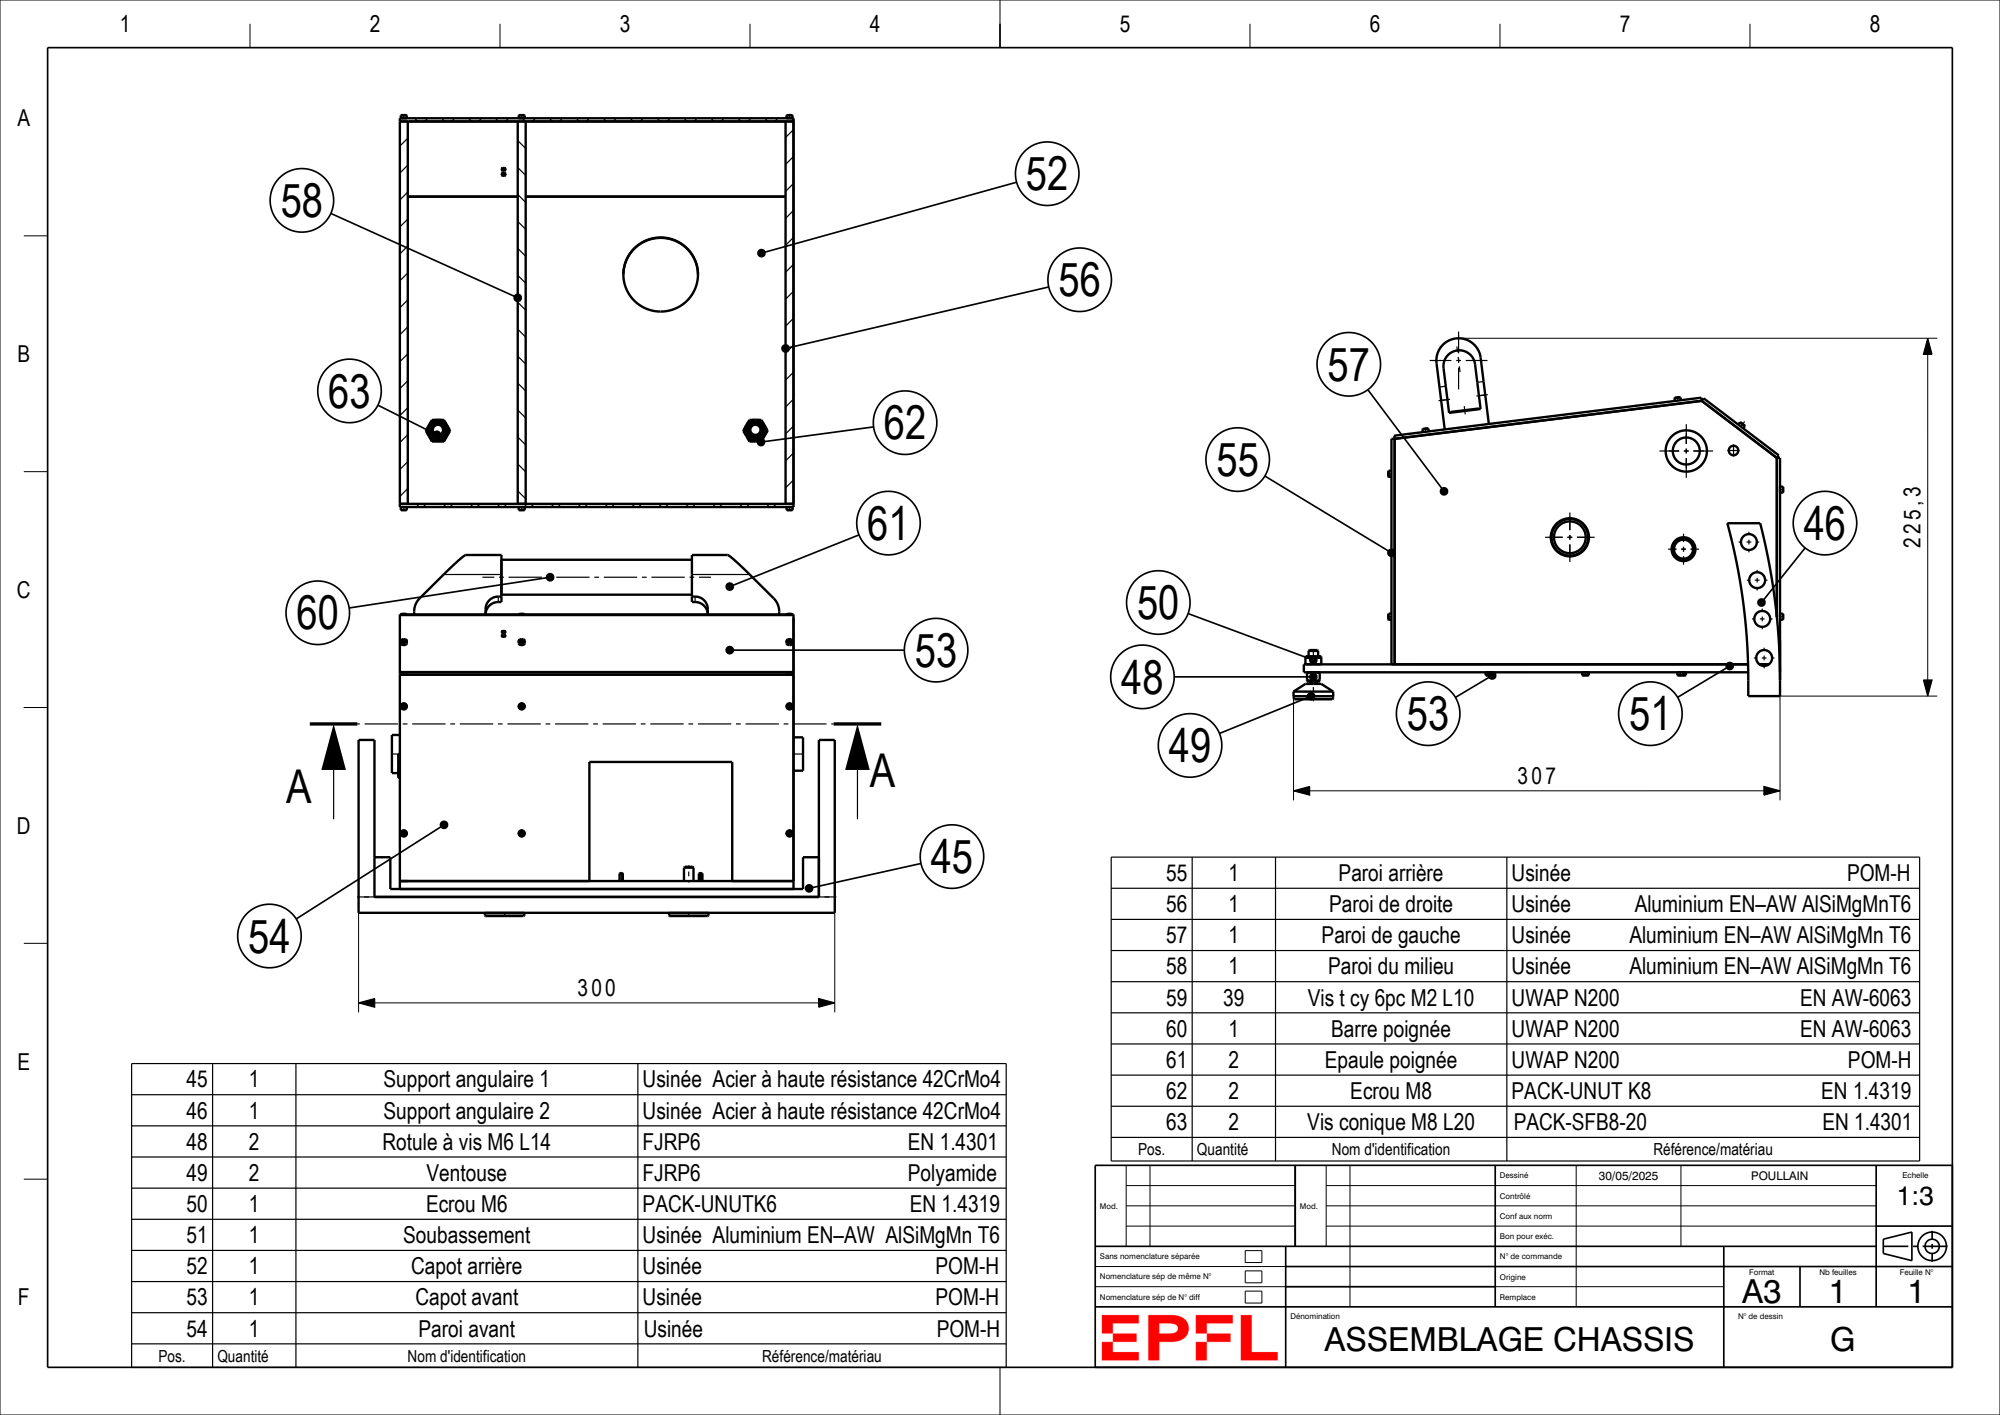
[picture p119: page 116]
N° de commande; Contrôlé; Paroi arrière; Usinée; POM-H; Support angulaire 1; Usinée Acier à haute résistance 42CrMo4; Soubassement; Usinée Aluminium EN–AW AlSiMgMn T6; Capot avant

56 | 1 | Paroi de droite | Usinée Aluminium EN–AW AlSiMgMnT6
57 | 1 | Paroi de gauche | Usinée Aluminium EN–AW AlSiMgMn T6
58 | 1 | Paroi du milieu | Usinée Aluminium EN–AW AlSiMgMn T6
59 | 39 | Vis t cy 6pc M2 L10 | UWAP N200 EN AW-6063
60 | 1 | Barre poignée | UWAP N200 EN AW-6063
61 | 2 | Epaule poignée | UWAP N200 POM-H
62 | 2 | Ecrou M8 | PACK-UNUT K8 EN 1.4319
63 | 2 | Vis conique M8 L20 | PACK-SFB8-20 EN 1.4301
Pos. | Quantité | Nom d'identification | Référence/matériau

46 | 1 | Support angulaire 2 | Usinée Acier à haute résistance 42CrMo4
48 | 2 | Rotule à vis M6 L14 | FJRP6 EN 1.4301
49 | 2 | Ventouse | FJRP6 Polyamide
50 | 1 | Ecrou M6 | PACK-UNUTK6 EN 1.4319
52 | 1 | Capot arrière | Usinée POM-H
54 | 1 | Paroi avant | Usinée POM-H

Mod. | | | Mod. | Dessiné | 30/05/2025 | POULLAIN | Echelle 1:3

Conf aux norm

Bon pour exéc.

Sans nomenclature séparée

Nomenclature sép de même N° | | Origine | Format A3 | Nb feuilles 1 | Feuille N° 1

Nomenclature sép de N° diff | | Remplace

Dénomination ASSEMBLAGE CHASSIS | | N° de dessin G
