LGOSSET-21/squash-ball-launcher-catia/cad/native/Capture1.PNG

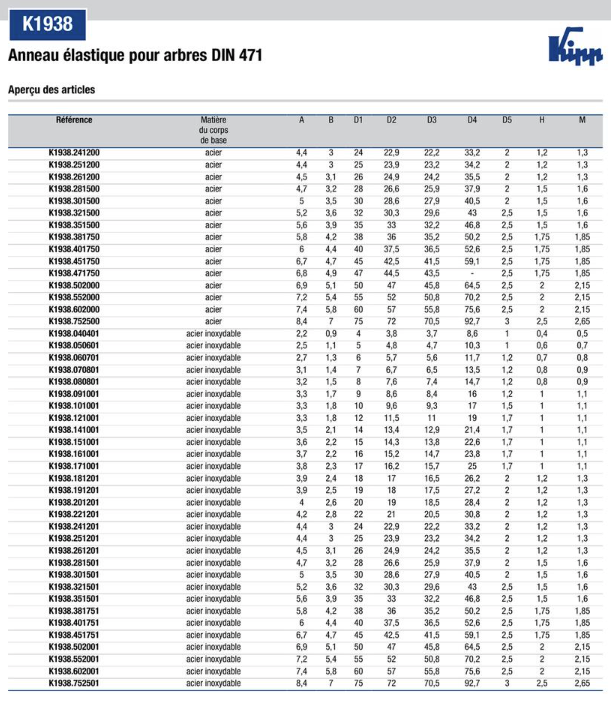
cad/native/Capture1.PNG
