LGOSSET-21/squash-ball-launcher-catia/cad/native/clavette2.PNG

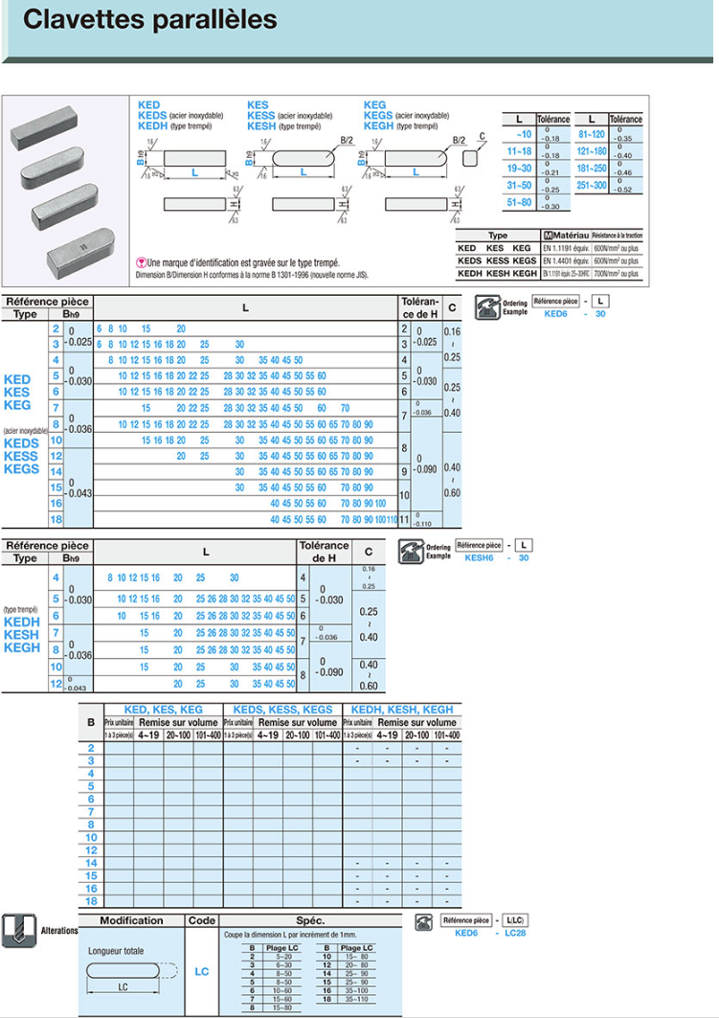
cad/native/clavette2.PNG
