LGOSSET-21/squash-ball-launcher-catia/(list of files, cad)

Other CAD files:
cad/native/ASSARBR4.CATProduct
cad/native/ASSARBRE2.CATProduct
cad/native/ASSArbre1.CATProduct
cad/native/ASSArbre3.CATProduct
cad/native/Arbre1.CATPart
cad/native/Arbre1[68].CATPart
cad/native/Arbre2.CATPart
cad/native/Arbre2[46].CATPart
cad/native/Arbre2[56].CATPart
cad/native/Arbre3.CATPart
cad/native/Arbre3[27].CATPart
cad/native/Arbre3[60].CATPart
cad/native/Arbre4.CATPart
cad/native/Arbre4[52].CATPart
cad/native/Barre.CATPart
cad/native/Barre[14].CATPart
cad/native/Barre[64].CATPart
cad/native/Barre[93].CATPart
cad/native/CONTENEUR.CATPart
cad/native/CONTENEUR[14].CATPart
cad/native/CYLINDRE-RESSORT.CATPart
cad/native/CYLINDRE-RESSORT[24].CATPart
cad/native/Cliquet.CATPart
cad/native/Cliquet[55].CATPart
cad/native/Conteneur-balle.CATPart
cad/native/Goupille.CATPart
cad/native/Goupille[89].CATPart
cad/native/HPC___G1_25_20__C_.catpart
cad/native/HPC___G1_25_20__C_[67].catpart
cad/native/HPC___G1_25_80__C_.catpart
cad/native/HPC___G1_25_80__C_[90].catpart
cad/native/HPC___G2_12__C_.catpart
cad/native/HPC___G2_12__C_[97].catpart
cad/native/HPC___G2_60__C_.catpart
cad/native/HPC___G2_60__C_[94].catpart
cad/native/Liason-Ressort-Barre.CATPart
cad/native/Liason-Ressort-Cylindre.CATPart
cad/native/MUR2.CATPart
cad/native/MUR2[58].CATPart
cad/native/MUR2[8].CATPart
cad/native/MUR3.CATPart
cad/native/MUR3[85].CATPart
cad/native/MUR3[95].CATPart
cad/native/Mur1.CATPart
cad/native/Mur1[11].CATPart
cad/native/Mur1[94].CATPart
cad/native/PAROIE2.CATPart
cad/native/PAROIE2[32].CATPart
cad/native/PLAFOND1.CATPart
cad/native/PLAFOND1[10].CATPart
cad/native/PLAFOND1[17].CATPart
cad/native/PLAFOND2.CATPart
cad/native/PLAFOND2[66].CATPart
cad/native/Part61.CATPart
cad/native/Part61[32].CATPart
cad/native/Part61[55].CATPart
cad/native/RACK-BALLE.CATPart
cad/native/RACK-BALLE[74].CATPart
cad/native/Rackballe.CATPart
cad/native/SOL.CATPart
cad/native/SOL[37].CATPart
cad/native/SOL[56].CATPart
cad/native/bord.CATPart
cad/native/bord[40].CATPart
cad/native/cuveballe.CATPart
cad/native/cuveballe[53].CATPart
cad/native/cuveballe[84].CATPart
cad/native/paroie1.CATPart
cad/native/paroie1[46].CATPart
