LGOSSET-21/squash-ball-launcher-catia/docs/PDF 2D COMPLET.pdf

1 | 2 | 3 | 4 | 5 | 6 | 7 | 8
A

Tolérance générale :; ISO 2768-mK; Coupe A-A; Vue isométrique Echelle 1:1; A¹²⁶

Mod. | | Mod. | | | Dessiné | 28/05/2025 | GOSSET | Echelle 1:1

Contrôlé

Conf aux norm

Bon pour exéc.

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

Dénomination ARBRE 1 | | | | N° de dessin

1

2

ABCDEF; Tolérance générale :; ISO 2768-mK; Vue isométrique Echelle 2:1; Coupe A-A

Mod. | | Mod. | | | Dessiné | 28/05/2025 | GOSSET | Echelle 2:1

Contrôlé

Conf aux norm

Bon pour exéc.

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

Masse | 0.06 kg

ARBRE 2

A

B

Tolérance générale : ISO 2768-mK; Coupe A-A; Vue isométrique Echelle 1:2

Mod. | | Mod. | | | Dessiné | 29/05/2025 | GOSSET | Echelle 1:1

Contrôlé

Conf aux norm

Bon pour exéc.

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

Masse | 0.588 kg

ARBRE 3

A

B

ARBRE 4; Tolérance générale :; ISO 2768-mK; Vue isométrique Echelle 1:1; Coupe A-A

Mod. | | Mod. | | | Dessiné | 29/05/2025 | GOSSET | Echelle 2:1

Contrôlé

Conf aux norm

Bon pour exéc.

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

Dénomination | | | | N° de dessin

A

B

ROUE DENTEE 1; Tolérance Générale :; ISO 2768-mK; Coupe A-A; Vue isométrique Echelle 2:1

Mod. | | Mod. | | | Dessiné | 20.05.2025 | GOSSET | Echelle 2:1

Contrôlé

Conf aux norm

Bon pour exéc.

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

Dénomination | | | | N° de dessin

A

B

ROUE DENTEE 2; Tolérances Générales : ISO 2768-mk; Coupe A-A; Vue isométrique Echelle 1:1

Mod. | | Mod. | | | Dessiné | 30/05/2025 | GOSSET | Echelle 1:1

Contrôlé

Conf aux norm

Bon pour exéc.

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

Dénomination | | | | N° de dessin

A

B

ROUE DENTEE 3; Tolérances Générales : ISO 2768-mK; Vue isométrique Echelle 2:1; Coupe A-A

Mod. | | Mod. | | | Dessiné | 20.05.2025 | GOSSET | Echelle 2:1

Contrôlé

Conf aux norm

Bon pour exéc.

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

Dénomination | | | | N° de dessin

A

B

ROUE DENTEE 4; Tolérance générales : ISO 2768-mK; Vue isométrique Echelle 1:2; Coupe A-A

Mod. | | Mod. | | | Dessiné | 20.05.2025 | GOSSET | Echelle 1:2

Contrôlé

Conf aux norm

Bon pour exéc.

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

Dénomination | | | | N° de dessin

A

B

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

Mod. | | Mod. | | | Dessiné | 20.05.2025 | GOSSET | Echelle 1:2

Contrôlé

Conf aux norm

Bon pour exéc.

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

Dénomination | | | | N° de dessin

A

B

BARRE DE LANCEMENT; Tolérance générale :; ISO 2768-mK; Vue isométrique Echelle 1:1

Mod. | | Mod. | | | Dessiné | 29/05/2025 | GOSSET | Echelle 1:1

Contrôlé

Conf aux norm

Bon pour exéc.

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

Dénomination | | | | N° de dessin

A

B

Réctifié; Tolérance générale :; ISO 2768-fH; Vue isométrique Echelle 1:2

Mod. | | Mod. | | | Dessiné | 29/05/2025 | GOSSET | Echelle 1:2

Contrôlé

Conf aux norm

Bon pour exéc.

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

Masse | 1.612 kg

GLISSIERE

A

B

Réctifié; Tolérance générale :; ISO 2768-fH; Vue isométrique Echelle 1:1

Mod. | | Mod. | | | Dessiné | 29/05/2025 | GOSSET | Echelle 1:1

Contrôlé

Conf aux norm

Bon pour exéc.

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

Masse | 0.089 kg
SUPPORT A BALLES

A

B

TUBE A BALLES; Tolérance générales : ISO 2768-mK; Vue isométrique Echelle 1:2

Mod. | | Mod. | | | Dessiné | 5/21/2025 | GOSSET | Echelle 1:2

Contrôlé

Conf aux norm

Bon pour exéc.

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

Dénomination | | | | N° de dessin

A

B

GOUPILLE; Tolérance générale :; ISO 2768-mK; Vue isométrique Echelle 3:1; Coupe A-A

Mod. | | Mod. | | | Dessiné | 29/05/2025 | GOSSET | Echelle 3:1

Contrôlé

Conf aux norm

Bon pour exéc.

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

Dénomination | | | | N° de dessin

A

B

SUPPORT ANGULAIRE 1; Tolérance générale : ISO 2768-mK; Coupe A-A; Vue isométrique Echelle 1:2

Mod. | | Mod. | | | Dessiné | 29/05/2025 | GOSSET | Echelle 1:2

Contrôlé

Conf aux norm

Bon pour exéc.

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

Dénomination | | | | N° de dessin

A

B

SUPPORT ANGULAIRE 2; Tolérance générales : ISO 2768-mK; Vue isométrique Echelle 1:3

Mod. | | Mod. | | | Dessiné | 28/05/2025 | GOSSET | Echelle 1:2

Contrôlé

Conf aux norm

Bon pour exéc.

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

Dénomination | | | | N° de dessin

A

B

CAPOT ARRIERE; Tolérance générales : ISO 2768-mK

Mod. | | Mod. | | | Dessiné | 29/05/2025 | GOSSET | Echelle 1:2

Contrôlé

Conf aux norm

Bon pour exéc.

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

Dénomination | | | | N° de dessin

A

B

Detail A 5:1; Tolérance générale :; ISO 2768-mK; Vue isométrique Echelle 1:2

Mod. | | Mod. | | | Dessiné | 29/05/2025 | GOSSET | Echelle 1:1

Contrôlé

Conf aux norm

Bon pour exéc.

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

Masse | 0.042 kg
CAPOT AVANT

A

B

PAROI ARRIERE; Tolérance générale : ISO 2768-mK; Vue isométrique Echelle 1:2

Mod. | | Mod. | | | Dessiné | 28/05/2025 | GOSSET | Echelle 1:2

Contrôlé

Conf aux norm

Bon pour exéc.

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

Dénomination | | | | N° de dessin

A

B

PAROI AVANT; Tolérance générale :; ISO 2768-mK; Vue isométrique Echelle 1:2

Mod. | | Mod. | | | Dessiné | 28/05/2025 | GOSSET | Echelle 1:2

Contrôlé

Conf aux norm

Bon pour exéc.

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

Dénomination | | | | N° de dessin

A

B

PAROI DE DROITE; Tolérance générale : ISO 2768-mK; Coupe A-A

Mod. | | Mod. | | | Dessiné | 29/05/2025 | GOSSET | Echelle 1:2

Contrôlé

Conf aux norm

Bon pour exéc.

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

Dénomination | | | | N° de dessin

A

B

PAROI DU MILIEU; Tolérance générale : ISO 2768-mK

Mod. | | Mod. | | | Dessiné | 29/05/2025 | GOSSET | Echelle 1:2

Contrôlé

Conf aux norm

Bon pour exéc.

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

Dénomination | | | | N° de dessin

A

B

PAROI GAUCHE; Tolérance générale : ISO 2768-mK

Mod. | | Mod. | | | Dessiné | 29/05/2025 | GOSSET | Echelle 1:2

Contrôlé

Conf aux norm

Bon pour exéc.

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

Dénomination | | | | N° de dessin

A

B

Coupe A-A; Vue isométrique Echelle 1:3; Tolérance générale : ISO 2768-mK

Mod. | | Mod. | | | Dessiné | 29/05/2025 | GOSSET | Echelle 1:2

Contrôlé

Conf aux norm

Bon pour exéc.

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

Masse | 1.003 kg
SOUBASSEMENT

A

B

CLIQUET; Vue isométrique Echelle 4:1; Tolérance générale : ISO 2768-mK

Mod. | | Mod. | | | Dessiné | 30/05/2025 | GOSSET | Echelle 4:1

Contrôlé

Conf aux norm

Bon pour exéc.

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

Dénomination | | | | N° de dessin

A

B

ASSEMBLAGE FINAL; Manivelle; Vue isométrique Echelle 1:2

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

Mod. | | | Mod. | | Dessiné | 30/05/2025 | POULLAIN | Echelle 1:2

Contrôlé

Conf aux norm

Bon pour exéc.

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

A

B

MANIVELLE; Lien manivelle; Aluminium

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

Mod. | | Mod. | | Dessiné | 30/05/2025 | POULLAIN | Echelle 1:1

Contrôlé

Conf aux norm

Bon pour exéc.

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

A

B

ASSEMBLAGE ARBRE 1; Vue isométrique Echelle 1:1; Coupe B-B; Coupe A-A; Roue dentée 1; HPC / G1 25 20 Acier 17CrNIMo6

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

Mod. | | | Mod. | | Dessiné | 30/05/2025 | POULLAIN | Echelle 1:1

Contrôlé

Conf aux norm

Bon pour exéc.

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

A

B

ASSEMBLAGE ARBRE 2; Coupe A-A; Vue isométrique Echelle 1:1; Roue dentée 2; HPC / G1 25 80 Acier alliée 17CrNIMo6

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

Mod. | | | Mod. | | Dessiné | 30/05/2025 | SAINT-PIERRE | Echelle 1:1

Contrôlé

Conf aux norm

Bon pour exéc.

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

A

B

ASSEMBLAGE ARBRE 3; Coupe A-A; Vue isométrique Echelle 1:2; Roue Dentée 4; HPC / G2_60 Acier allié, 17CrNIMo6

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

Mod. | | | Mod. | | Dessiné | 30/05/2025 | POULLAIN | Echelle 1:1

Contrôlé

Conf aux norm

Bon pour exéc.

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

A

B

ASSEMBLAGE ARBRE 4; Circlip DIN 471; Vue isométrique Echelle 2:1; Coupe A-A

5 26 | 2 1 | D6mm Cliquet | K1938.060701 Acier inox. 1.4122 Usinée Acier, X20 Cr13
30 | 1 | Arbre 4 | Usinée Acier à haute résistance 42CrMo4
Pos. | Quantité | Nom d'identification | Dénomination/matériau

Mod. | | | Mod. | | Dessiné | 30/05/2025 | POULLAIN | Echelle 2:1

Contrôlé

Conf aux norm

Bon pour exéc.

Sans nomenclature séparée | | | | N° de commande
Nomenclature sép de même N° | | | | Origine | | Format A4 | Nb feuilles 1 | Feuille N° 1

Nomenclature sép de N° diff | | | | Remplace

Dénomination | | | N° de dessin

A

B

CAGE RESSORT; Ressort de compression; Corde à piano; Vue isométrique Echelle 1:2; Coupe A-A

33 | 1 | Glissière | Usinée PE-UHMW
34 | 1 | Barre de lancement | Usinée PE-UHMW
35 | 1 | Tube à balles | Usinée PE-UHMW
36 | 1 | Support à balles | Usinée PE-UHMW
37 | 2 | Vis t cy 6pc M4 L30 | SCB4-30 EN 1.4401
38 | 2 | Butée antivibration | 413051 ADIPRENE 97 SH A
Pos. | Quantité | Nom d'identification | Référence/matériau

Mod. | | | Mod. | | Dessiné | 30/05/2025 | POULLAIN | Echelle 1:2

Contrôlé

Conf aux norm

Bon pour exéc.

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

A

B

N° de commande; Contrôlé; Paroi arrière; Usinée; POM-H; Support angulaire 1; Usinée Acier à haute résistance 42CrMo4; Soubassement; Usinée Aluminium EN–AW AlSiMgMn T6; Capot avant

56 | 1 | Paroi de droite | Usinée Aluminium EN–AW AlSiMgMnT6
57 | 1 | Paroi de gauche | Usinée Aluminium EN–AW AlSiMgMn T6
58 | 1 | Paroi du milieu | Usinée Aluminium EN–AW AlSiMgMn T6
59 | 39 | Vis t cy 6pc M2 L10 | UWAP N200 EN AW-6063
60 | 1 | Barre poignée | UWAP N200 EN AW-6063
61 | 2 | Epaule poignée | UWAP N200 POM-H
62 | 2 | Ecrou M8 | PACK-UNUT K8 EN 1.4319
63 | 2 | Vis conique M8 L20 | PACK-SFB8-20 EN 1.4301
Pos. | Quantité | Nom d'identification | Référence/matériau

46 | 1 | Support angulaire 2 | Usinée Acier à haute résistance 42CrMo4
48 | 2 | Rotule à vis M6 L14 | FJRP6 EN 1.4301
49 | 2 | Ventouse | FJRP6 Polyamide
50 | 1 | Ecrou M6 | PACK-UNUTK6 EN 1.4319
52 | 1 | Capot arrière | Usinée POM-H
54 | 1 | Paroi avant | Usinée POM-H

Mod. | | | Mod. | Dessiné | 30/05/2025 | POULLAIN | Echelle 1:3

Conf aux norm

Bon pour exéc.

Sans nomenclature séparée

Nomenclature sép de même N° | Origine | Format A3 | Nb feuilles 1 | Feuille N° 1

ASSEMBLAGE CHASSIS | G
